Anastien/AWG1000/hardware/01-ECAD/02-Documentation/TSW3080EVM-BRD_E2/FAB_DATA/TTM_STACKUP_TSW3080.pdf

### Viasystems Technologies Corp. LLC

8150 Sheppard Ave E
Toronto, ON, M1B 5K2

Job Name : TI - 10 LAYER HYBRID Customer :
Part Num :
Part Rev :
Engineer : Steve Greefhorst

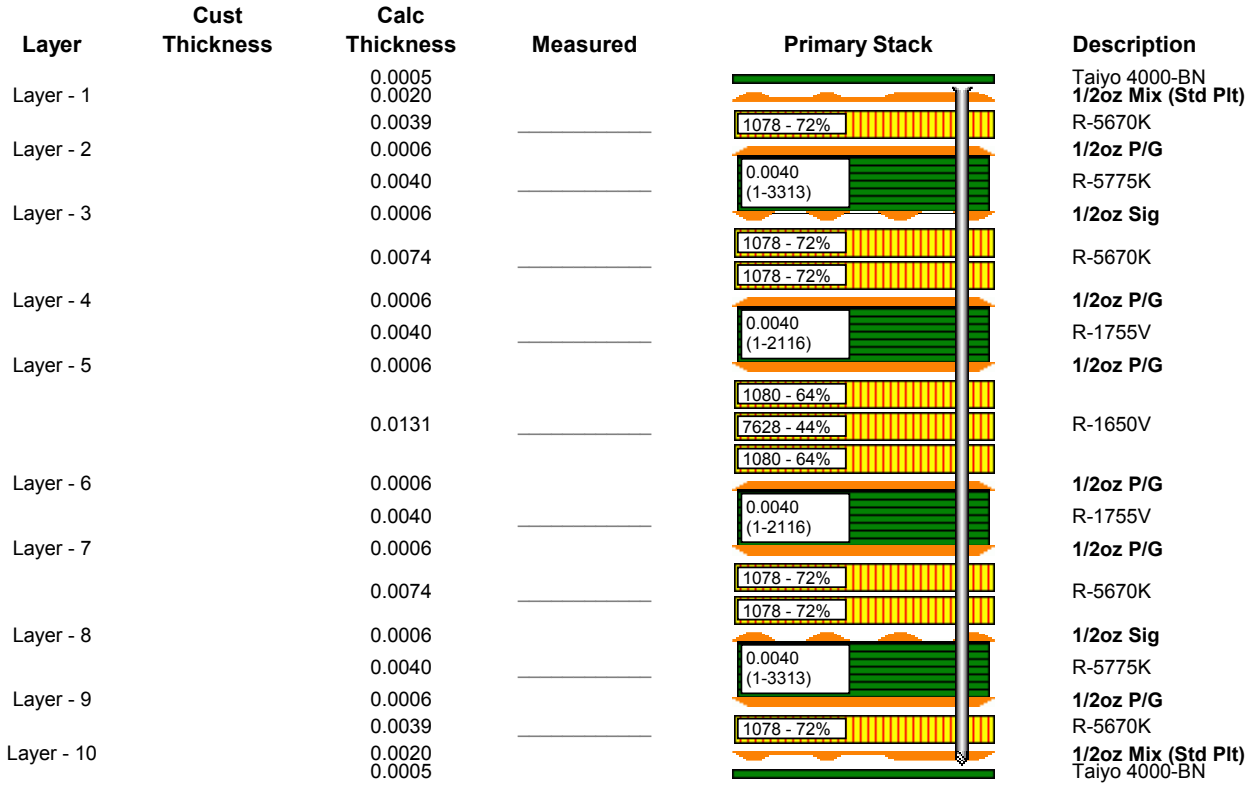
[picture p1: figure]
Layer; Cust Thickness; Calc; Thickness; Measured; Primary Stack; Description; 0.0005 Taiyo 4000-BN; Layer - 1; 1/2oz Mix (Std Plt); Layer - 2; Layer - 3; 1/2oz Sig; Layer - 4; Layer - 5; Layer - 6; Layer - 7; Layer - 8; Layer - 9; Layer - 10

Requirement | Req. Thickness | Tol + | Tol - | Calc Thick | Measured
Incl. Plating & Mask | 0.0620 | 0.0062 | 0.0062 | 0.0615
After Lamination | 0.0582 | 0.0029 | 0.0029 | 0.0577
Impedance Type | Layer | Actual | Plotted | Pitch | Plane | Target | Tol
(ohms) | Predict
1 | Surface MS | L1
- | -0.0045 | -0.00525 | -0.0100 | -
- | 0.0045 0.00425 | 0.00525 0.00475 | -0.0100 | L2
- | 0.00425 0.00425 | 0.00475 0.00475 | -0.0100 | L7
- | 0.00425 0.0070 | 0.00475 0.00775 | -- | L9

0.0070

0.00775

L2 | 50 | 5 | 50.88
2 | EC Microstrip | L1
L2 | 100 | 10 | 101.06
3 | EC Stripline | L3
L4 | 100 | 10 | 101.66
4 | EC Stripline | L8
L9 | 100 | 10 | 101.66
5 | Surface MS | L10

- | 50 | 5 | 50.88
© 2011 Viasystems, All rights reserved. This document is to be used for reference purposes only. | Viastack v3.1.29
Viastack Stackup Report for TI - 10 LAYER HYBRID | 1/25/2016 | Page 1

### Viasystems Technologies Corp. LLC

8150 Sheppard Ave E
Toronto, ON, M1B 5K2
Impedance Type | Layer | Actual | Plotted | Pitch | Plane | Target | Tol
(ohms) | Predict
6 | EC Microstrip | L10
| - | 0.0045
| | 0.0045 | 0.00525
| | | 0.00525 | 0.0100 - | L9 -
100 | 10 | 101.06
© 2011 Viasystems, All rights reserved. This document is to be used for reference purposes only. | Viastack v3.1.29
Viastack Stackup Report for TI - 10 LAYER HYBRID | 1/25/2016 | Page 2
