Anastien/AWG1000/hardware/01-ECAD/02-Documentation/iMX6SLEVK_DESIGNFILES/Schematics/SCH-27452_B.png

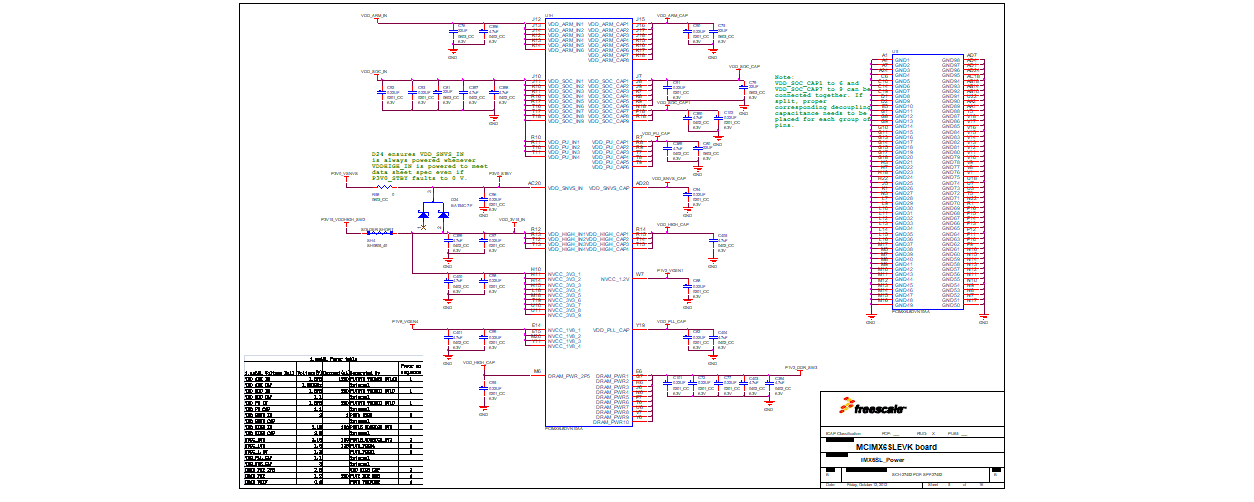
hardware/01-ECAD/02-Documentation/iMX6SLEVK_DESIGNFILES/Schematics/SCH-27452_B.png
