Anastien/AWG1000/hardware/02-MCAD/H524c303f43ab4b6ba670419b455ce2d2E.png

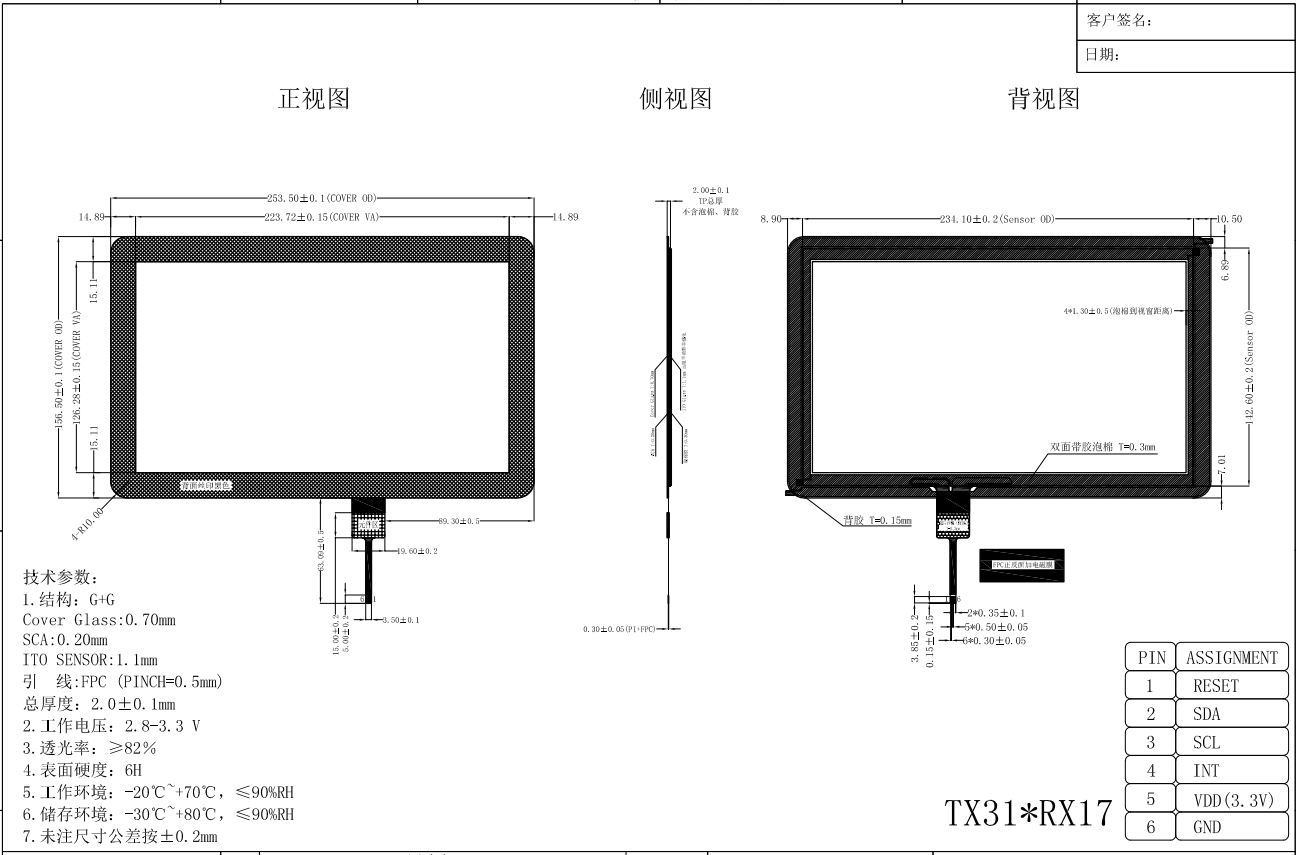
hardware/02-MCAD/H524c303f43ab4b6ba670419b455ce2d2E.png
