Anastien/AWG1000/hardware/02-MCAD/Ua01a15abc3a542eea8cf08465b4b8ba7l.jpg

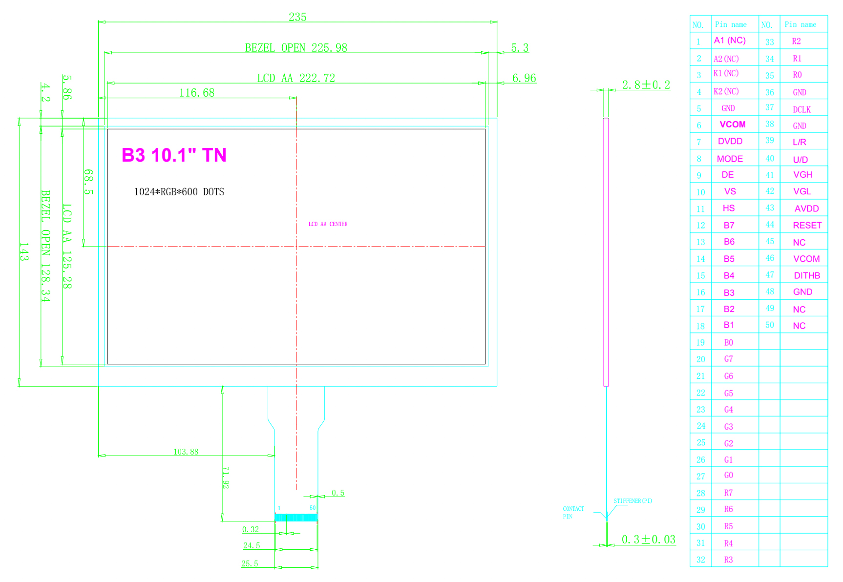
hardware/02-MCAD/Ua01a15abc3a542eea8cf08465b4b8ba7l.jpg
