Anastien/AWG1000/hardware/01-ECAD/02-Documentation/data gen/TSW1406_B_BOM.xls

 |  | TSW1406 RevB BOM |  |  |  | COMPONENTS AND ASSEMBLY SHALL BE RoHS COMPLIANT | DNI = DO NOT INSTALL
Item | Qty | Part Reference | Value | PCB Footprint | Mfr_Name | Mfr_Part_Number | Note
1 | 5 | C1,C10,C18,C48,C49 | 10uF | 0603 | Panasonic | ECJ-1VB0J106M
2 | 22 | C2,C3,C4,C5,C6,C7,C8,C9,C11,C12,C13,C14,C19,C20,C21,C22,C23,C24,C25,C26,C27,C28 | 0.1uF | 0201 | Murata | GRM033R60J104KE19D
3 | 2 | C15,C16 | .22uF | 0201 | TDK | C0603X5R0J224M
4 | 1 | C17 | 2.2uF | 0402 | TDK | C1005X5R0J225M
5 | 2 | C29,C37 | 1uF | 0603 | Panasonic | ECJ-1V41E105M
6 | 2 | C30,C51 | 27pF | 0402 | Yageo | CC0402JRNP09BN270
7 | 2 | C31,C43 | 100uF | 1206 | Kemet | C1206C107M9PACTU
8 | 2 | C32,C47 | .01uF | 0402 | Yageo | CC0402KRX7R9BB103
9 | 2 | C33,C35 | 4.7uF | 0603 | Kemet | C0603C475K8PACTU
10 | 9 | C34,C42,C50,C52,C53,C54,C55,C56,C57 | 0.1uF | 0402 | Yageo | CC0402KRX5R7BB104
11 | 1 | C36 | 10uF | 0805 | Murata | GRM21BR71A106KE51L
12 | 1 | C38 | .1uF | 0402 | Panasonic | ECJ-0EB1C104K
13 | 1 | C39 | 10nF | 0402 | TDK | C1005X7R1E103K
14 | 2 | C40,C44 | 22uF | 1206 | Murata | GRM31CR60J226KE19L
15 | 1 | C41 | 33pF | 0402 | Murata | GRM1555C1H330JZ01D
16 | 0 | C45,C46 | 22pF | 0402 | AVX | 04025A220KAT2A_DNI | DNI
17 | 1 | C58 | 4.7uF | TANT_A | AVX | TAJA475K006RNJ
18 | 2 | C59,C64 | 10uF | 1206 | Murata | GRM31CR61E106KA12L
19 | 1 | C60 | 1uF | 0603 | Murata | GRM188R71E105KA12D
20 | 1 | C61 | 22pF | 0402 | Murata | GRM1555C1H220JZ01D
21 | 1 | C62 | 68uF | 2312 | Kemet | T494C686K016AT
22 | 1 | C63 | 47uF | TANT_B | AVX | TACT476M010XTA | OR EQUIVALENT
23 | 1 | C65 | .1uF | 0402 | Murata | GRM155R71C104KA88D
24 | 2 | D1,D2 | GREEN | diode_0805 | Kingbright Corp | APHCM2012ZGC-F01
25 | 1 | FB1 | 68 ohm @ 100MHz | 0402 | Taiyo Yuden | BKP1005HS680-T
26 | 5 | FB2,FB4,FB6,FB7,FB10 | 68 OHM @ 100MHz | 1206 | Panasonic | EXC-ML32A680U
27 | 2 | FB3,FB5 | 27uF | 1206_BEAD_NFM31P | Murata | NFM31PC276B0J3
28 | 1 | FB9 | 1K @ 100MHZ | 0603 | Taiyo Yuden | BLM21AG102SN1D
29 | 1 | J1 | HMTSW-106-07-G-S-.240 | HDR_THVT_1x6_100_M | SAMTEC | HMTSW-106-07-G-S-.240
30 | 1 | J2 | USB_MINI_AB_MNE20-5G5P10 | CON_SMRT_USBMNE20_F | ACON | MNE20-5G5P10
31 | 0 | J14,J15,J16,J17 | HEADER 2POS | JUMPER2 | Molex | 22-28-4020_DNI | DNI
32 | 1 | J3 | QSH-090-01-L-D-A | CON_SMVT_180POS_QSH_SAMTEC_RT1 | SAMTEC | QSH-090-01-L-D-A
33 | 2 | L1,L2 | 2.2uH | LPS3015 | Coilcraft | LPS3015-222ML
34 | 2 | Q1,Q2 | DTC114EET1G | SOT_416_3_63x31 | ON Semiconductor | DTC114EET1G
36 | 2 | R1,R4 | 10K | 0402 | Panasonic | ERJ-2RKF1002X
37 | 2 | R2,R7 | 10 | 0402 | Yageo | RC0402FR-0710RL
38 | 5 | R3,R23,R25,R28,R29 | 10K | 0402 | Dale | CRCW040210K0FKED
39 | 1 | R5 | 12K | 0402 | Yageo | RC0402FR-0712KL
40 | 1 | R6 | 1K | 0402 | Yageo | RC0402FR-071KL
41 | 4 | R8,R9,R11,R45 | 10K | 0402 | Yageo | RC0402FR-0710KL
42 | 1 | R10 | 2.2K | 0402 | Yageo | RC0402FR-072K2L
43 | 1 | R13 | 10K | 0402 | Rohm Semiconductor | MCR01MZPF1002
44 | 1 | R18 | 820K | 0402 | Panasonic | ERJ-2RKF8203X
45 | 1 | R19 | 191K | 0402 | Vishay/Dale | CRCW0402191KFKED
46 | 1 | R20 | 180K | 0402 | Rohm Semiconductor | MCR01MZPF1803
47 | 1 | R21 | 182K | 0402 | Vishay/Dale | CRCW0402182KFKED
48 | 3 | R22,R26,R27 | 0 | 0201 | Panasonic | ERJ-1GE0R00C
49 | 1 | R24 | 10K | 0201 | Panasonic | ERJ-1GEF1002C
50 | 0 | R30,R31,R32,R33 | 10K | 0402 | Dale | CRCW040210K0FKED_DNI | DNI
51 | 8 | R34,R35,R36,R37,R38,R39,R40,R41 | 0 | 0402 | Panasonic | ERJ-2GE0R00X
52 | 0 | R42 | 0 | 0603 | Panasonic | ERJ-3GEY0R00V_DNI | DNI
53 | 1 | R46 | 4.7K | 0402 | Panasonic | ERJ-2RKF4701X
54 | 8 | R47,R48,R52,R53,R56,R57,R60,R61 | 150 | 0201 | Panasonic | ERJ-1GEF1500C
55 | 4 | R49,R51,R55,R59 | 140 | 0201 | Panasonic | ERJ-1GEF1400C
56 | 0 | R50,R54,R58,R62 | 100 | 0402 | Panasonic | ERJ-2RKF1000X_DNI | DNI
57 | 2 | R63,R64 | 150 | 0402 | Panasonic | ERJ-2RKF1500X
58 | 2 | R65,R66 | 30.1K | 0603 | Panasonic | ERJ-3EKF3012V
59 | 2 | SW1,SW2 | PROGRAMN | SW_RESET_PTS635 | C&K Components | PTS635SL43LFS
60 | 1 | TP1 | Testloop_Black | testpoint_62dia | Keystone | 5011
61 | 1 | TP2 | Testloop_Red | testpoint_62dia | Keystone | 5010
62 | 1 | U1 | LFE3-35E-FN484CES | BGA_484_1mm | Lattice | LFE3-35E-FN484CES | TI Supplied
63 | 0 | U2 | M25P16-VMW6TG | SOIC_8_197x157_50 | Numonyx | M25P80-VMN6TP_DNI | DNI
64 | 1 | U3 | FT2232H | LQFP_64_402x402_20 | FTDI | FT2232H
65 | 1 | U4 | TPS62420 | SON_DRC_10 | Texas Instruments | TPS62420DRCR | TI Supplied
66 | 1 | U5 | TPS76933DBVT | SOT_5_118x67_57 | Texas Instruments | TPS76933DBVT | TI Supplied
67 | 1 | U6 | 93LC46B-I/SN | SOIC-8 | Microchip | 93LC46B-I/SN
68 | 1 | U7 | TPS78601 | TO_263_6_KTT | Texas Instruments | TPS78601KTTT | TI Supplied
69 | 1 | Y1 | 12MHz w/ 10pF | XTAL_4_SM_130x102 | Abracon | ABM8G-12.000MHZ-B4Y-T
70 | 2 | Z_STANDOFF SCREW1,Z_STANDOFF SCREW2 | SCREW MACHINE PHILLIPS 4-40X1/4 |  | B&F Fastener Supply | PMS 440 0025 PH | SCREW FOR STANDOFF
71 | 2 | Z_STANDOFF1,Z_STANDOFF2 | STANDOFF RND 4-40THR .875"L ALUM |  | Keystone Electronics | 1846 | STANDOFF
