Anastien/AWG1000/hardware/01-ECAD/02-Documentation/SABRE-AI_Quad_CPUcard/BOM_27142_D.xls

MCIMX6QAICPU1 Revised: Friday, February 08, 2013
SCH-27142 PDF: SPF-27142 Revision: D
Freescale Semiconductor
6501 William Cannon Drive West
Austin, TX 78735-8598
Bill Of Materials
Item | Quantity | Reference | Part | Supplier | Description | Part# | Tolerance
1 | 1 | C1 | 47uF | TDK | CAP CER 47uF 25V -20/+80% Y5V 2220 | C5750Y5V1E476ZB | -25
2 | 1 | C2 | 220uF | LELON ELECTRONICS CORP | CAP ALEL 220uF 25V 20% -- SMD | VE-221M1ETR-0810 | 20%
3 | 41 | C3,C4,C12,C32,C34,C37,C49,C54,C62,C64,C65,C70,C74,C77,C86,C87,C513,C516,C519,C542,C546,C547,C548,C551,C556,C559,C620,C640,C641,C652,C653,C654,C655,C658,C669,C670,C671,C691,C692,C706,C759 | 22UF | Samsung | CAP CER 22UF 6.3V 20% X5R 0603 | CL10A226MQ8NRNE | 20%
4 | 112 | C5,C6,C20,C28,C51,C52,C53,C56,C72,C73,C76,C88,C111,C503,C505,C511,C514,C520,C538,C566,C579,C580,C581,C591,C592,C593,C594,C601,C603,C604,C605,C606,C608,C609,C611,C612,C613,C614,C615,C616,C617,C619,C621,C623,C626,C627,C628,C629,C630,C631,C633,C634,C635,C637,C638,C639,C642,C643,C644,C646,C647,C648,C649,C650,C651,C656,C657,C659,C661,C662,C663,C664,C665,C666,C667,C668,C672,C673,C674,C675,C676,C677,C678,C679,C681,C682,C683,C684,C685,C686,C687,C688,C689,C690,C695,C697,C698,C699,C700,C701,C702,C703,C704,C705,C707,C708,C709,C718,C721,C740,C744,C746 | 0.22UF | Taiyo Yuden | CAP CER 0.22UF 10V 20% X5R 0201 | LMK063BJ224MP-F | 20%
5 | 3 | C7,C508,C521 | 0.33UF | MULTICOMP | CAP CER 0.33UF 25V 10% X7R 0603 | MCCA001173 | 10%
6 | 6 | C8,C10,C11,C13,C31,C571 | 0.01uF | FENGHUA | CAP CER 0.01UF 25V 10% X7R 0402 | 0402B103K250NT | 10%
7 | 38 | C9,C18,C19,C27,C30,C33,C36,C38,C48,C501,C517,C518,C526,C527,C528,C533,C539,C540,C541,C549,C552,C553,C558,C561,C564,C569,C578,C590,C624,C632,C645,C660,C720,C745,C748,C754,C755,C760 | 4.7uF | TAIYO YUDEN | CAP CER 4.7UF 10V 10% X5R 0603 | LMK107BJ475KA-T | 10%
8 | 56 | C14,C15,C16,C22,C90,C91,C94,C95,C96,C97,C99,C103,C104,C105,C106,C107,C108,C109,C113,C114,C509,C524,C525,C531,C534,C536,C537,C544,C545,C550,C554,C555,C557,C562,C565,C567,C570,C572,C574,C575,C599,C625,C722,C725,C726,C729,C731,C732,C733,C734,C735,C736,C738,C741,C742,C756 | 0.1UF | KEMET | CAP CER 0.1UF 16V 10% X7R 0402 | C0402C104K4RAC | 10%
9 | 6 | C17,C560,C607,C610,C730,C753 | 1000pf | AVX | CAP CER 1000PF 2KV 10% X7R 1210 | 1210GC102KAT1A | 10%
10 | 1 | C21 | 0.47uF | TDK | CAP CER 0.47uF 6.3V 20% X5R 0201 | C0603X5R0J474M030BC | 20%
11 | 24 | C23,C24,C29,C35,C40,C50,C55,C57,C60,C78,C92,C112,C500,C504,C507,C510,C512,C563,C576,C577,C583,C696,C710,C737 | 10uF | TAIYO YUDEN | CAP CER 10UF 10V 20% X5R 0603 | LMK107BJ106MALTD
12 | 8 | C25,C535,C568,C573,C582,C719,C727,C743 | 1.0UF | YAGEO AMERICA | CAP CER 1.0UF 10V 10% X5R 0402 | CC0402KRX5R6BB105
13 | 1 | C26 | 47uF | TAIYO YUDEN | CAP CER 47uF 10V 20% X5R 1206 | LMK316BJ476ML-T | 20%
14 | 44 | C39,C41,C42,C43,C44,C45,C46,C47,C59,C61,C63,C66,C67,C68,C69,C71,C75,C79,C80,C81,C82,C83,C84,C85,C584,C585,C586,C587,C588,C589,C595,C602,C618,C622,C636,C693,C694,C711,C712,C713,C714,C715,C716,C717 | 0.22UF | TAIYO YUDEN | CAP CER 0.22UF 16V 10% X5R 0402 | EMK105BJ224KV-F | 10%
15 | 1 | C58 | 2.2UF | SMEC | CAP CER 2.2UF 10V 5% X7R 0603 | MCCB225J1NRTF | 5%
16 | 4 | C89,C93,C98,C100 | 1.0 UF | AVX | CAP CER 1.0UF 16V 10% X7R 0603 | 0603YC105KAT2A | 10%
17 | 3 | C101,C102,C739 | 470PF | MURATA | CAP CER 470PF 50V 10% X7R 0402 | GRM155R71H471KA01D | 10%
18 | 1 | C502 | 1uF | CAPAX TECHNOLOGIES INC. | CAP CER 1UF 25V 10% X7R 0603 | 0603X105K250SNT | 10%
19 | 3 | C515,C522,C523 | 10UF | MURATA | CAP CER 10UF 25V 10% B 1206 | GRM31CB31E106KA75B | 10%
20 | 4 | C529,C532,C596,C597 | 18pF | Yageo | CAP CER 18pF 25V 5% C0G 0402 | CC0402JRNPO8BN180 | 5%
21 | 2 | C530,C543 | 680pF | TAIYO YUDEN | CAP CER 680PF 50V 10% X5R 0402 | UMK105BJ681KV-F | 10%
22 | 2 | C598,C600 | 16PF | AVX | CAP CER 16PF 50V 5% C0G 0603 | 06035A160JAT2A | 5%
23 | 1 | C680 | 27pF | Yageo | CAP CER 27PF 25V 5% C0G 0402 | CC0402JRNPO8BN270 | 5%
24 | 2 | C723,C724 | 22PF | AVX | CAP CER 22PF 50V 5% C0G 0402 | 04025A220JAT2A | 5%
25 | 1 | C728 | 10UF | TDK | CAP CER 10UF 6.3V 10% X5R 0603 | C1608X5R0J106KT | 10%
26 | 3 | C747,C757,C758 | 22uF | TDK | CAP CER 22uF 16V 20% X7R 1210 | C3225X7R1C226M | 20%
27 | 5 | D1,D500,D502,D503,D504 | RB521CS-30 | ROHM | DIODE SCH SS 100MA 30V VMN2 | RB521CS-30T2R
28 | 4 | D2,D3,D10,D12 | MBRA340T3G | ON SEMICONDUCTOR | DIODE SCH PWR RECT 3A 40V SMA | MBRA340T3G
29 | 4 | D4,D7,D13,D14 | LED_GREEN | LITE ON | LED ULTRA-BRIGHT GREEN SMT 0603 | LTST-C190KGKT
30 | 1 | D5 | LED_YELLOW | LITE ON | LED ULTRA-BRIGHT YELLOW 30MA 5V SMT 0603 | LTST-C190KSKT
31 | 1 | D6 | RED | LITE ON | LED ULTRA BRIGHT RED SGL 30MA 0603 | LTST-C190KRKT
32 | 1 | D8 | MMSZ5231BT1G | ON SEMICONDUCTOR | DIODE ZNR 5.1V 0.5W SOD123 | MMSZ5231BT1G
33 | 1 | D9 | BLUE | LITE ON | LED BLUE -- 20MA SMT | LTST-C190TBKT
34 | 5 | D11,D18,D19,D20,D501 | MBR140SFT | ON SEMICONDUCTOR | DIODE SCH PWR RECT 1A 40V SOD123 | MBR140SFT1G
35 | 1 | D15 | 1SMB24AT3G | ON SEMICONDUCTOR | DIODE TVS ZNR -- 600W 24V SMD | 1SMB24AT3G
36 | 1 | D16 | BAT54HT1 | ON SEMICONDUCTOR | DIODE SCH 30V 200MA -- SOD323 | BAT54HT1G
37 | 1 | D17 | NSR0320 | ON Semiconductor | DIODE SCH PWR RECT LOW VF 1A 20V SOD323 | NSR0320MW2T1G
38 | 1 | D21 | LED_ORANGE | KINGBRIGHT | LED SUPER BRIGHT ORANGE SMD 0603 | AP1608SEC
39 | 1 | J1 | HDR 1X2 | FRAMATOME CONNECTORS INTERNATIONAL | HDR 1X2 TH 100MIL SP 330H SN 120L | 69190-402HLF
40 | 1 | J2 | HDR_2X3 | Samtec | HDR 2X3 TH 100MIL CTR 330H SN 115L | TSW-103-23-T-D
41 | 3 | J3,J4,J5 | HDR_1X3 | SAMTEC | HDR 1X3 TH 2MM SP 295H AU 102L | MTMM-103-06-G-S-236
42 | 1 | J6 | CON 7 SATA | 3M | CON 1X7 PLUG SATA TH 50MIL SP 335H -- 96L | 5607-5102-SH
43 | 1 | J7 | QSH-030-01-L-D-A-K-TR | SAMTEC | CON 2X30 SKT SMT 0.5MM SP 120H AU MOUNTING HOLES TO MATE CABLE HQCD-030-15.00-TBL-TBR-1-SDB | QSH-030-01-L-D-A_
44 | 1 | J8 | CONN PWR 1 | CUI STACK | CON 1 PWR PLUG DIAM 2.0MM RA TH HIGH CURRENT-- 430H NI 140L | PJ-202AH
45 | 1 | J9 | HDMI TYPE A 19 | Molex | CON 19 HDMI SKT SMT 0.5MM SP 343H AU | 47659-1000
46 | 1 | J10 | USB AB 5 | Hirose | CON 5 USB MICRO-AB RA SKT SMT 0.65MM SP AU | ZX62D-AB-5P8
47 | 1 | J11 | USB_TYPE_A_FEMALE | SAMTEC | CON 4 SKT RA TH USB A FEMALE | USB-A-S-S-B-TH
48 | 1 | J12 | QSH-020-01-L-D-DP-A | SAMTEC | CON 2X20 SKT SMT 0.5MM SP 131H AU | QSH-020-01-L-D-DP-A
49 | 1 | J13 | CON 30 | HIROSE | CON 30 SHRD SKT RA SMT 1MM SP AU | DF19G-30P-1H(56)
50 | 1 | J14 | CONN CRD 19 | PROCONN TECHNOLOGY CO., LTD | CON 19 CRD SKT SMT -- 150H AU | SDC013-A0-501F
51 | 1 | J15 | V890-1AX1-A1 | BEL FUSE | CON 10 RJ-45 SHLD TH G/Y LEDS 50MIL SP 662H AU 125L | V890-1AX1-A1
52 | 1 | J16 | CON_1X40 | OMRON | CON 40 FPC SMT RA 0.5MM SP 122H AU | XF2M-4015-1A
53 | 1 | J17 | 20021121-00010C4LF | FCI | CON 2X5 UNSTROUDED SMT 50MIL SP 227H AU | 20021121-00010C4LF
54 | 1 | J18 | DB9 | TYCO ELECTRONICS | CON 9 DB -- SKT TH 54MIL SP 479H AU | 5207826-4
55 | 1 | J19 | CON 2X26 MINI PCI EXPRESS | Molex | CON 2X26 MINI PCI EXPRESS SMT 0.8MM SP 1136H | 679100002
56 | 2 | L1,L2 | 1uH | BOURNS | IND PWR 1UH@100KHZ 5A 20% SMD | SRP4020-1R0M
57 | 4 | L3,L5,L6,L7 | 1uH | Coilcraft | IND PWR 1UH@100KHZ 2.65A 20% SMT | LPS5015-102MLC | 20%
58 | 1 | L4 | 1UH | TDK | IND PWR 1UH@1MHZ 2A 30% SMT | VLS252010T-1R0N | 30%
59 | 1 | L8 | 2.2uH | COILCRAFT | IND PWR 2.2uH@100KHz 2.7A 20% SMT | LPS4018-222MLC | 20%
60 | 6 | L9,L10,L500,L501,L505,L506 | 120OHM | MURATA | IND FER BEAD 120OHM@100MHZ 2A 25% 0603 | BLM18PG121SH1 | 25%
61 | 1 | L502 | 330OHM | MURATA | IND FER BEAD 330 OHM@100MHZ 1.5A 25% 0805 | BLM21PG331SN1D | 25%
62 | 1 | L503 | 600 Ohm | Murata | IND FER BEAD 600 OHM@100MHZ 0.3A 25% 0402 | BLM15HG601SN1D | 25%
63 | 1 | L504 | 4.7UH | TDK | IND PWR 4.7UH@1MHZ 1A 20% SMD | VLS3012T-4R7M1R0 | 20%
64 | 1 | P1 | EDGE 281 | NA | CON 281 EDGE 0.5MM SP 5H AU - NO PARTS TO ORDER | NO PARTS TO ORDER
65 | 1 | Q1 | MBT3906DW1T1 | ON SEMICONDUCTOR | TRAN PNP GEN DUAL 200MA 40V SOT363 | MBT3906DW1T1G
66 | 5 | Q2,Q501,Q503,Q504,Q508 | NTS4001NT1G | ON SEMICONDUCTOR | TRAN NMOS SW 30V 270MA SC-70 | NTS4001NT1G
67 | 2 | Q502,Q505 | FDMS6681Z | FAIRCHILD | TRAN PMOS PWR 49A 30V POWER56 | FDMS6681Z
68 | 1 | Q506 | FDC642P | FAIRCHILD | TRAN PMOS 20V 4A SSOT-6 | FDC642P
69 | 1 | Q507 | FDG6301N | FAIRCHILD | TRAN NFET DMOS DUAL 0.22A 25V SC70-6 | FDG6301N
70 | 4 | RN500,RN501,RN502,RN503 | 10K | ROHM | RNET BUS 8 10K 1/32W 5% SMT | MNR15E0RPJ103 | 5%
71 | 1 | R1 | 59K | KOA SPEER | RES MF 59K 1/16W 1% 0402 | RK73H1ETTP5902F | 1%
72 | 38 | R2,R15,R30,R69,R75,R76,R77,R79,R80,R82,R85,R86,R88,R90,R559,R560,R561,R570,R577,R578,R580,R602,R651,R656,R678,R705,R710,R714,R716,R717,R718,R720,R722,R723,R726,R757,R763,R797 | 68K | KOA SPEER | RES MF 68K 1/16W 1% 0402 | RK73H1ETTP6802F | 1%
73 | 162 | R3,R4,R5,R10,R11,R17,R18,R20,R22,R25,R29,R32,R33,R35,R36,R38,R39,R40,R41,R43,R48,R49,R50,R51,R63,R64,R67,R70,R72,R73,R81,R84,R98,R101,R102,R105,R106,R500,R501,R504,R506,R510,R511,R512,R513,R514,R515,R520,R521,R522,R523,R524,R525,R526,R527,R528,R529,R539,R540,R541,R542,R543,R544,R545,R546,R550,R574,R575,R576,R581,R582,R583,R584,R585,R587,R588,R589,R590,R591,R592,R593,R595,R598,R599,R600,R603,R604,R605,R606,R607,R610,R613,R614,R617,R621,R626,R627,R628,R631,R633,R635,R636,R637,R639,R640,R643,R644,R645,R647,R648,R649,R650,R653,R654,R657,R658,R659,R660,R664,R668,R672,R674,R676,R680,R684,R688,R689,R693,R696,R698,R700,R703,R704,R709,R711,R713,R715,R724,R727,R728,R729,R730,R731,R738,R740,R749,R750,R753,R754,R755,R758,R760,R765,R772,R773,R775,R776,R777,R780,R785,R794,R795 | 0 | Panasonic | RES MF ZERO OHM 1/10W -- 0402 | ERJ-2GE0R00X
74 | 51 | R6,R31,R83,R87,R92,R93,R94,R95,R96,R97,R502,R509,R516,R519,R534,R551,R554,R558,R615,R616,R619,R625,R642,R655,R675,R677,R681,R695,R701,R702,R708,R712,R719,R721,R733,R739,R741,R742,R743,R744,R745,R746,R747,R748,R752,R762,R766,R767,R770,R779,R791 | 10.0K | VISHAY INTERTECHNOLOGY | RES MF 10.0K 1/16W 1% 0402 | CRCW040210K0FKED | 1%
75 | 5 | R7,R8,R13,R26,R566 | 100K | KOA SPEER | RES MF 100K 1/16W 1% 0402 | RK73H1ETTP1003F | 1%
76 | 3 | R9,R34,R91 | 1.6K | KOA SPEER | RES MF 1.6K 1/16W 1% 0402 | RK73H1ETTP1601F | 1%
77 | 2 | R12,R556 | 324K | KOA SPEER | RES MF 324K 1/16W 1% 0402 | RK73H1ETTP3243F | 1%
78 | 48 | R14,R19,R23,R24,R42,R52,R53,R54,R55,R57,R58,R60,R61,R62,R65,R66,R68,R71,R74,R78,R572,R638,R652,R661,R662,R663,R666,R667,R669,R670,R673,R679,R682,R683,R685,R686,R687,R690,R691,R692,R694,R699,R707,R725,R736,R737,R769,R774 | 4.7K | KOA SPEER | RES MF 4.70K 1/16W 1% 0402 | RK73H1ETTP4701F | 1%
79 | 3 | R16,R537,R538 | 15K | KOA SPEER | RES MF 15K 1/16W 1% 0402 | RK73H1ETTP1502F | 1%
80 | 14 | R21,R507,R573,R579,R597,R629,R630,R632,R634,R641,R646,R732,R768,R778 | 100 | THYE MING TECH CO LTD | RES MF 100 OHM 1/16W 1% 0402 | CR-02FL6--100R | 1%
81 | 2 | R27,R28 | 0 | KOA SPEER | RES MF ZERO OHM 1/32W -- 0201 | RK73Z1HTTC | 5%
82 | 3 | R37,R56,R618 | 200 | THYE MING TECH CO LTD | RES MF 200 OHM 1/16W 1% 0402 | CR02FL6--200R | 1%
83 | 5 | R44,R45,R46,R59,R609 | 240 | KOA SPEER | RES MF 240 OHM 1/16W 1% 0402 | RK73H1ETTP2400F | 1%
84 | 1 | R47 | 191 | KOA SPEER | RES MF 191.0 OHM 1/10W 1% 0603 | RK73H1JTTD1910F | 1%
85 | 1 | R89 | 2.37K | KOA SPEER | RES MF 2.37K 1/16W 1% 0402 | RK73H1ETTP2371F | 1%
86 | 5 | R99,R100,R697,R734,R735 | 33 | THYE MING TECH CO LTD | RES MF 33.0 OHM 1/16W 1% 0402 | CR-02FL6---33R | 1%
87 | 2 | R104,R503 | 150K | SMEC | RES MF 150K 1/16W 5% 0402 | RC73L2Z154JTF | 5%
88 | 1 | R505 | 91K | KOA SPEER | RES MF 91K 1/16W 1% 0402 | RK73H1ETTP9102F | 1%
89 | 9 | R508,R535,R586,R594,R596,R665,R706,R771,R796 | 47K | VENKEL COMPANY | RES MF 47K 1/16W 5% 0402 | CR0402-16W-473JT | 5%
90 | 2 | R517,R549 | 120 | KOA SPEER | RES MF 120 OHM 1/10W 5% 0603 | RK73B1JTTD121J | 5%
91 | 1 | R530 | 15.4K | KOA SPEER | RES MF 15.4K 1/16W 1% 0402 | RK73H1ETTP1542F | 1%
92 | 6 | R531,R552,R567,R568,R612,R793 | 820 | PANASONIC | RES MF 820 OHM 1/10W 5% 0402 | ERJ2GEJ821X | 5%
93 | 1 | R533 | 28K | KOA SPEER | RES MF 28K 1/16W 1% 0402 | RK73H1ETTP2802F | 1%
94 | 4 | R536,R547,R751,R759 | 270 | VISHAY INTERTECHNOLOGY | RES MF 270 OHM 1/16W 5% 0402 | CRCW0402270RJNED | 5%
95 | 1 | R548 | 470K | KOA SPEER | RES MF 470K 1/16W 1% 0402 | RK73H1ETTP4703F | 1%
96 | 1 | R553 | 2.7K | ROHM | RES MF 2.7K 1/4W 5% 0805 | ESR10EZPJ272 | 5%
97 | 3 | R555,R557,R790 | 510 | BOURNS | RES MF 510 OHM 1/10W 5% 0603 | CR0603-JW-511ELF | 5%
98 | 2 | R562,R564 | 39.2K | KOA SPEER | RES MF 39.2K 1/16W 1% 0402 | RK73H1ETTP3922F | 1%
99 | 2 | R563,R569 | 42.2K | KOA SPEER | RES MF 42.2K 1/16W 1% 0402 | RK73H1ETTP4222F | 1%
100 | 1 | R571 | 27K | VISHAY INTERTECHNOLOGY | RES MF 27K 1/16W 5% 0402 | CRCW040227K0JNED | 5%
101 | 1 | R601 | 82.5K | KOA SPEER | RES MF 82.5K 1/16W 1% 0402 | RK73H1ETTP8252F | 1%
102 | 1 | R608 | 0 | MULTICOMP | RES MF ZERO OHM 1/10W 1% 0603 | MC0603SAF0000T5E | 1%
103 | 2 | R611,R620 | 6.04K | KOA SPEER | RES MF 6.04K 1/16W 1% 0402 | RK73H1ETTP6041F | 1%
104 | 1 | R622 | 10M | KOA SPEER | RES MF 10M 1/16W 1% 0402 | RK73H1ETTP1005F | 1%
105 | 2 | R761,R764 | 49.9 | KOA SPEER | RES MF 49.9 OHM 1/16W 1% 0402 | RK73H1ETTP49R9F | 1%
106 | 4 | R781,R782,R783,R784 | 130 | KOA SPEER | RES MF 130 OHM 1/10W 1% 0603 | RK73H1JTTD1300F | 1%
107 | 1 | R788 | 2.2M | KOA SPEER | RES MF 2.2M 1/16W 1% 0402 | RK73H1ETTP2204F | 1%
108 | 3 | SH2,SH11,SH506 | 0 | LAYOUT ELEMENT ONLY | ZERO OHM CUT TRACE 0603 PADS; NO PART TO ORDER | LAYOUT ELEMENT ONLY
109 | 2 | SH3,SH507 | 0 | LAYOUT ELEMENT ONLY | ZERO OHM CUT TRACE 0402 PADS; NO PART TO ORDER | LAYOUT ELEMENT ONLY
110 | 10 | SH4,SH9,SH10,SH500,SH501,SH502,SH503,SH504,SH505,SH510 | SOLDER SHORT | NOTACOMPONENT | SOLDER SHORT 0805 SMT NO PART TO ORDER | SOLDER_SHORT_0805
111 | 6 | SH5,SH6,SH7,SH8,SH508,SH509 | 0 | LAYOUT ELEMENT ONLY | ZERO OHM CUT TRACE 0201 PADS; NO PART TO ORDER | LAYOUT ELEMENT ONLY
112 | 2 | SW1,SW2 | SKRPABE010 | ALPS ELECTRIC (USA) INC. | SW SPST PB SMT 16V 20MA | SKRPABE010
113 | 1 | S1 | SW_DIP-10/SM | CTS | SW SPST DIP 10POS 100MA 50V SMT | 218-10LPST
114 | 2 | S2,S3 | SW DIP-4 | TYCO ELECTRONICS | SW SPST DIP 4P 0.050" SP SMT | 1571983-4
115 | 2 | TP_GND1,TP_GND2 | TESTLOOP_BLACK | KEYSTONE ELECTRONICS | TEST POINT PC MULTI PURPOSE BLK TH | 5011
116 | 39 | TP1,TP3,TP4,TP5,TP6,TP7,TP8,TP9,TP10,TP11,TP12,TP13,TP14,TP15,TP16,TP17,TP18,TP19,TP20,TP21,TP22,TP23,TP24,TP25,TP26,TP27,TP28,TP29,TP30,TP31,TP32,TP33,TP34,TP35,TP36,T76,TP500,TP501,TP502 | TPAD_020 |  | TEST POINT PAD 0.5MM DIA SMT, NO PART TO ORDER
117 | 2 | TP37,TP38 | TEST POINT | NA | TEST POINT PAD 35 MIL SMT, NO PART TO ORDER | NA
118 | 1 | TVS500 | ESD9B5.0ST5G | On semiconductor | DIODE TVS LOW CAP 5.0V SOD-923 | ESD9B5.0ST5G
119 | 75 | T1,T2,T3,T4,T5,T6,T7,T8,T9,T10,T11,T12,T13,T14,T15,T16,T17,T18,T19,T20,T21,T22,T23,T24,T25,T26,T27,T28,T29,T30,T31,T32,T33,T34,T35,T36,T37,T38,T39,T40,T41,T42,T43,T44,T45,T46,T47,T48,T49,T50,T51,T52,T53,T54,T55,T56,T57,T58,T59,T60,T61,T62,T63,T64,T65,T66,T67,T68,T69,T70,T71,T72,T73,T74,T75 | TPAD_015 | NOTACOMPONENT | TEST POINT PAD 15MIL DIA SMT, NO PART TO ORDER | NOTACOMPONENT
120 | 1 | U1 | MCIMX6Q6AVT10AC | FREESCALE SEMICONDUCTOR | IC MCU MX6QUAD ARM CORTEX-A9 FCPBGA624 | MCIMX6Q6AVT10AC
121 | 4 | U2,U3,U4,U5 | MT41K256M16HA-125:E | MICRON | IC MEM DDR3 SDRAM 32M x 16BIT x 8 BANKS 1.25NS 1.35/1.5V FBGA96 | MT41K256M16HA-125:E
122 | 1 | U6 | NL17SZ125 | ON SEMICONDUCTOR | IC BUF TS 1.65-5.5V SOT353-5 | NL17SZ125DFT2G
123 | 1 | U7 | S9S08SG8E2MSC | Freescale Semiconductor | IC MCU 8BIT 8K FLASH 2.7-5.5V SOIC8 | S9S08SG8E2MSC
124 | 2 | U8,U9 | LT3680H | Linear Technology | IC VREG STEP DOWN SW 2.4MHZ ADJ 0.79-30V 3.5A 3.6-36V MSOP10 | LT3680HMSE#PBF
125 | 4 | U10,U17,U502,U509 | NLAS3158 | ON Semiconductor | IC LIN SW DUAL SPDT 1.65-5.5V DFN12 | NLAS3158MNR2G
126 | 1 | U11 | MMPF0100F0ZES | FREESCALE SEMICONDUCTOR | IC POWER MANAGEMENT AUTOMOTIVE 2.8-4.5V QFN56 | MMPF0100F0ZES
127 | 1 | U12 | PI90LV179 | PERICOM SEMICONDUCTOR | IC XCVR LVDS 3.3V SOIC8 | PI90LV179WE
128 | 3 | U13,U14,U15 | MAX7310 | MAXIM | IC I/O EXPANDER 8BIT I2C 2.3-5.5V TSSOP16 | MAX7310AUE+
129 | 1 | U16 | M25P32-VMW3TGB | NUMONYX | IC MEM SERIAL FLASH 32MBIT AUTOMOTIVE GRADE 2.7-3.6V SO8W | M25P32-VMW3TGB
130 | 1 | U18 | SP3232 | SIPEX | IC XCVR RS232 120KBPS 3.0-5.5V SSOP16 | SP3232ECA-L
131 | 1 | U19 | 980020-48-P2 | MERITEC | CON 48 TSOP SKT SMT 0.5MM SP AU | 980020-48-P2
132 | 4 | U20,U21,U22,U501 | NC7SP125P5X | FAIRCHILD | IC BUF TS 0.9-3.6V | NC7SP125P5X
133 | 1 | U500 | LT3012HFE | Linear Technology | IC VREG LDO LIN MICROPWR ADJ 1.24-60V 250mA 4-80V TSSOP16 | LT3012HFE#PBF
134 | 1 | U504 | CM2020 | ON SEMICONDUCTOR | IC XMTR HDMI ESD PROTECTION 5V TSSOP38 | CM2020-01TR
135 | 1 | U505 | LTC3025 | LINEAR TECHNOLOGY | IC VREG LOW LDO 300MA LOW VREF | LTC3025EDC#TRPBF
136 | 1 | U506 | MIC2005-0.5YM6 | MICREL | IC LIN SW PWR 0.5A 2.5-5.5V SOT23-6 | MIC2005-0.5YM6
137 | 1 | U507 | SRV05-4 | SEMTECH CORP | DIODE TVS ARRAY 12A 5V 300W SOT23_S6 | SRV05-4.TCT
138 | 1 | U508 | ADG849 | Analog Devices | IC SWITCH SPDT 2:1 MUX 1.8-5.5V SC70-6 | ADG849YKSZ-500RL7
139 | 1 | U510 | M29W256GL7AN6E | NUMONYX | IC MEM FLASH AUTOMOTIVE GRADE 256MBIT 70NS 2.7-3.6V TSOP56 | M29W256GL7AN6E
140 | 1 | U511 | AR8031 | Atheros Communications, Inc | IC XCVR ETHERNET PHY 10/100/1000G-BIT 3.3V QFN48 | AR8031-AL1A
141 | 1 | U512 | 74LCX125 | ON SEMICONDUCTOR | IC BUF 4 TS 2.3-3.6V TSSOP14 | MC74LCX125DTG
142 | 1 | U513 | STM6315RA | ST MICROELECTRONICS | IC MPU RESET CIRC 2.63V 1.5MS 1.0-5.5V SOT143-4 | STM6315RAW13F
143 | 1 | U515 | STM6315RDW13F | ST MICROELECTRONICS | IC MPU RESET CIRC 2.63V 1.0-5.5V SOT143-4 | STM6315RDW13F
144 | 2 | U516,U1514 | NC7SP126 | FAIRCHILD | IC BUF ULP TS 0.9-3.6V SC-70 | NC7SP126P5X
145 | 1 | Y1 | 24.576MHZ | Fox Electronics | OSC 24.576MHZ FIXED 3.3V SMT | FXO-HC536R-24.576
146 | 1 | Y2 | 32.768kHz | Micro Crystal | XTAL 32.768KHZ 12.5pF -- SMT | CM7V-T1A, 32.768KHz, 12.5pF, 20ppm, TA, QC
147 | 1 | Y3 | 24MHZ | EPSON TOYOCOM CORPORATION | XTAL 24MHZ 9pF -- SMT 3.2X2.5MM | TSX-3225 24.0000MF15X-AC3
148 | 1 | Y4 | 100MHZ | PERICOM SEMICONDUCTOR | OSC 100MHZ FIXED HCSL PCIE2 3.3V SMT | SHPCIE100
149 | 1 | Y500 | 25MHZ | ABRACON CORP | XTAL 25MHZ -- -- SMT | ABMM-25.000MHZ-B2-T
