Anastien/AWG1000/hardware/01-ECAD/02-Documentation/TSW14J56EVM-DesignPkg_E/TSW14J56-BOM_E1.xlsx

TSW14J56 BOM Revision: E1
Item | Quantity | Reference | Note | Part | Part Number | Manufacturer | Foot Print
1 | 2 | CN1,CN2 |  | 0.1uF | W2A4ZC104MAT2A | AVX | cnet4_0508
2 | 6 | C1,C5,C482,C483,C488,C499 |  | 0.1uF | GRM155R61C104KA88D | Murata | 402
3 | 1 | C4 |  | .01uF | GRM155R71E103KA01D | MURATA | 402
4 | 20 | C10,C11,C12,C13,C14,C15,C16,C17,C18,C19,C20,C21,C22,C23,C24,C25,C26,C372,C373,C374 |  | 2.2nF | GRM033R71A222KA01D | Murata | 201
5 | 4 | C27,C28,C369,C371 |  | 3.3nF | GRM033R71A332KA01D | Murata | 201
6 | 4 | C29,C30,C31,C370 |  | 4.7nF | GRM033R71A472KA01D | Murata | 201
7 | 8 | C32,C33,C34,C35,C36,C37,C38,C39 |  | 0.01uF | GRM033R71A103KA01J | Murata | 201
8 | 21 | C41,C42,C43,C44,C45,C46,C47,C48,C203,C204,C205,C206,C438,C440,C442,C443,C451,C453,C455,C458,C459 |  | 0.1uF | GRM033R61A104KE15D | Murata | 201
9 | 8 | C50,C51,C52,C53,C54,C55,C56,C57 |  | 0.47uF | CL03A474KQ3NNNC | Samsung Electro-Mechanics America, Inc | 201
10 | 1 | C58 |  | 10uF | GRM31CR61E106KA12L | MURATA | 1206
11 | 2 | C59,C66 |  | 100pF | 04025C101KAT2A | AVX CORP | 402
12 | 20 | C60,C61,C228,C230,C231,C234,C376,C391,C410,C411,C414,C415,C416,C417,C478,C479,C496,C497,C500,C501 |  | 0.1uF | GRM155R71C104KA88D | MURATA | 402
13 | 1 | C65 |  | .1uF | GRM155R61A104KA01D | MURATA | 402
14 | 1 | C69 |  | 2200pF | ECJ-0EB1E222K | Panasonic | 402
15 | 1 | C70 |  | 10pF | GRM1555C1H100JZ01D | MURATA | 402
16 | 0 | C73 | DNI | CAP_0402_10pF |  | Murata | 402
17 | 8 | C74,C75,C76,C77,C78,C79,C430,C431 |  | .1uF | GRM033R61A104KE15D | MURATA | 201
18 | 13 | C82,C83,C84,C85,C86,C87,C88,C112,C140,C165,C166,C361,C362 |  | 100uF | TCJB107M006R0045 | AVX Corp | 3528
19 | 48 | C94,C95,C96,C97,C98,C99,C100,C101,C102,C103,C104,C105,C106,C107,C108,C109,C110,C111,C113,C116,C117,C118,C119,C120,C121,C122,C123,C124,C125,C126,C127,C128,C129,C130,C131,C132,C137,C159,C167,C168,C177,C178,C189,C353,C356,C357,C365,C402 |  | 4.7uF | C1005X5R0J475K050BC | TDK | 402
20 | 15 | C114,C138,C157,C171,C172,C173,C179,C182,C183,C184,C185,C358,C359,C367,C404 |  | 0.1uF | C1005X7R1E104K050BB | TDK | 402
21 | 2 | C115,C139 |  | 22nF | GRM155R71E223KA61D | Murata | 402
22 | 3 | C158,C176,C188 |  | 220uF | T520B227M006ATE070 | Kemet | 3528
23 | 3 | C160,C180,C199 |  | 0.22uF | 160X14X224MV4T | Johanson Dielectrics Inc | C-0603_X2Y
24 | 3 | C161,C181,C200 |  | 0.1uF | 100X14W104MV4T | Johanson Dielectrics Inc | C-0603_X2Y
25 | 3 | C162,C300,C303 |  | 47nF | 160X14W473MV4T | Johanson Dielectrics Inc | C-0603_X2Y
26 | 3 | C163,C286,C301 |  | 22nF | 250X14W223MV4T | Johanson Dielectrics Inc | C-0603_X2Y
27 | 3 | C164,C287,C302 |  | 1uF | 100X14X105MV4T | Johanson Dielectrics Inc | C-0603_X2Y
28 | 5 | C169,C170,C363,C364,C366 |  | 0.22uF | CL05B224KP5NNNC | Samsung | 402
29 | 2 | C174,C175 |  | 22nF | CL05B223KP5NNNC | Samsung | 402
30 | 2 | C195,C351 |  | 47uF | C1210C476M4PACTU | Kemet | 1210
31 | 5 | C197,C468,C470,C472,C498 |  | 22uF | C3225X5R1A226M | TDK CORP | 1210
32 | 10 | C198,C384,C386,C423,C425,C463,C490,C491,C492,C493 |  | 1.0uF | C1608X7R1E105K | Yageo | 603
33 | 11 | C207,C208,C209,C437,C439,C445,C446,C447,C448,C449,C460 |  | .01uF | CC0201KRX7R7BB103 | Yageo | 201
34 | 2 | C210,C212 |  | 0.1uF | C1005X7R1E104K050BB | TDK | 201
35 | 2 | C229,C232 |  | 4.7uF | C1005X5R0J475K | TDK | 402
36 | 1 | C233 |  | 0.01uF | ECJ-0EB1E103K | Panasonic | 402
37 | 2 | C235,C281 |  | 1000pF | C1005X7R1H102K | TDK | 402
38 | 8 | C236,C273,C296,C390,C395,C419,C429,C477 |  | 10uF | GRM21BR61E106KA73L | MURATA | 805
39 | 7 | C250,C258,C276,C294,C400,C436,C476 |  | 22uF | GRM31CR71A226KE15L | Murata | 1206
40 | 1 | C277 |  | 4.7uF | C1608X5R1A475K/0.50 | TDK | 603
41 | 10 | C278,C279,C280,C283,C284,C375,C394,C469,C471,C473 |  | 10uF | GRM188R60J106ME47D | Murata | 603
42 | 3 | C282,C457,C489 |  | 0.1uF | GRM188R71C104KA01D | Murata | 603
43 | 3 | C298,C393,C467 |  | 33uF | T520B336M010ATE035 | Kemet | 3528
44 | 3 | C299,C392,C466 |  | 1uF | GRM188R60J105KA01D | Murata | 603
45 | 1 | C348 |  | .1uF | GRM188R71C104KA01 | Murata | 603
46 | 2 | C349,C350 | LOW ESR | 10uF | TAJT106K016RNJ | TDK | 3528
47 | 1 | C352 |  | 330uF | TPMD337K010R0035 | AVX | TANT_D
48 | 2 | C354,C355 |  | 22nF |  |  | 402
49 | 3 | C385,C424,C462 |  | 47uF | GRM32ER61A476KE20L | MURATA | 1210
50 | 7 | C387,C388,C418,C426,C427,C461,C464 |  | .1uF | GRM155R71C104KA88D | MURATA | 402
51 | 2 | C389,C428 |  | 0.01uF | GRM155R71H103KA88D | MURATA | 402
52 | 1 | C403 |  | 22nF | CL05B223KP5NNNC | Samsung | 402
53 | 8 | C432,C433,C434,C435,C484,C485,C486,C487 |  | 0.1uF | C0603X7S1A104K030BC | TDK | 201
54 | 3 | C450,C452,C454 |  | 2.2uF | LMK107B7225KA-T | Taiyo Yuden | 603
55 | 2 | C480,C481 |  | 12pF | GRM1555C1H120JA01D | MURATA | 402
56 | 1 | C494 |  | 4.7uF | C2012X7R1A475K085AC | TDK | 805
57 | 1 | C495 |  | 150uF | CL32A157MQVNNNE | sAMSUNG | 1210
58 | 9 | D1,D2,D3,D4,D5,D6,D7,D8,D17 |  | LED GREEN | LTST-C170KGKT | Liteon | LED_0805
59 | 1 | D10 |  | LED GREEN | LTST-C150KGKT | LITE ON | LED_1206
60 | 3 | D11,D13,D16 |  | LED BLUE | LB L293-M2P1-36-1-Z | OSRAM Opto Semiconductors Inc | LED_0603
61 | 1 | D12 |  | MBRB2515L | MBRB2515LT4G | ON Semiconductor | DIODE_MBRB2515L
62 | 7 | D21,D23,D25,D26,D27,D30,D34 |  | LED BLUE | LB L293-M2P1-36-1-Z | Lumex Opto/Components Inc | LED_0603
63 | 1 | D28 |  | GREEN | LTST-C170KGKT | Liteon | LED_0805
64 | 1 | D32 |  | LED RED | LTST-C170KRKT | Lite-On | LED_0805
65 | 1 | D33 |  | LED BLUE USB_1.2V | LB L293-M2P1-36-1-Z | Lumex Opto/Components Inc | LED_0603
66 | 1 | FB2 |  | 120 OHM @ 100MHz | BLM31PG121SN1L | MURATA | 1206
67 | 2 | FB5,FB6 |  | 220 OHMS @ 100MHz | BLM18KG221SN1D | Murata | 603
68 | 2 | FB9,FB16 |  | 60 OHM @ 100MHz | BLM41PG600SN1L | Murata | 1806
69 | 5 | FB21,FB22,FB23,FB24,FB25 |  | 60 OHM @ 100MHz | FBMJ3216HM600-T | Taiyo Yuden | 1206
70 | 3 | FB26,FB27,FB28 |  | 220 OHM @ 100MHz | BLM21PG221SN1D | Murata | 805
71 | 0 | F1 | DNI | FUSE 4.0A 32V FAST | 1206SFF400F/32-2 | TE Connectivity | 1206
72 | 0 | F2 | DNI | FUSE 2.0A 63V FAST | 1206SFF200F/63-2 | TE Connectivity | 1206
73 | 7 | JP4,JP5,JP6,JP7,JP10,JP16,JP17 | (SHUNT 2-3) | HEADER_1x3_100_430L | HMTSW-103-07-G-S-.240 | Samtec | HDR_THVT_1x3_100_M
74 | 3 | JP11,JP12,JP13 | (SHUNT 1-2) | HEADER_1x3_100_430L | HMTSW-103-07-G-S-.240 | Samtec | HDR_THVT_1x3_100_M
75 | 2 | JP14,JP15 |  | HEADER_1x2_100_430L | HMTSW-102-07-G-S-.240 | SAMTEC | HDR_THVT_1x2_100_M
76 | 1 | J1 |  | 22-11-2032 | 22-11-2032 | Molex | HDR_THVT_1x3_100_M_KEYED
77 | 1 | J2 |  | HDR 2X10 | N2520-6002-RB | 3M | CON_THVT_2x10_100_M
78 | 9 | J3,J5,J6,J7,J8,J12,J13,J14,J15 |  | SMA_THVT_REC | 142-0701-201 | Johnson Components | SMA_THVT_312x312
79 | 1 | J4 |  | CON_40X10_VITA57_F | SEAF-40-05.0-S-10-2-A-K-TR | SAMTEC | con_40x10_asp_134486_01_f_via
80 | 1 | J9 |  | USB3.0_MICRO_B_SMD_RECP | ZX360D-B-10P | Hirose Electric | CON_SMRT_USB3_MICRO_B_F_MTGHOLE
81 | 1 | J10 |  | HTSW-105-07-G-D | HTSW-105-07-G-D | SAMTEC | HDR_THVT_2x5_100_M
82 | 1 | J11 |  | CONN JACK PWR | RAPC722 | Switchcraft | CON_THRT_POWERJACK_RAPC722
83 | 1 | J16 |  | HDR 2X5 | 102153-1 | Tyco | CON_THVT_2x5_100_M
84 | 1 | J17 | SHORT 3-4, 5-6, 7-8, 9-10 | HMTSW-106-07-G-D-.240 | HMTSW-106-07-G-D-.240 | SAMTEC | HDR_THVT_2x6_100_M
85 | 5 | L2,L4,L5,L9,L11 |  | .47uH | XFL4015-471MEB | Coilcraft | IND_SM_XFL4015
86 | 1 | L3 |  | 1uH | LQH3NPN1R0NJ0 | Murata | 1212
87 | 1 | OSC1 |  | 32.7680KHz | SG-3040LC 32.7680KB3: PURE SN | Epson Toyocom | osc12_sg3040lc_p5mm
88 | 1 | Q2 |  | NDS331N/SOT | NDS331N | Fairchild Semiconductor | TO236
89 | 12 | Q10,Q11,Q12,Q13,Q15,Q16,Q17,Q18,Q19,Q20,Q21,Q23 |  | DTC114EET1G | DTC114EET1G | ON Semiconductor | SOT_416_3_63x31
90 | 1 | Q22 |  | CSD18532Q5 | CSD18532Q5B | TI | SON_Q5B_8
91 | 1 | RSHN1 |  | SHUNT RES | ERJ-2GE0R00X | Panasonic
92 | 15 | RSHN2,RSHN3,RSHN9,RSHN10,RSHN11,RSHN12,RSHN13,RSHN14,RSHN15,RSHN16,RSHN17,RSHN18,RSHN19,RSHN20,RSHN21 |  | SHUNT HEADER | ERJ-2GE0R00X | Panasonic
93 | 18 | R1,R2,R3,R4,R6,R25,R99,R100,R101,R102,R103,R232,R233,R235,R358,R468,R524,R528 |  | 1K | ERJ-2RKF1001X | Panasonic | 402
94 | 8 | R5,R8,R9,R10,R12,R15,R19,R22 |  | 75 | ERJ-2RKF75R0X | Panasonic | 402
95 | 55 | R7,R30,R92,R96,R112,R117,R118,R119,R120,R125,R171,R177,R184,R191,R197,R203,R236,R237,R255,R258,R269,R319,R322,R325,R326,R340,R342,R347,R348,R349,R350,R352,R353,R354,R355,R356,R357,R362,R363,R364,R365,R366,R411,R420,R434,R435,R436,R437,R467,R470,R522,R523,R525,R526,R527 |  | 0 | ERJ-2GE0R00X | Panasonic | 402
96 | 0 | R23 | DNI | 0 | ERJ-8GEY0R00V | Panasonic | 1206
97 | 5 | R24,R29,R32,R33,R327 |  | 0 | ERJ-8GEY0R00V | Panasonic | 1206
98 | 1 | R26 |  | 4.75K | ERJ-8ENF4751V | Panasonic | 1206
99 | 1 | R31 |  | 47K | ERJ-2RKF4702X | Panasonic | 402
100 | 27 | R39,R43,R44,R45,R46,R47,R51,R52,R53,R54,R55,R56,R57,R59,R60,R61,R62,R63,R64,R70,R71,R72,R74,R77,R78,R291,R446 |  | 51 | RC0603F510CS | Samsung | 201
101 | 1 | R58 |  | 100 | ERJ-1GEF1000C | Panasonic | 201
102 | 8 | R81,R82,R370,R371,R372,R373,R374,R375 |  | 240 | ERJ-1GEF2400C | Panasonic | 201
103 | 0 | R85 | DNI | 4.75K | ERJ-2RKF4751X | Panasonic | 402
104 | 1 | R87 |  | 22.1 | ERJ-2RKF22R1X | PANASONIC | 402
105 | 2 | R89,R90 |  | 100 | ERJ-2RKF1000X | PANASONIC | 402
106 | 0 | R91,R95 | DNI | 130 | ERJ-2RKF1300X | DALE | 402
107 | 0 | R93,R97 | DNI | 82 | ERJ-2RKF82R0X | Panasonic | 402
108 | 61 | R104,R105,R108,R142,R143,R144,R146,R147,R148,R149,R150,R151,R152,R154,R155,R156,R157,R165,R166,R174,R181,R188,R193,R194,R207,R214,R221,R226,R230,R234,R240,R253,R334,R335,R336,R337,R338,R339,R341,R344,R345,R346,R368,R369,R421,R422,R423,R424,R425,R455,R456,R457,R458,R459,R460,R461,R462,R463,R464,R465,R466 |  | 10K | ERJ-2RKF1002X | Panasonic | 402
109 | 1 | R106 |  | 680 | ERJ-2RKF6800X | Panasonic | 402
110 | 0 | R107,R110,R111,R252,R256,R260,R320,R321,R323,R324,R367,R398,R402,R439,R518,R519,R520,R521 | DNI | 0 | ERJ-2GE0R00X | Panasonic | 402
111 | 4 | R113,R114,R115,R116 |  | 1.8K | ERJ-2RKF1801X | Panasonic | 402
112 | 1 | R135 |  | 6.04K | ERJ-1GEF6041C | Panasonic | 201
113 | 1 | R136 |  | 200 | ERJ-1GEF2000C | Panasonic | 201
114 | 13 | R158,R159,R179,R185,R249,R254,R261,R343,R361,R448,R449,R450,R451 |  | 4.75K | ERJ-2RKF4751X | Panasonic | 402
115 | 5 | R160,R161,R238,R259,R469 |  | 36.5K | ERJ-2RKF3652X | Panasonic | 402
116 | 1 | R162 |  | 20K | ERJ-2RKF2002X | Panasonic | 402
117 | 1 | R163 |  | 1K | ERJ-3EKF1001V | Panasonic | 603
118 | 1 | R164 |  | 10k | ERJ-3EKF1002V | Panasonic | 603
119 | 4 | R167,R168,R169,R170 |  | 33 | ERJ-2RKF33R0X | PANASONIC | 402
120 | 1 | R173 |  | 10.2K | ERJ-2RKF1022X | PANASONIC | 402
121 | 6 | R175,R204,R315,R318,R408,R438 |  | 1M | ERJ-2RKF1004X | Panasonic | 402
122 | 5 | R176,R190,R202,R266,R410 |  | 162K | ERJ-2RKF1623X | Panasonic | 402
123 | 1 | R180 |  | 39.2K | ERJ-2RKF3922X | PANASONIC | 402
124 | 1 | R182 |  | 48.7K | ERJ-2RKF4872X | PANASONIC | 402
125 | 2 | R187,R409 |  | 453K | ERJ-2RKF4533X | PANASONIC | 402
126 | 1 | R195 |  | 249 | ERJ-3EKF2490V | Panasonic | 603
127 | 3 | R196,R428,R443 |  | 100K | ERJ-2RKF1003X | Panasonic | 402
128 | 2 | R199,R272 |  | 143K | ERJ-2RKF1433X | PANASONIC | 402
129 | 1 | R231 |  | 249K | ERJ-3EKF2493V | Panasonic | 603
130 | 0 | R239 | DNI | 1K | ERJ-2RKF1001X | Panasonic | 402
131 | 0 | R241,R242 | DNI | 100 | ERJ-2RKF1000X | PANASONIC | 402
132 | 0 | R243,R330,R331,R332,R333,R359,R360,R426 | DNI | 10K | ERJ-2RKF1002X | Panasonic | 402
133 | 0 | R244,R245 | DNI | Res_0402_Zero_H |  | Panasonic | 402
134 | 2 | R248,R262 |  | 0 | ERJ-3GEY0R00V | Panasonic | 603
135 | 2 | R311,R312 |  | 4.70K | RC0603F472CS | Samsung | 201
136 | 1 | R397 |  | 180K | ERJ-2RKF1803X | PANASONIC | 402
137 | 0 | R414,R416,R418 | DNI | 10K | ERJ-1GEF1002C | Panasonic | 201
138 | 6 | R415,R417,R419,R452,R453,R454 |  | 10K | ERJ-1GEF1002C | Panasonic | 201
139 | 1 | R427 |  | 0 | ERJ-1GN0R00C | Panasonic | 201
140 | 0 | R429,R430 | DNI | 100K | ERJ-2RKF1003X | Panasonic | 402
141 | 3 | R431,R432,R433 |  | 4.7K | ERJ-2RKF4701X | Panasonic | 402
142 | 1 | R440 |  | 33 | RC0402FR-0733RL | Yageo | 402
143 | 2 | R441,R442 |  | 2K | ERJ-1GEF2001C | Panasonic | 201
144 | 46 | R471,R472,R473,R474,R475,R476,R477,R478,R479,R480,R481,R482,R483,R484,R485,R486,R487,R488,R489,R490,R491,R492,R493,R494,R495,R496,R497,R498,R499,R500,R501,R502,R503,R504,R505,R506,R507,R508,R509,R510,R511,R512,R513,R514,R515,R516 |  | 22 | ERJ-1GEF22R0C | Panasonic | 201
145 | 10 | SHN4,SHN5,SHN6,SHN7,SHN10,SHN11,SHN12,SHN13,SHN14,SHN15 |  | SHUNT HEADER | MJ-5.97-G or equivalent | Keltron
146 | 4 | SHN17-2,SHN17-3,SHN17-4,SHN17-5 |  | SHUNT HEADER |  | Keltron
147 | 1 | SJP1 | SHUNT 1-2 | SOLDER JUMPER, 0402 | SMD PADS (NO PART) | NO PART | SMD_JUMPER_L_0402
148 | 10 | SJP2,SJP3,SJP9,SJP10,SJP11,SJP12,SJP13,SJP19,SJP20,SJP21 | SHUNT 2-3 | SOLDER JUMPER, 0402 | SMD PADS (NO PART) | NO PART | SMD_JUMPER_L_0402
149 | 3 | SJP14,SJP15,SJP18 | SHUNT 2-3 | SOLDER JUMPER, 0402 | SMD PADS (NO PART) | NO PART | JUMPER_SMD_3POS_0402
150 | 2 | SJP16,SJP17 | SHUNT 1-2 | SOLDER JUMPER, 0402 | SMD PADS (NO PART) | NO PART | JUMPER_SMD_3POS_0402
151 | 1 | SW1 |  | TDA04H0SB1R | TDA04H0SB1R | CK Components | SW-SMD-8
152 | 3 | SW2,SW7,SW11 |  | SW PUSHBUTTON | PTS635SL43 | ITT Industries/C&K Div | SW_RESET_PTS635
153 | 1 | SW6 |  | SLIDE-4P2T | EG4208A | E-SWITCH | SW_THVT_4PDT_SLIDE_12
154 | 1 | SW9 |  | SWITCH, SMT, PUSHBUTTON | EVQ-PNF04M | Panasonic | SW_SMVT_SPST_EVQPJX_2
155 | 1 | SW10 | #2 ON; #1,#3,#4 OFF SET SW at #2 | TDA04H0SB1R | TDA04H0SB1R | CK Components | SW-SMD-8
156 | 17 | TP1,TP2,TP3,TP13,TP15,TP17,TP19,TP21,TP22,TP24,TP27,TP30,TP31,TP32,TP36,TP38,TP40 |  | RED | 5010 | Keystone | testpoint_62dia
157 | 13 | TP4,TP5,TP7,TP8,TP12,TP14,TP16,TP18,TP23,TP25,TP29,TP33,TP37 |  | BLK | 5011 | Keystone | testpoint_62dia
158 | 1 | TP34 |  | Testloop_Red | 5010 | Keystone | testpoint_62dia
159 | 1 | TP35 |  | Testloop_Black | 5011 | KEYSTONE | testpoint_62dia
160 | 14 | TP42,TP43,TP44,TP47,TP49,TP50,TP51,TP52,TP53,TP54,TP55,TP56,TP57,TP58 |  | Yellow | 5009 | Keystone | testpoint_62dia
161 | 1 | U1 |  | 5AGZME1EH29 | 5AGZME1E2H29C3N | Altera | BGA_28X28_780_1mm
162 | 4 | U2,U3,U4,U5 |  | IS43TR16512AL-125KBL | IS43TR16512AL-125KBL | ISSI, Integrated Silicon Solution Inc | micron_ddr3_96_9x14
163 | 1 | U6 |  | SN74AUP1T14DCK | SN74AUP1T14DCK | Texas Instruments | SOP_5_85X55_26
164 | 1 | U13 |  | UCD90120A | UCD90120ARGC | Texas Instruments | QFN_64_360X360_0P50MM_RGC
165 | 5 | U14,U16,U18,U21,U27 |  | TPS62085 | TPS62085RLTR | Texas Instruments | QFN_RLT_7
166 | 1 | U15 |  | TPS62080_SON8 | TPS62080DSG | Texas Instruments | SON_DSG_8
167 | 1 | U17 |  | TPS51200 | TPS51200DRCT | Texas Instruments | SON_DRC_10
168 | 3 | U19,U26,U34 |  | TPS7A7300 | TPS7A7300RGWT | Texas Instruments | qfn20_rgw_p65pitch
169 | 1 | U23 |  | TPS76733 | TPS76733QPWP | Texas Instruments | HTSSOP_20_260X177_26_PWRPAD
170 | 2 | U25,U32 |  | TPS7A4700 | TPS7A4700RGWT | Texas Instruments | qfn20_rgw_p65pitch
171 | 2 | U28,U35 |  | SN74AVC4T245 | SN74AVC4T245DGVR | Texas Instruments | TVSOP_16_146x177_16
172 | 2 | U29,U41 |  | SN74AVC2T245 | SN74AVC2T245RSWR | Texas Instruments | QFN10_RSW
173 | 1 | U30 |  | SN74AVC8T245 | SN74AVC8T245DGVR | Texas Instruments | TVSOP_24_201x177_16
174 | 1 | U31 |  | TPS2400 | TPS2400DBVT | Texas Instruments | DBV5
175 | 1 | U33 |  | CYUSB301X | CYUSB3014-BZXC | Cypress | BGA_121_11X11_p8mm
176 | 1 | U36 |  | M25P40 | M25P40-VMN6TPB | Micron | SOIC8
177 | 1 | U37 |  | NCP361 | NCP361SNT1G | ON SEMI | TSOP5
178 | 1 | U38 |  | SP3010-04UTG | SP3010-04UTG | Little Fuse | SMD_DIODE_SP3010
179 | 1 | U39 |  | MAX1823B | MAX1823BEUB+ | MAXIM | TFSOP_10_118x118
180 | 1 | U42 |  | PCA9555 | PCA9555DGVR | Texas Instruments | TVSOP_24_201x177_16
181 | 1 | U43 |  | TXB0101 | TXB0101DBVR | Texas Instruments | DBV6
182 | 0 | Y1 | DNI | 10.0000MHz | FVXO-HC73BR-10.000000 | FOX ELECTRONICS | OSC_6_SM_295X205_100_CUSTOM
183 | 1 | Y2 |  | 100.00MHz | ECS-LVDS25-1000-A | ECS | VCXO_6_CUSTOM
184 | 1 | Y3 |  | 19.200MHz | NX3225SA-19.200M-EXS00A-CS03082 | NDK | xtal_4_sm_130x102
185 | 1 | Z_FANHEATSINK1 |  | FAN HEATSINK FOR FPGA | ALT008 | RADIAN HEATSINKS
185a | 1 |  | Finger Guard for Fan-sink | FINGER GUARD 30MM METAL | 8346 | Qualtek
186 | 6 | Z_STANDOFF_SCREW1,Z_STANDOFF_SCREW2,Z_STANDOFF_SCREW3,Z_STANDOFF_SCREW4,Z_STANDOFF_SCREW5,Z_STANDOFF_SCREW6 | SCREW FOR STANDOFF | PANHEAD SCREW 4-40 x 3/8 | PMSSS 440 0038 PH | Building Fasteners
187 | 6 | Z_STANDOFF1,Z_STANDOFF2,Z_STANDOFF3,Z_STANDOFF4,Z_STANDOFF5,Z_STANDOFF6 | STANDOFF | STANDOFF ALUM HEX 4-40 x 3/4" | 2204 | Keystone
188 | 1 | Z_USB_CABLE_3. | KIT ITEM | CABLE_USB_3.0 | 3023017-02M | Qualtec
