Anastien/AWG1000/hardware/02-MCAD/01-3d library/C0201.step

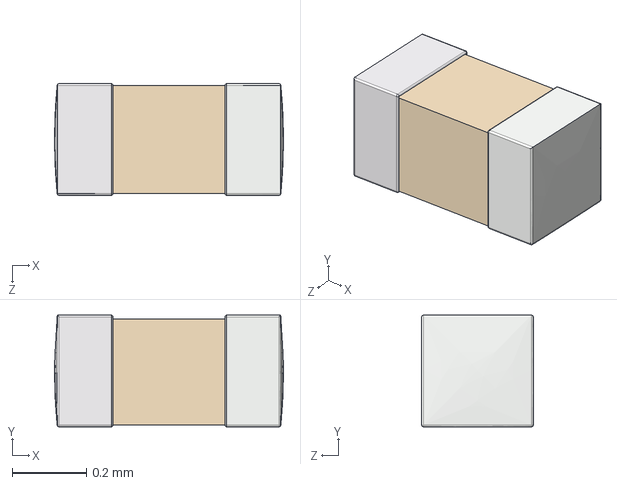
[picture p5: CAD file, 2021-07-29]
hardware/02-MCAD/01-3d library/C0201.step
0.615 x 0.3 x 0.3 mm
