Anastien/AWG1000/hardware/02-MCAD/02-Subassimblies/LCD.step

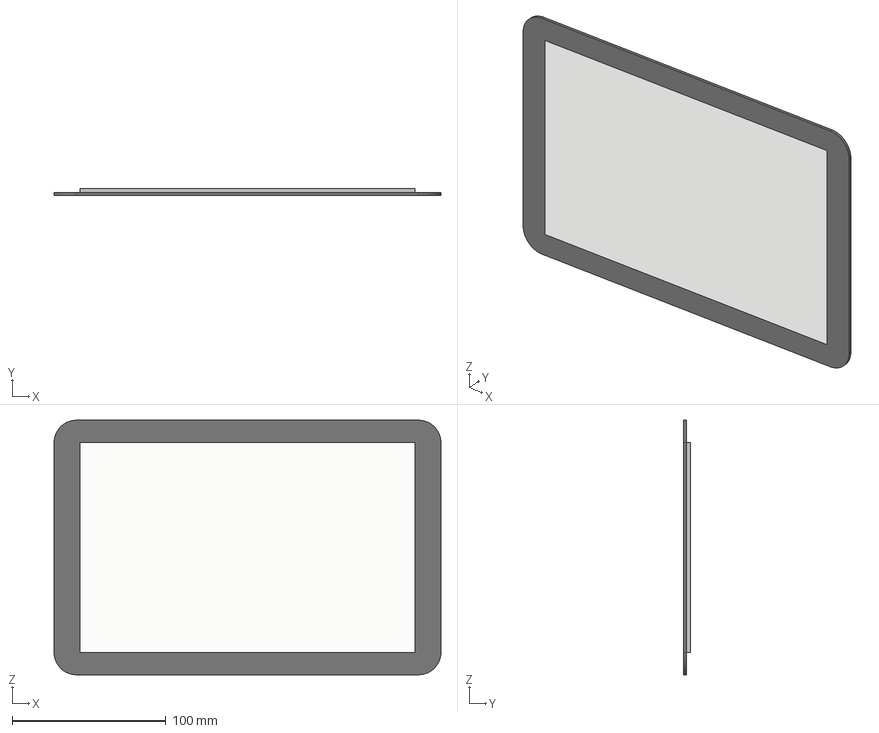
[picture p6: CAD file, 2021-05-01]
hardware/02-MCAD/02-Subassimblies/LCD.step
251.5 x 4.30 x 165.5 mm
outerframe
lcd_1
touchglass
