Anastien/AWG1000/hardware/02-MCAD/01-3d library/c-5-1634503-1-d-3d.stp

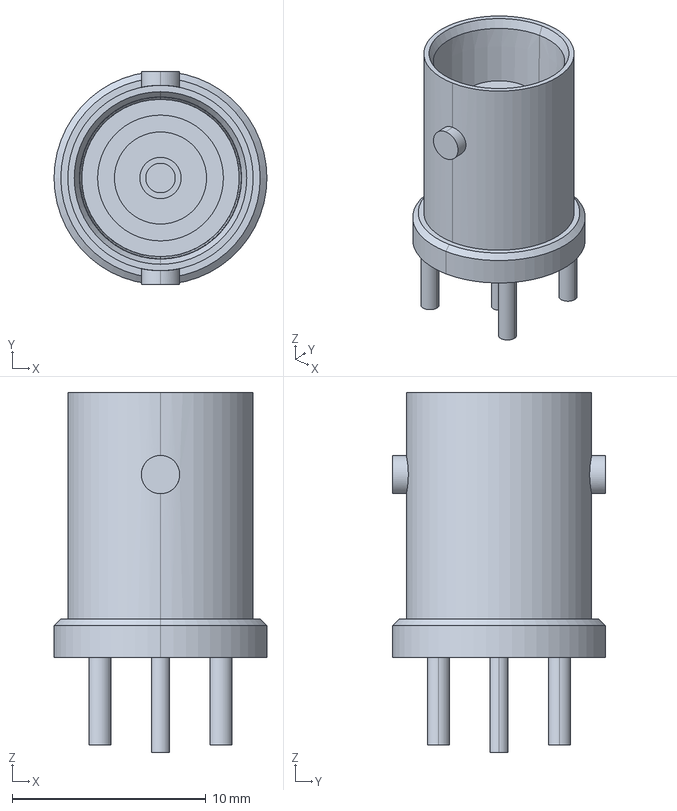
[picture p7: CAD file, 2021-07-29]
hardware/02-MCAD/01-3d library/c-5-1634503-1-d-3d.stp
11.0 x 11.0 x 18.6 mm
