Anastien/AWG1000/hardware/02-MCAD/01-3d library/TF31-50S-0.5SH_3d_stp.stp

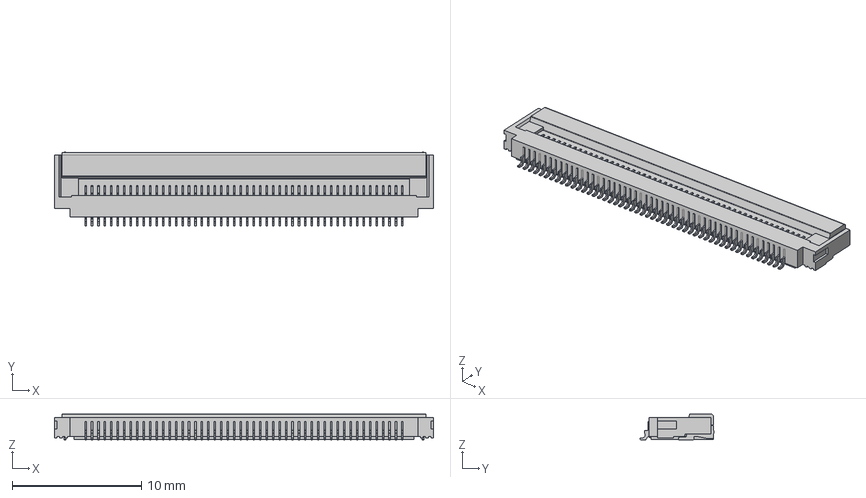
[picture p8: CAD file, 2021-05-01]
hardware/02-MCAD/01-3d library/TF31-50S-0.5SH_3d_stp.stp
29.3 x 5.75 x 2.00 mm
