Anastien/AWG1000/hardware/02-MCAD/01-3d library/1.dxf

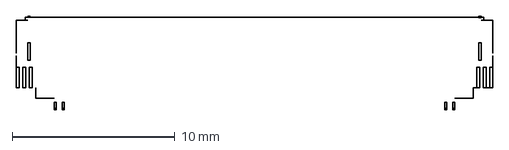
[picture p9: CAD file, 2021-05-01]
hardware/02-MCAD/01-3d library/1.dxf
29.3 x 5.75 mm
