Anastien/AWG1000/hardware/02-MCAD/01-3d library/USB1040-15-L-B.stp

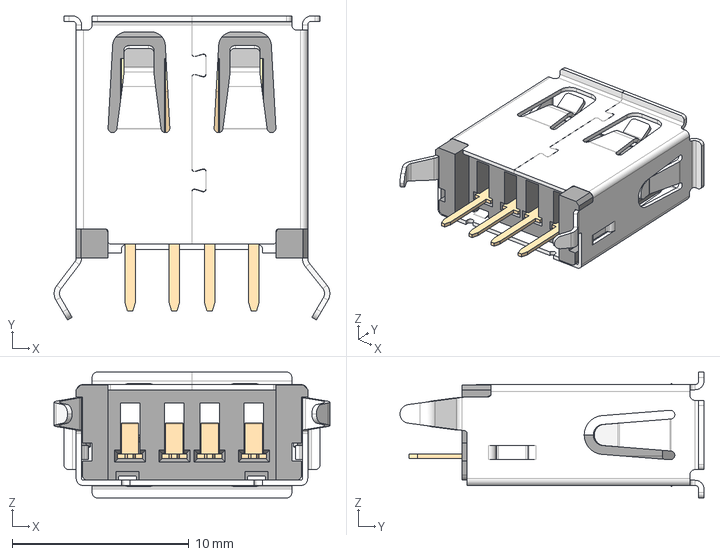
[picture p10: CAD file, 2021-05-01]
hardware/02-MCAD/01-3d library/USB1040-15-L-B.stp
15.6 x 17.2 x 7.12 mm
移动面1
输入1
