Anastien/AWG1000/hardware/02-MCAD/01-3d library/31-6233.stp

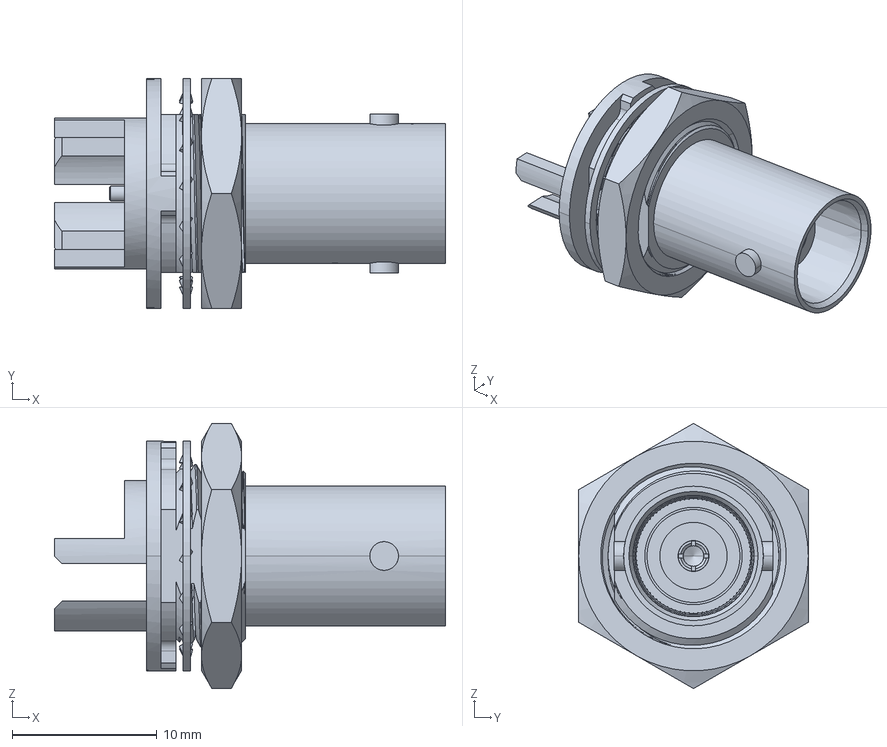
[picture p11: CAD file, 2021-04-30]
hardware/02-MCAD/01-3d library/31-6233.stp
27.0 x 15.9 x 18.3 mm
