Anastien/AWG1000/hardware/02-MCAD/01-3d library/EEE-FK1H221GP.stp

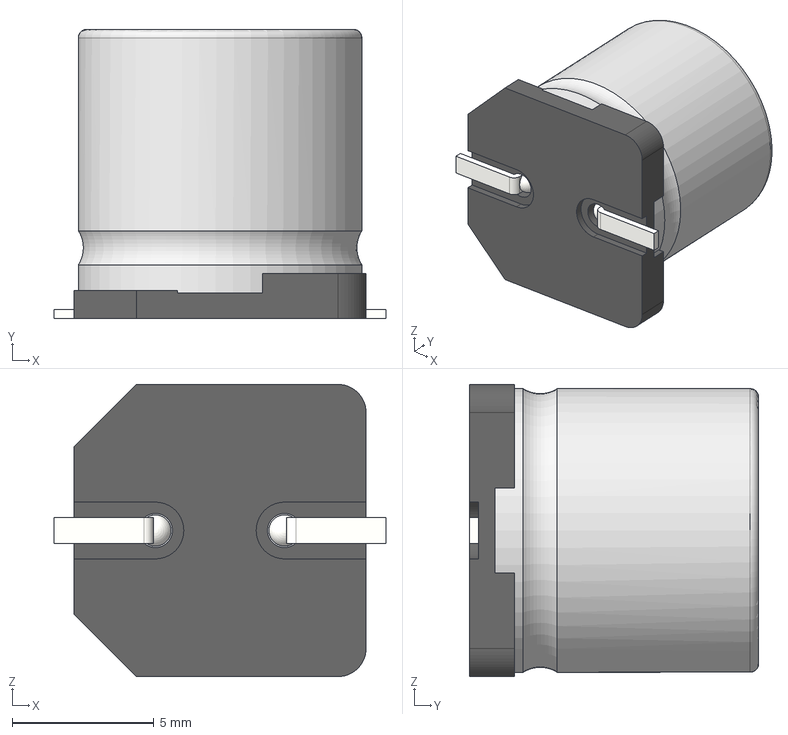
[picture p12: CAD file, 2021-04-30]
hardware/02-MCAD/01-3d library/EEE-FK1H221GP.stp
11.7 x 10.2 x 10.3 mm
標準品ケースΦ10x9.3L SIDE CODE G
標準品座版Φ10 SIZE CODE G
標準品リード線Φ10 SIZE CODE G改 x 2
