Anastien/AWG1000/hardware/02-MCAD/01-3d library/e_0100.2575_002.step

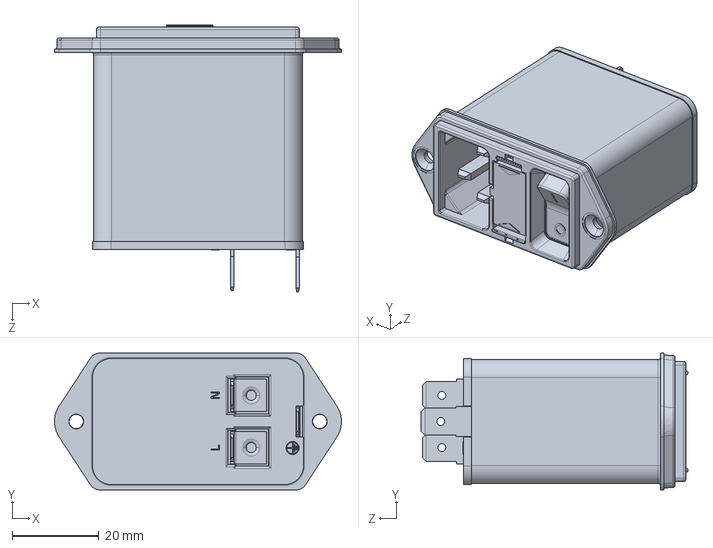
[picture p13: CAD file, 2021-04-30]
hardware/02-MCAD/01-3d library/e_0100.2575_002.step
66.0 x 31.5 x 61.3 mm
