Anastien/AWG1000/hardware/01-ECAD/02-Documentation/TWR-LCD-RGB-SCH.pdf

# Table of Contents

# Block Diagram

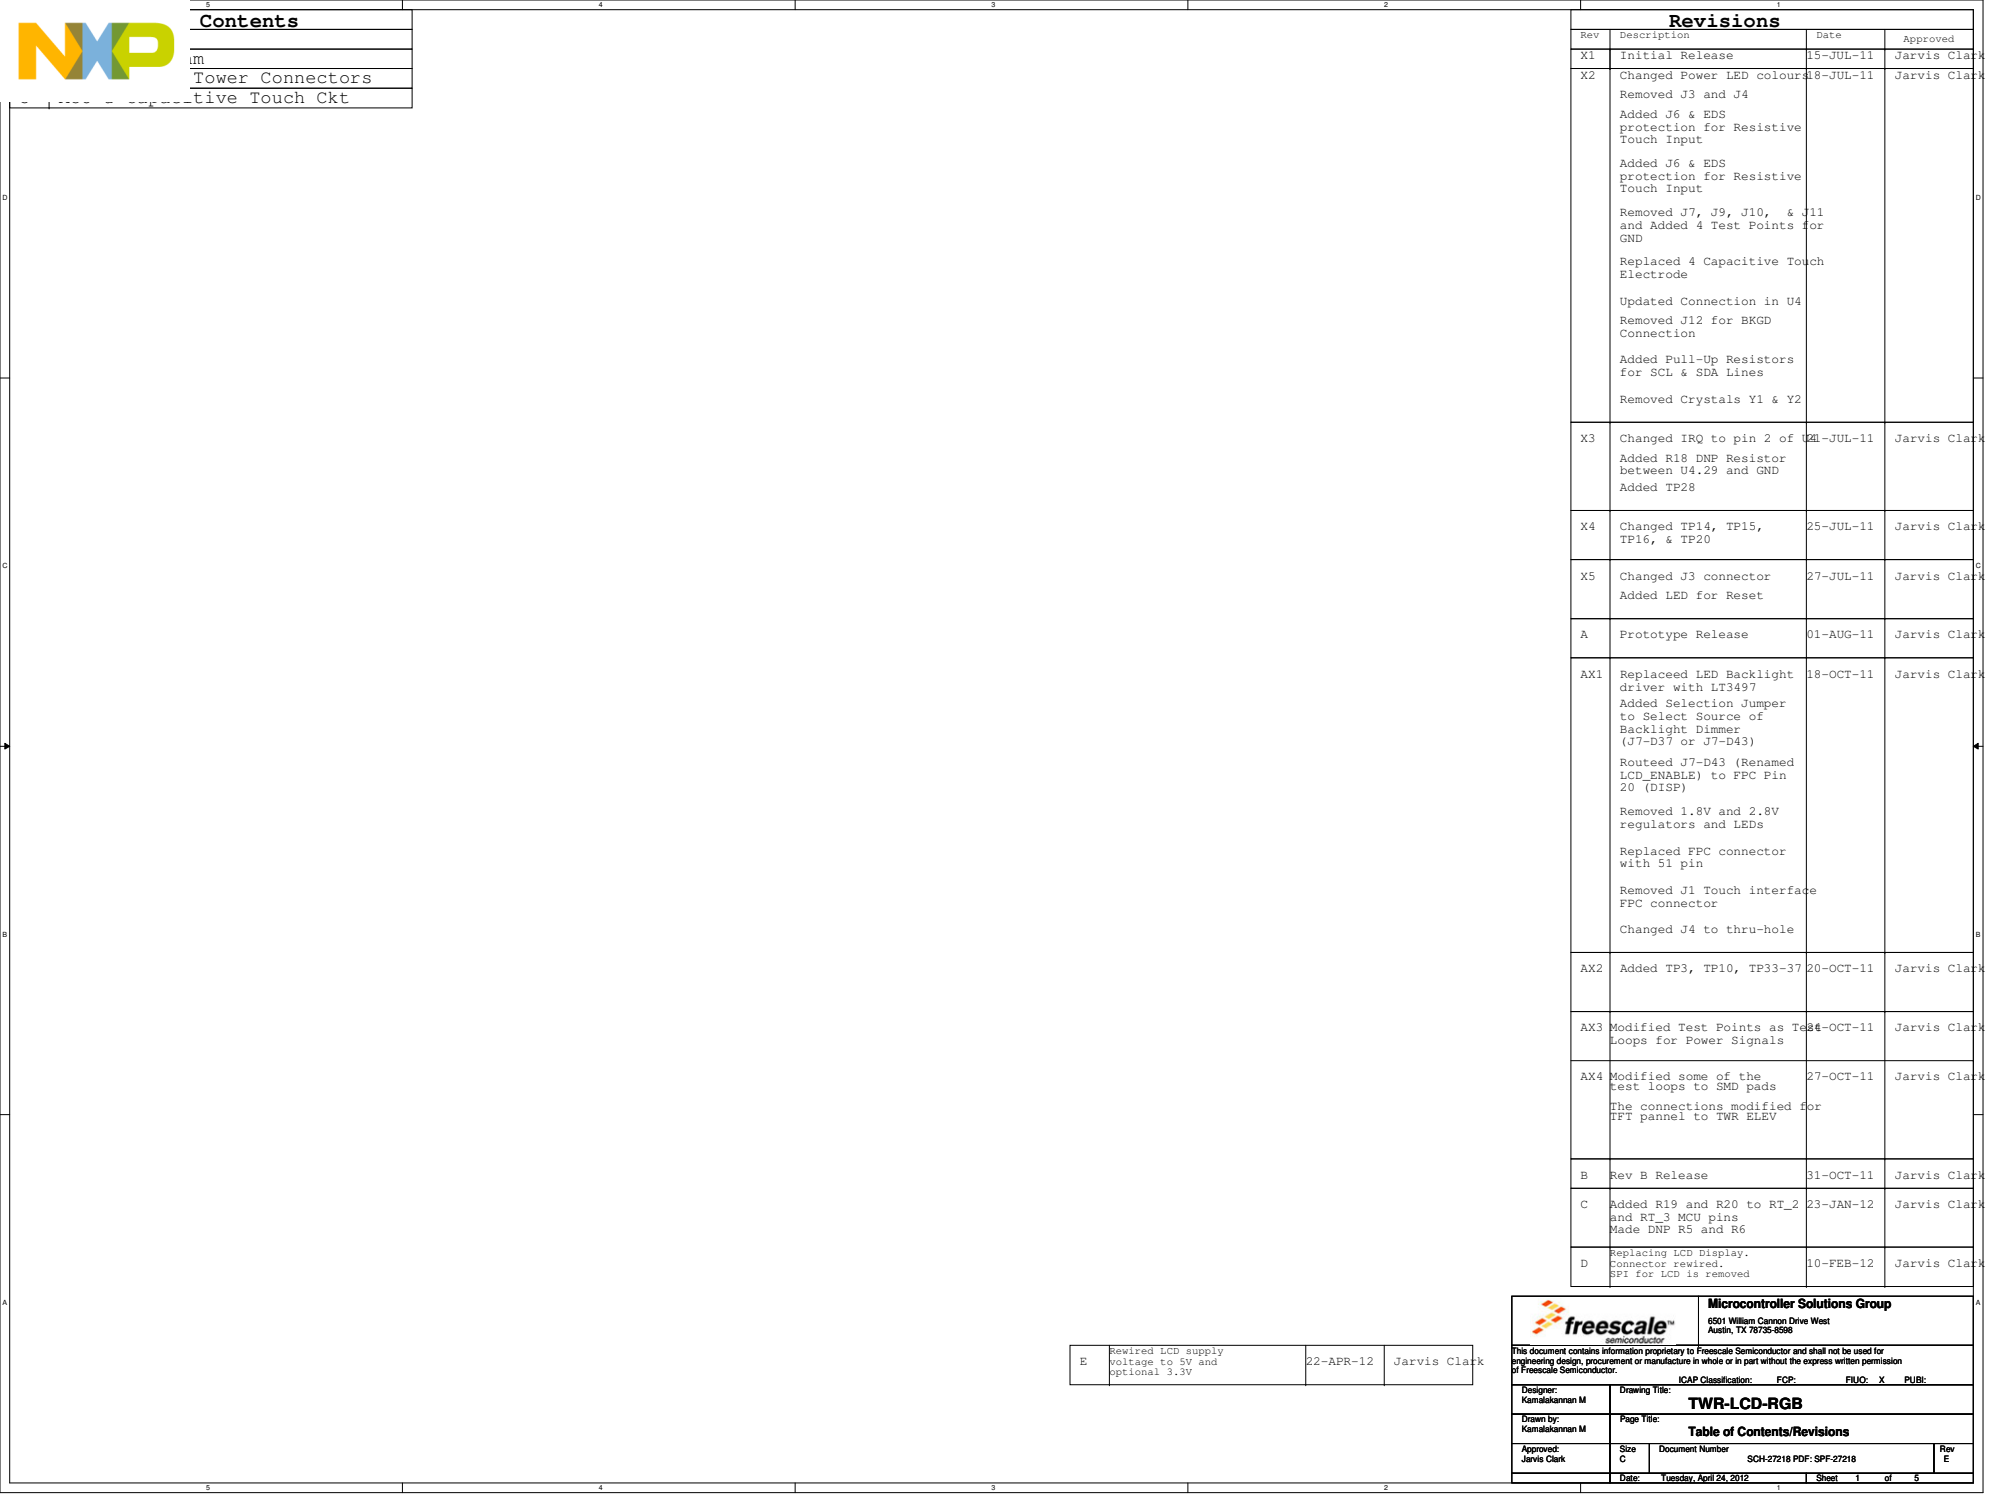
[picture p14: page 1]

Display and Tower Connectors
MCU & Capacitive Touch Ckt

and Added 4 Test Points for
GND

Added Pull-Up Resistors
for SCL & SDA Lines

Added LED for Reset

driver with LT3497
Added Selection Jumper
to Select Source of
Backlight Dimmer

Changed J4 to thru-hole

Loops for Power Signals

test loops to SMD pads

The connections modified for
TFT pannel to TWR ELEV

Connector rewired.
SPI for LCD is removed

6501 William Cannon Drive West
Austin, TX 78735-8598

This document contains information proprietary to Freescale Semiconductor and shall not be used for
engineering design, procurement or manufacture in whole or in part without the express written permission
of Freescale Semiconductor.
Designer:
Kamalakannan M

Table of Contents/Revisions

# Layout Notes :

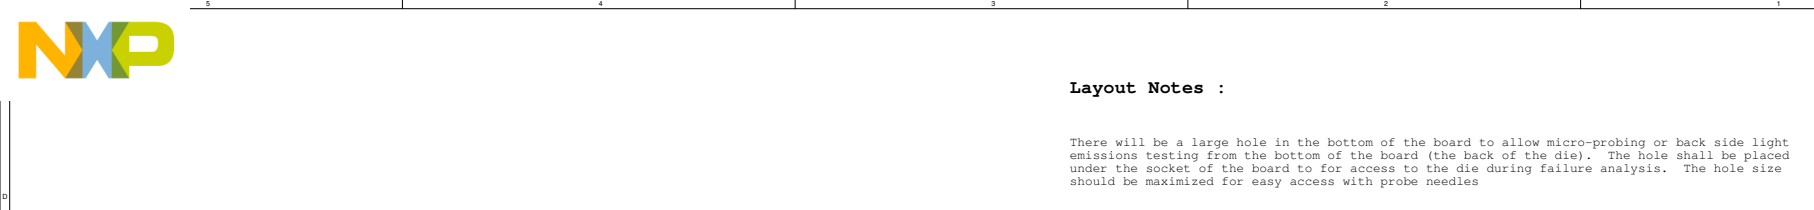
[picture p15: page 2]
emissions testing from the bottom of the board (the back of the die).; The hole shall be placed; under the socket of the board to for access to the die during failure analysis.; The hole size; Drawing Title:; ICAP Classification:; FCP:; FIUO:; PUBI:; Monday, April 23, 2012; Notes; ___ X Drawing Title: Size; Document Number; Rev Date:; Sheet; of Page Title: ICAP Classification:; PUBI: SCH-27218 PDF: SPF-27218; E TWR-LCD-RGB C; Monday, April 23, 2012 Notes

There will be a large hole in the bottom of the board to allow micro-probing or back side light
should be maximized for easy access with probe needles

TWR-LCD-RGB

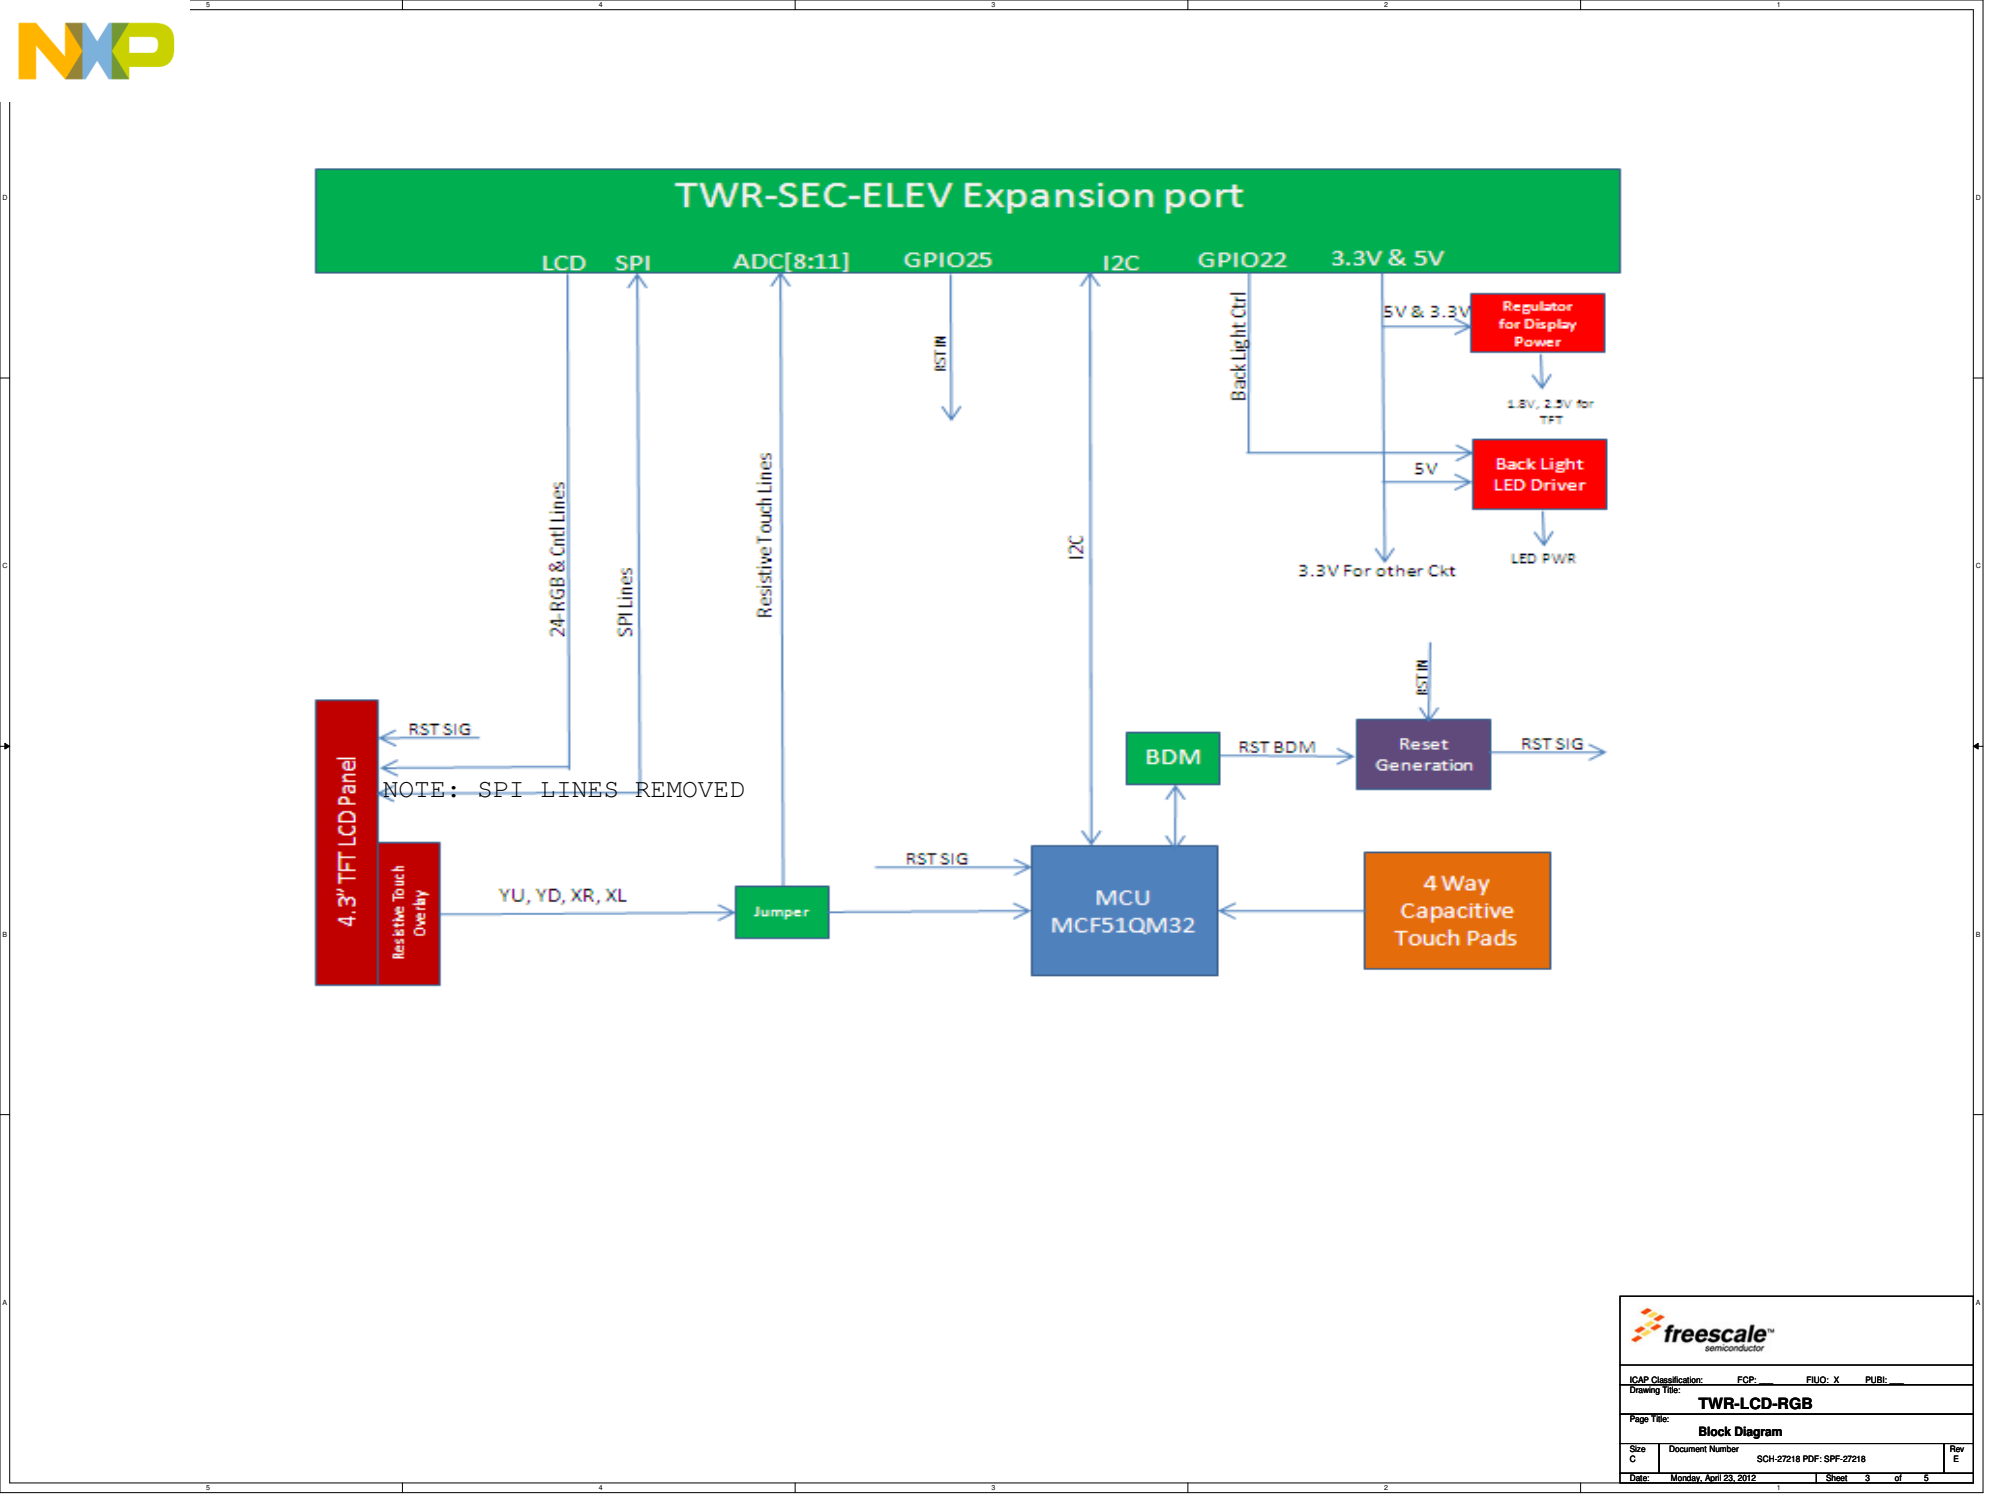
[picture p16: page 3]
Drawing Title:; ICAP Classification:; FCP:; FIUO:; PUBI:; Block Diagram; ___ X Drawing Title: Size; Document Number; Rev Date:; Sheet; of Page Title: ICAP Classification:; PUBI: SCH-27218 PDF: SPF-27218; E TWR-LCD-RGB C; Monday, April 23, 2012 Block Diagram

NOTE: SPI LINES REMOVED

TWR-LCD-RGB

# TOWER CONNECTOR

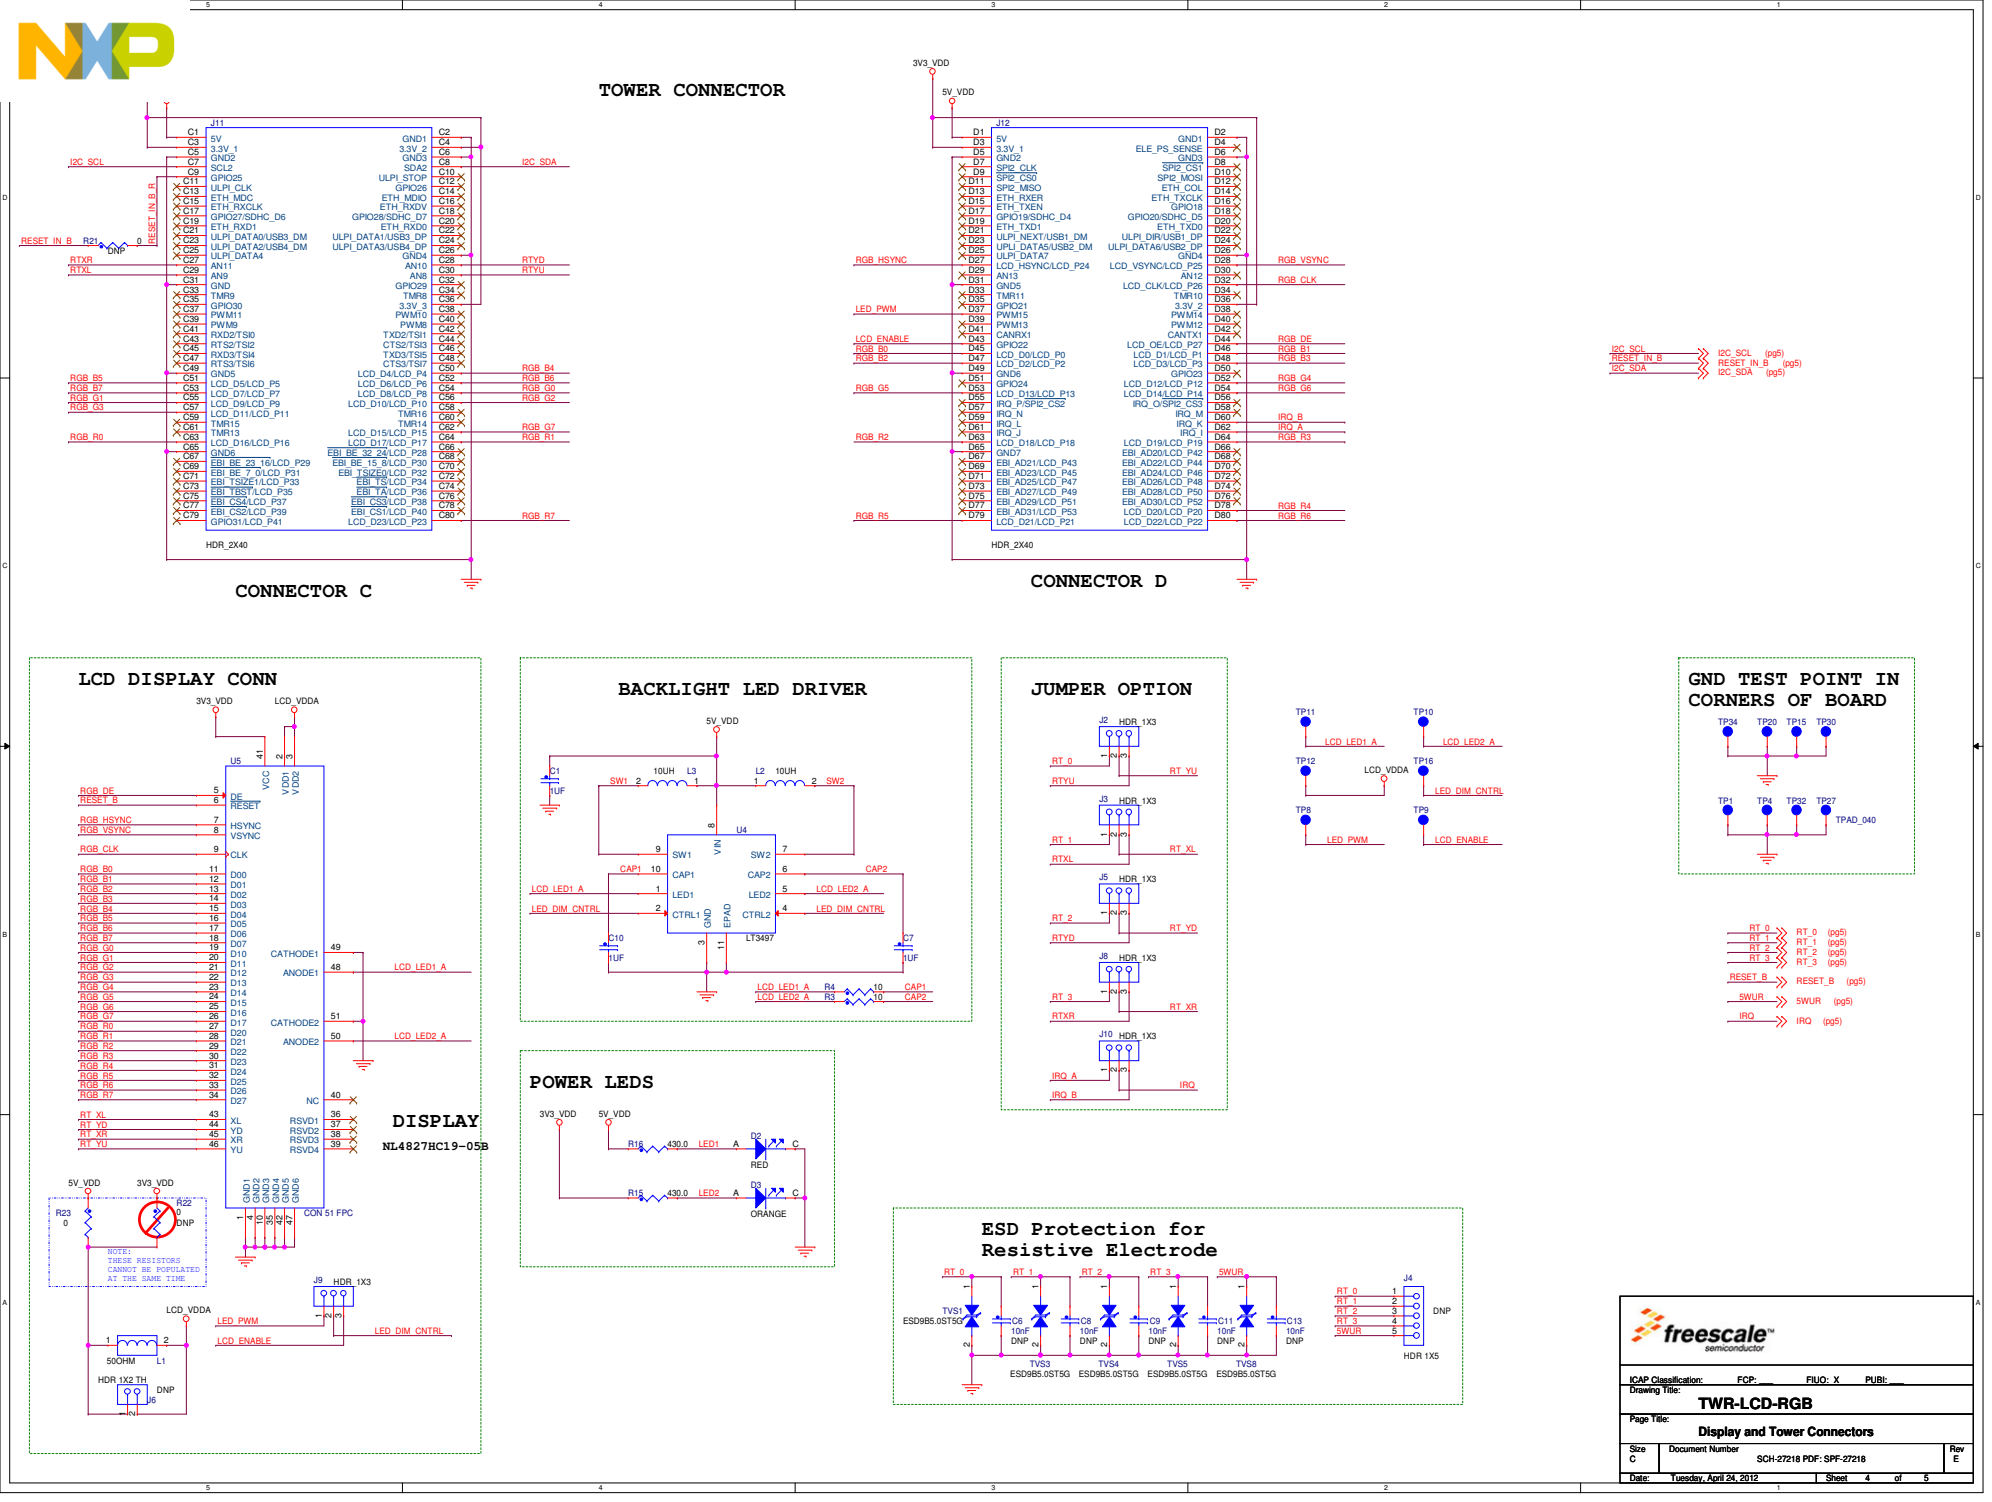
[picture p17: page 4]

GND TEST POINT IN
CORNERS OF BOARD

NOTE:
THESE RESISTORS
CANNOT BE POPULATED
AT THE SAME TIME

Display and Tower Connectors

# CRTOUCH CONTROLLER

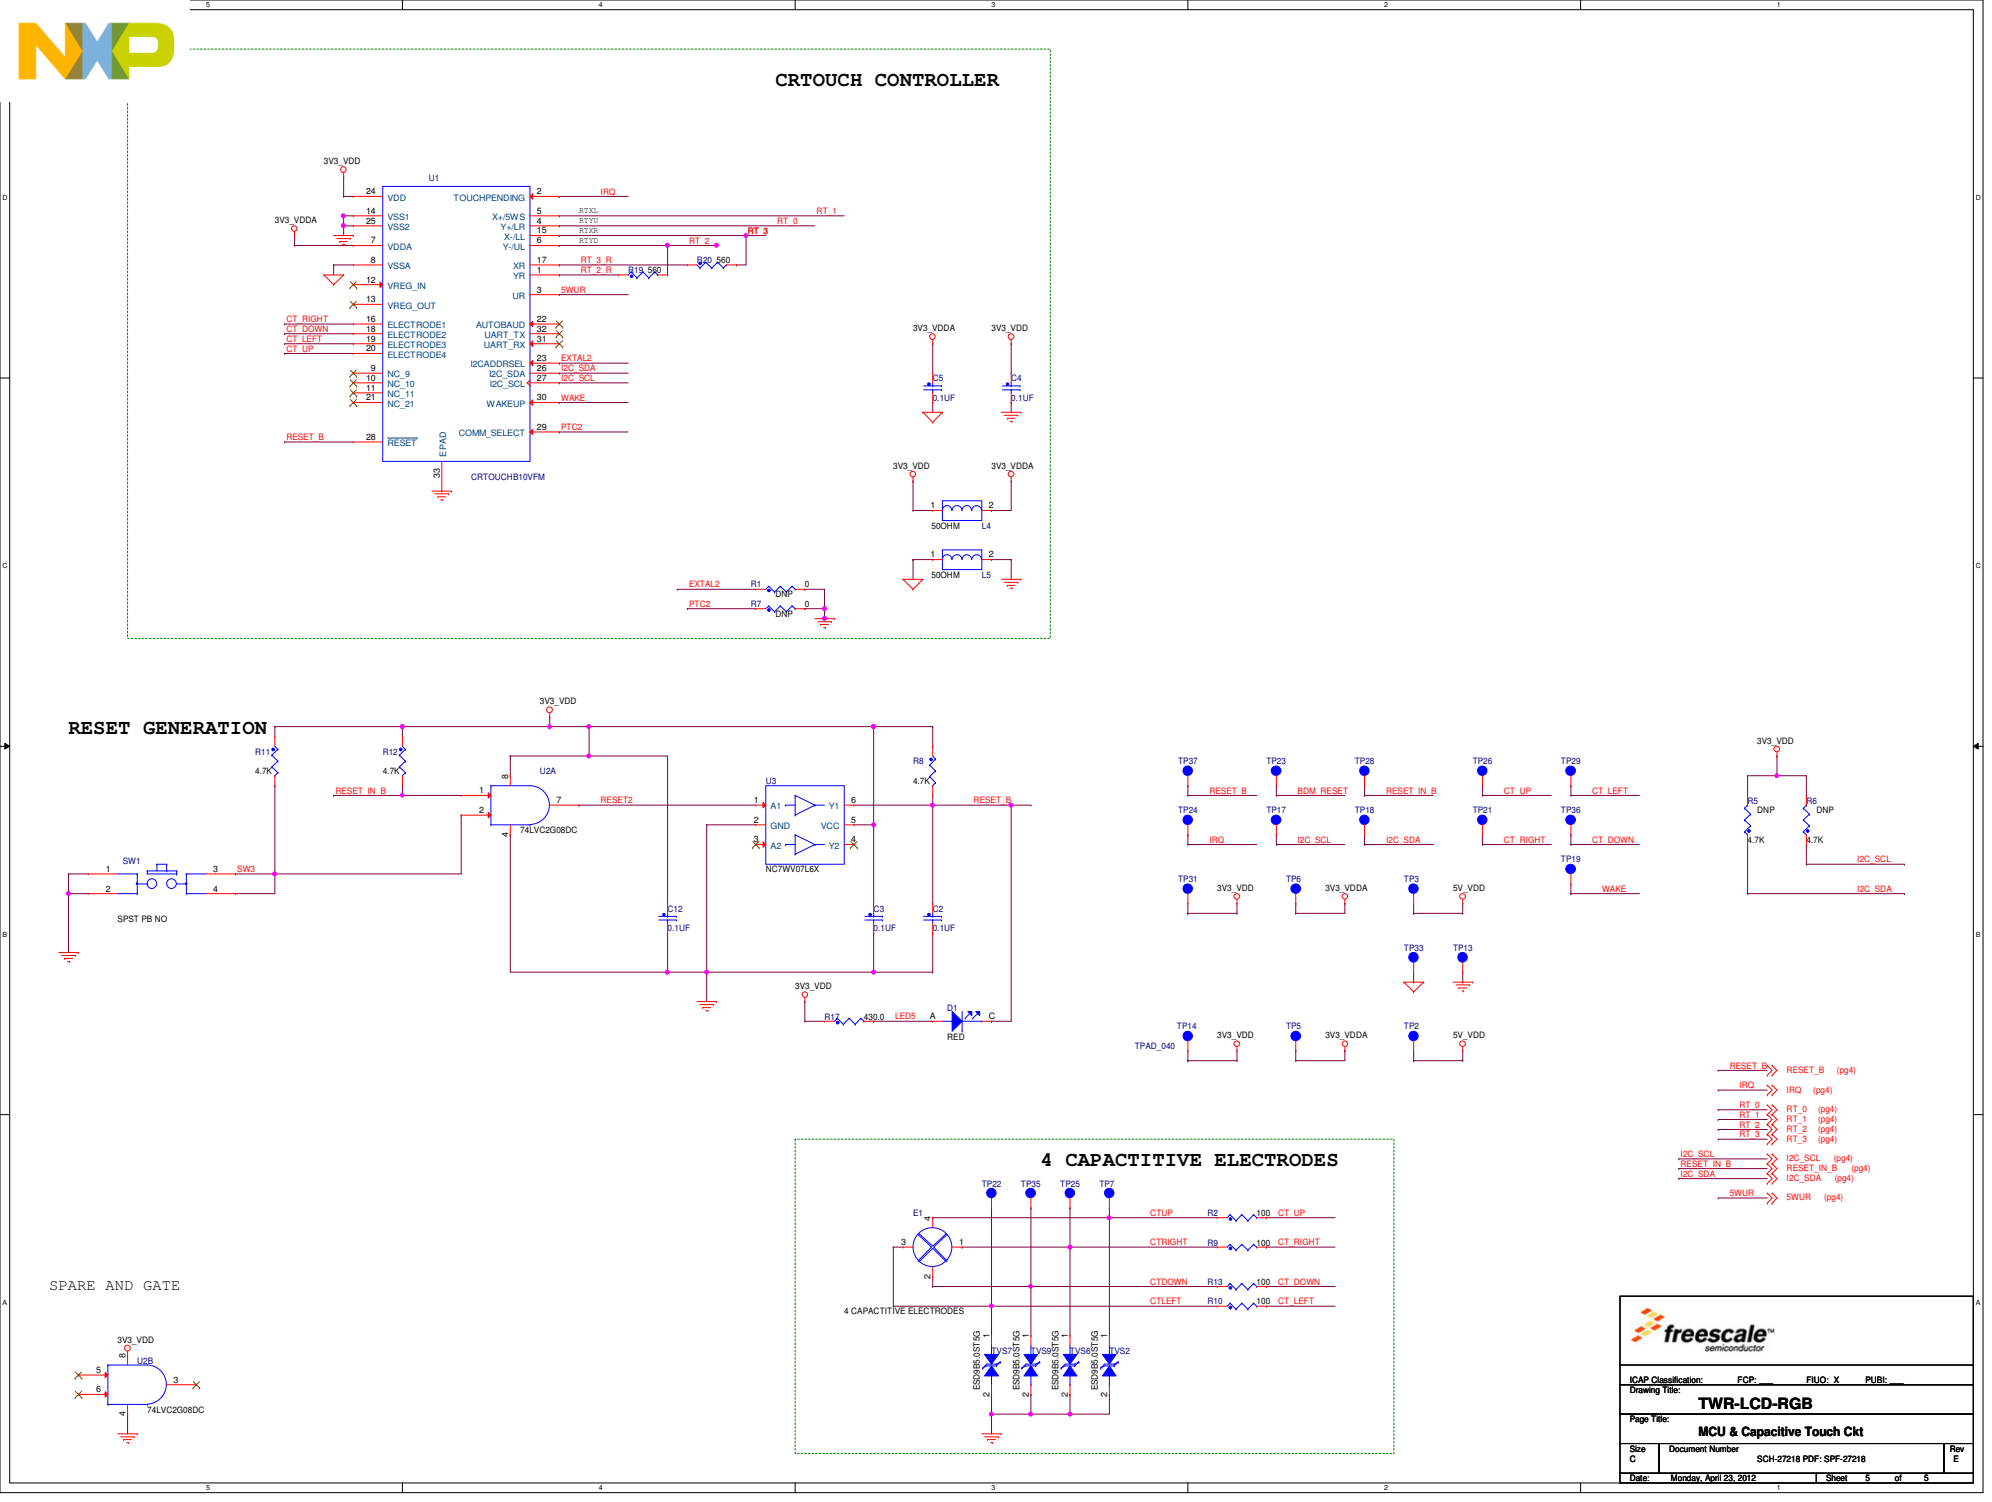
[picture p18: page 5]

MCU & Capacitive Touch Ckt
