Anastien/AWG1000/hardware/01-ECAD/01-KiCAD Files/AWG1000/AWG1000.pdf

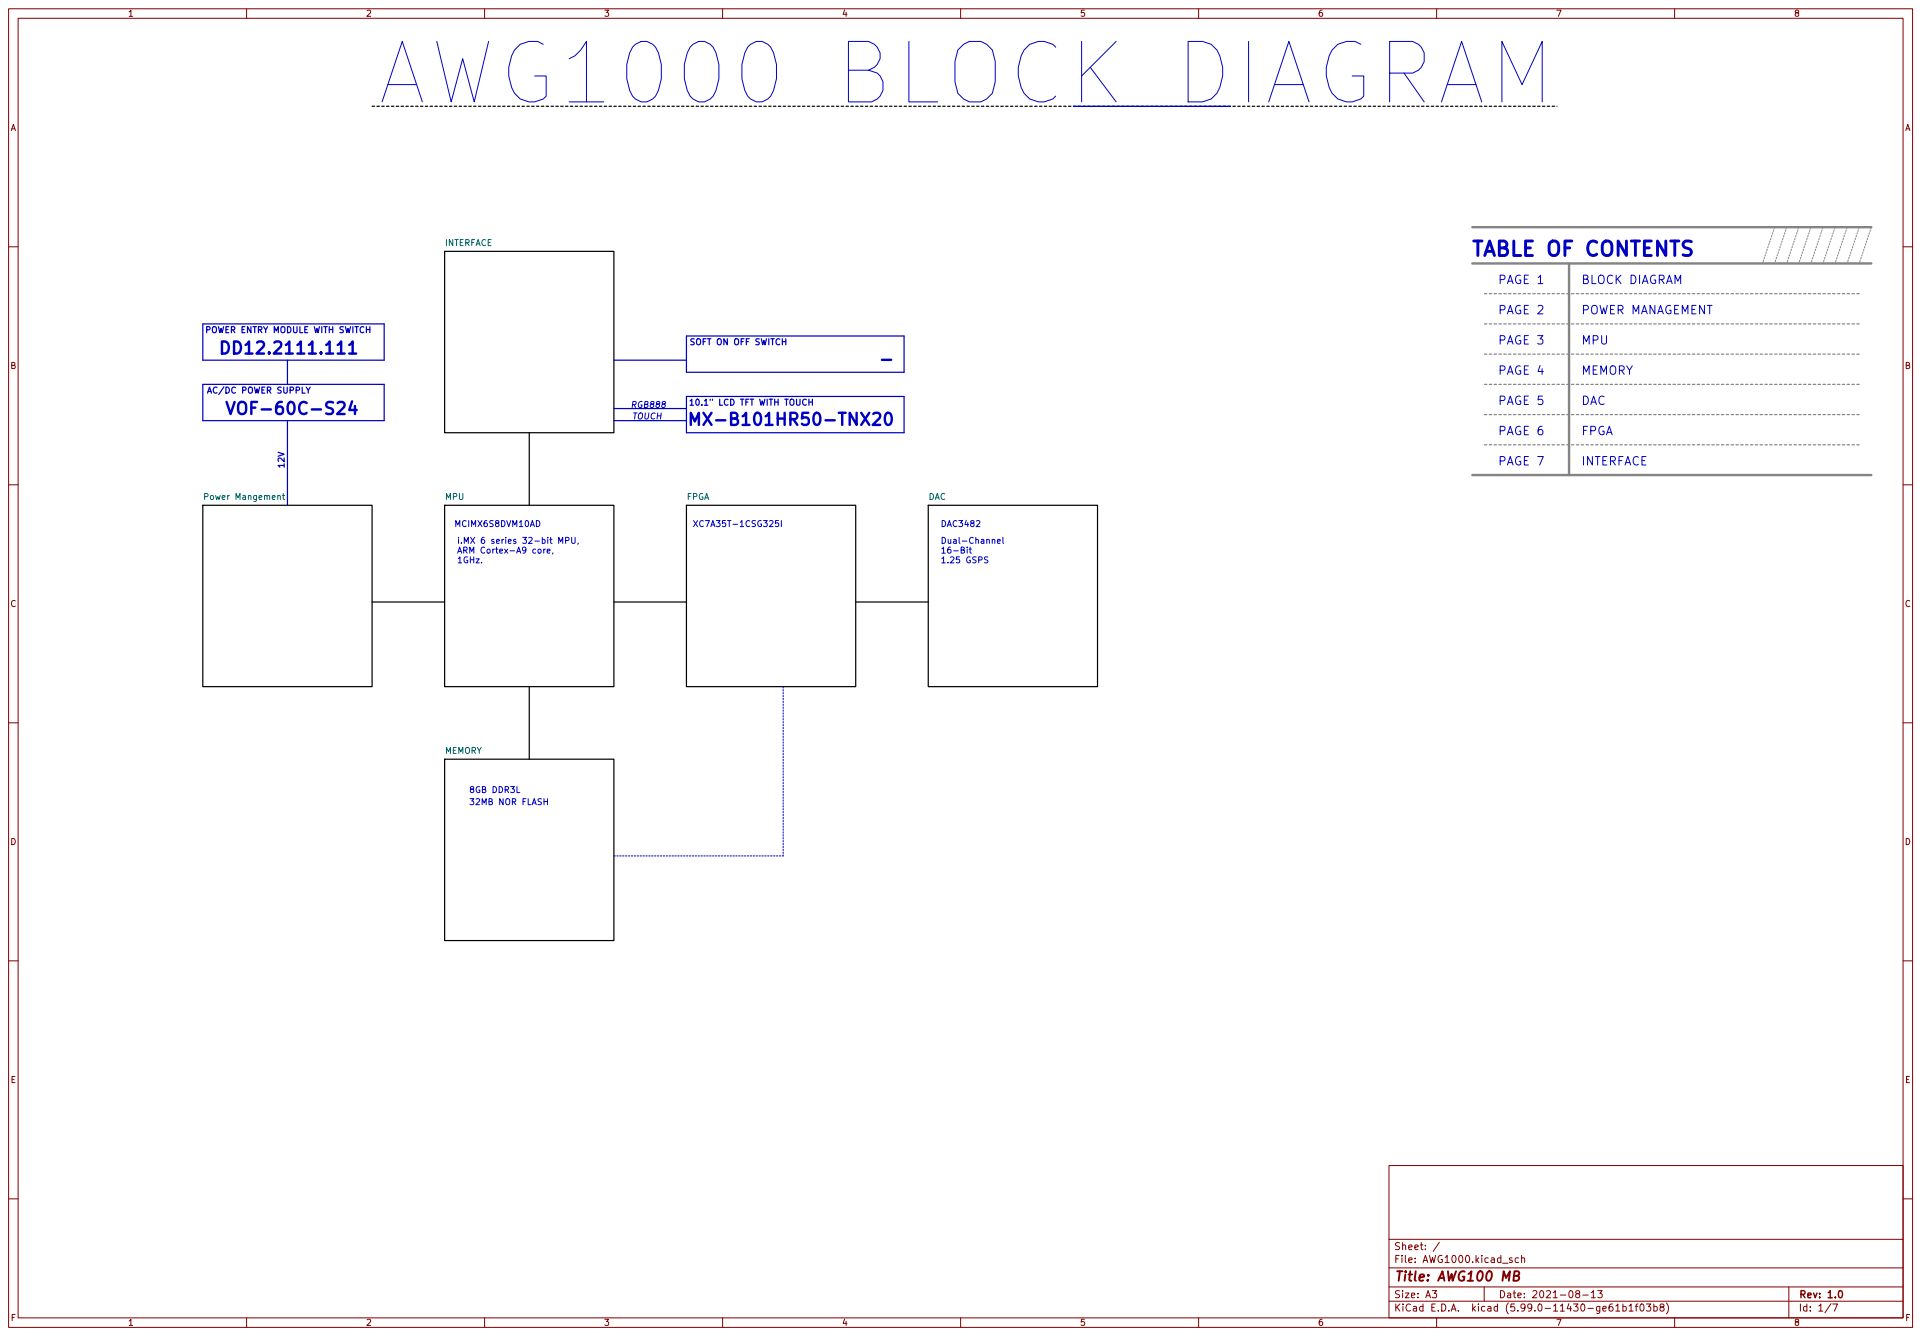
[picture p19: page 1]

POWER ENTRY MODULE WITH SWITCH

SOFT ON OFF SWITCH

RGB888 AC/DC POWER SUPPLY VOF-60C-S24

10.1" LCD TFT WITH TOUCH
XC7A35T-1CSG325I MX-B101HR50-TNX20

i.MX 6 series 32-bit MPU, ARM Cortex-A9 core, 1GHz. MCIMX6S8DVM10AD

DAC3482 Dual-Channel 16-Bit 1.25 GSPS

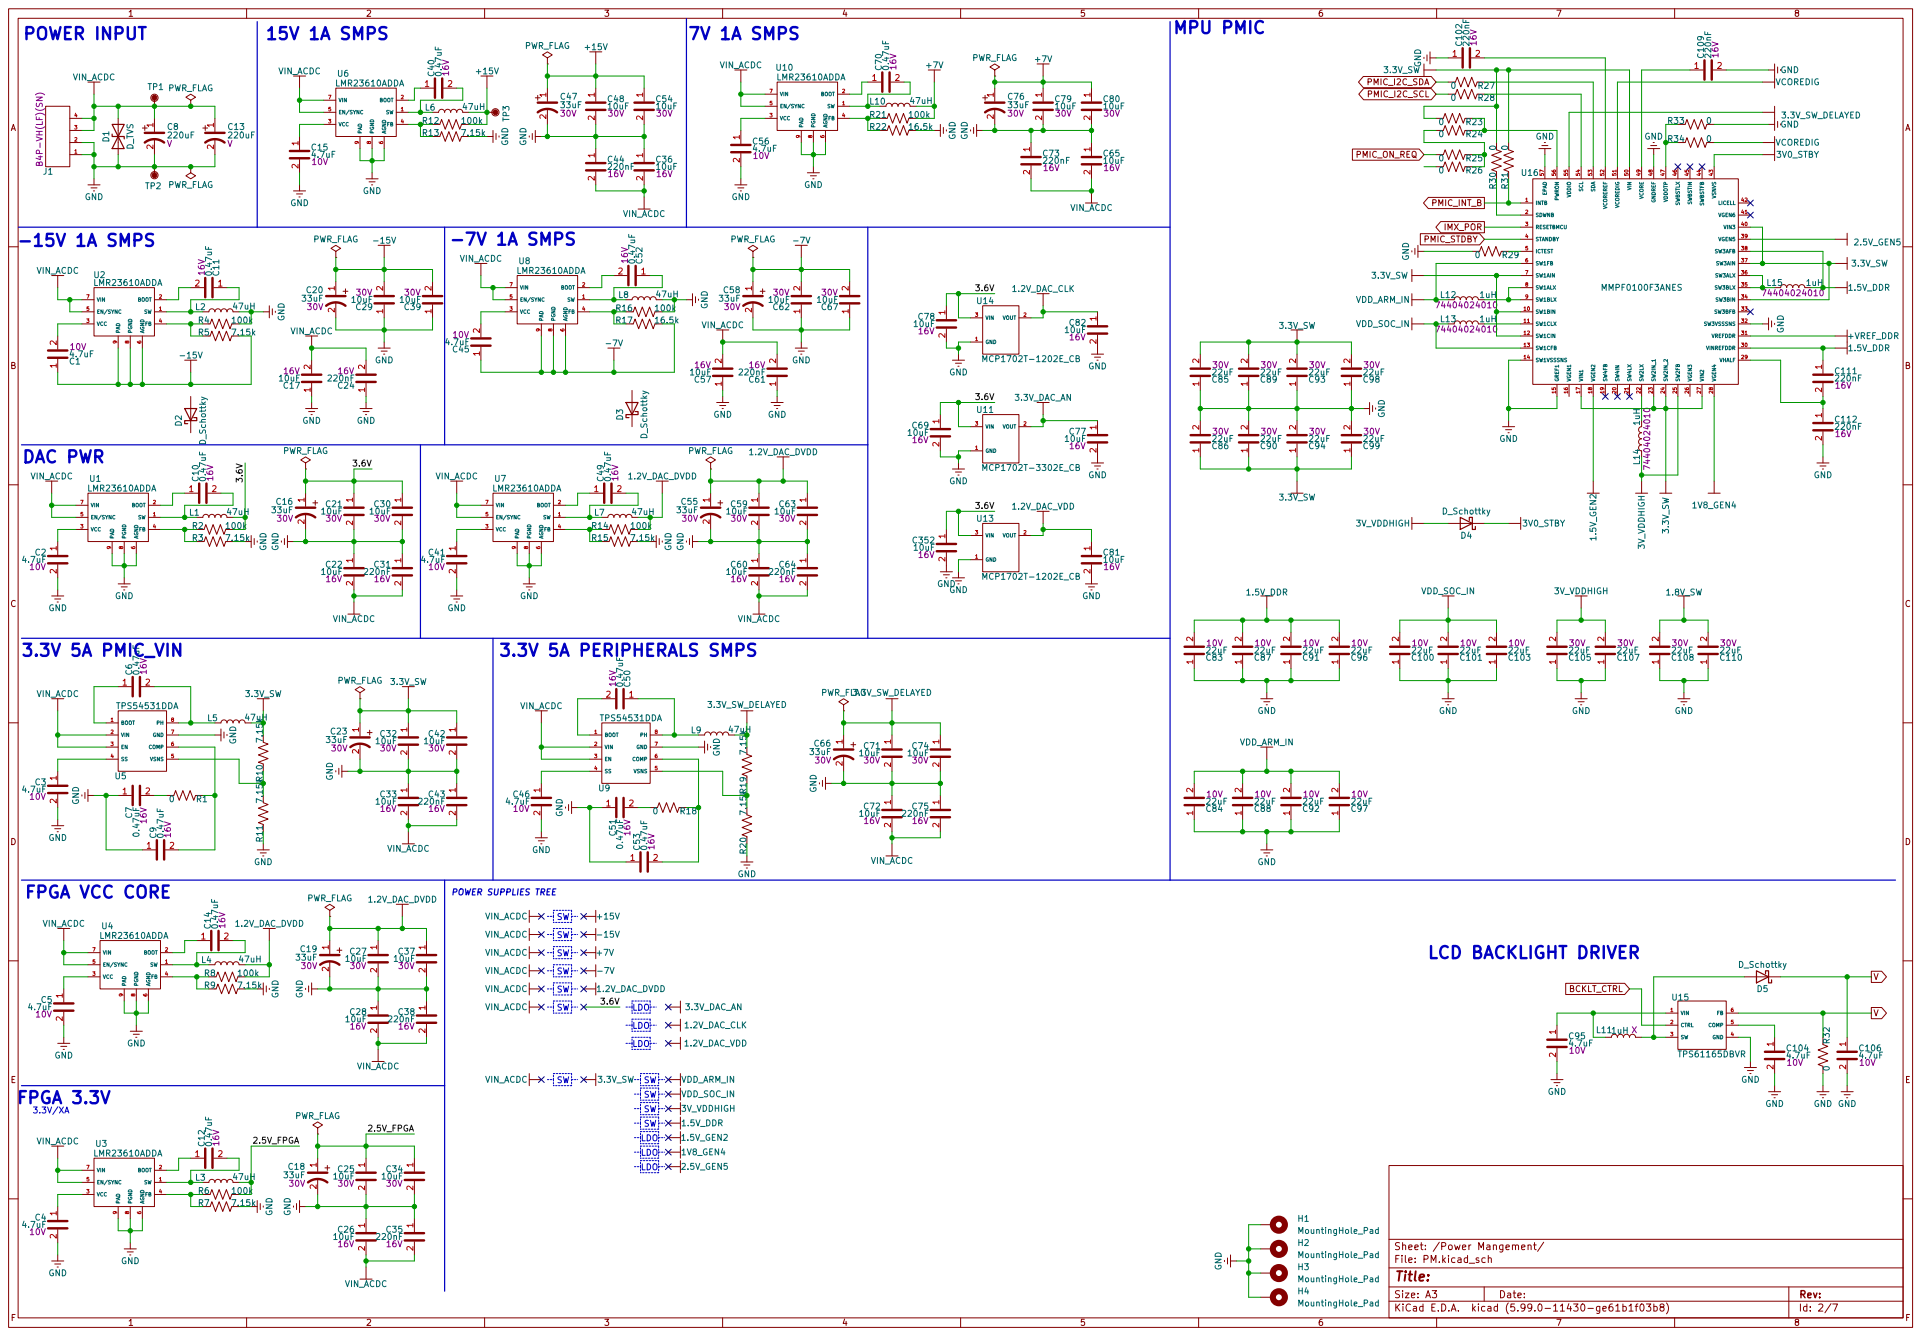
[picture p20: page 2]

42 VSNVS 43 SWBSTFB 44 SWBSTIN 45 SWBSTLX 46 VDDOTP 47 GNDREF 48

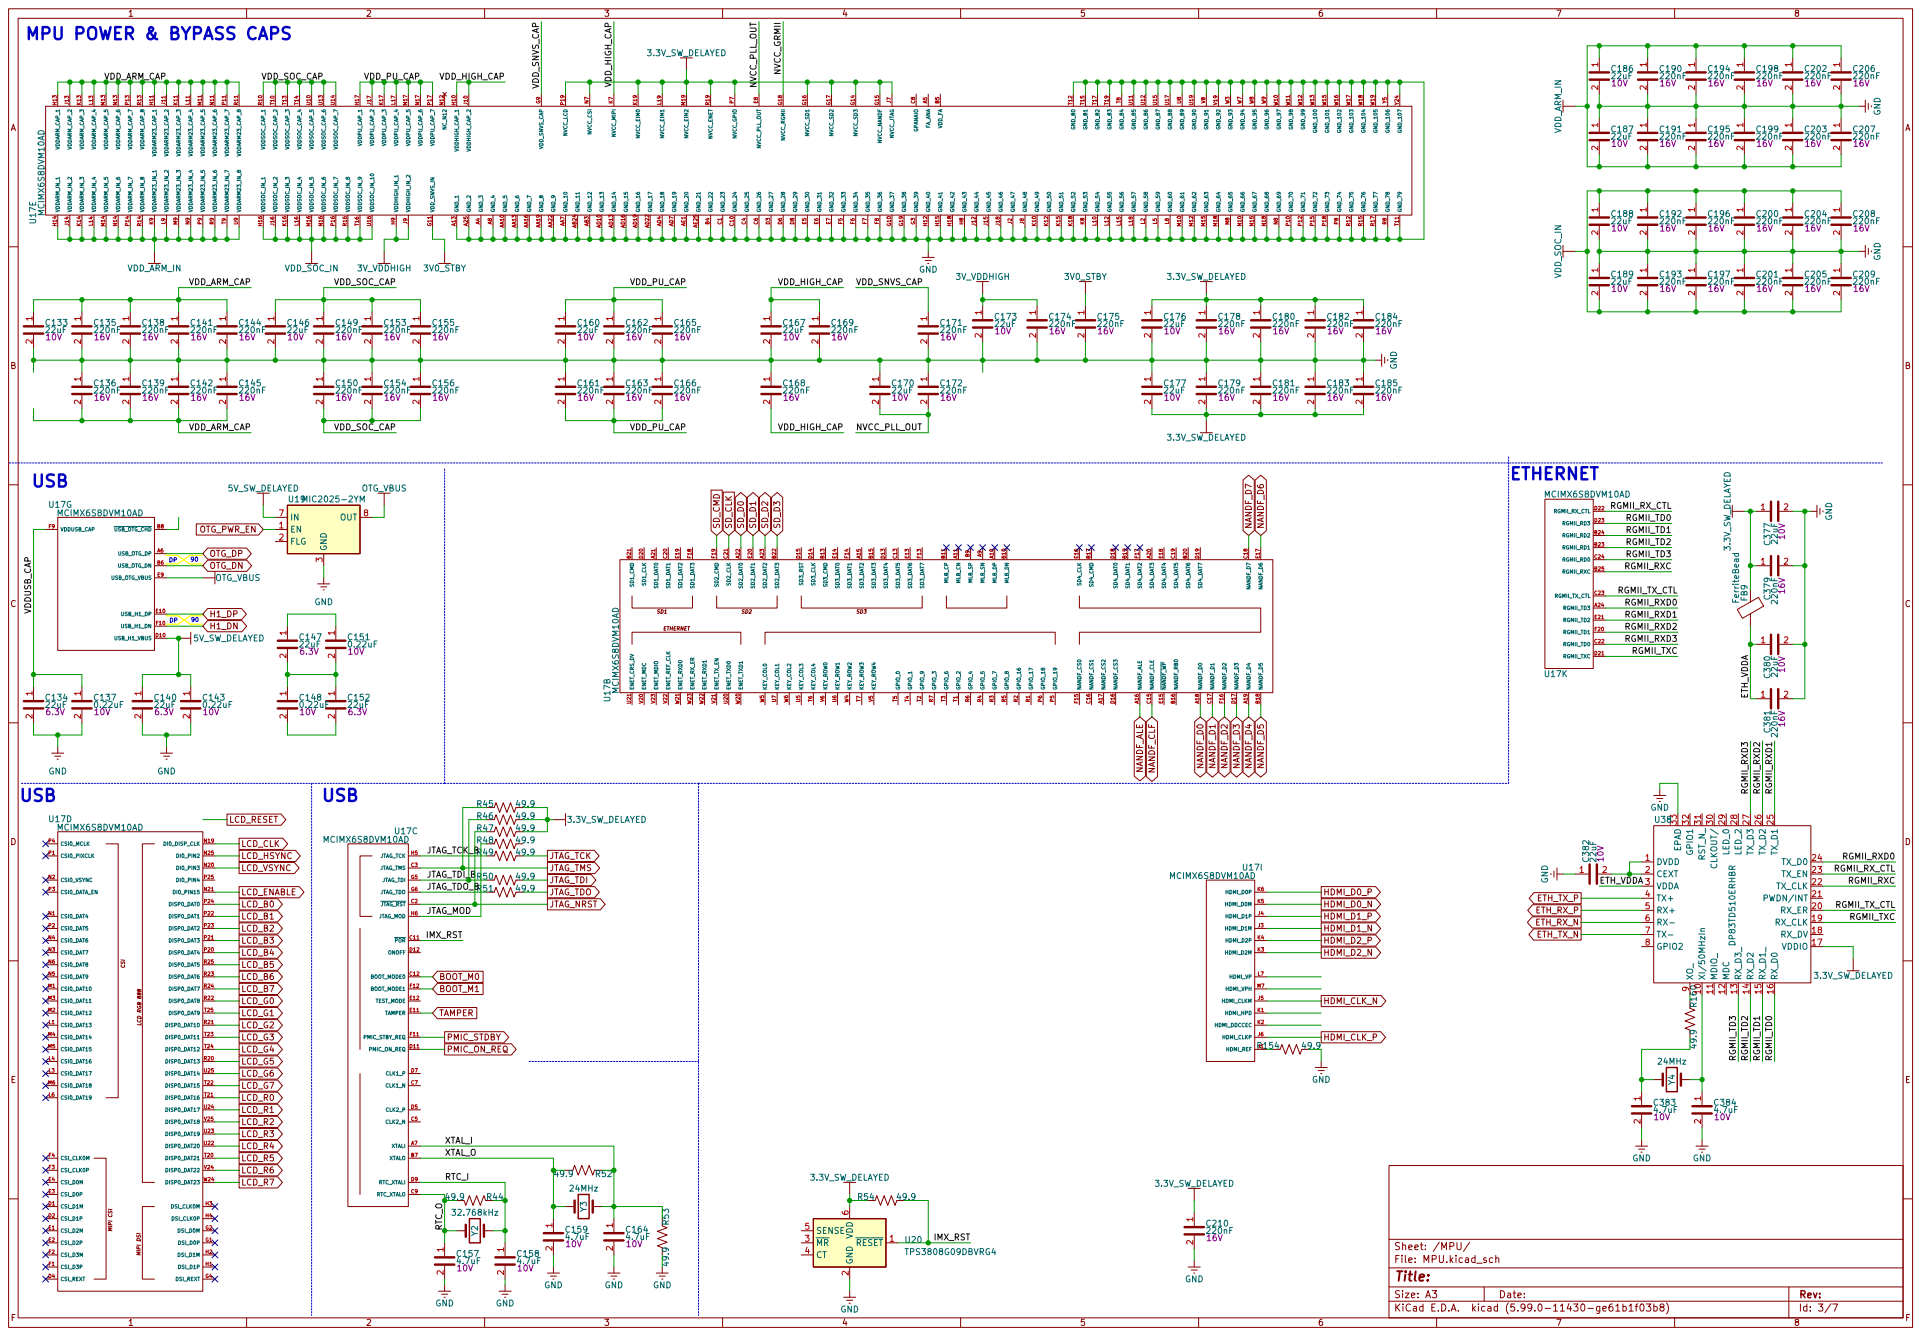
[picture p21: page 3]

90 DP MPU POWER & BYPASS CAPS

2 ~{MR} 3 CT 4 SENSE 5 VDD

File: MPU.kicad_sch Sheet: /MPU/

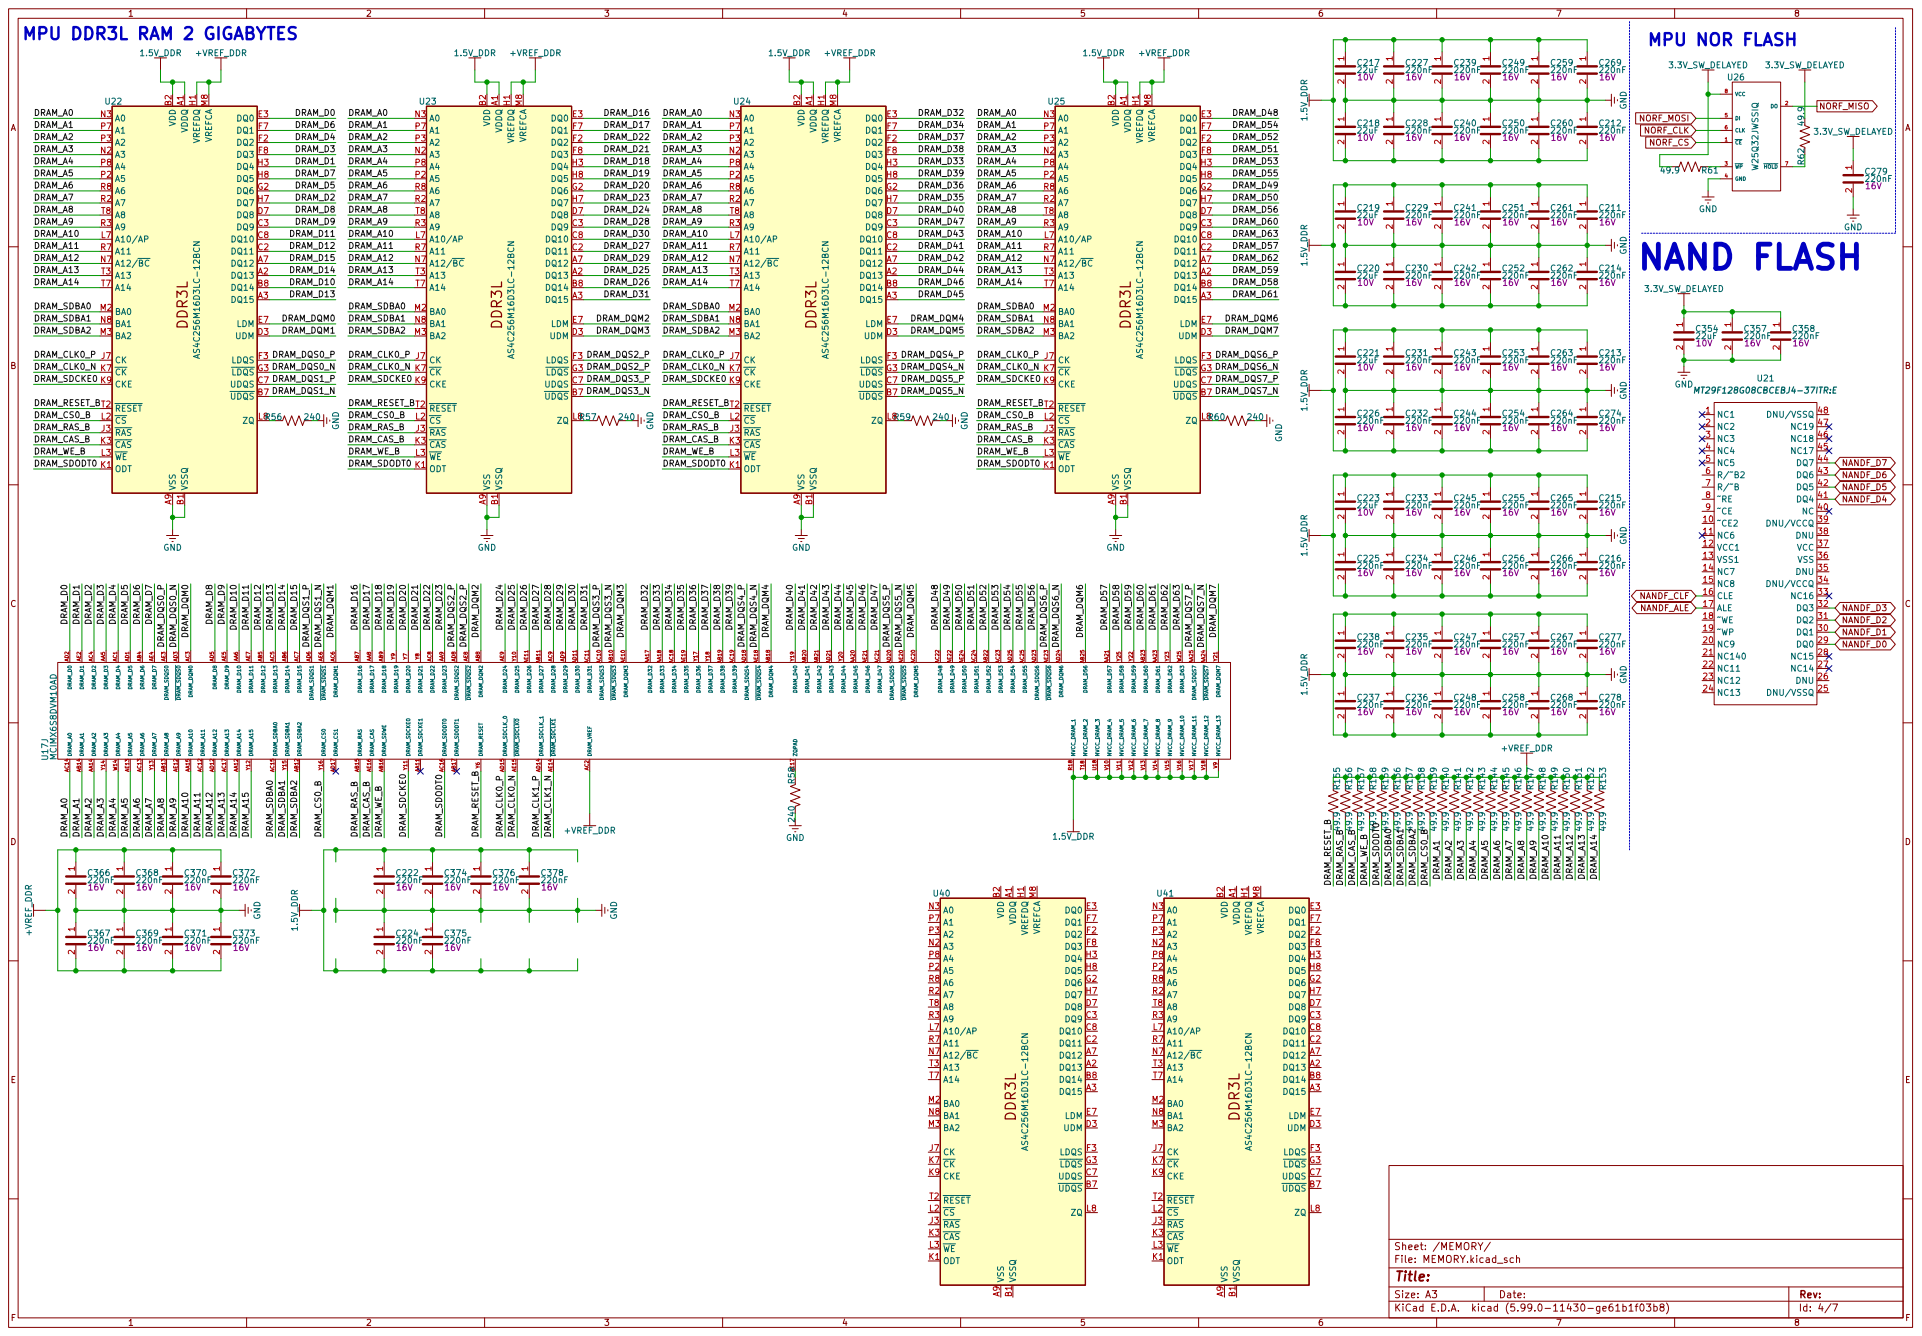
[picture p22: page 4]

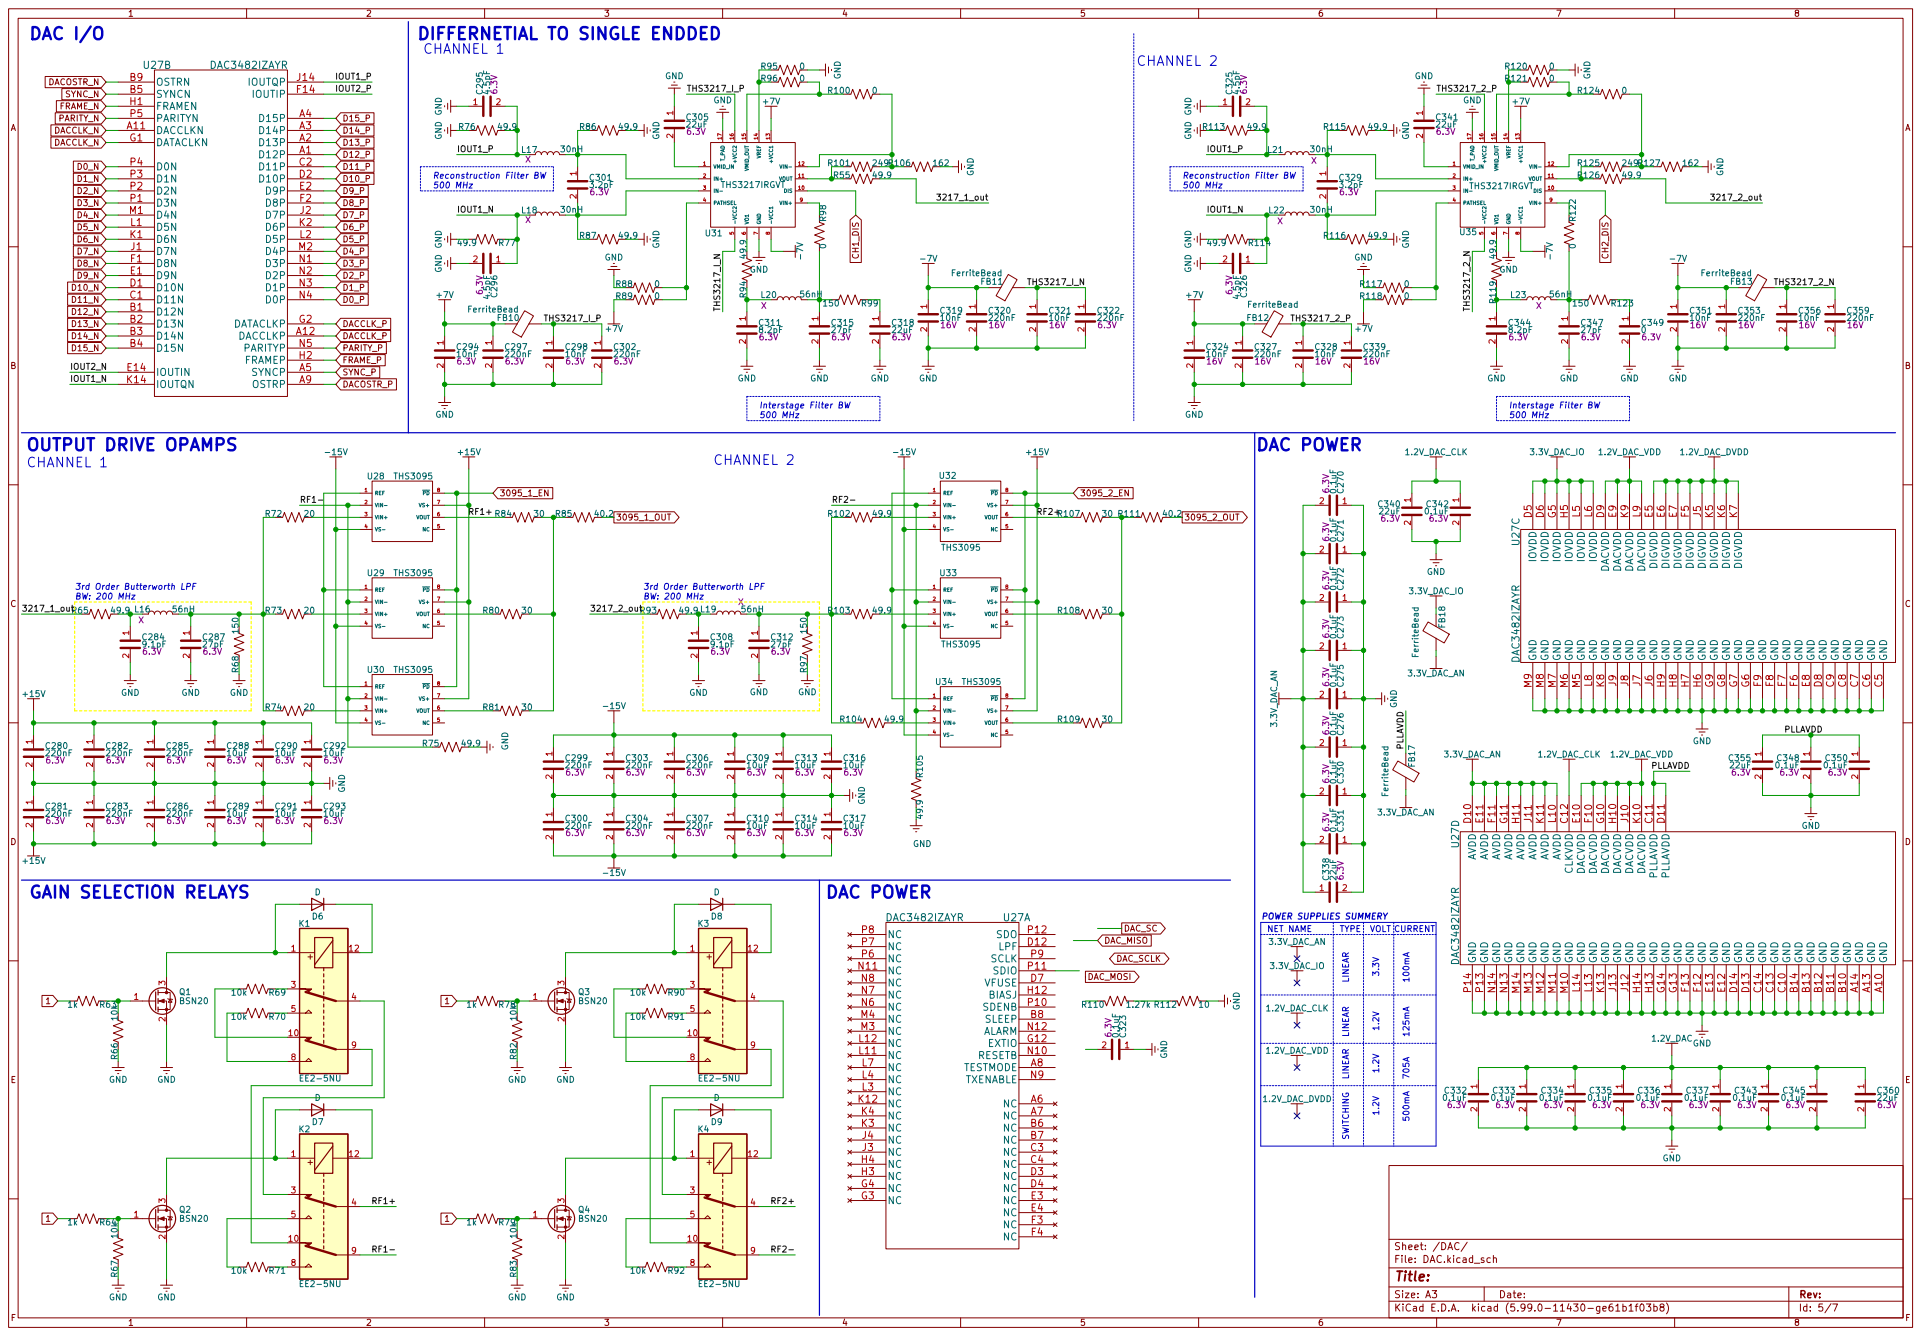
[picture p23: page 5]

DIFFERNETIAL TO SINGLE ENDDED

500 MHz Reconstruction Filter BW

File: DAC.kicad_sch Sheet: /DAC/

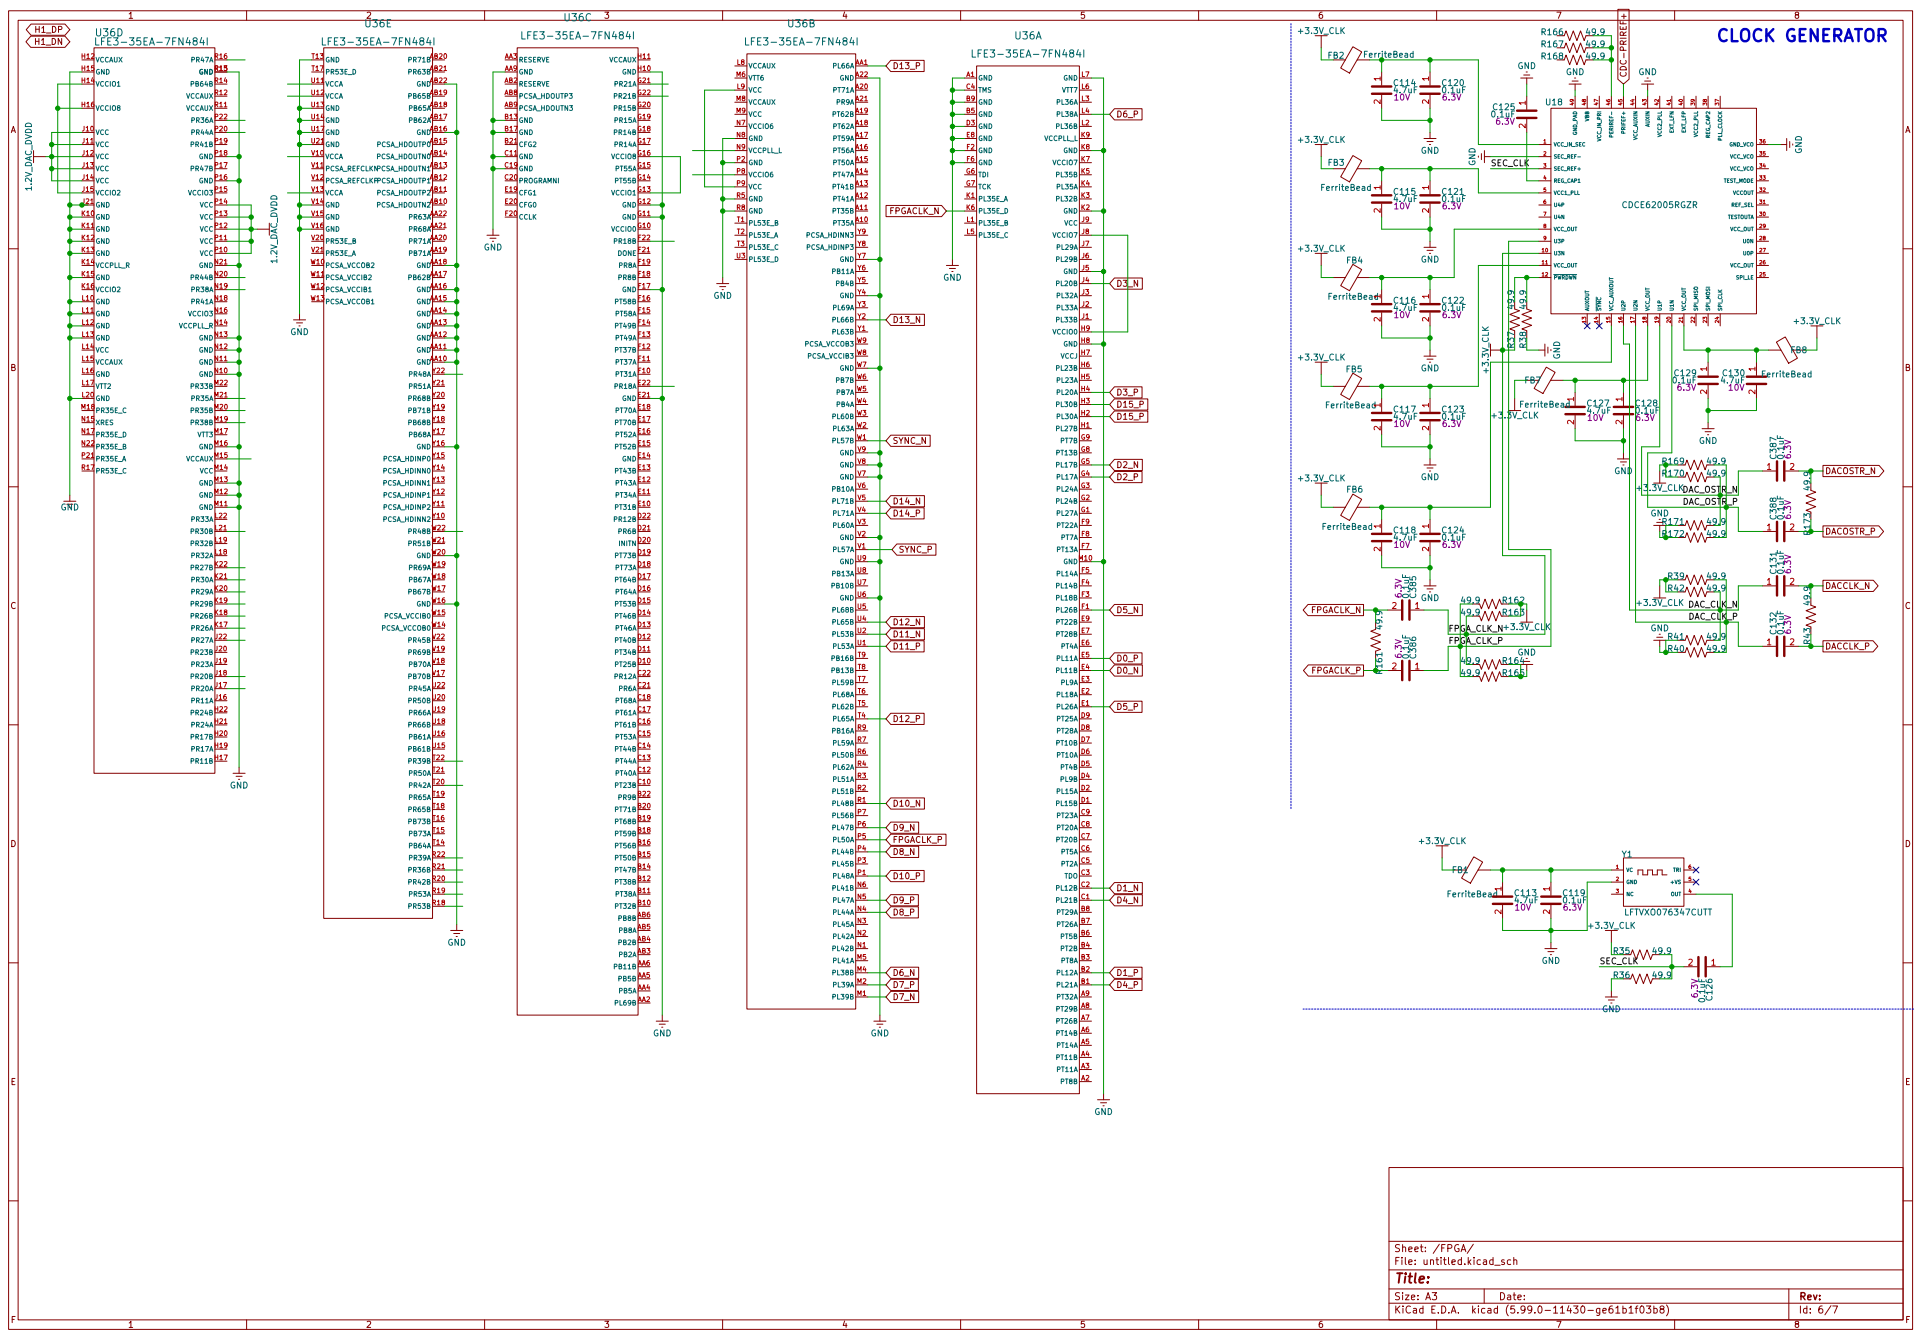
[picture p24: page 6]

VCC J10 VCC J11 VCC J12 VCC J13 VCC J14 VCCIO2 J15

File: untitled.kicad_sch Sheet: /FPGA/

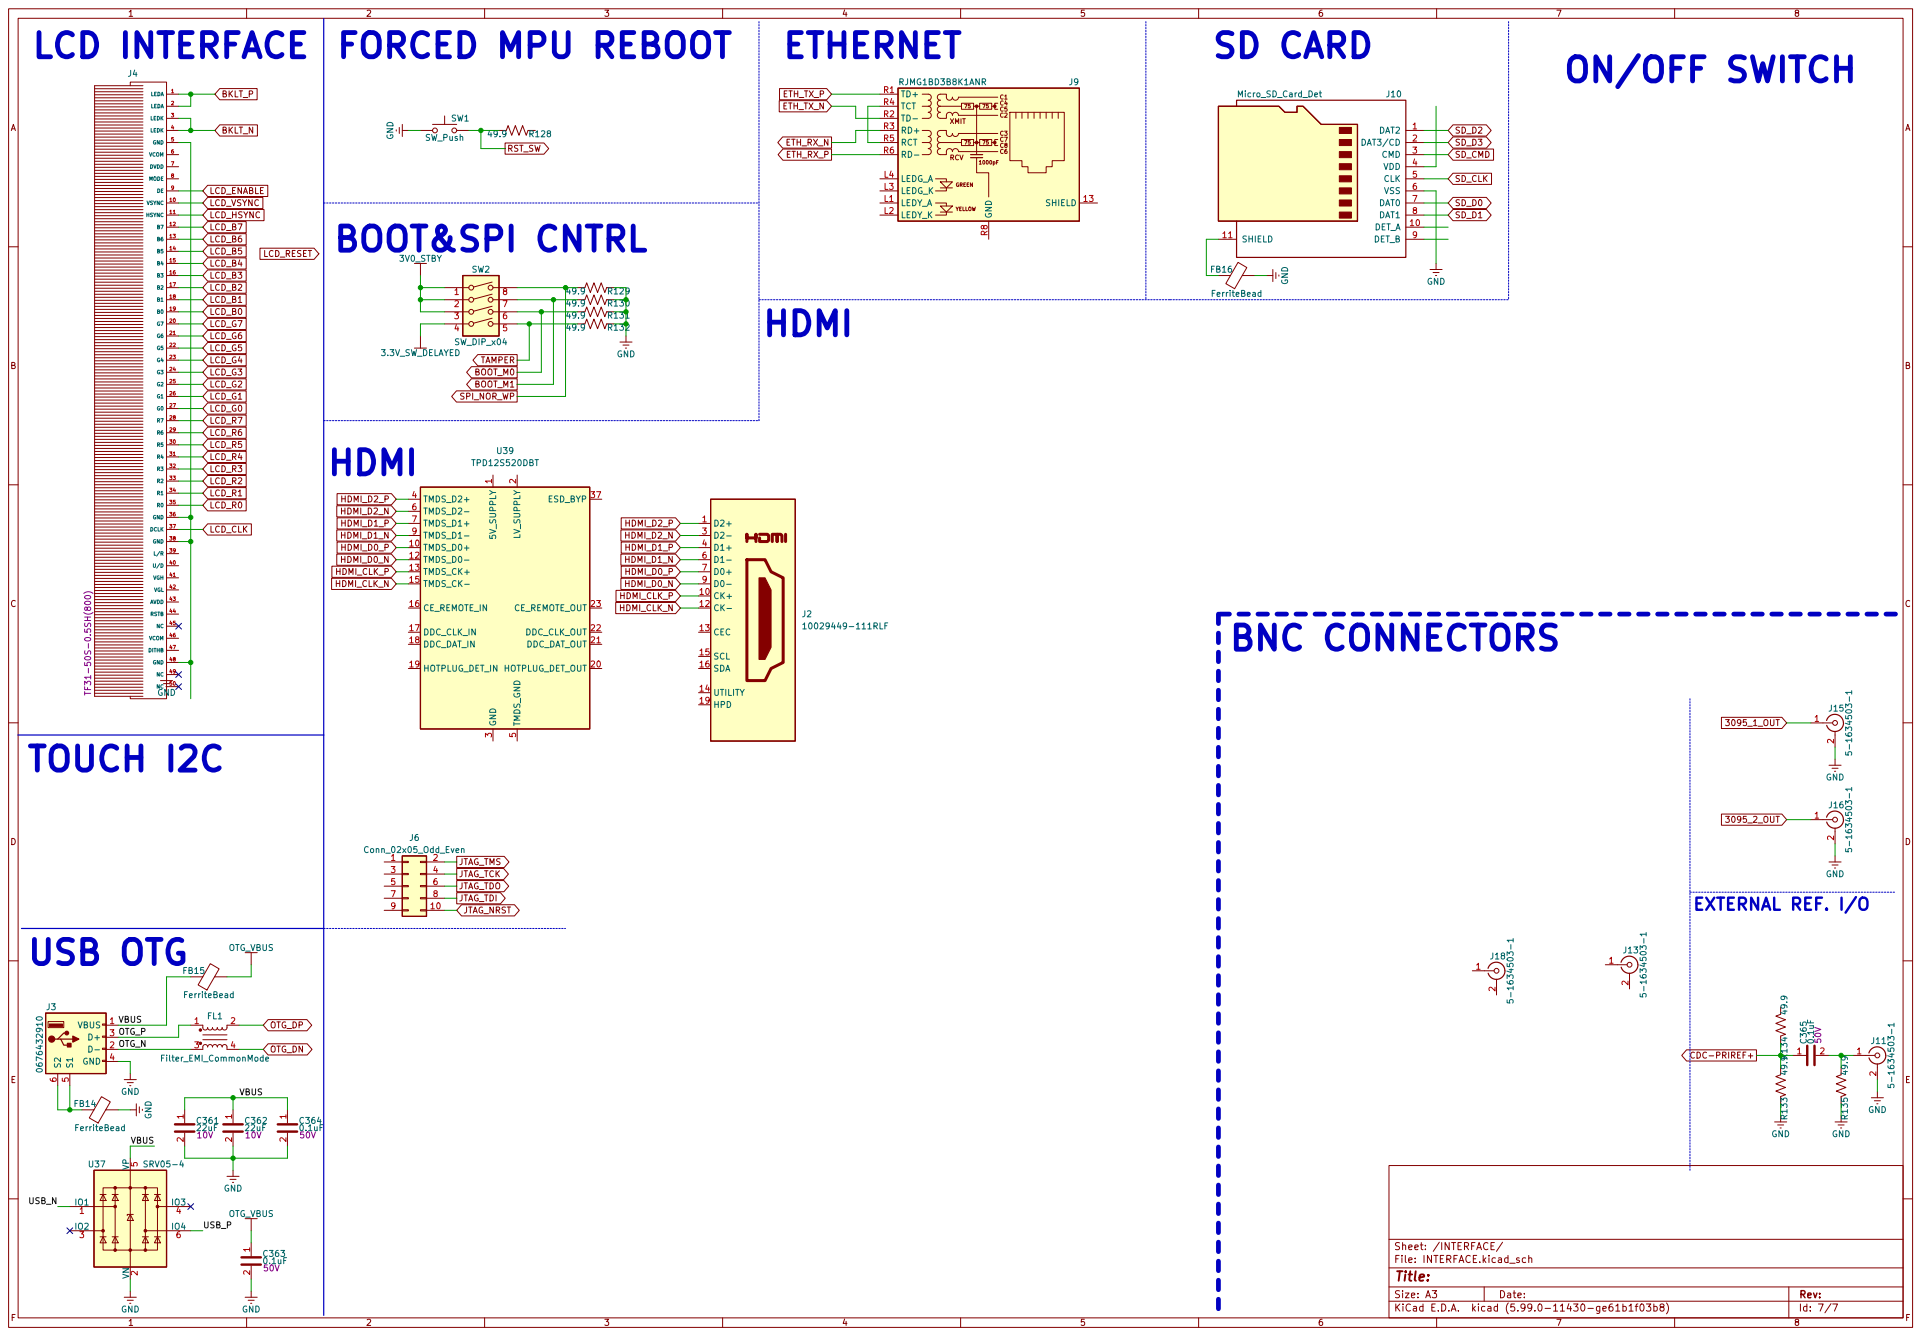
[picture p25: page 7]

File: INTERFACE.kicad_sch Sheet: /INTERFACE/
