Anastien/AWG1000/hardware/01-ECAD/02-Documentation/data gen/TSW1406_B_SCH.pdf

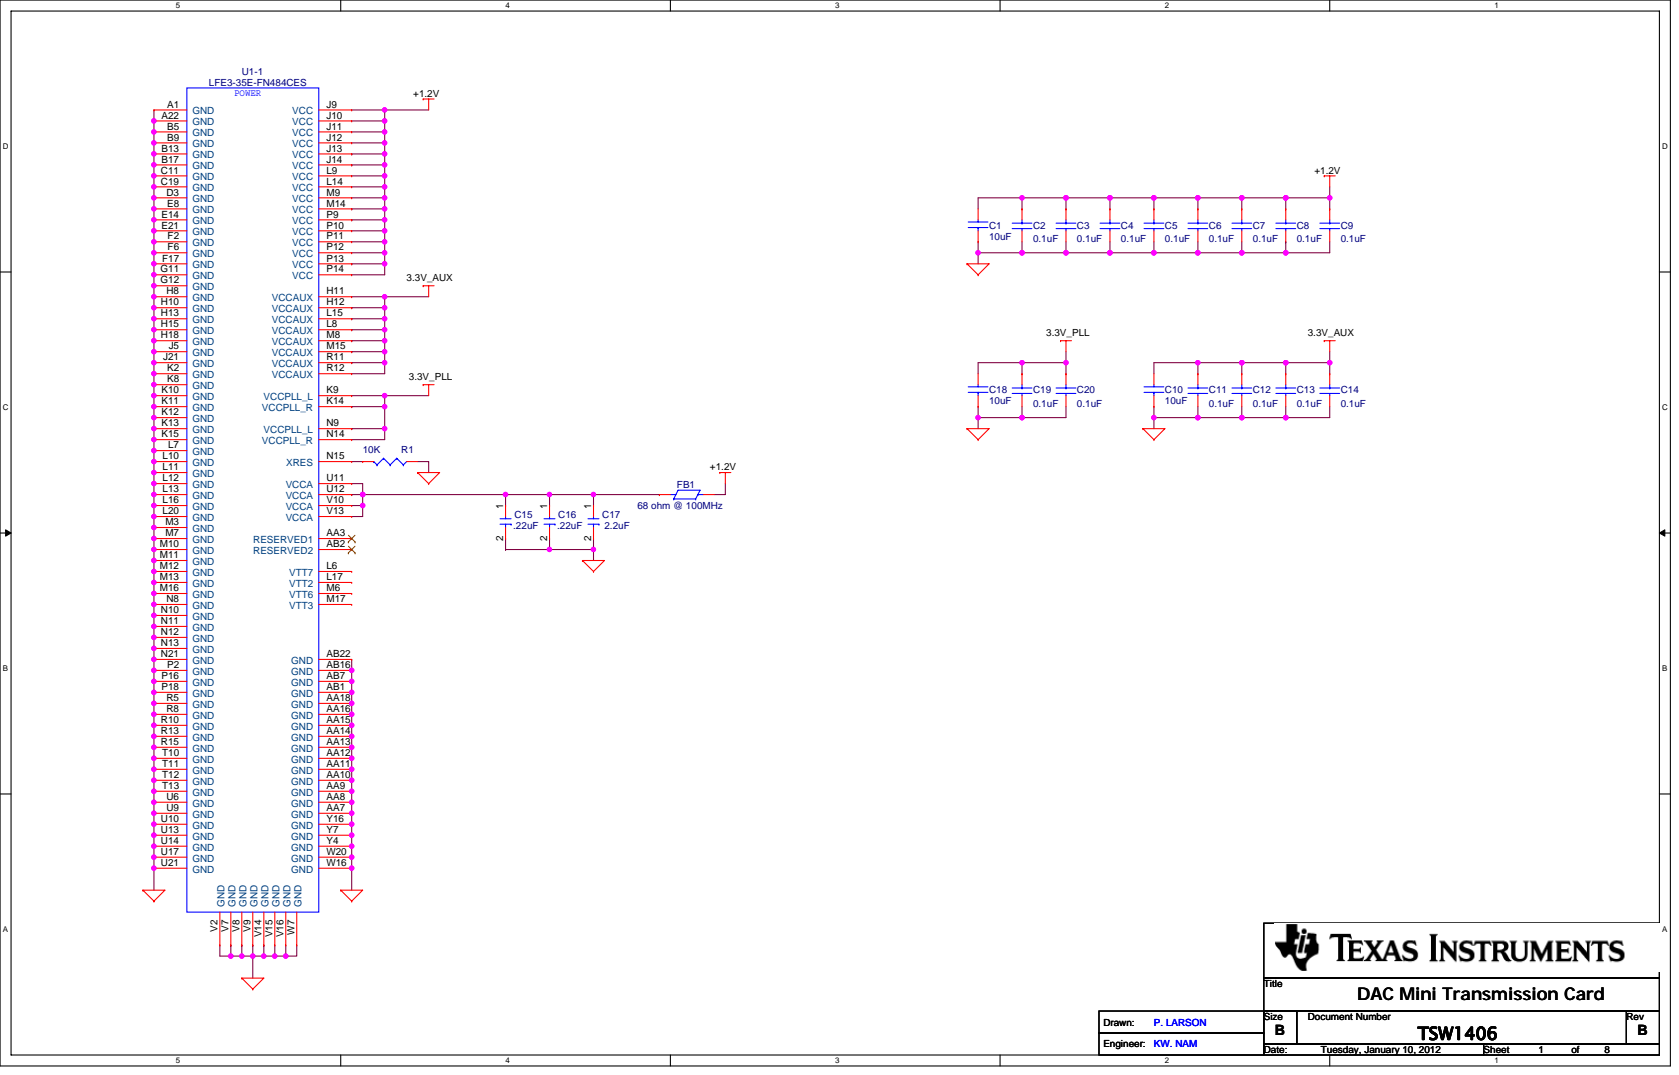
[picture p26: page 1]

DAC Mini Transmission Card
TSW1406

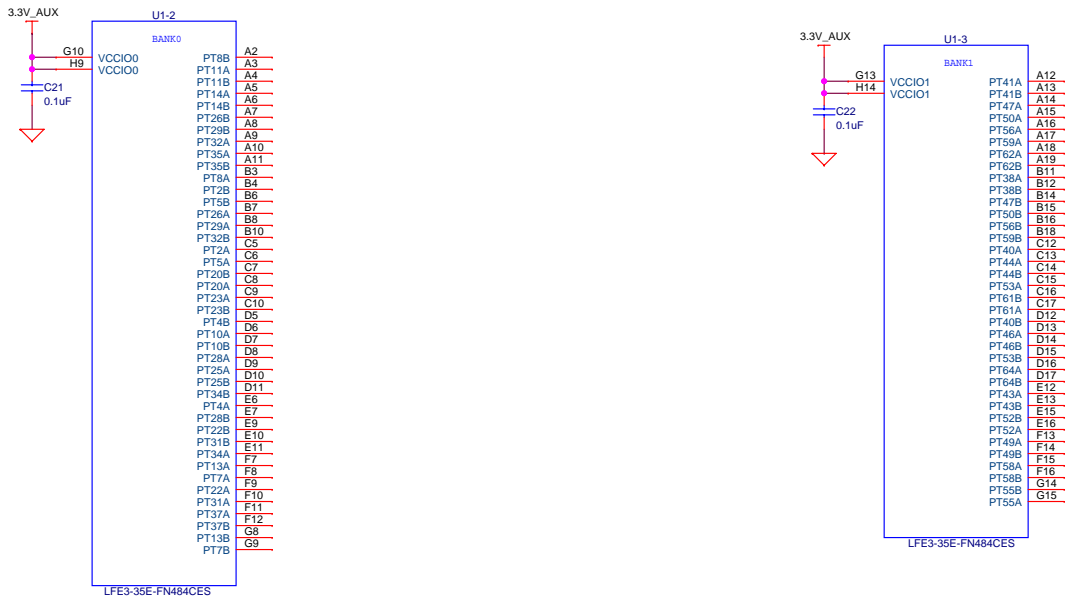
[picture p27: page 2]

DAC Mini Transmission Card

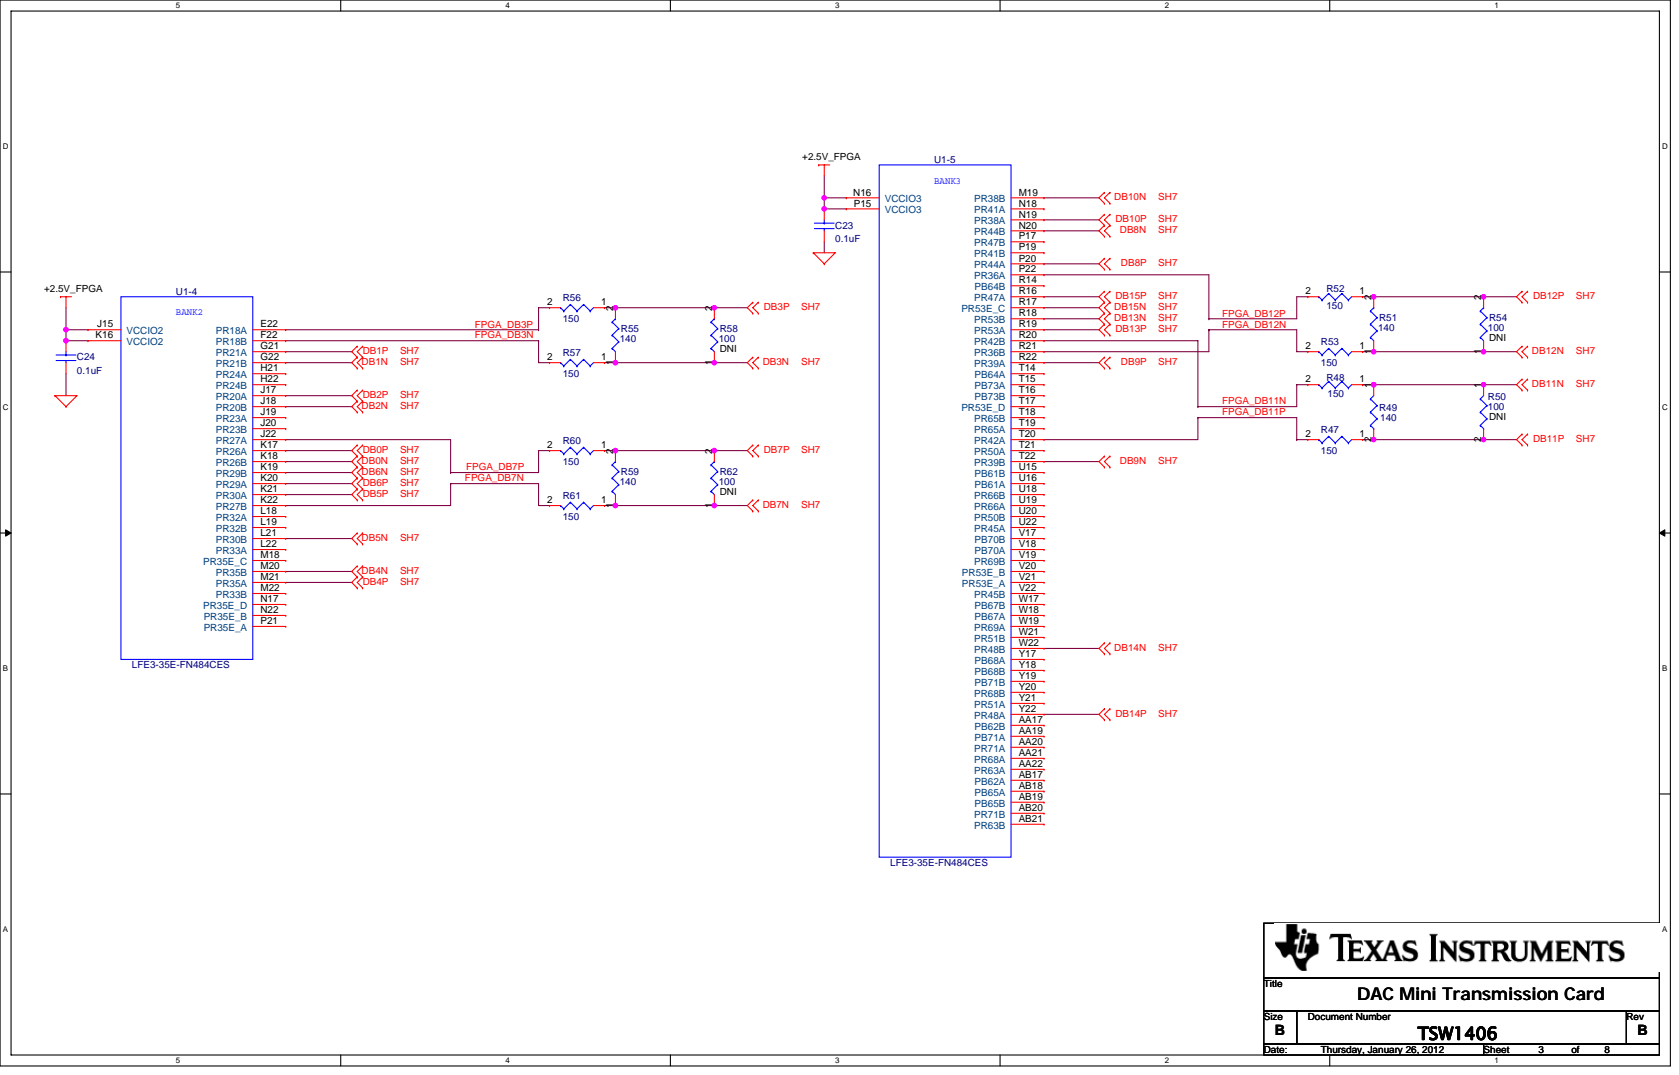
[picture p28: page 3]

DAC Mini Transmission Card

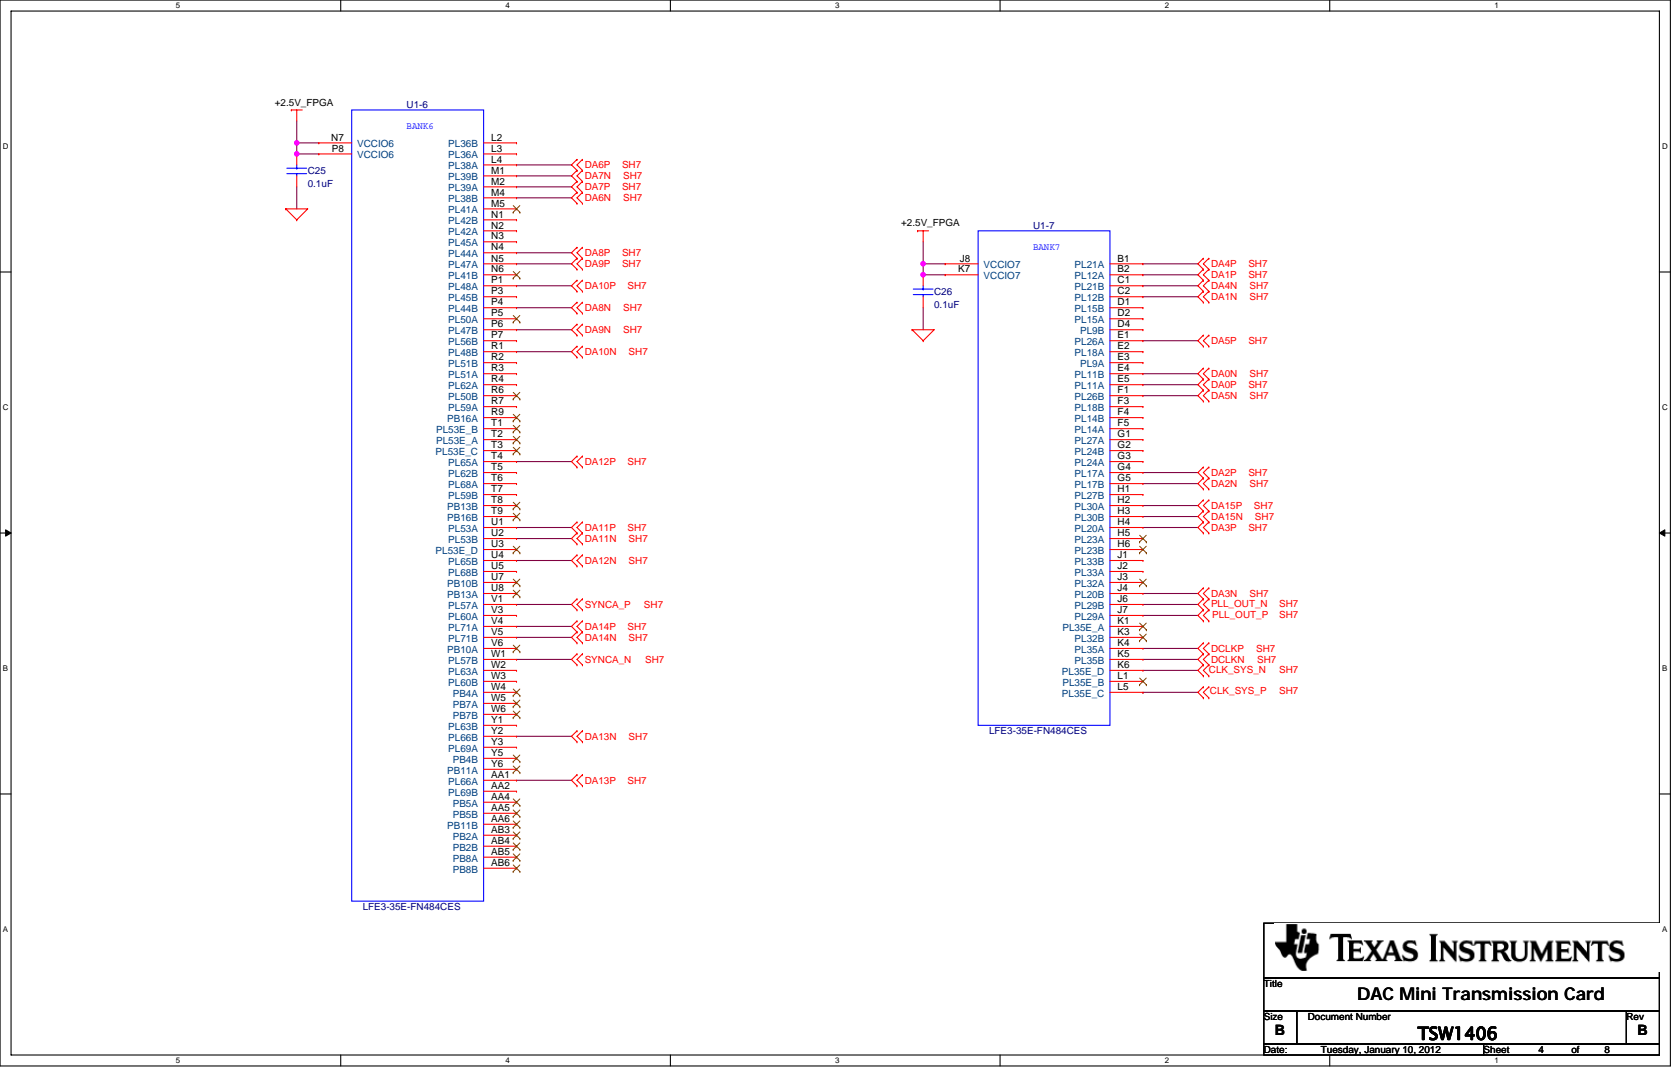
[picture p29: page 4]

DAC Mini Transmission Card

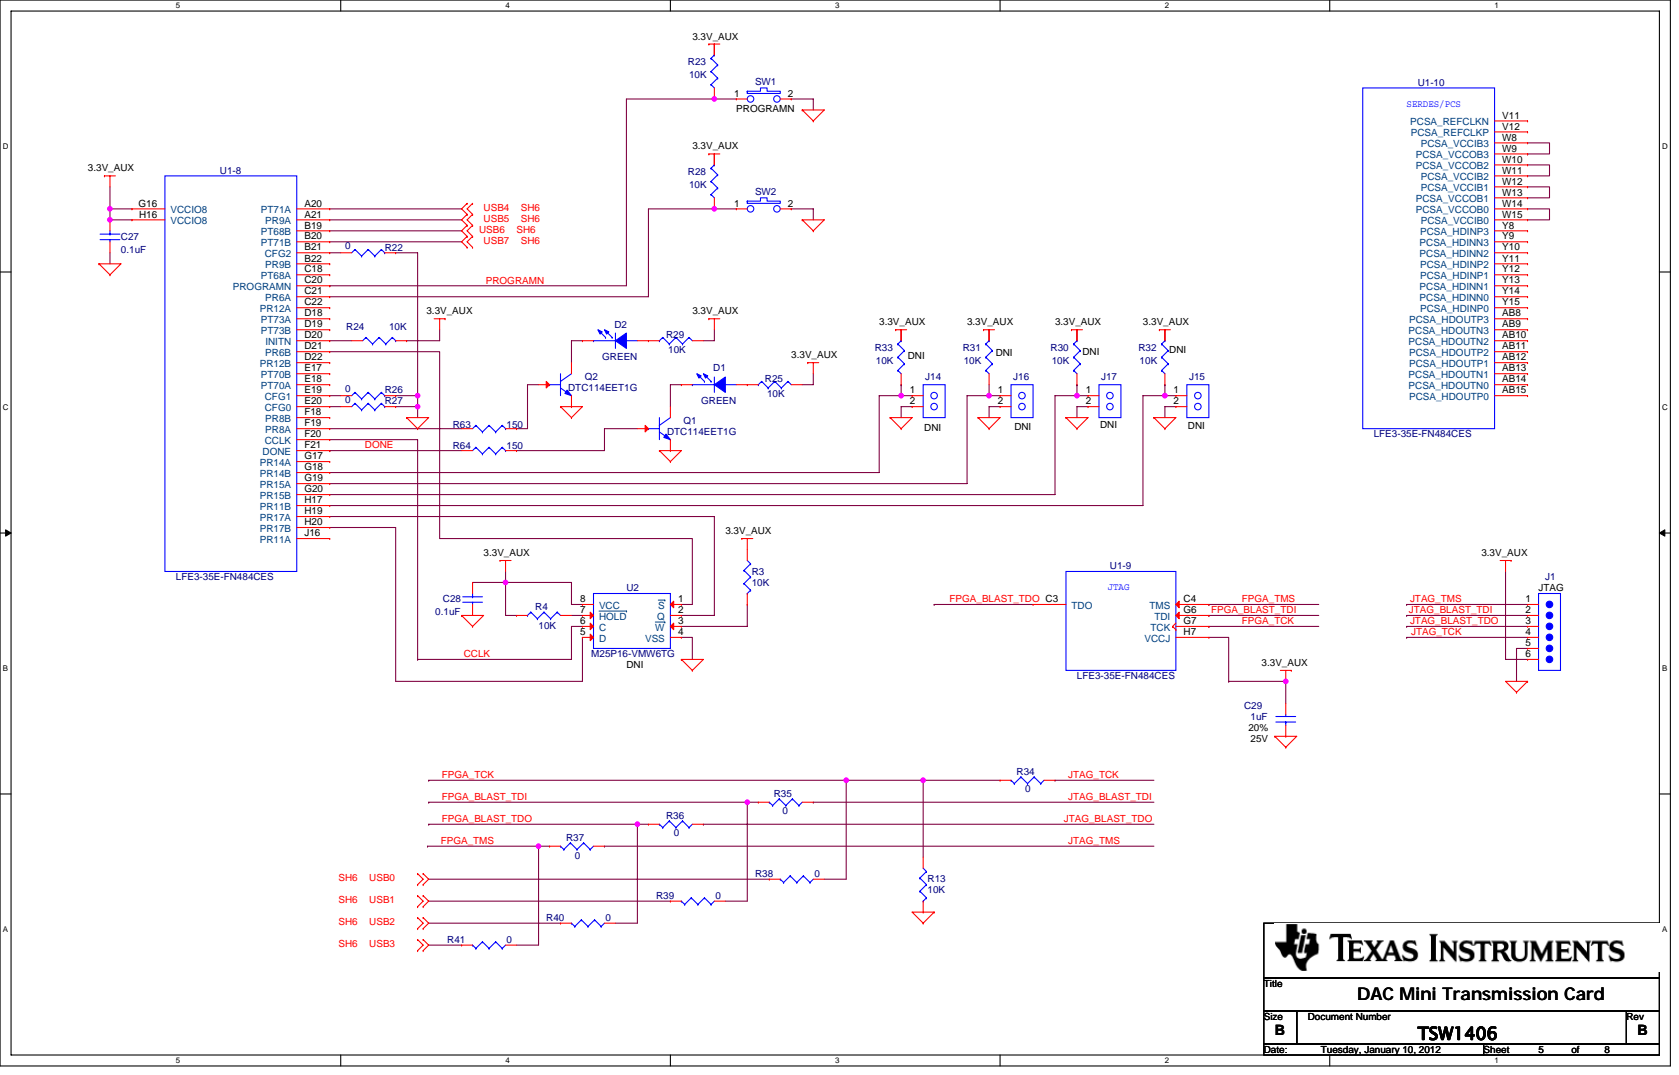
[picture p30: page 5]

DAC Mini Transmission Card

TSW1406 | B

Tuesday, January 10, 2012 Tuesday, January 10, 2012 Tuesday, January 10, 2012 | 5 5 5 8 8 8

# USB

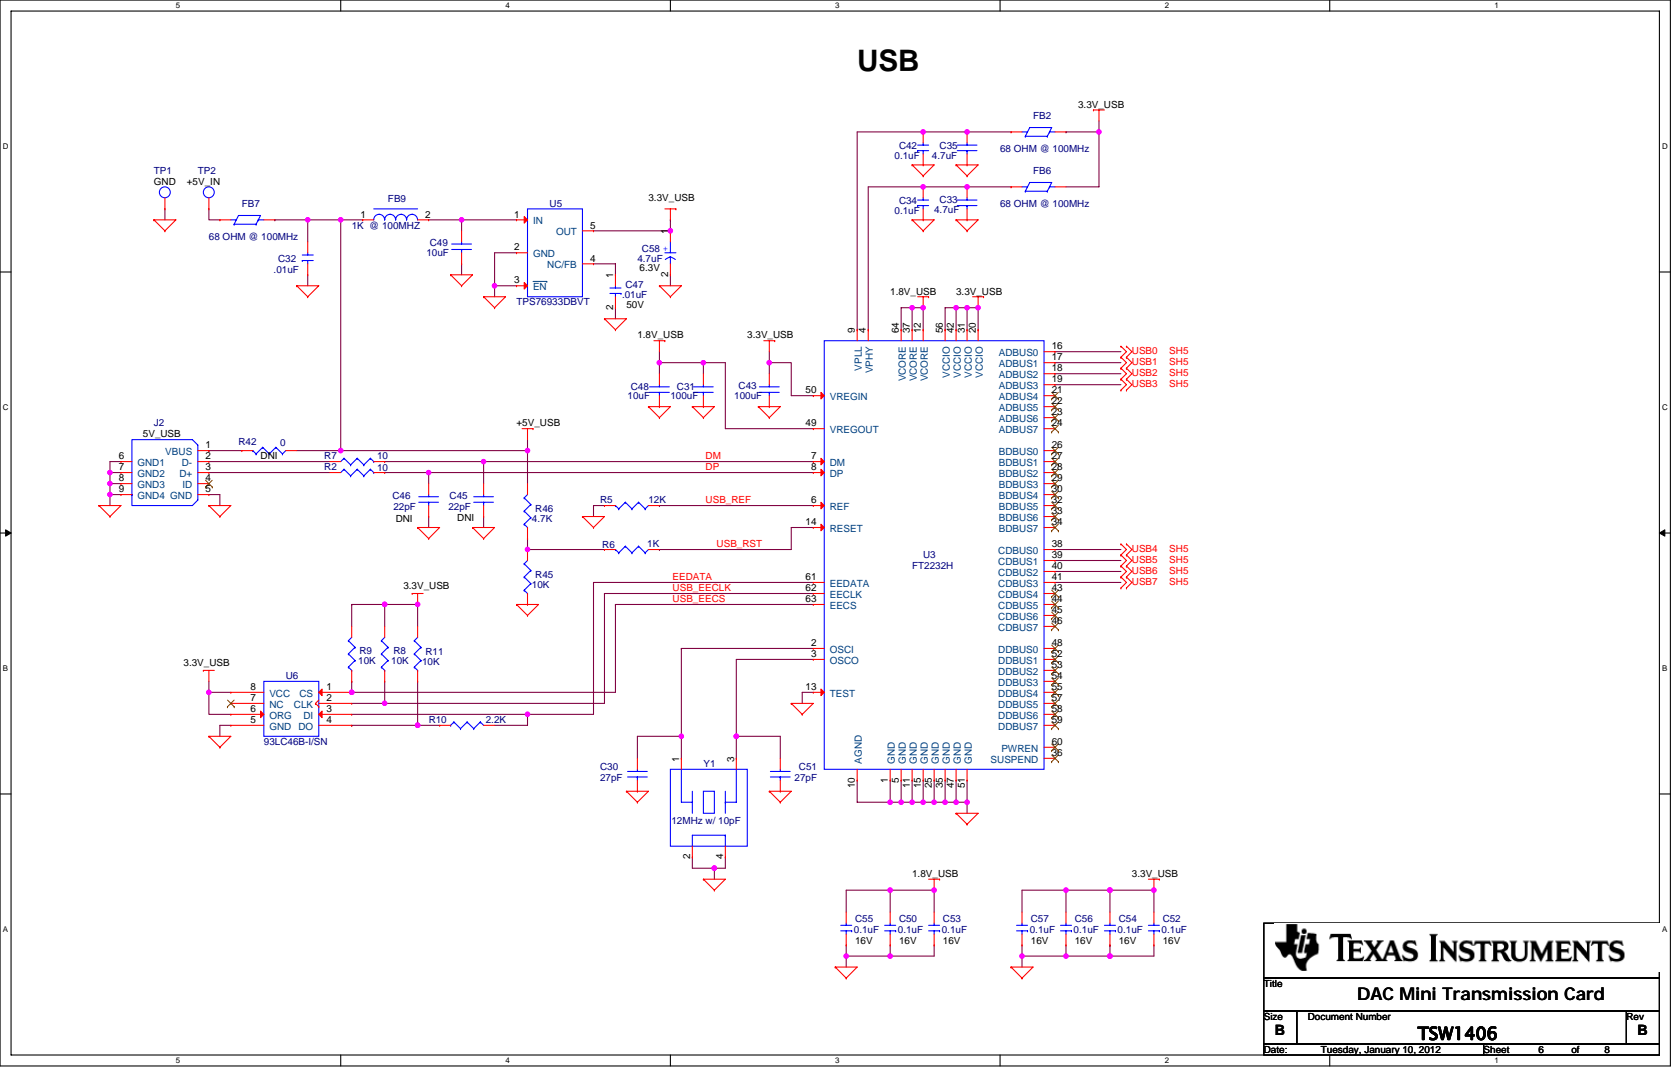
[picture p31: page 6]

DAC Mini Transmission Card

# DAC Interface

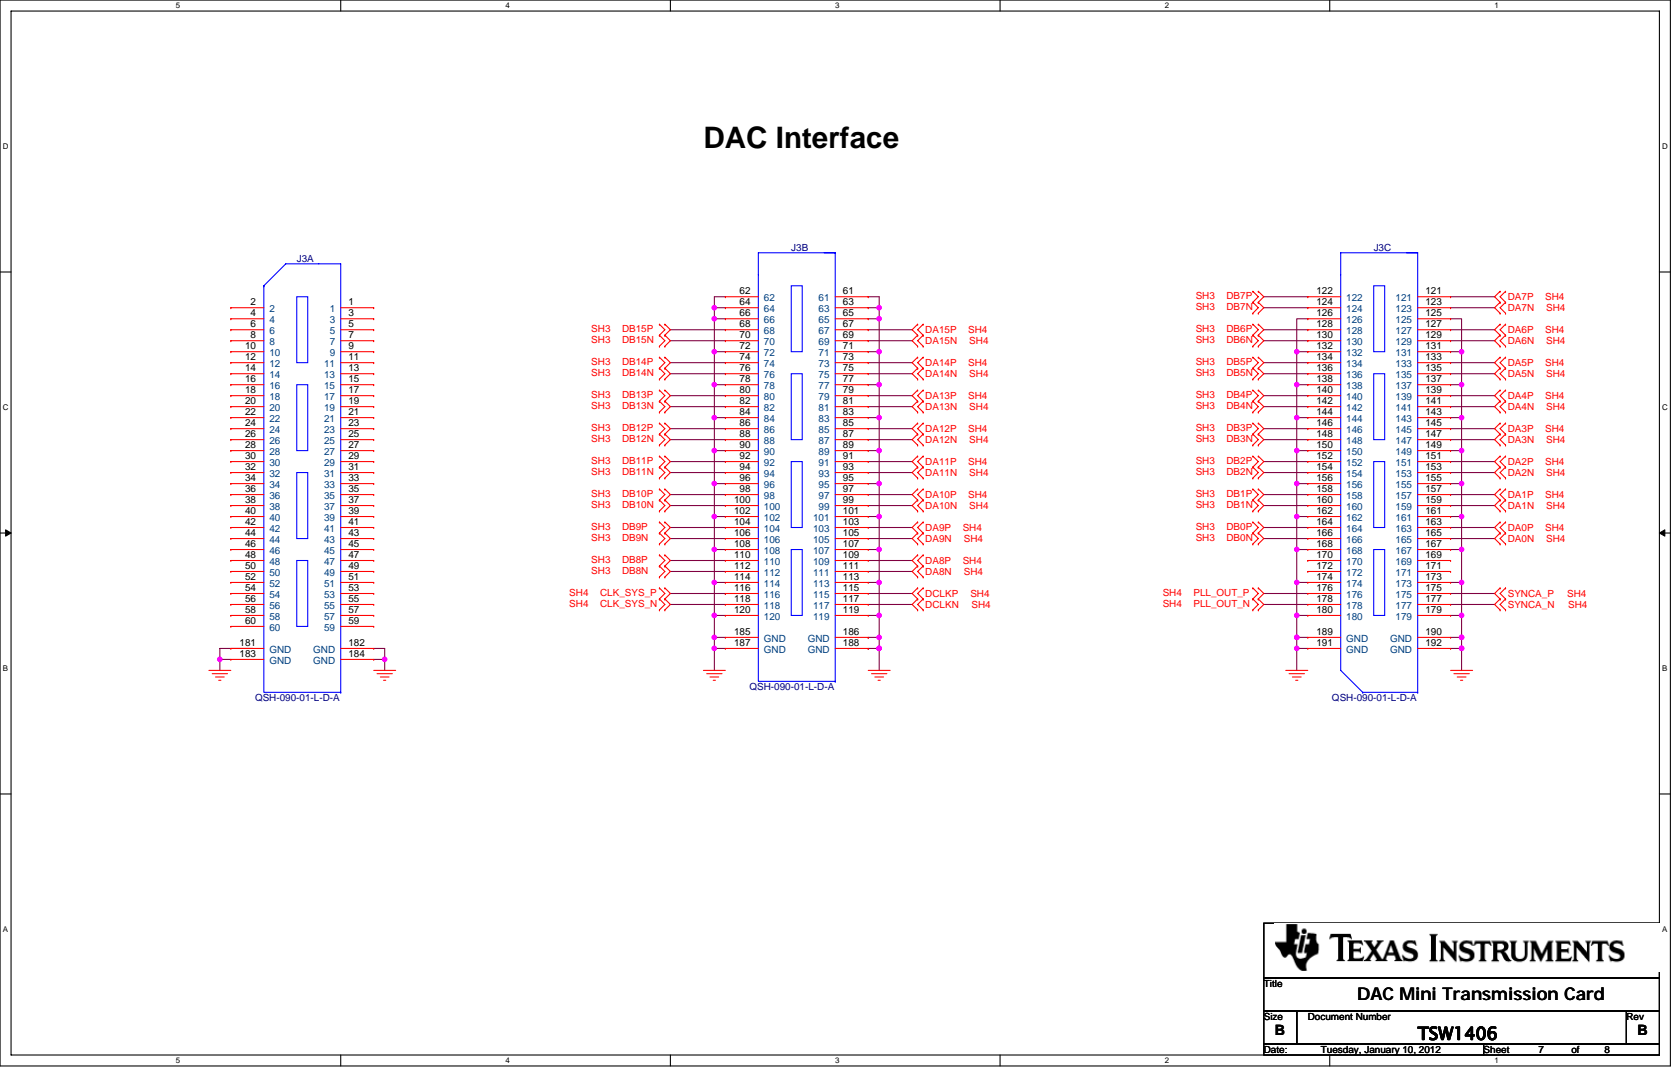
[picture p32: page 7]
SYNCA_P SH4; SYNCA_N; DCLKP SH4 DCLKN SH4; SH4 PLL_OUT_P; SH4 PLL_OUT_N; SH4 CLK_SYS_N; SH4 CLK_SYS_P; Title; Tuesday, January 10, 2012; QSH-090-01-L-D-A; GND 182 GND 181 GND 184 GND 183; GND 190 GND 189 GND 192 GND 191; GND; 186 GND 185; 188 GND 187

DAC Mini Transmission Card

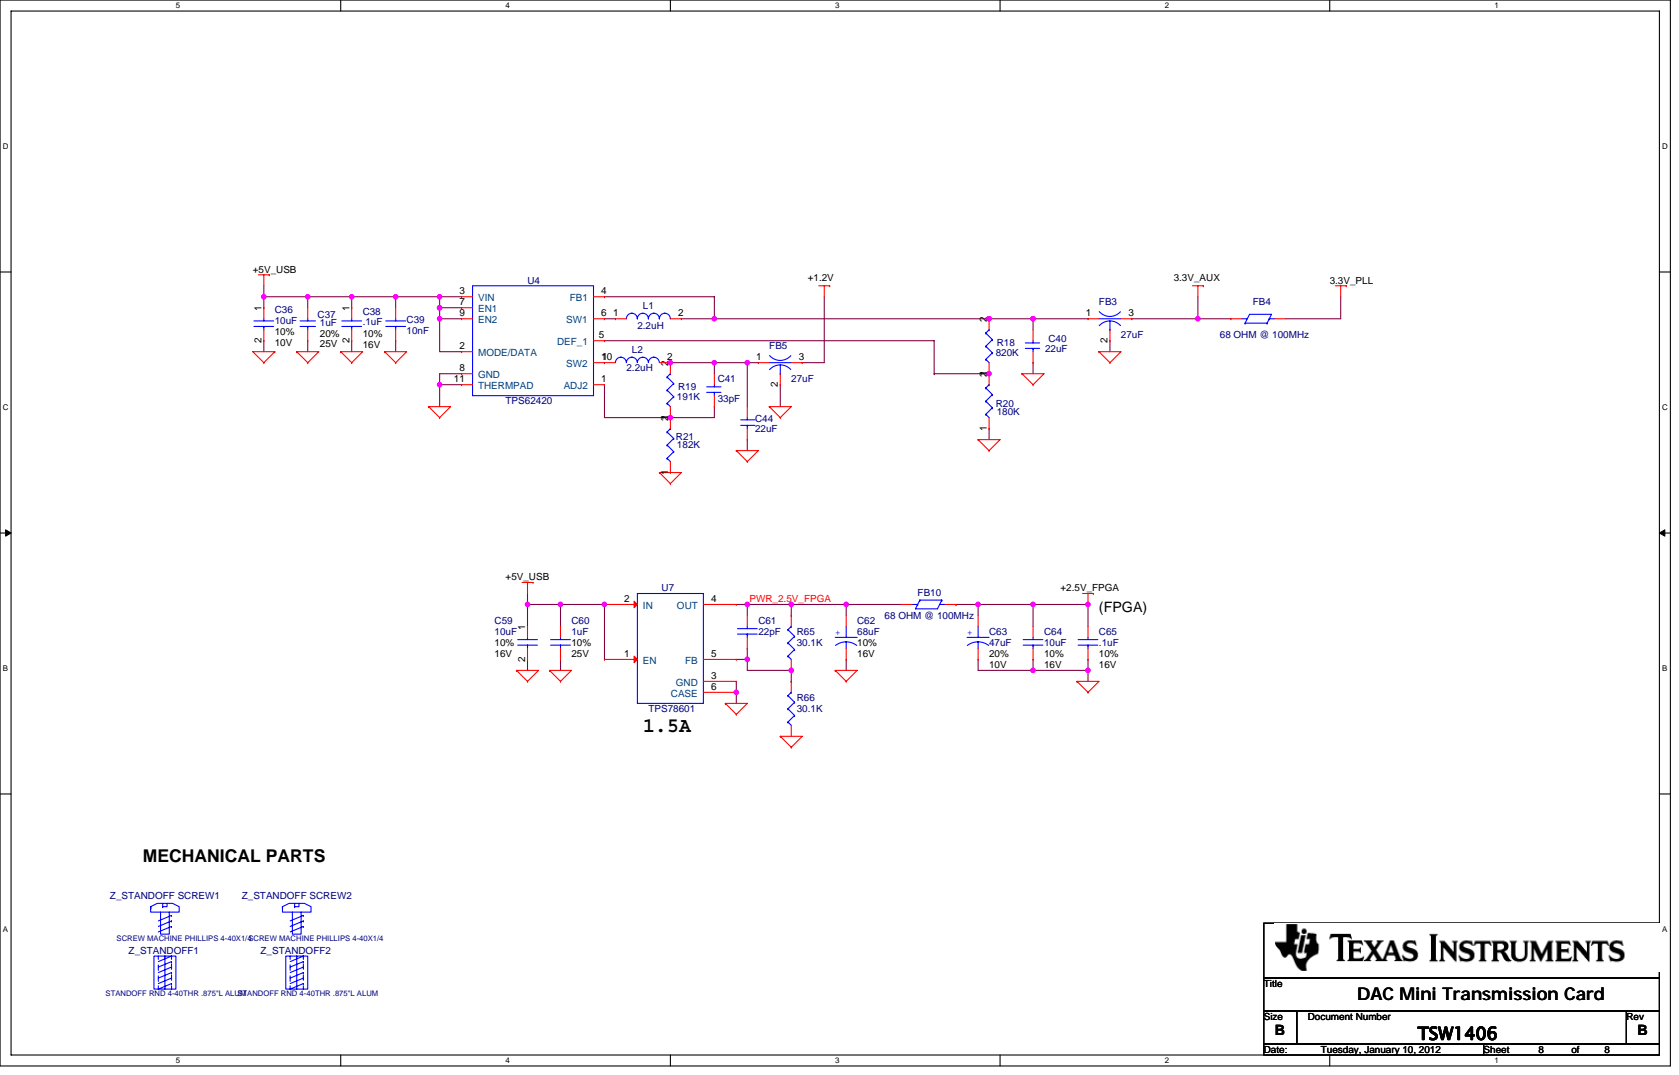
[picture p33: page 8]

DAC Mini Transmission Card
