Anastien/AWG1000/hardware/01-ECAD/02-Documentation/TSW14J56EVM-DesignPkg_E/TSW14J56-SCH_E.pdf

# ARRIA V I/O

# SHEETS 5-12

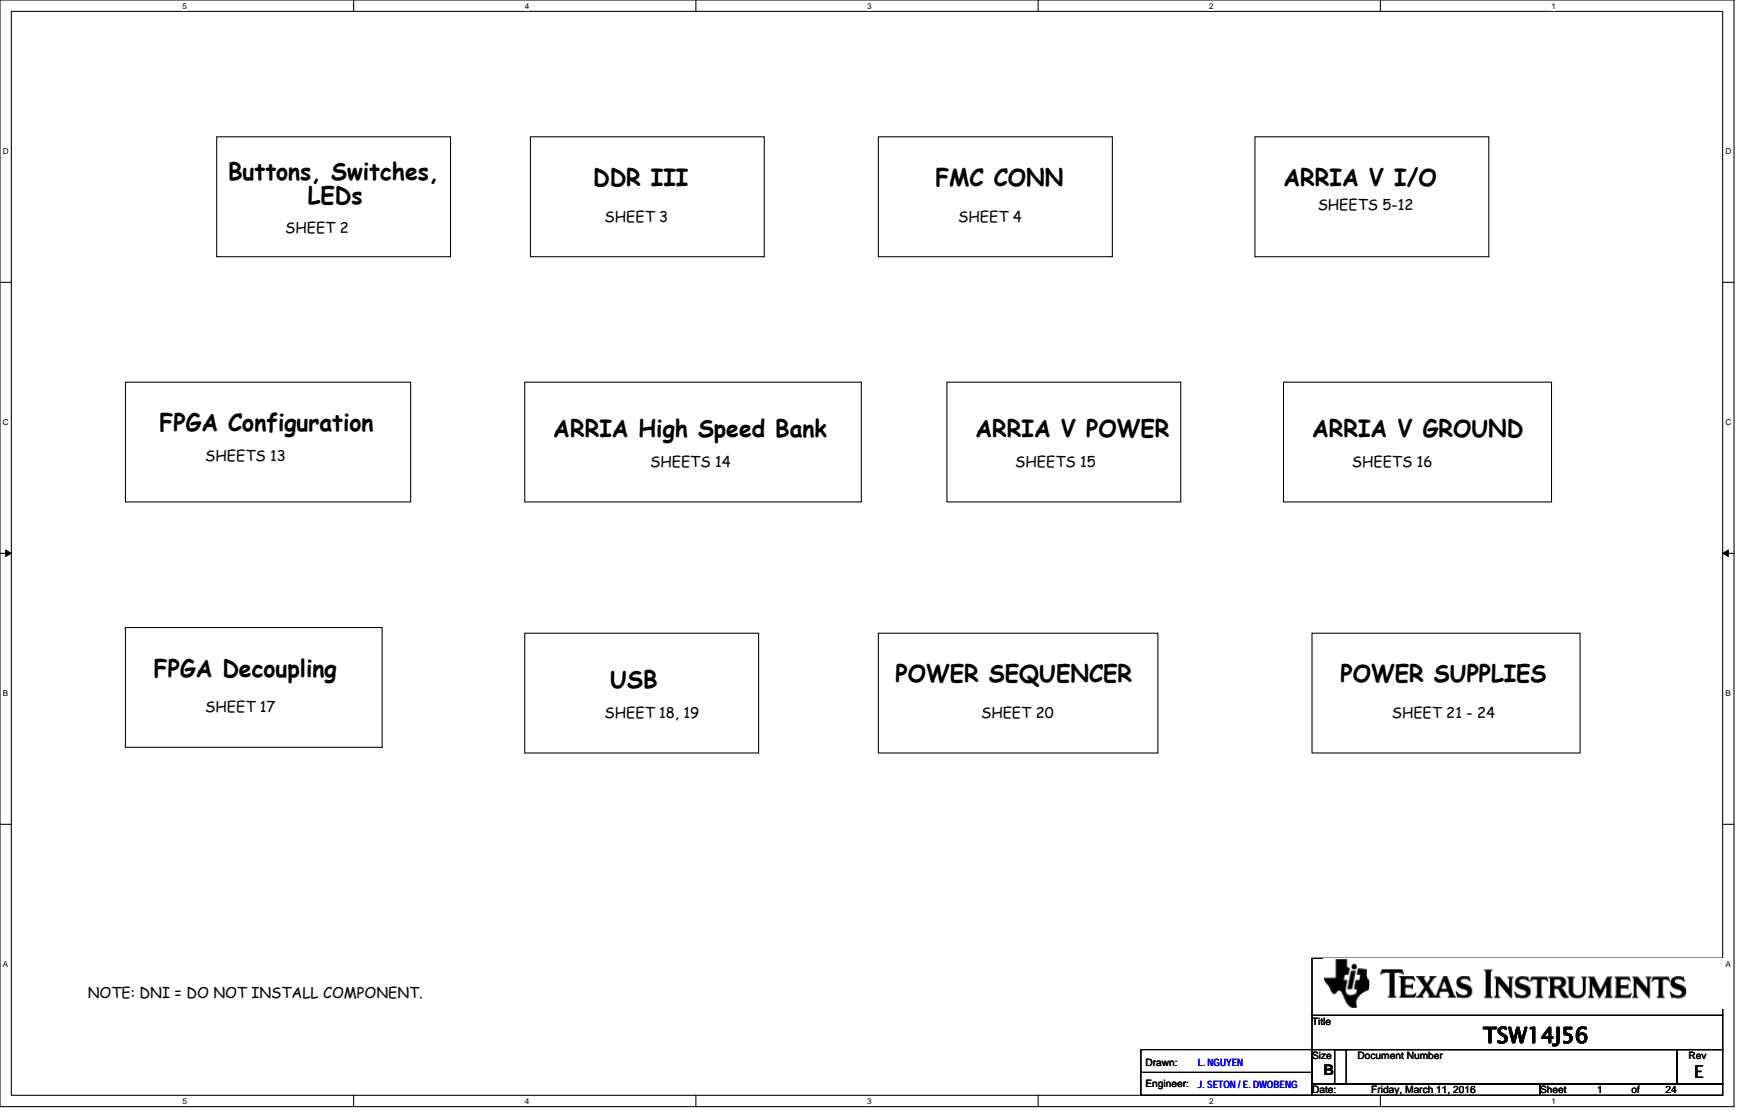
[picture p34: page 1]
Buttons, Switches, LEDs; SHEET 2; DDR III; SHEET 3; FMC CONN; SHEET 4; FPGA Configuration; SHEETS 13; USB; SHEET 18, 19; POWER SEQUENCER; SHEET 20; POWER SUPPLIES; SHEET 21 - 24; ARRIA V POWER; SHEETS 15; SHEETS 14; ARRIA V GROUND; SHEETS 16; FPGA Decoupling; SHEET 17; L. NGUYEN; Title; Size; Document Number; Rev; TSW14J56

ARRIA High Speed Bank

NOTE: DNI = DO NOT INSTALL COMPONENT.

Drawn:
Engineer: J. SETON / E. DWOBENG

Date: Date: Date: Friday, March 11, 2016 Friday, March 11, 2016 Friday, March 11, 2016 | Sheet Sheet Sheet 1 1 1 of of of 24 24 24

# Buttons, Switches, LEDs

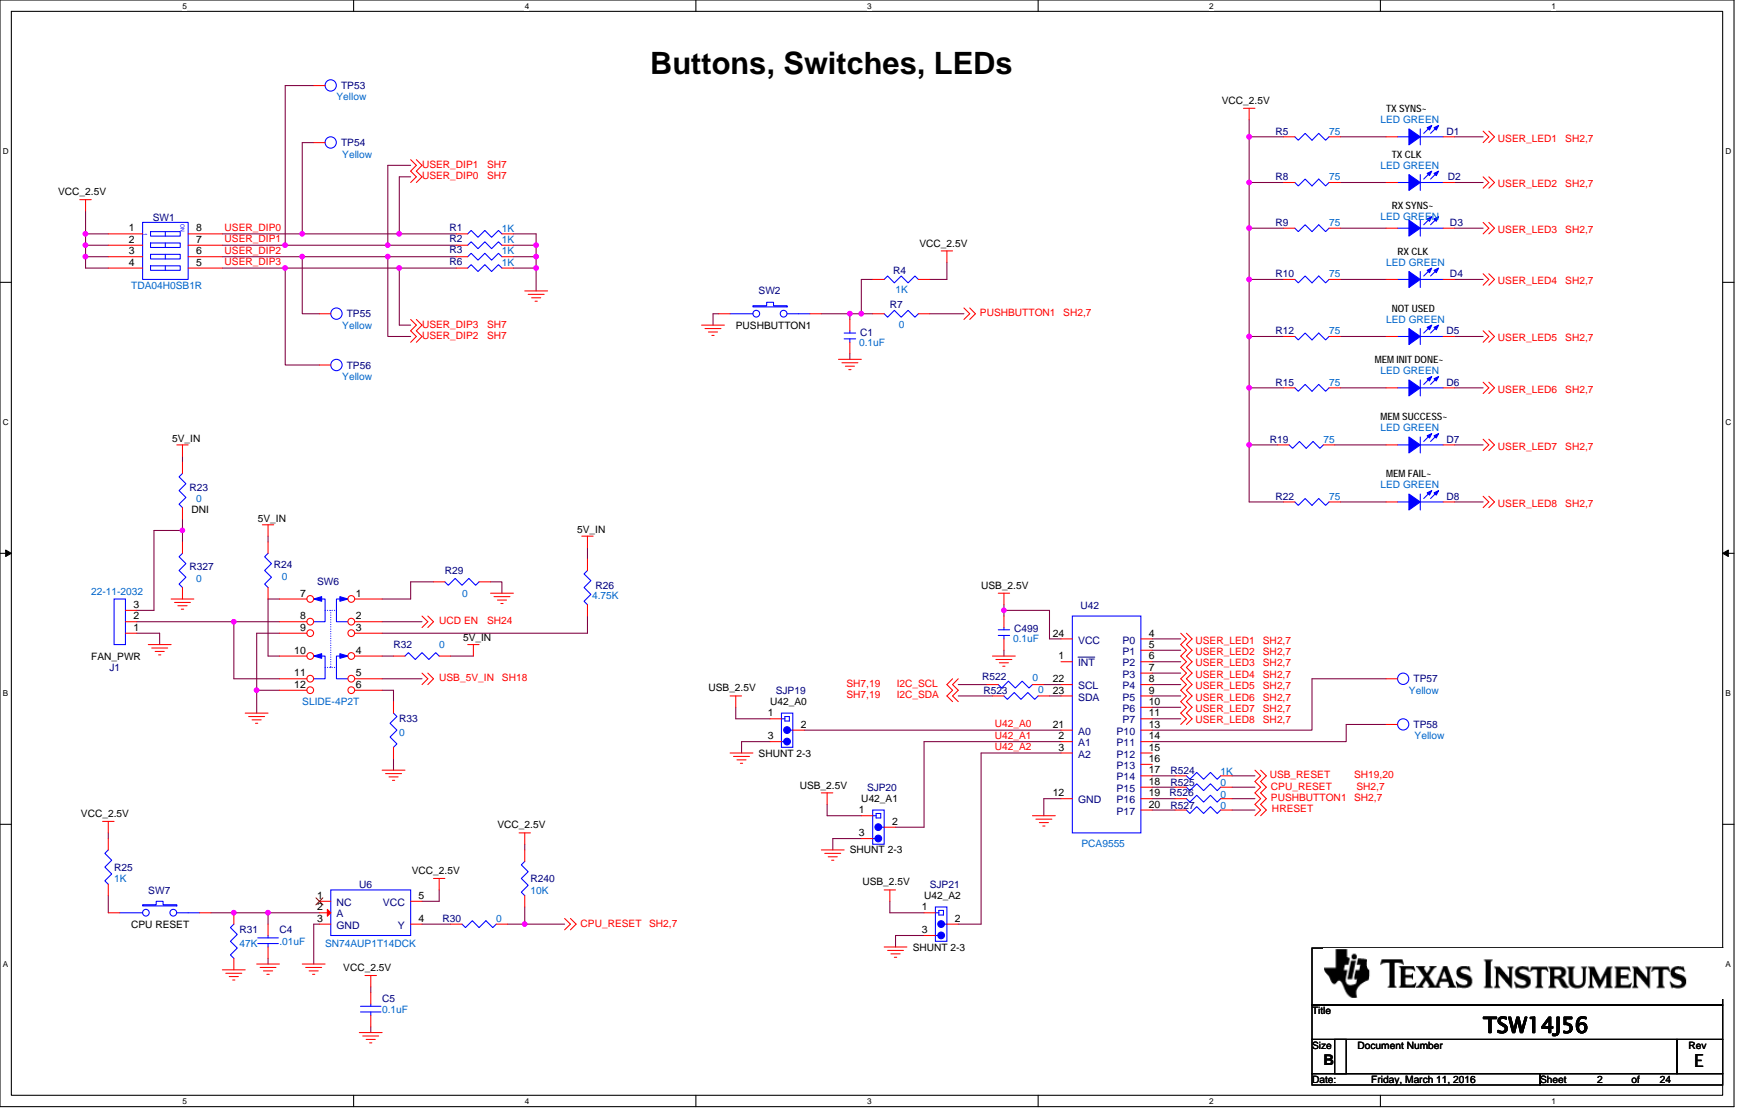
[picture p35: page 2]

2 | 7 USER_DIP1
3 | 6 USER_DIP2
4 | 5 USER_DIP3

Size Size Size B B B | | Document Number Document Number Document Number | Rev Rev Rev E E E

Date: Date: Date: Friday, March 11, 2016 Friday, March 11, 2016 Friday, March 11, 2016 | Sheet Sheet Sheet 2 2 2 of of of 24 24 24

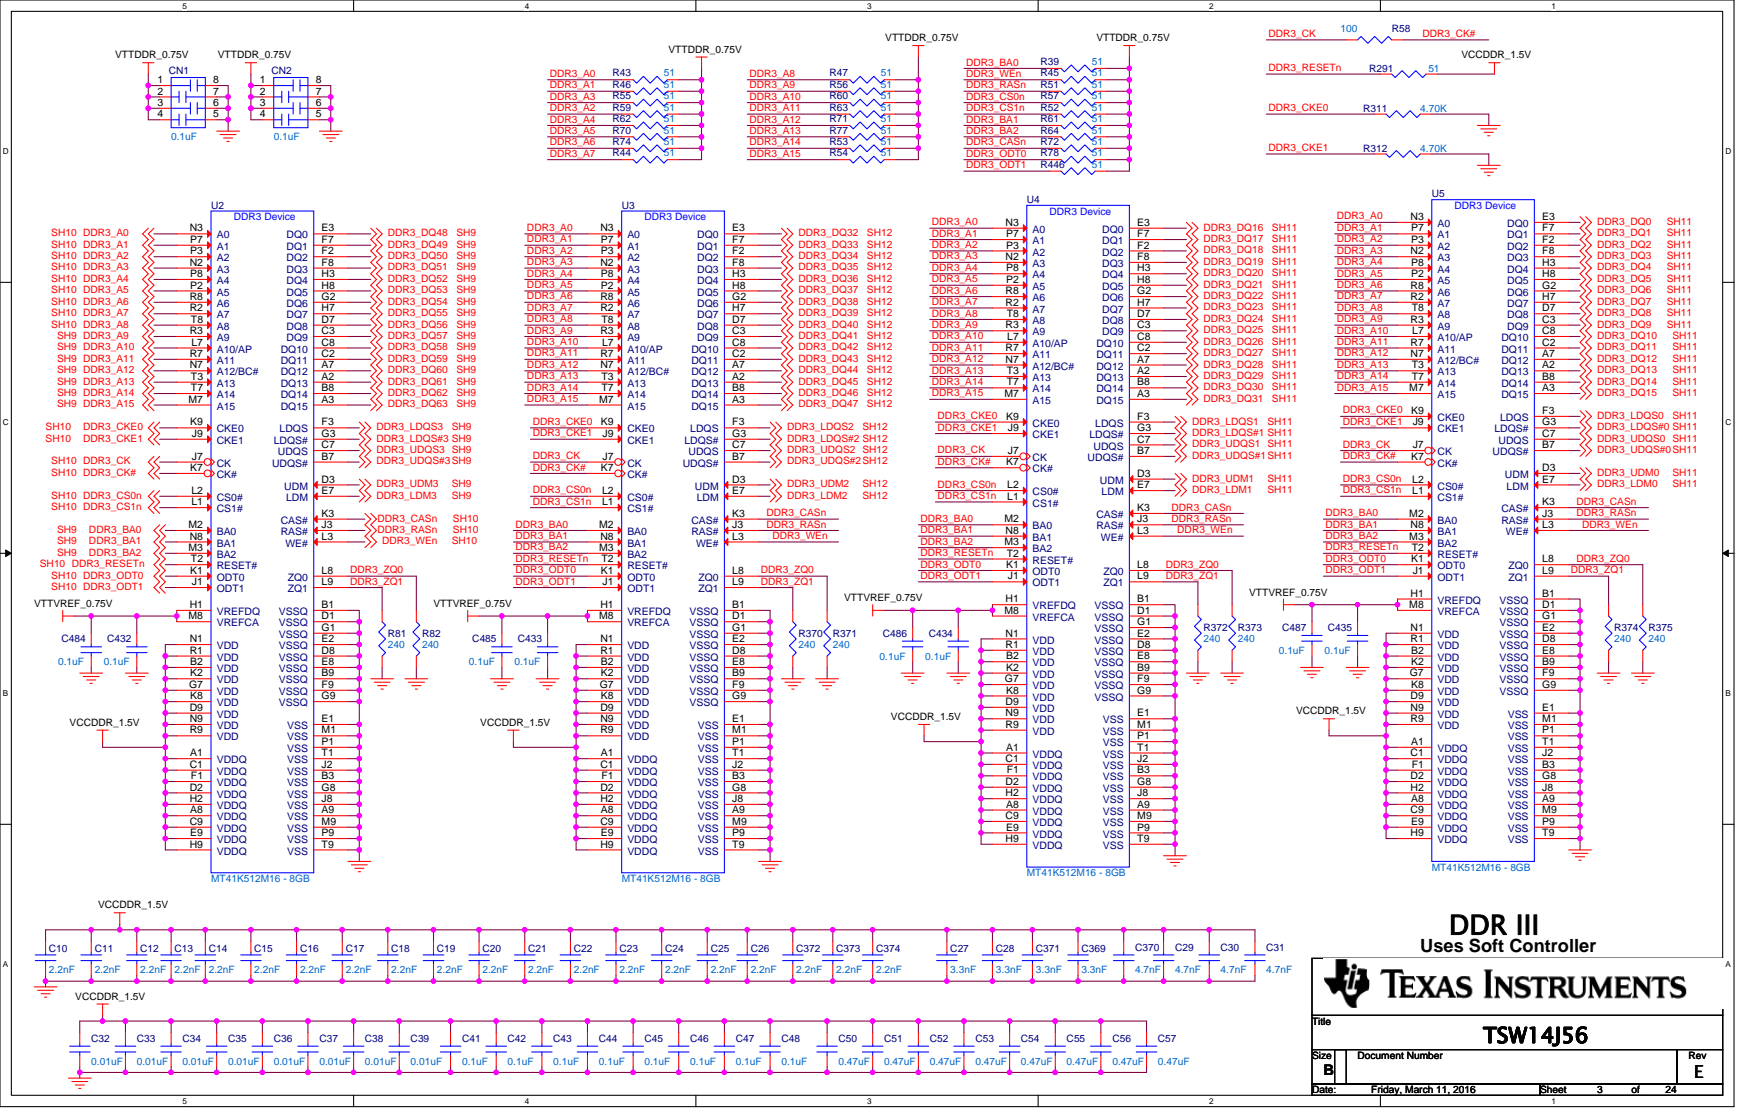
[picture p36: page 3]
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

Date: Date: Date: Friday, March 11, 2016 Friday, March 11, 2016 Friday, March 11, 2016 | Sheet Sheet Sheet of of of 24 3 24 3 24 3

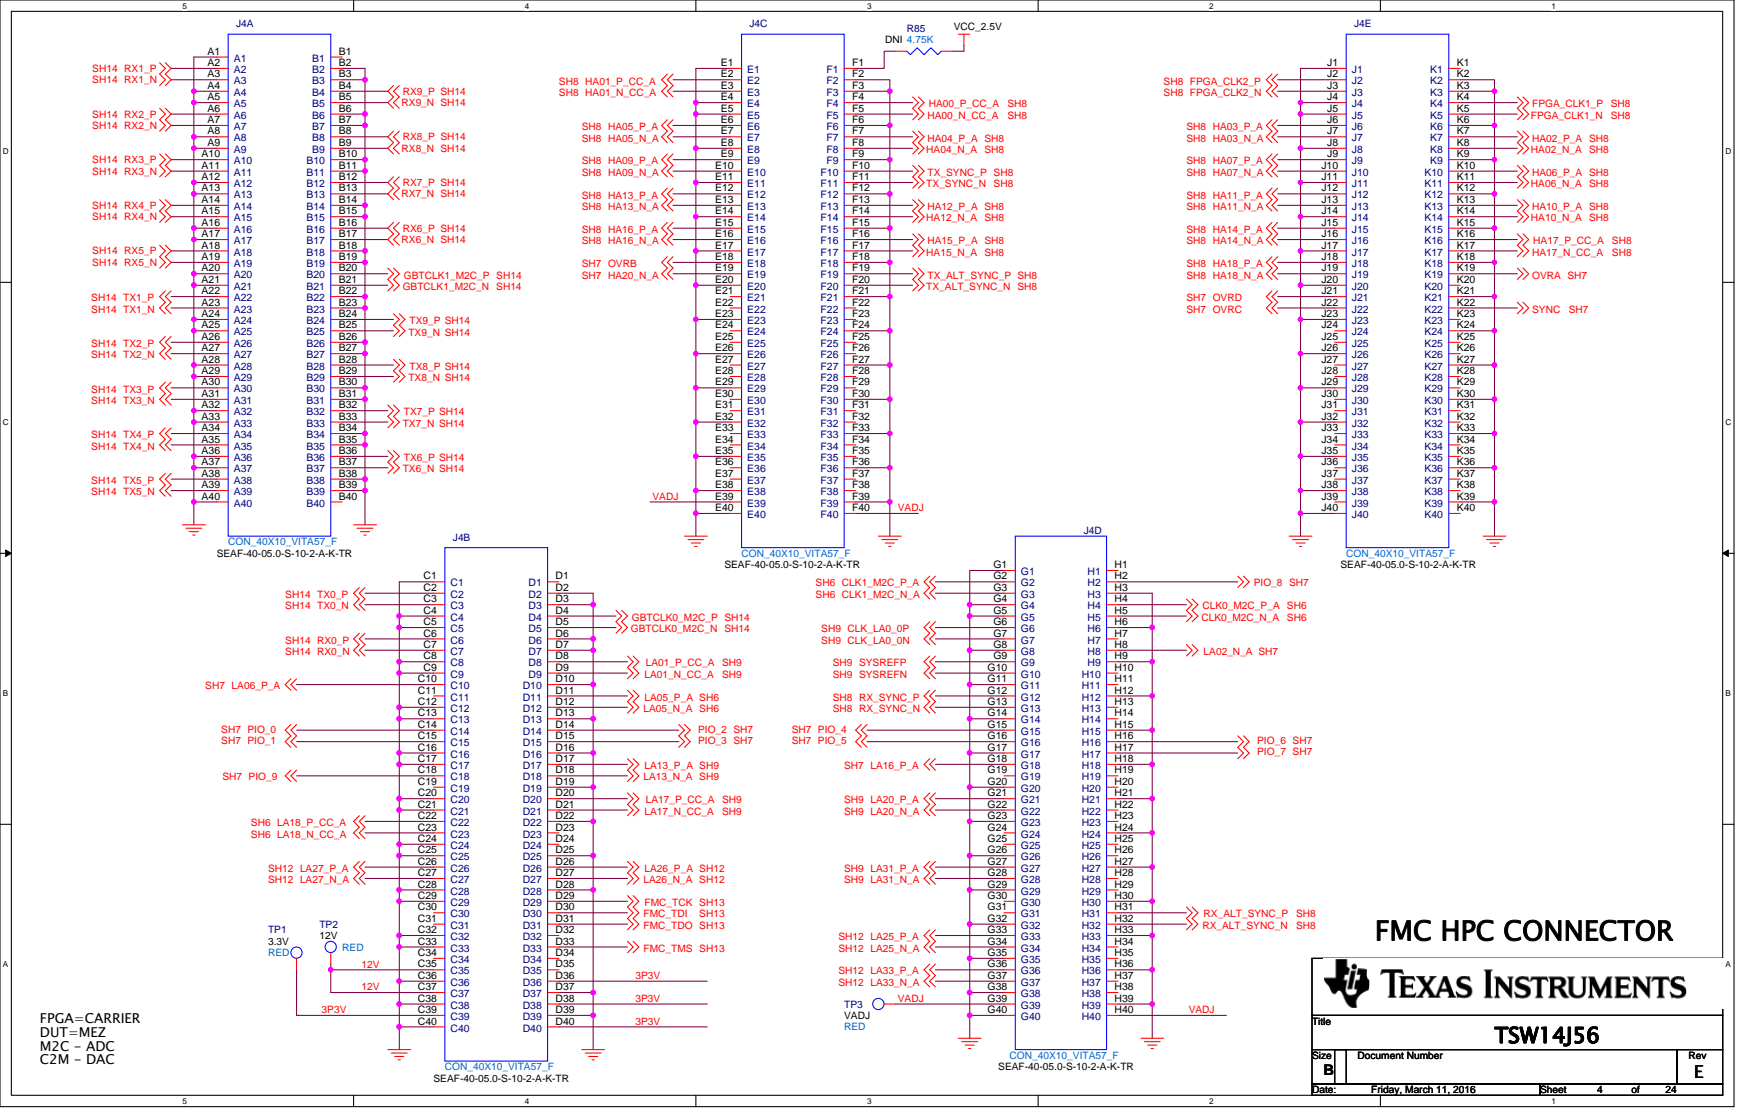
[picture p37: page 4]
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

Date: Date: Date: Friday, March 11, 2016 Friday, March 11, 2016 Friday, March 11, 2016 | Sheet Sheet Sheet 4 4 4 of of of 24 24 24

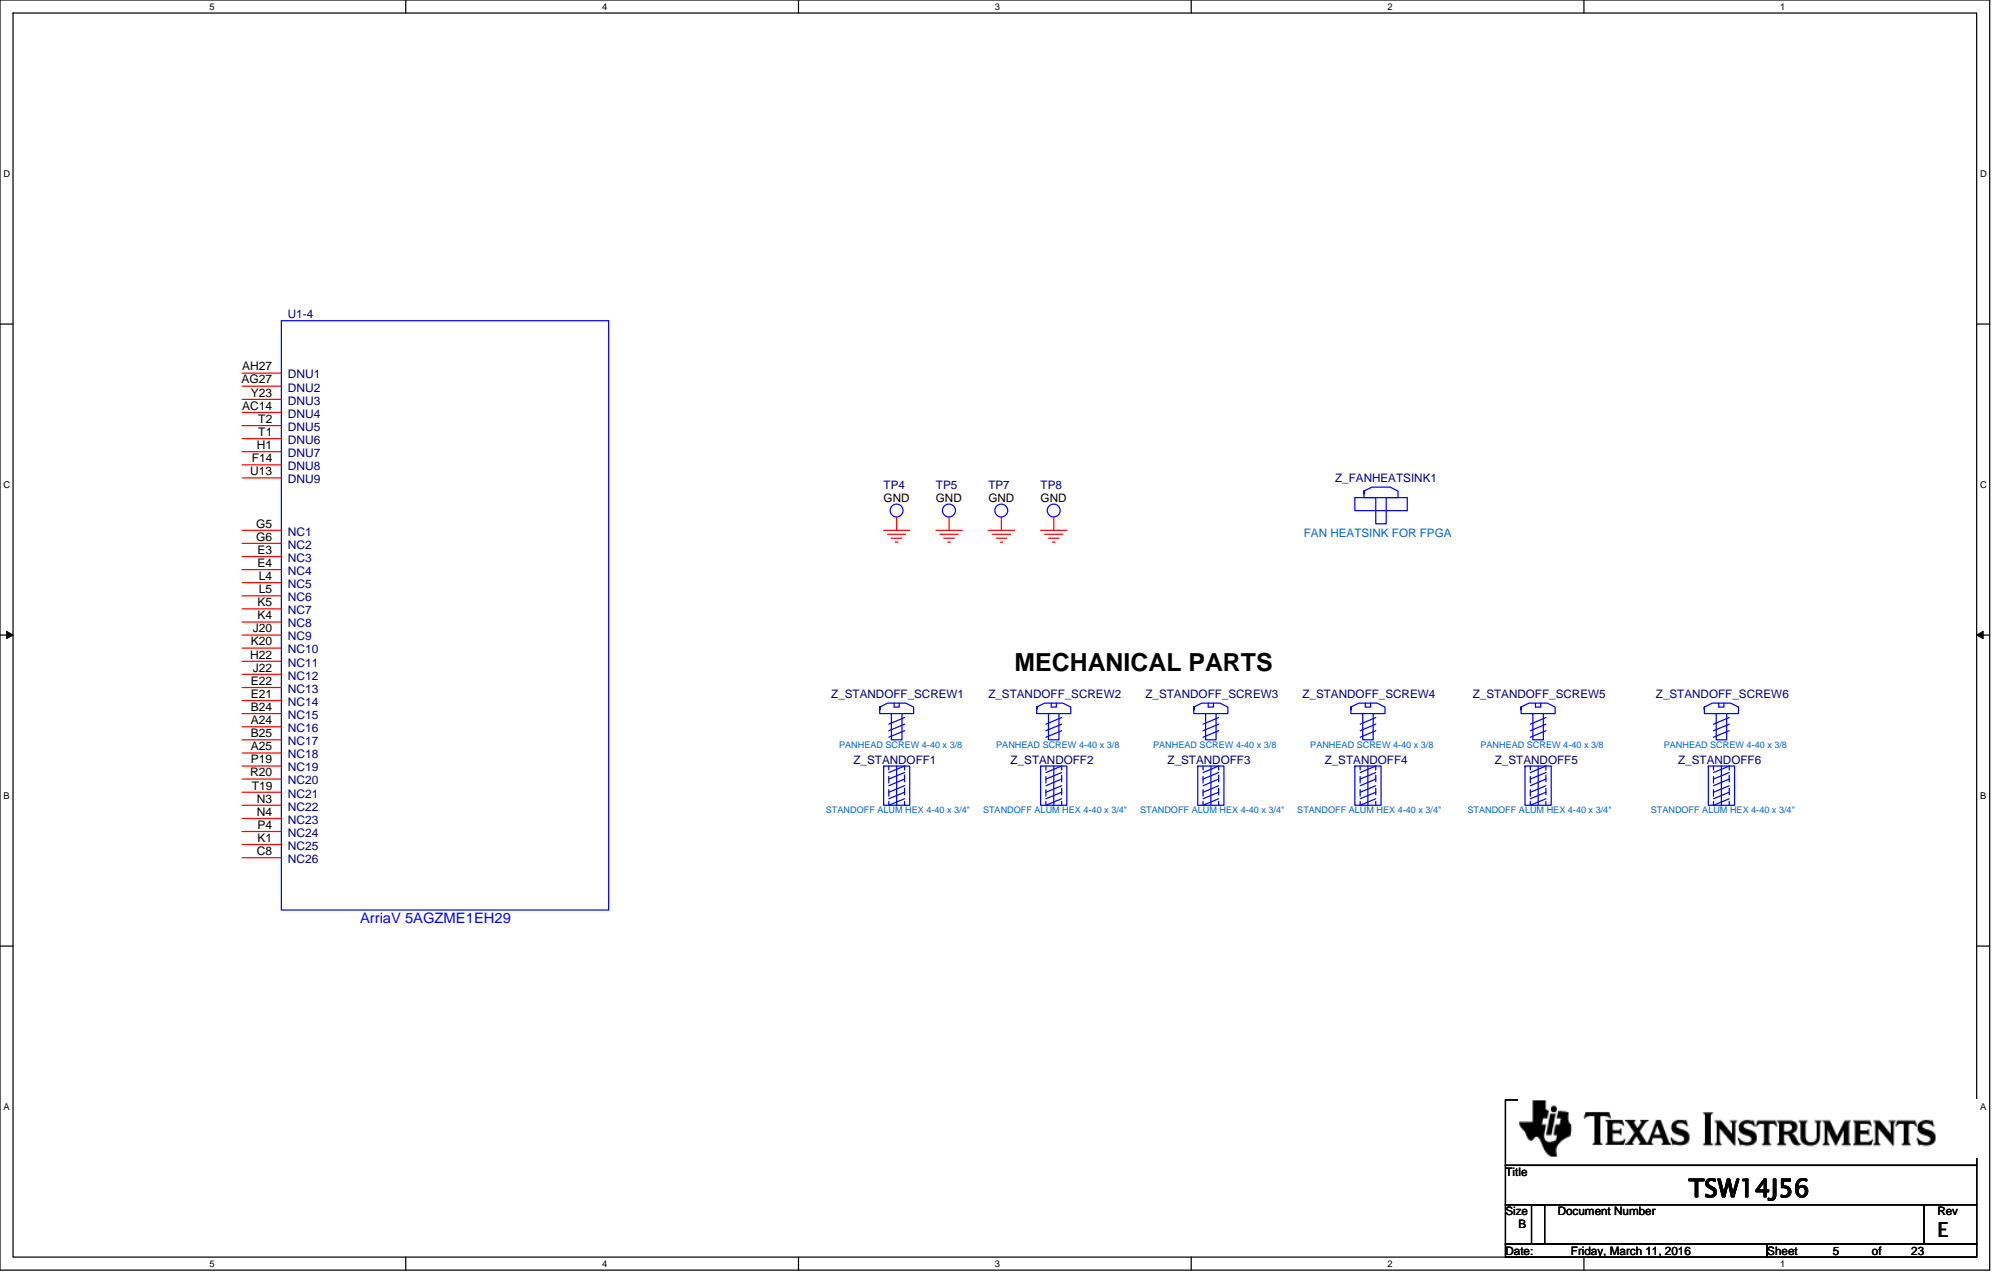
[picture p38: page 5]

FAN HEATSINK FOR FPGA

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

Date: Date: Date: Friday, March 11, 2016 Friday, March 11, 2016 Friday, March 11, 2016 | Sheet Sheet Sheet 5 5 5 of of of 23 23 23

# Bank 3

2.5V

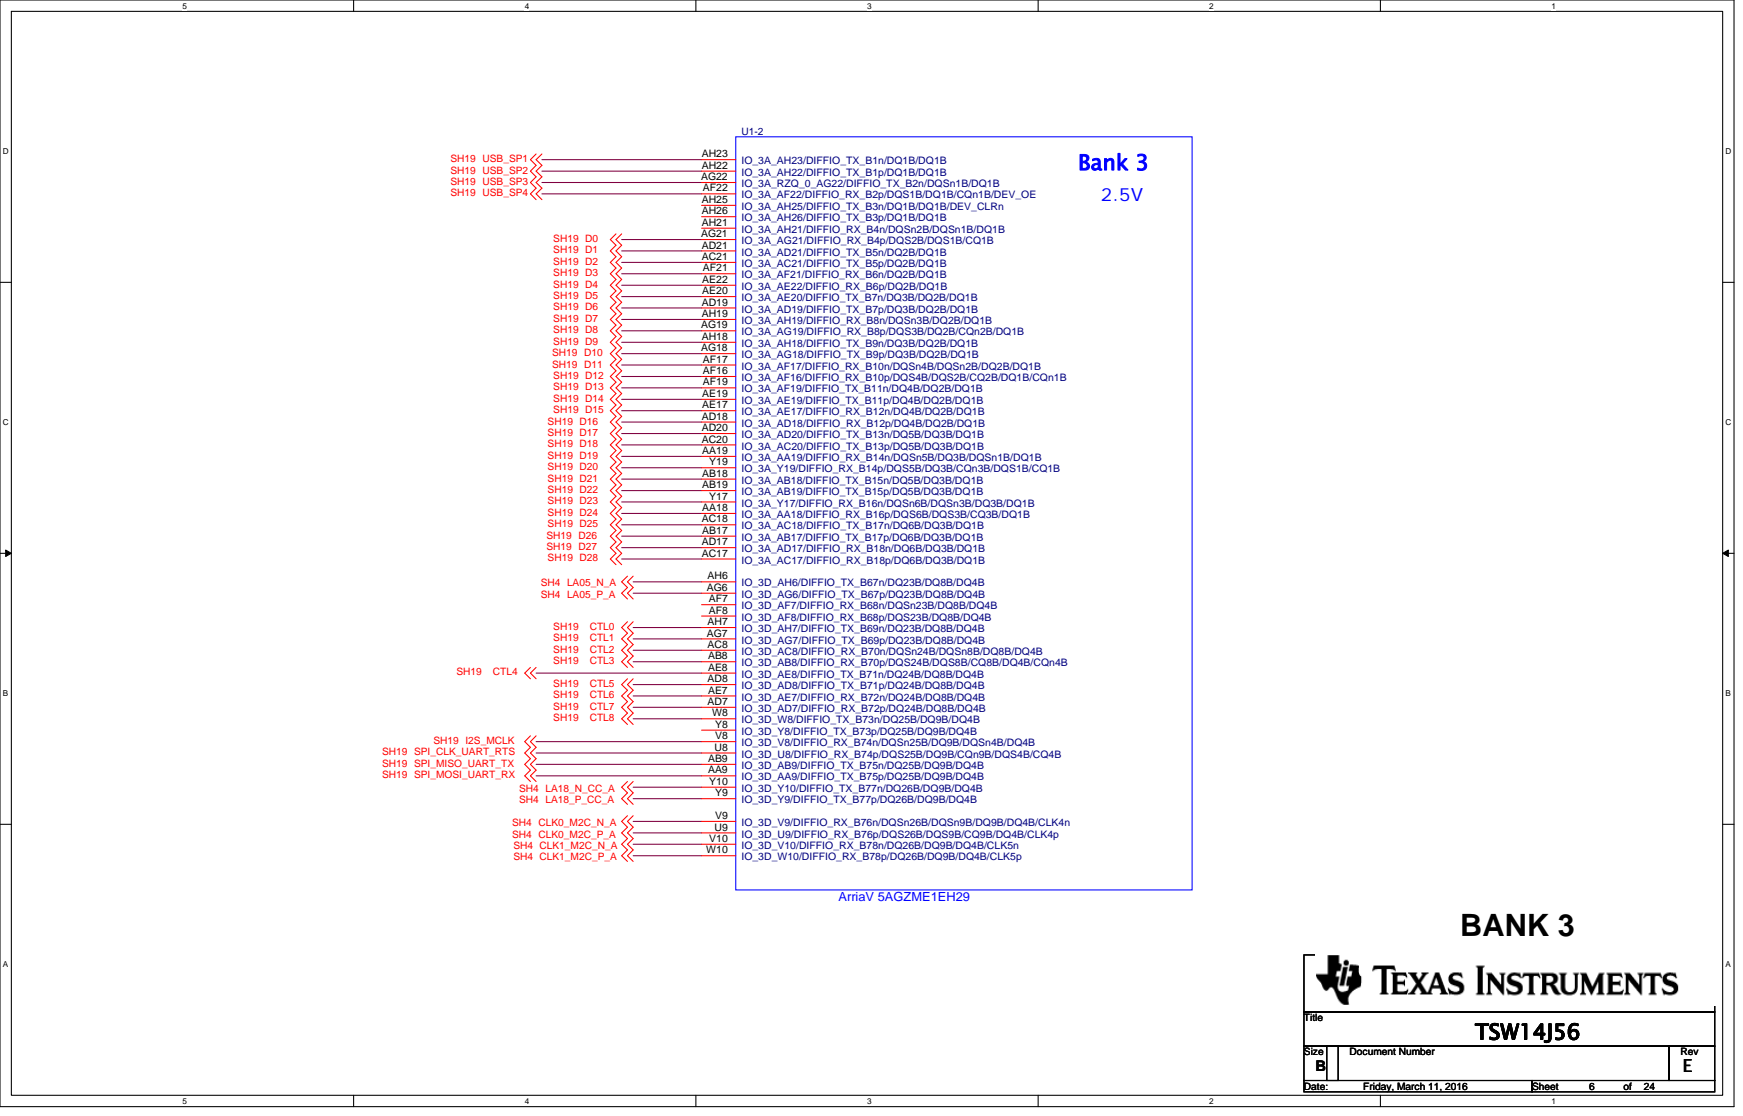
[picture p39: page 6]
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

Date: Date: Date: Friday, March 11, 2016 Friday, March 11, 2016 Friday, March 11, 2016 | Sheet Sheet Sheet 6 6 6 of of of 24 24 24

# Bank 3

2.5V

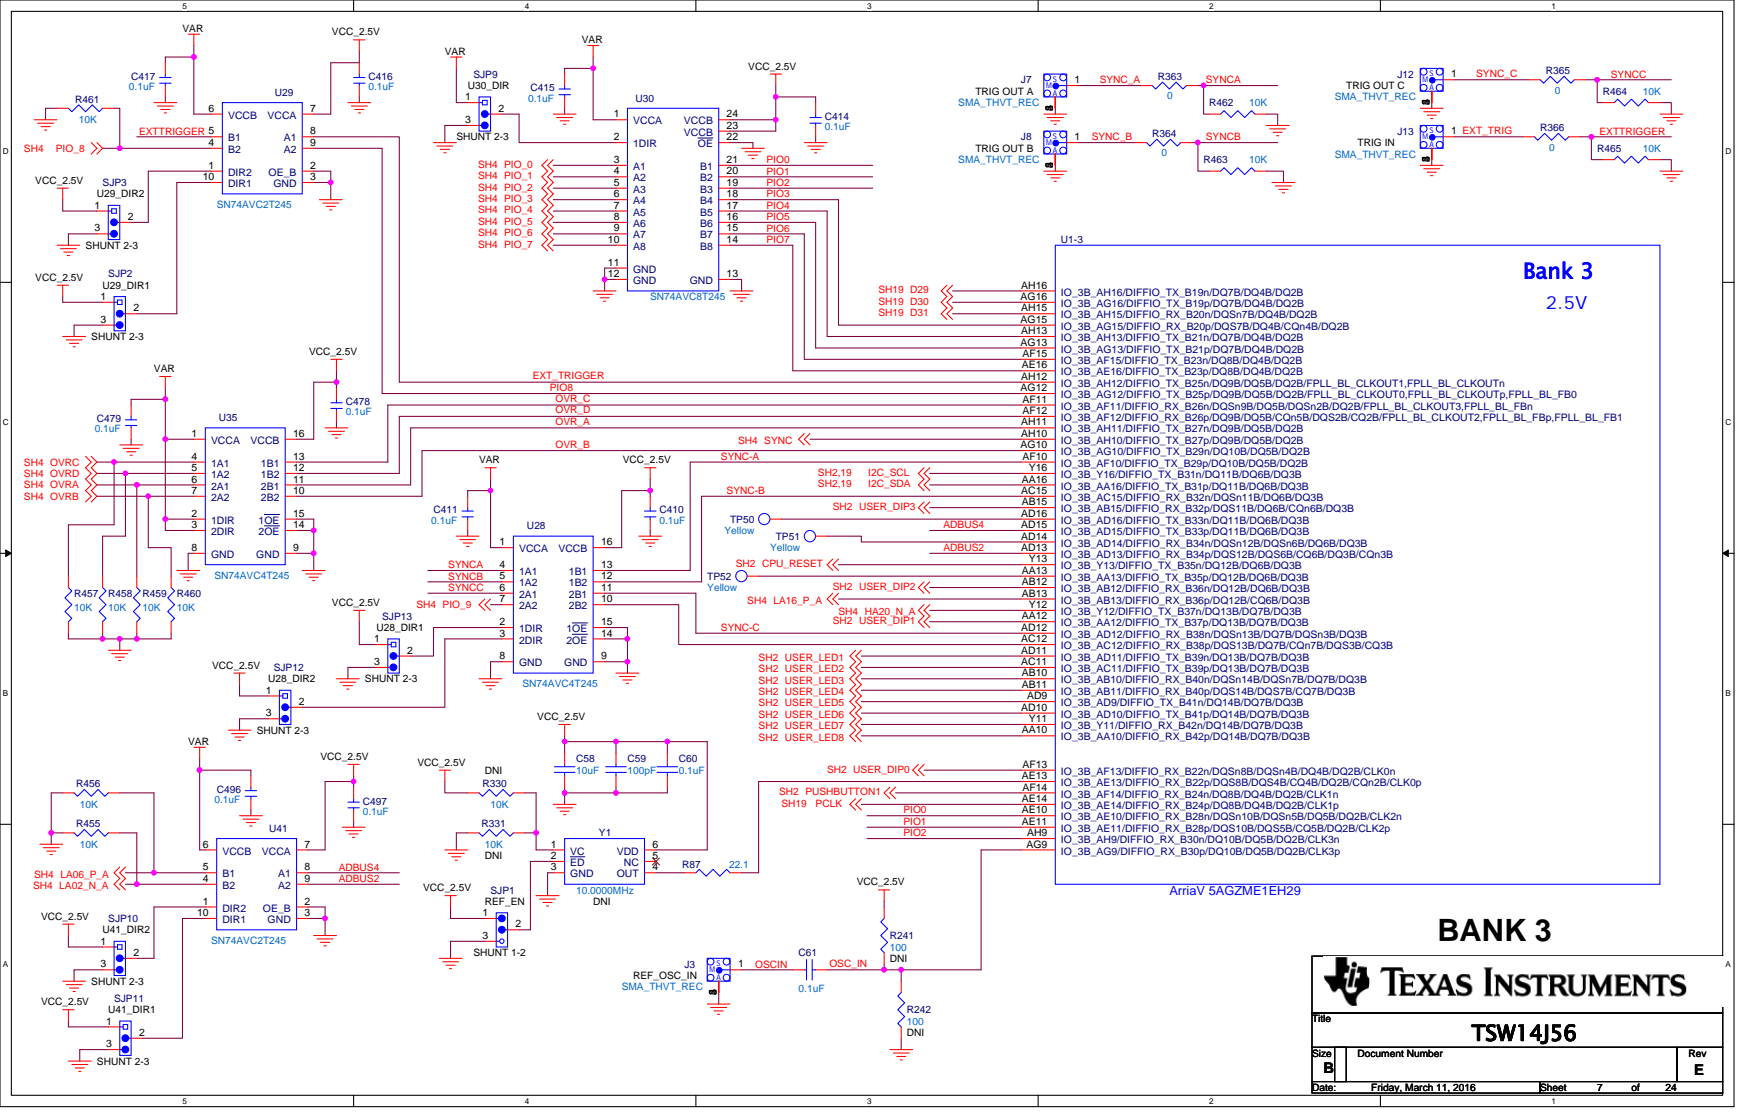
[picture p40: page 7]
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

Date: Date: Date: Friday, March 11, 2016 Friday, March 11, 2016 Friday, March 11, 2016 | Sheet Sheet Sheet 7 7 7 of of of 24 24 24

# Bank 4

2.5V

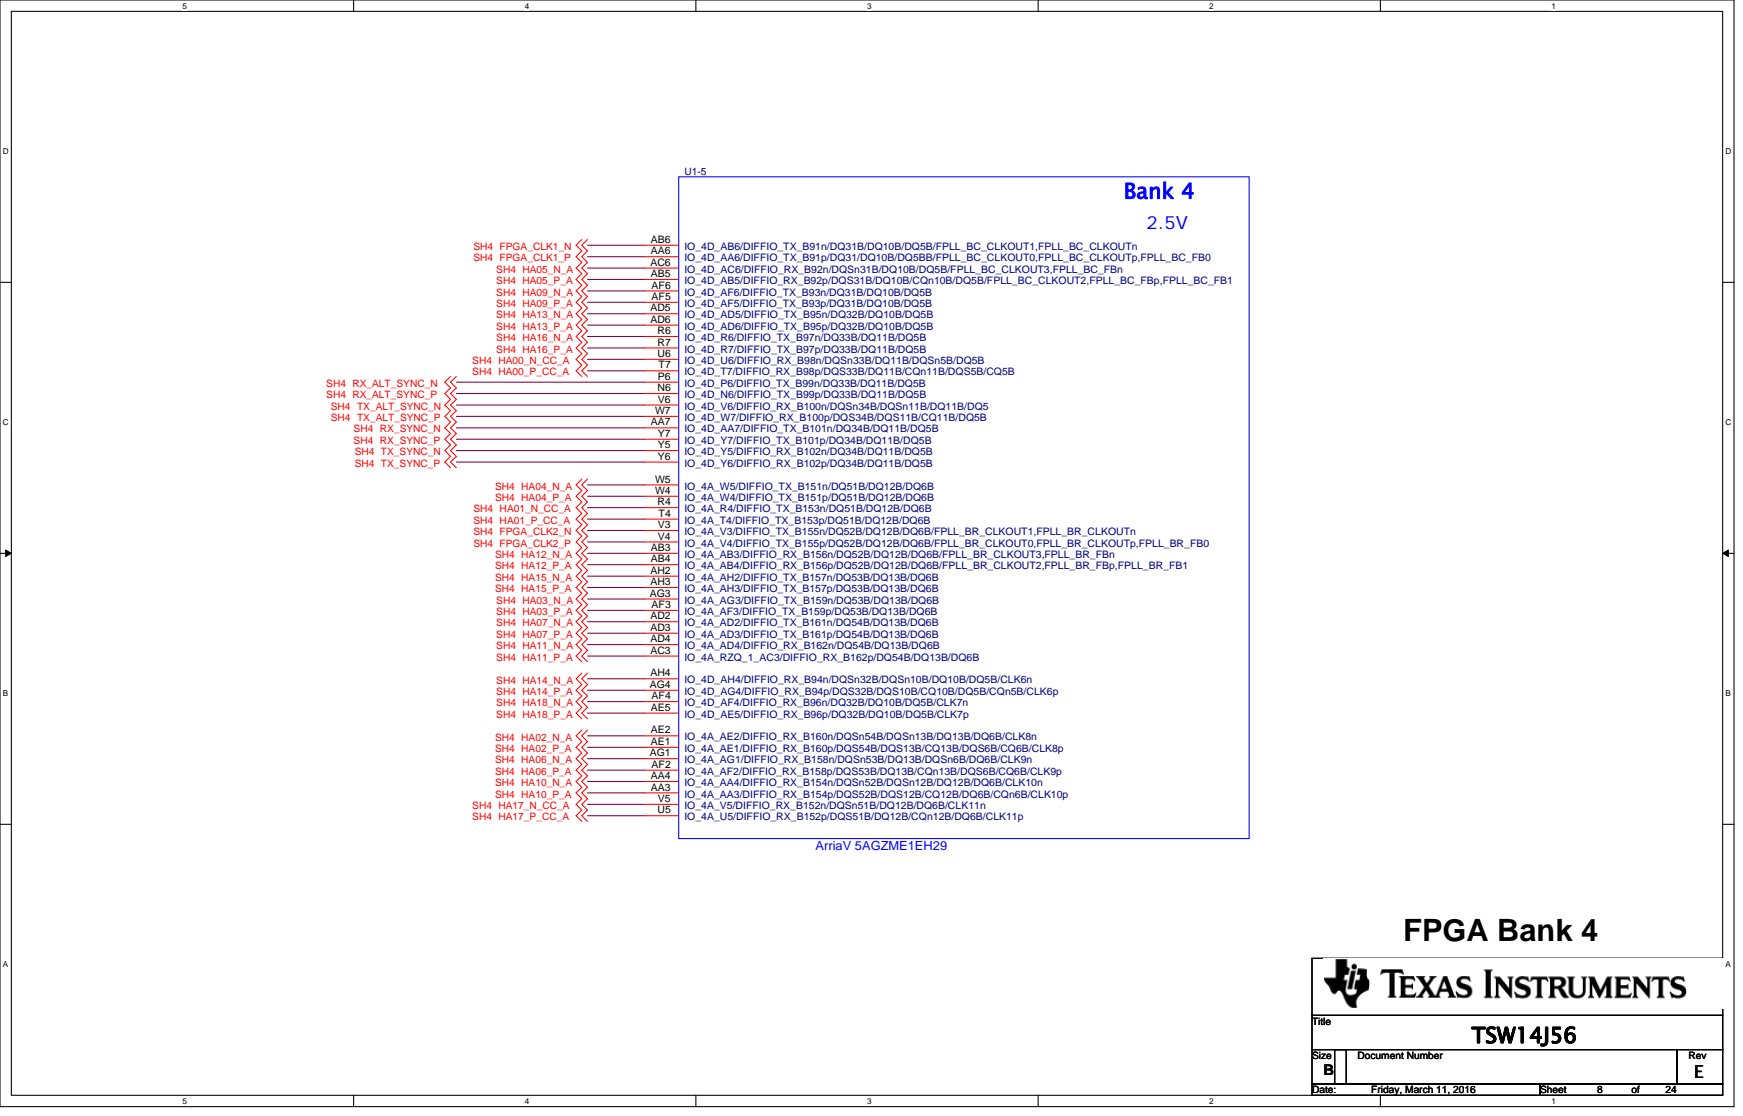
[picture p41: page 8]
FPGA Bank 4; SH4 RX_ALT_SYNC_P; SH4 RX_ALT_SYNC_N; SH4 TX_ALT_SYNC_N SH4 TX_ALT_SYNC_P; SH4 RX_SYNC_P; SH4 RX_SYNC_N; SH4 TX_SYNC_P; SH4 TX_SYNC_N; SH4 FPGA_CLK2_P; SH4 FPGA_CLK2_N; SH4 FPGA_CLK1_P; SH4 FPGA_CLK1_N; Title; TSW14J56; ArriaV 5AGZME1EH29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

Date: Date: Date: Friday, March 11, 2016 Friday, March 11, 2016 Friday, March 11, 2016 | Sheet Sheet Sheet 8 8 8 of of of 24 24 24

# Bank 7

2.5V

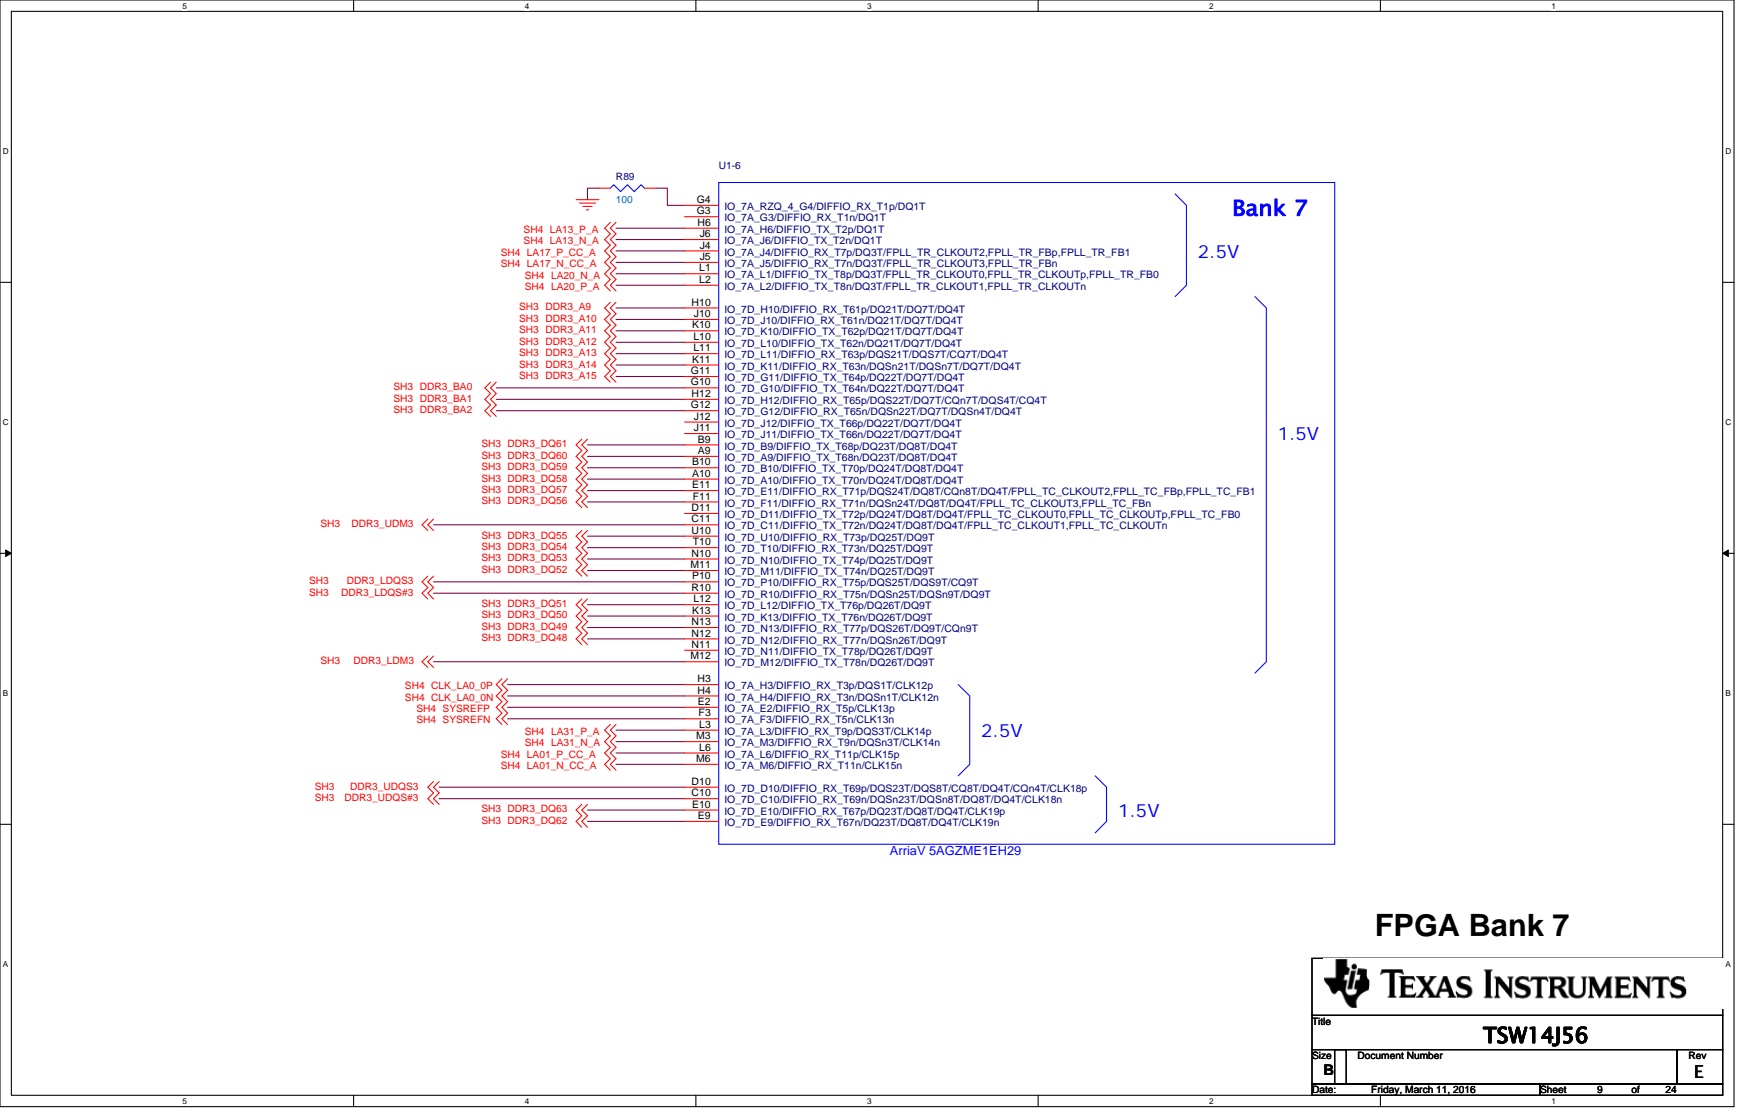
[picture p42: page 9]
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

Date: Date: Date: Friday, March 11, 2016 Friday, March 11, 2016 Friday, March 11, 2016 | Sheet Sheet Sheet 9 9 9 of of of 24 24 24

# Bank 7

1.5V

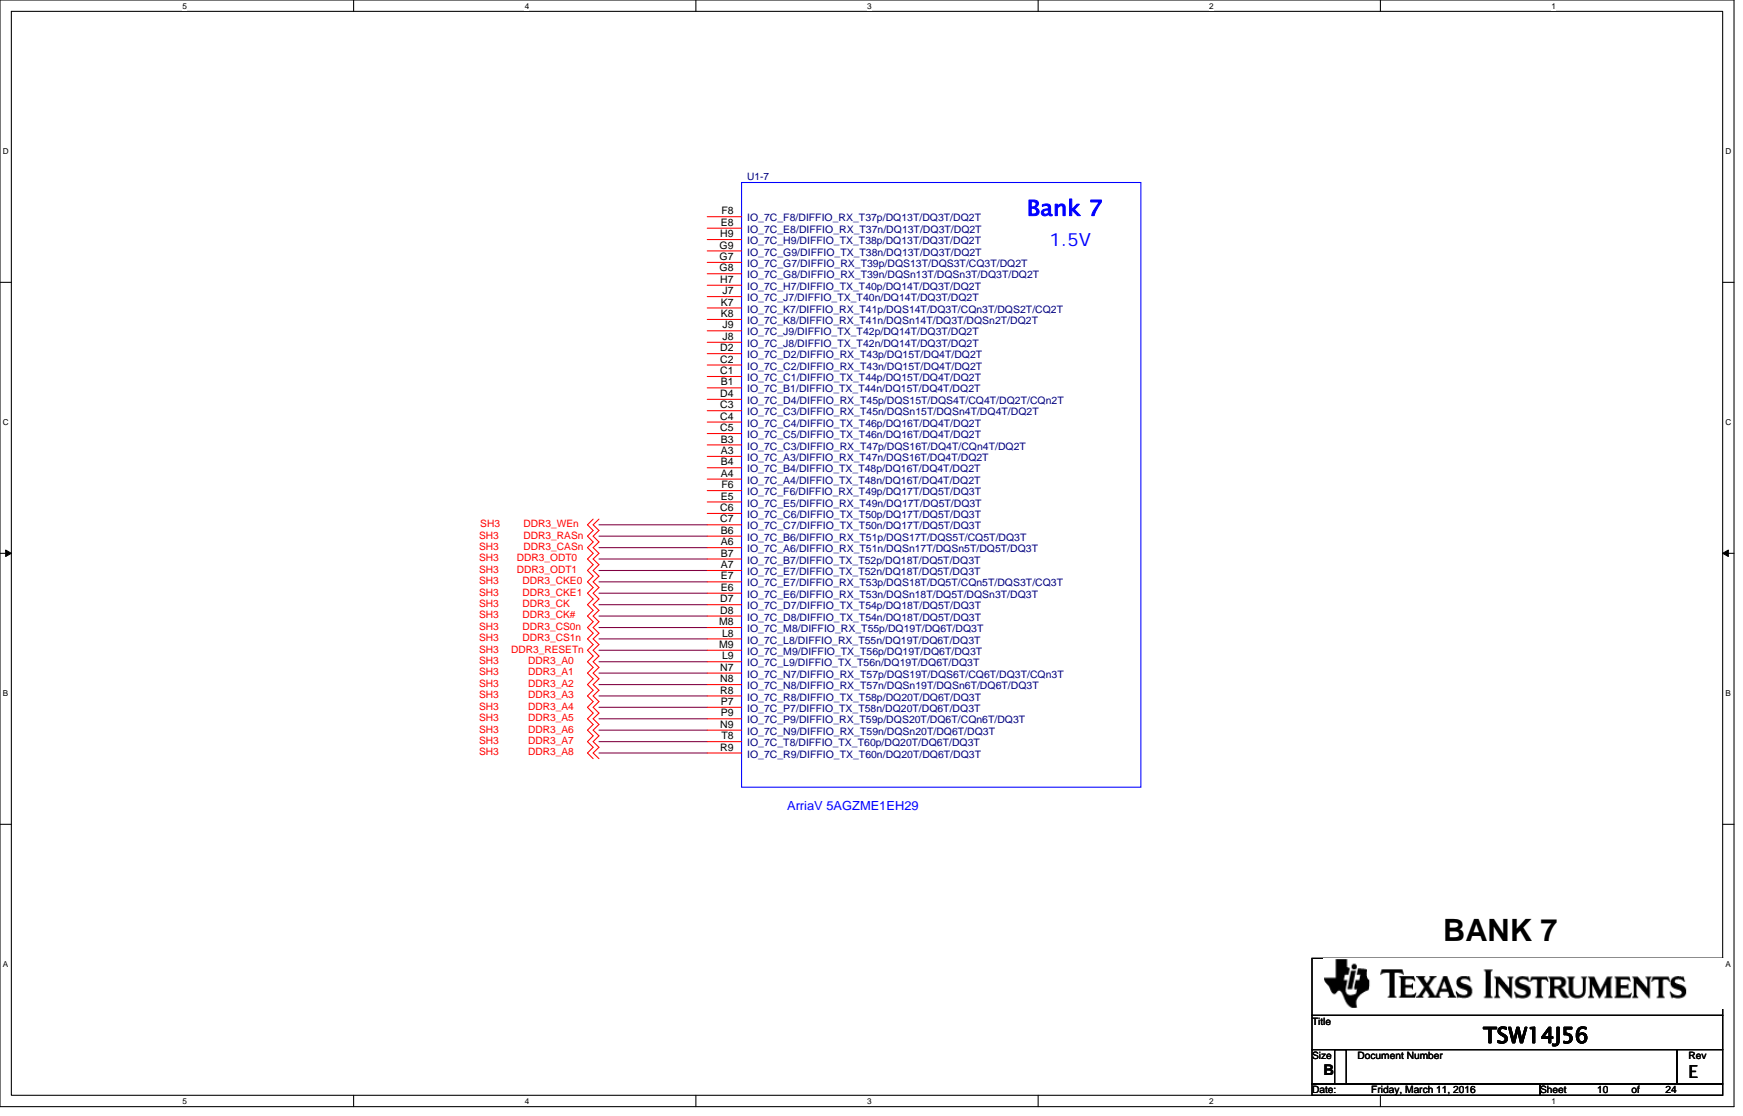
[picture p43: page 10]
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

Date: Date: Date: Friday, March 11, 2016 Friday, March 11, 2016 Friday, March 11, 2016 | Sheet Sheet Sheet 10 10 10 of of of 24 24 24

# Bank 8

1.5V

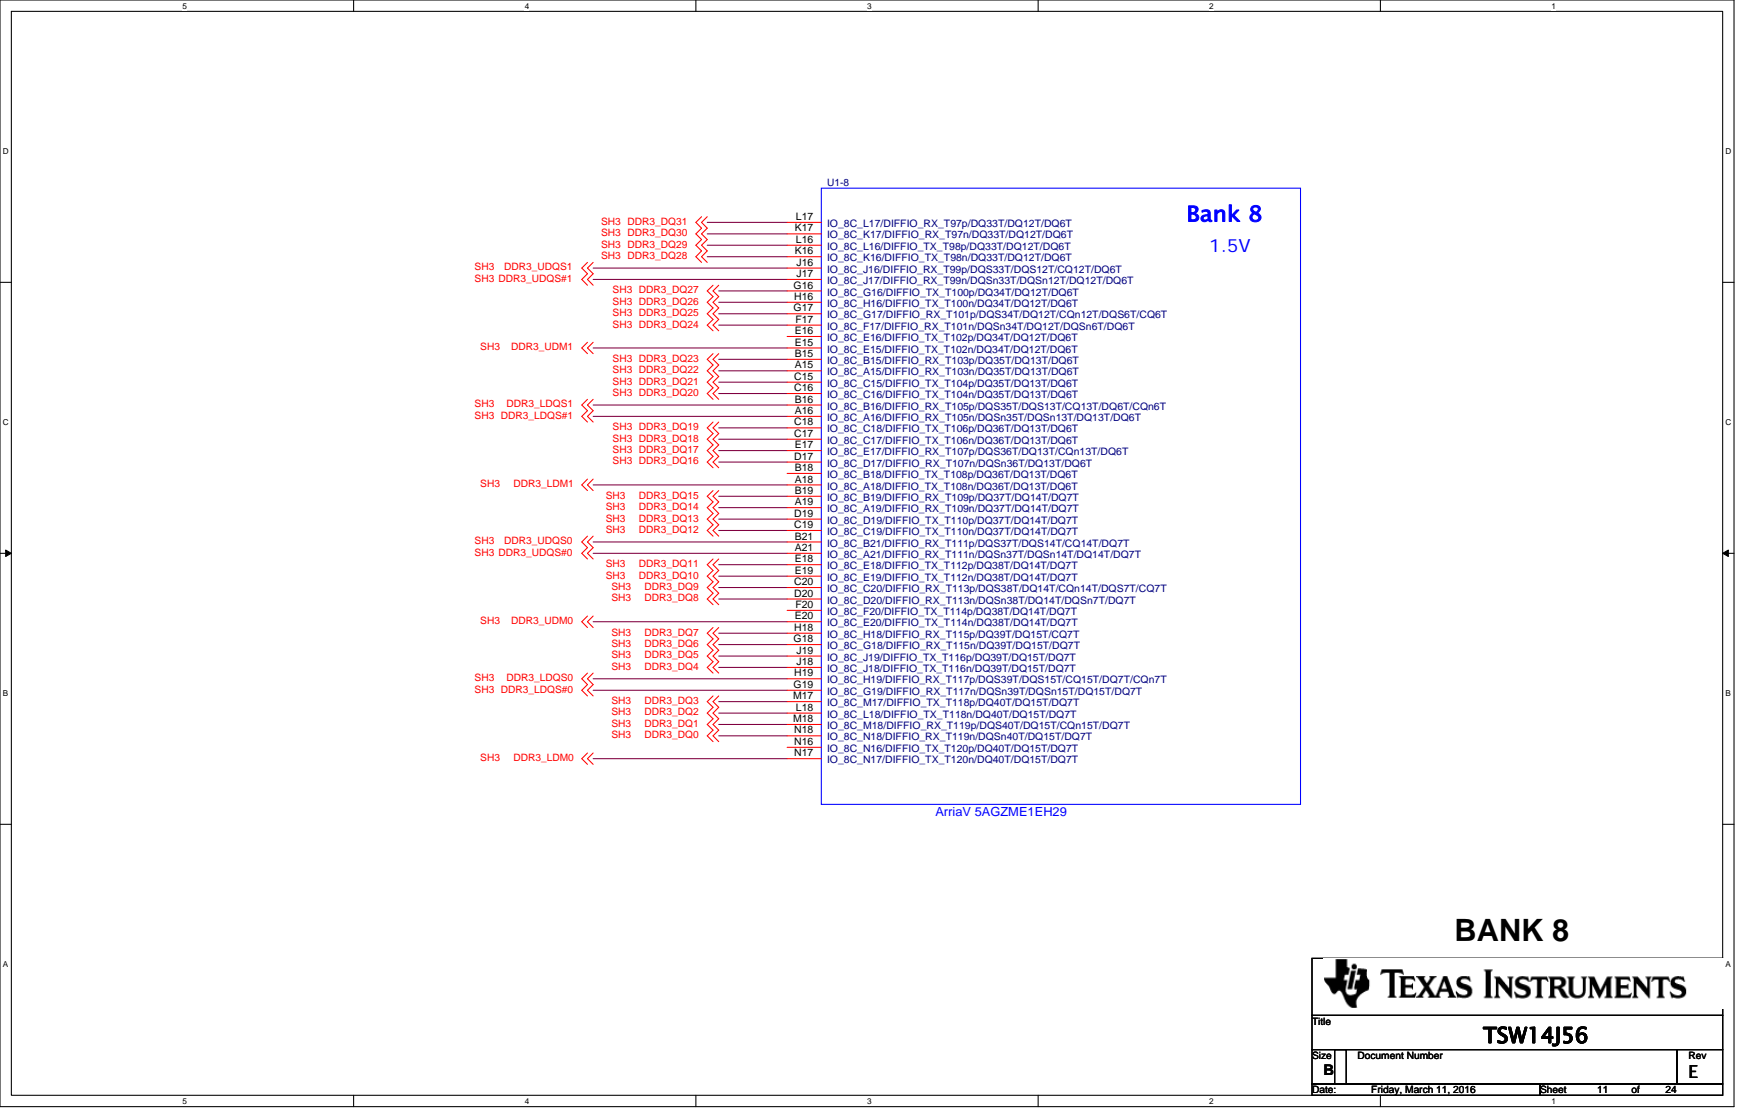
[picture p44: page 11]
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

Date: Date: Date: Friday, March 11, 2016 Friday, March 11, 2016 Friday, March 11, 2016 | Sheet Sheet Sheet 11 11 11 of of of 24 24 24

# Bank 8

2.5V

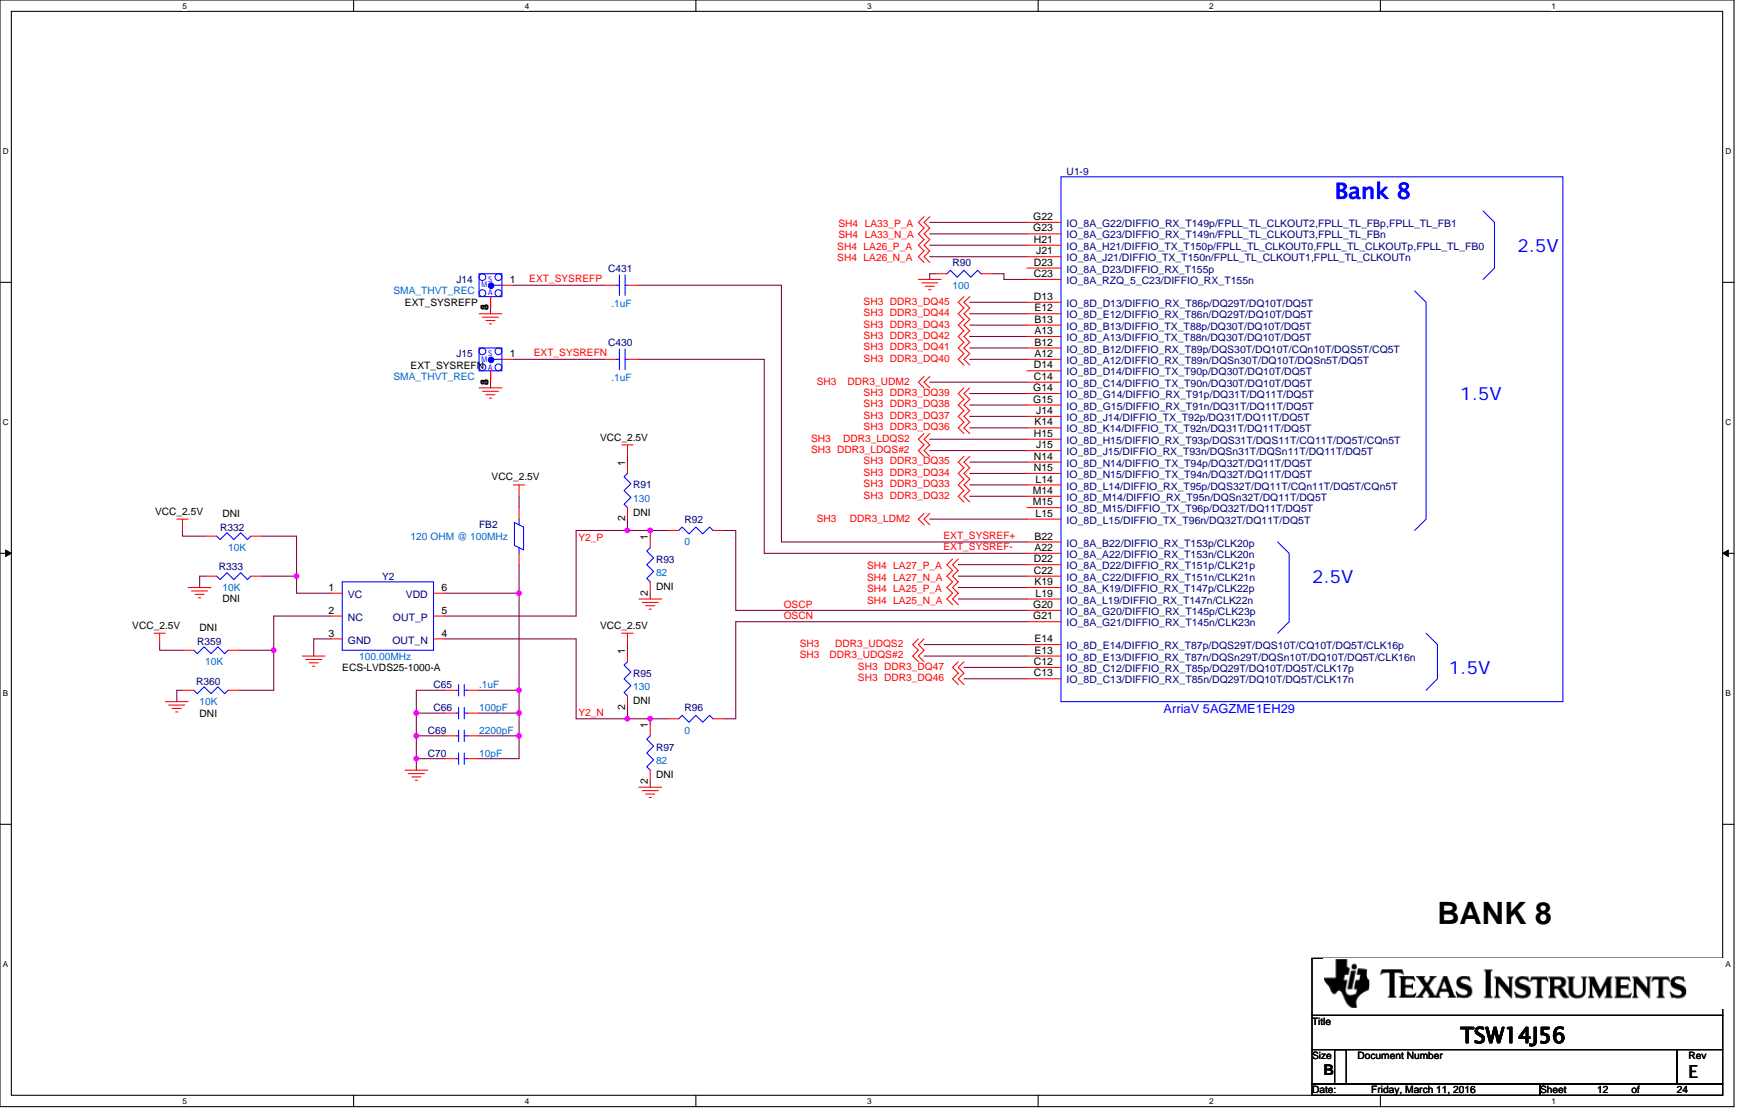
[picture p45: page 12]
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

Date: Date: Date: Friday, March 11, 2016 Friday, March 11, 2016 Friday, March 11, 2016 | Sheet Sheet Sheet 12 12 12 of of of 24 24 24

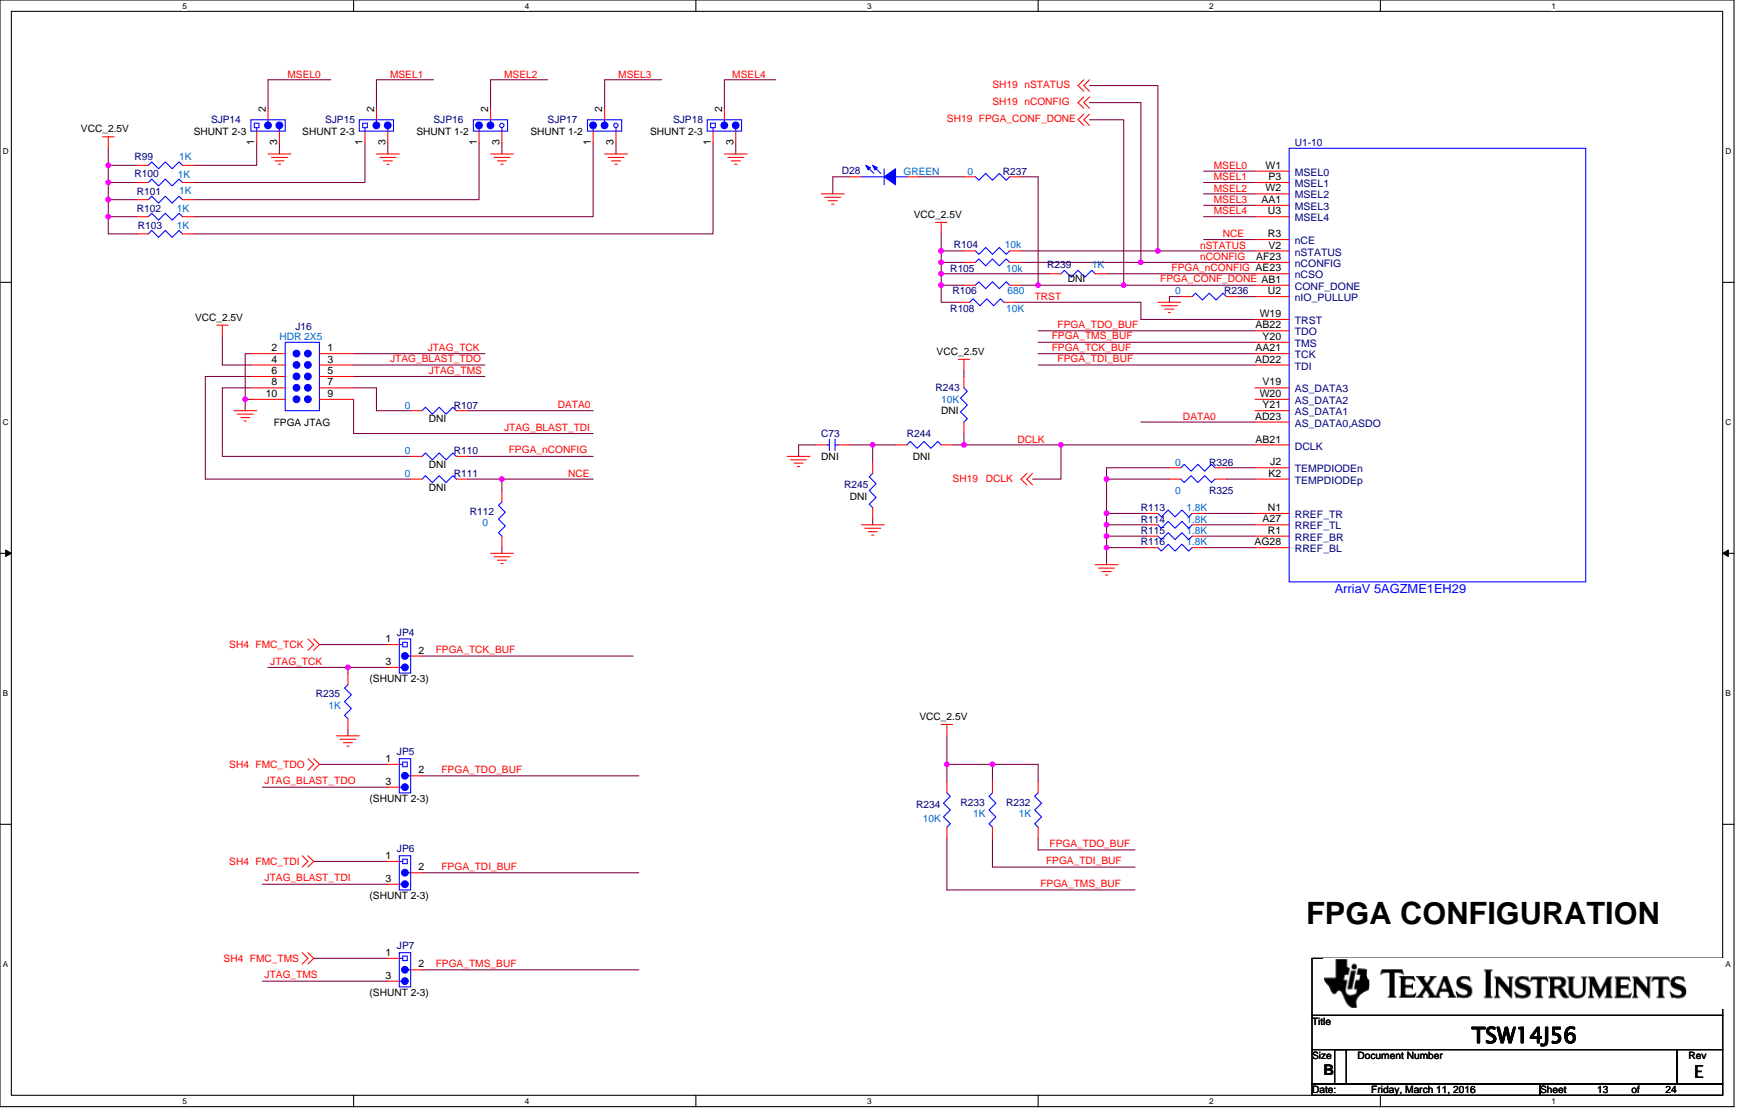
[picture p46: page 13]

10 | 9

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

Date: Date: Date: Friday, March 11, 2016 Friday, March 11, 2016 Friday, March 11, 2016 | Sheet Sheet Sheet 13 13 13 of of of 24 24 24

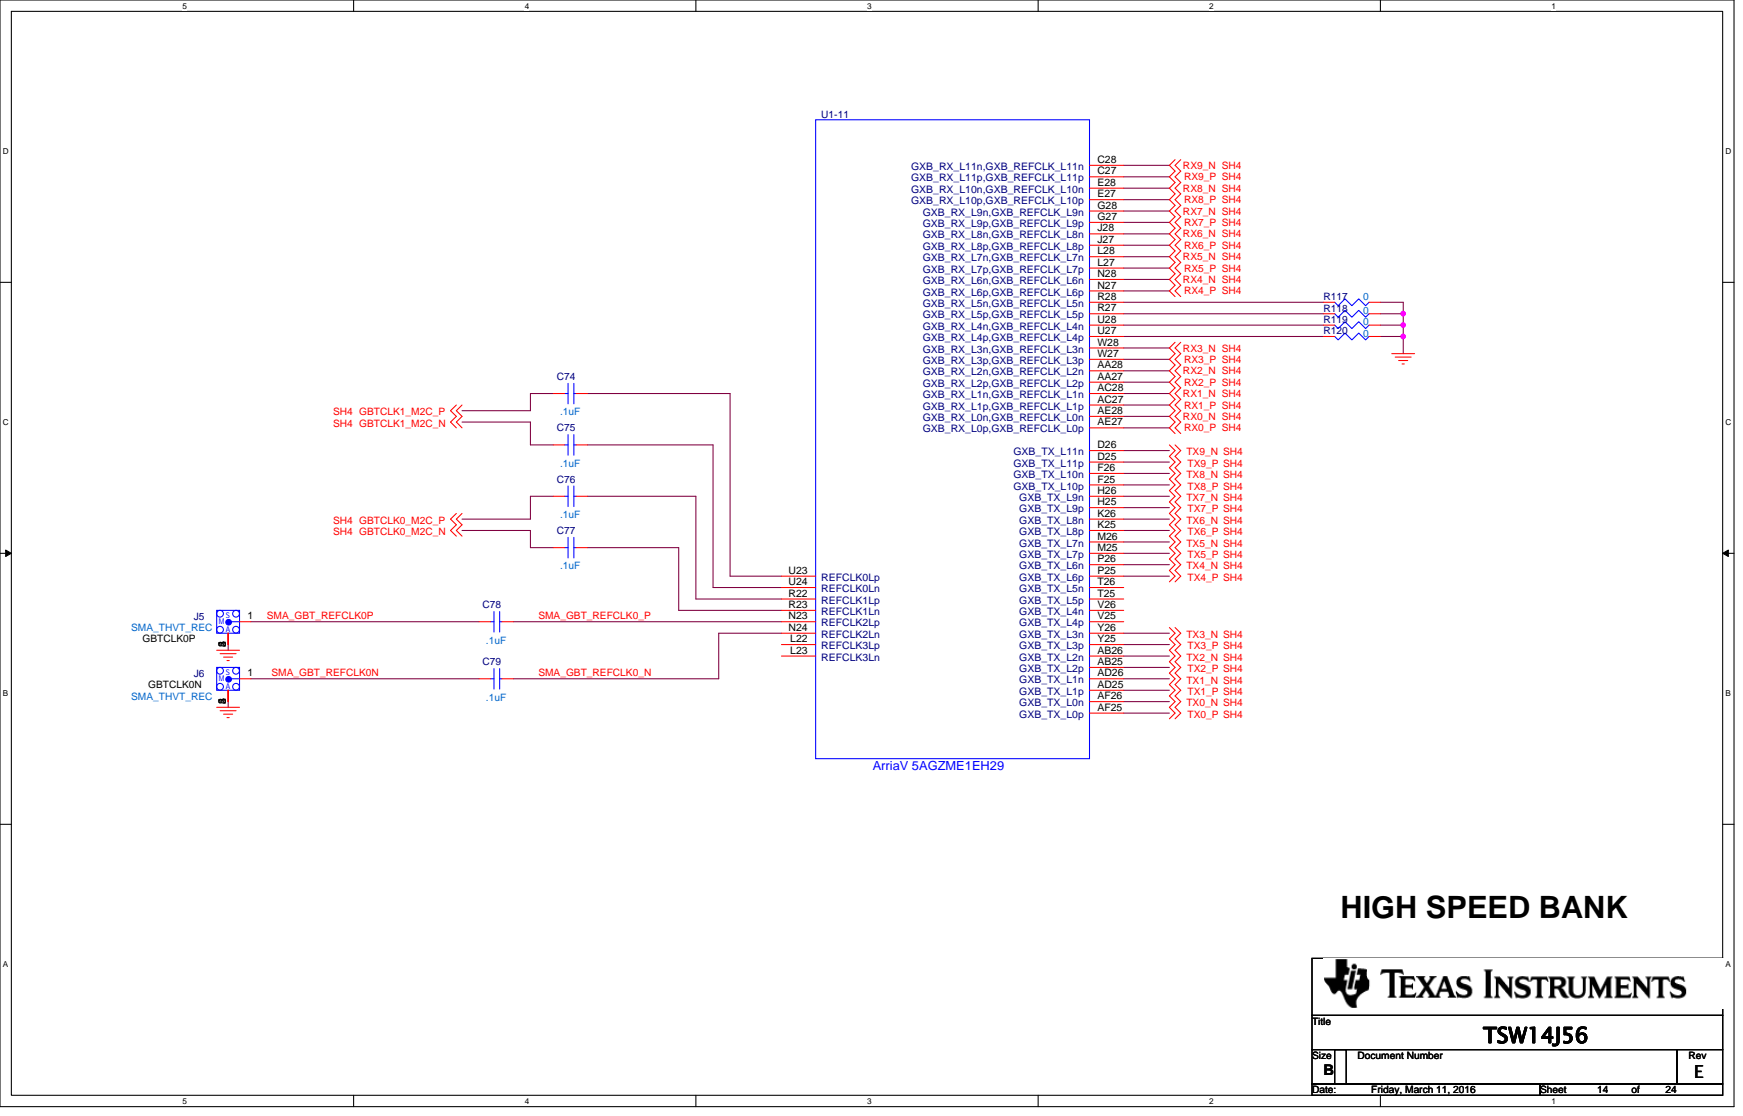
[picture p47: page 14]
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

Date: Date: Date: Friday, March 11, 2016 Friday, March 11, 2016 Friday, March 11, 2016 | Sheet Sheet Sheet 14 14 14 of of of 24 24 24

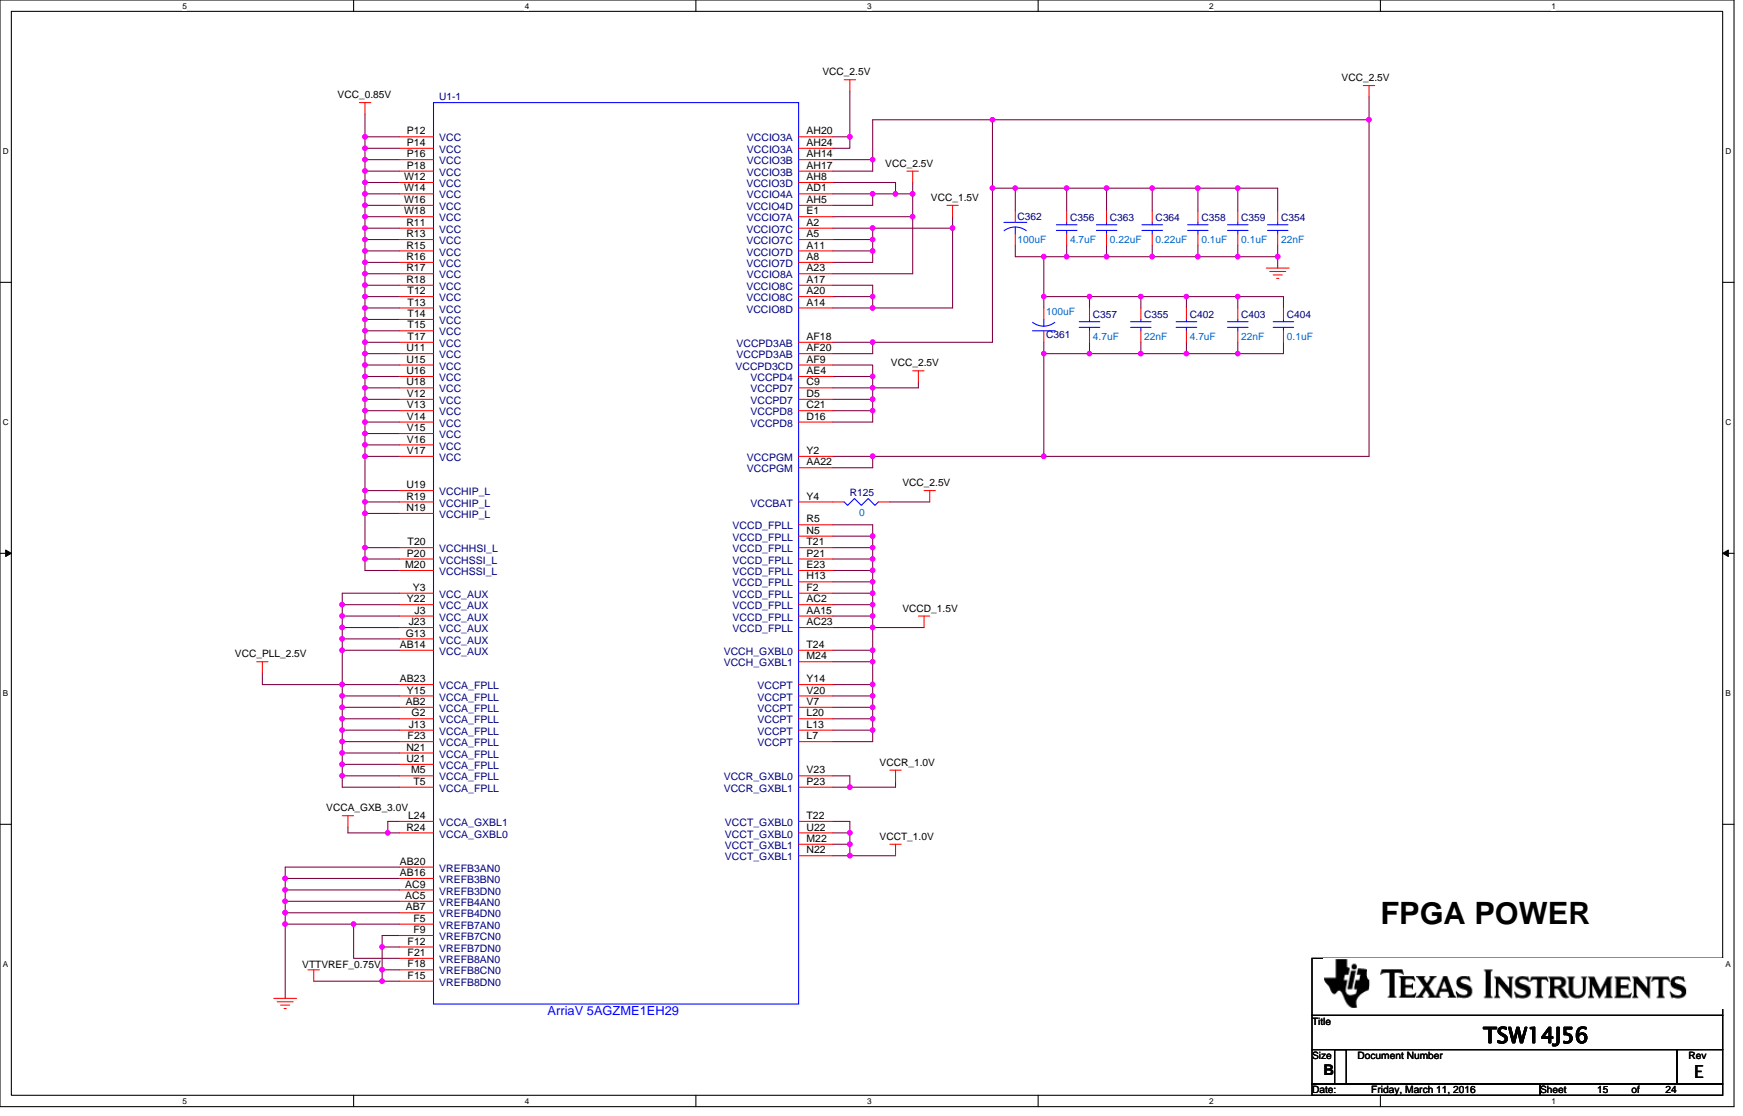
[picture p48: page 15]
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

Date: Date: Date: Friday, March 11, 2016 Friday, March 11, 2016 Friday, March 11, 2016 | Sheet Sheet Sheet 15 15 15 of of of 24 24 24

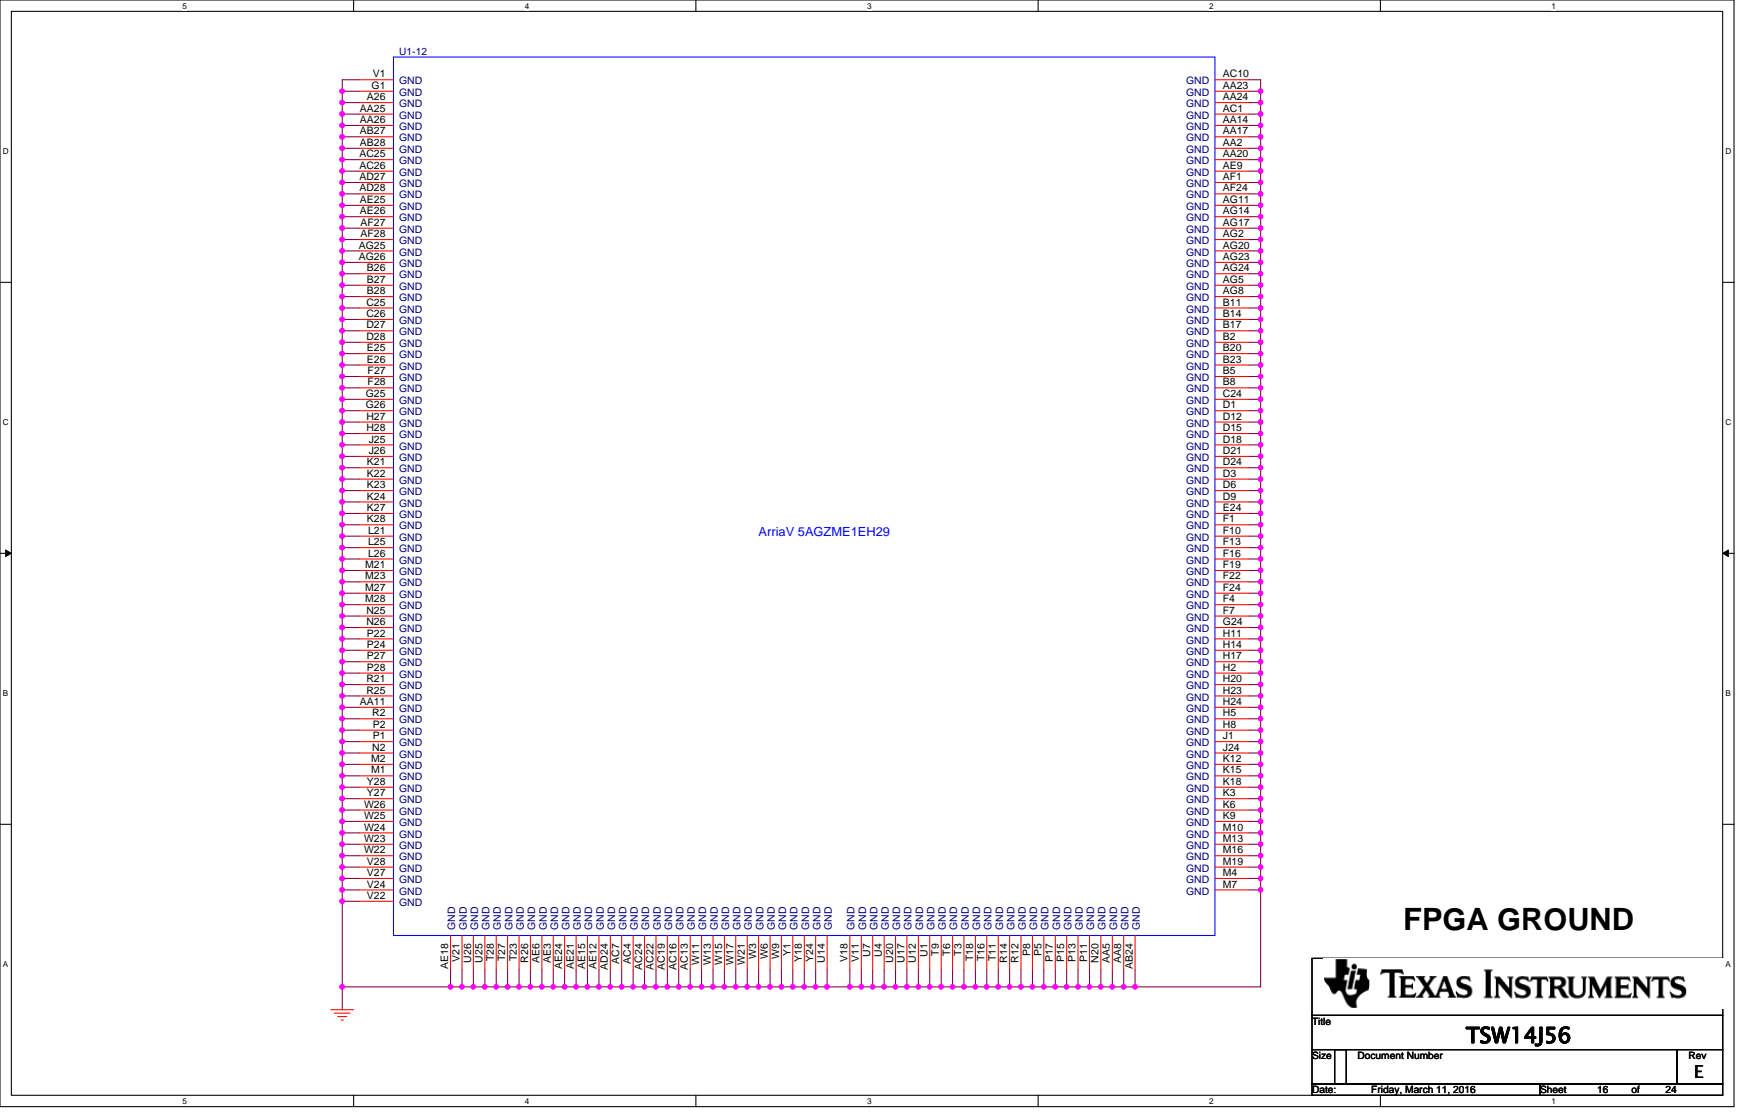
[picture p49: page 16]

GND T23 GND T27 GND T28 GND U25 GND U26 GND V21

GND AC13 GND AC16 GND AC19 GND AC22 GND AC24 GND AC4 GND AC7 GND AD24 GND AE12 GND AE15 GND AE21 GND AE24 GND AE3 GND AE6

Size Size Size | | Document Number Document Number Document Number | Rev Rev Rev E E E

Date: Date: Date: Friday, March 11, 2016 Friday, March 11, 2016 Friday, March 11, 2016 | Sheet Sheet Sheet 16 16 16 of of of 24 24 24

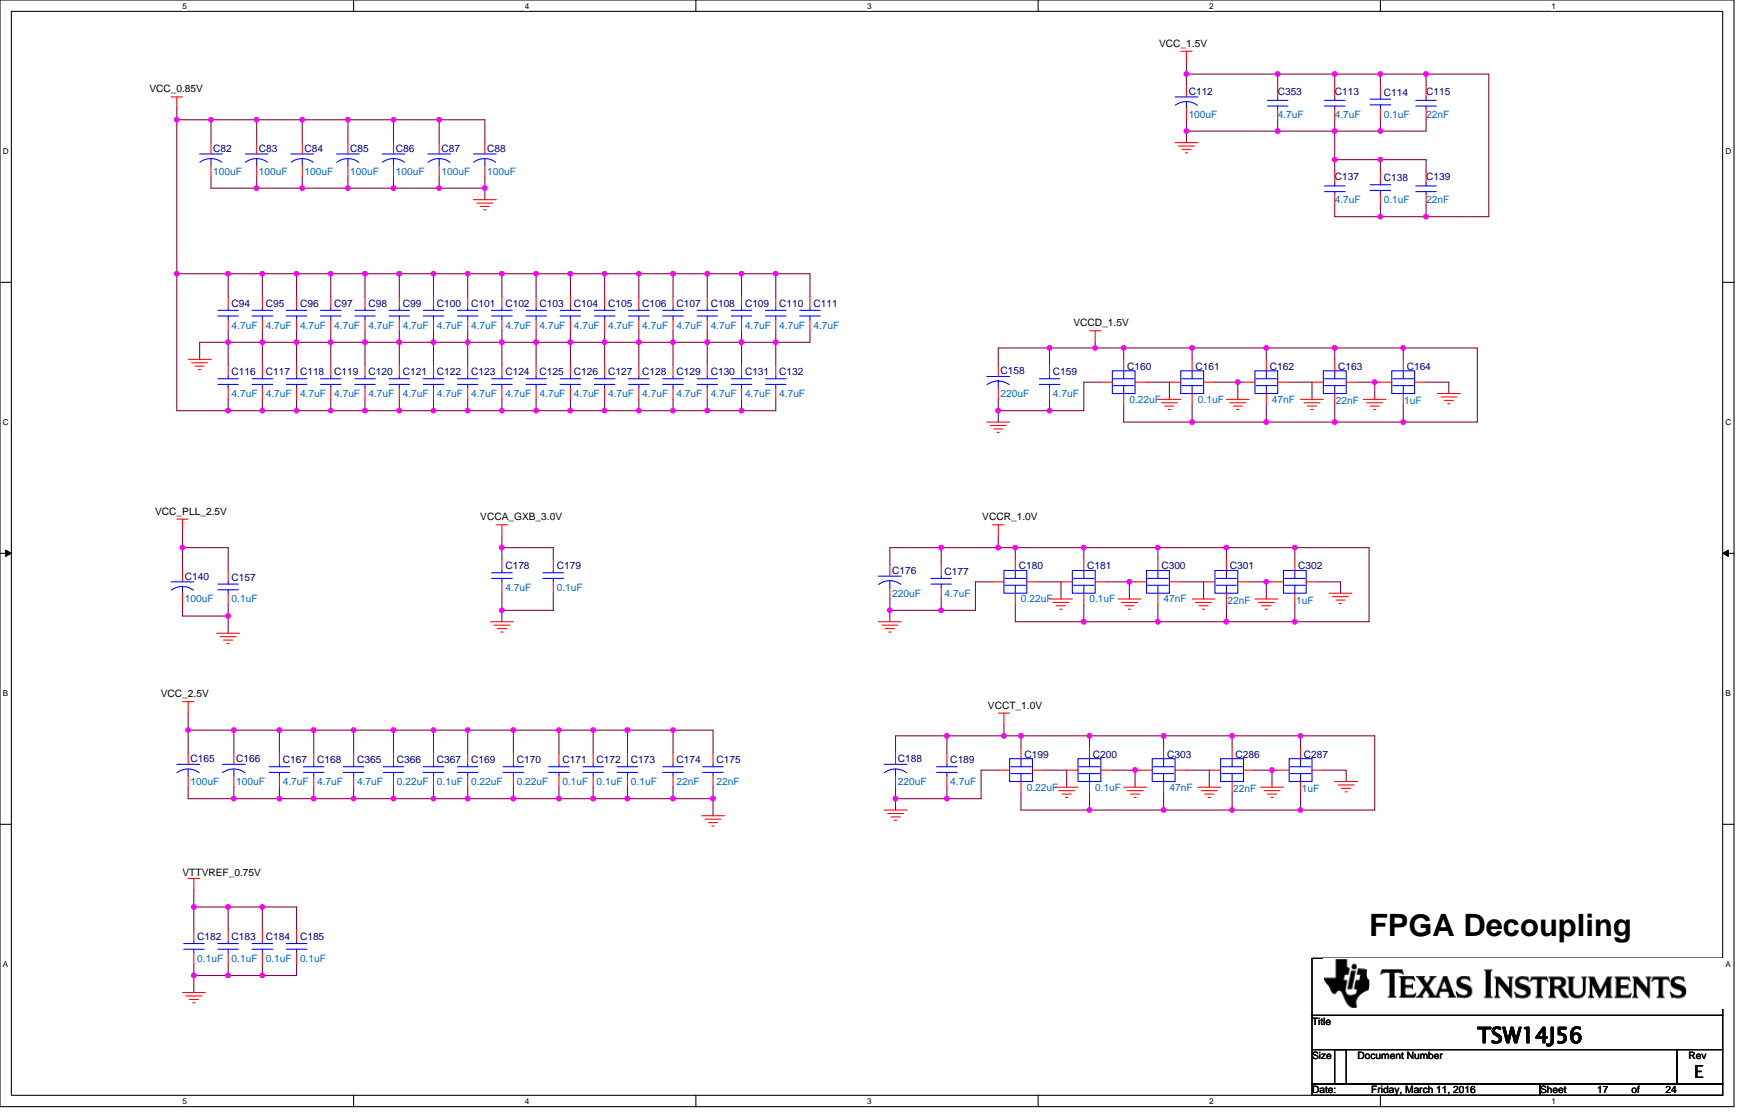
[picture p50: page 17]

Size Size Size | | Document Number Document Number Document Number | Rev Rev Rev E E E

Date: Date: Date: Friday, March 11, 2016 Friday, March 11, 2016 Friday, March 11, 2016 | Sheet Sheet Sheet 17 17 17 of of of 24 24 24

## USB Overvoltage Protection

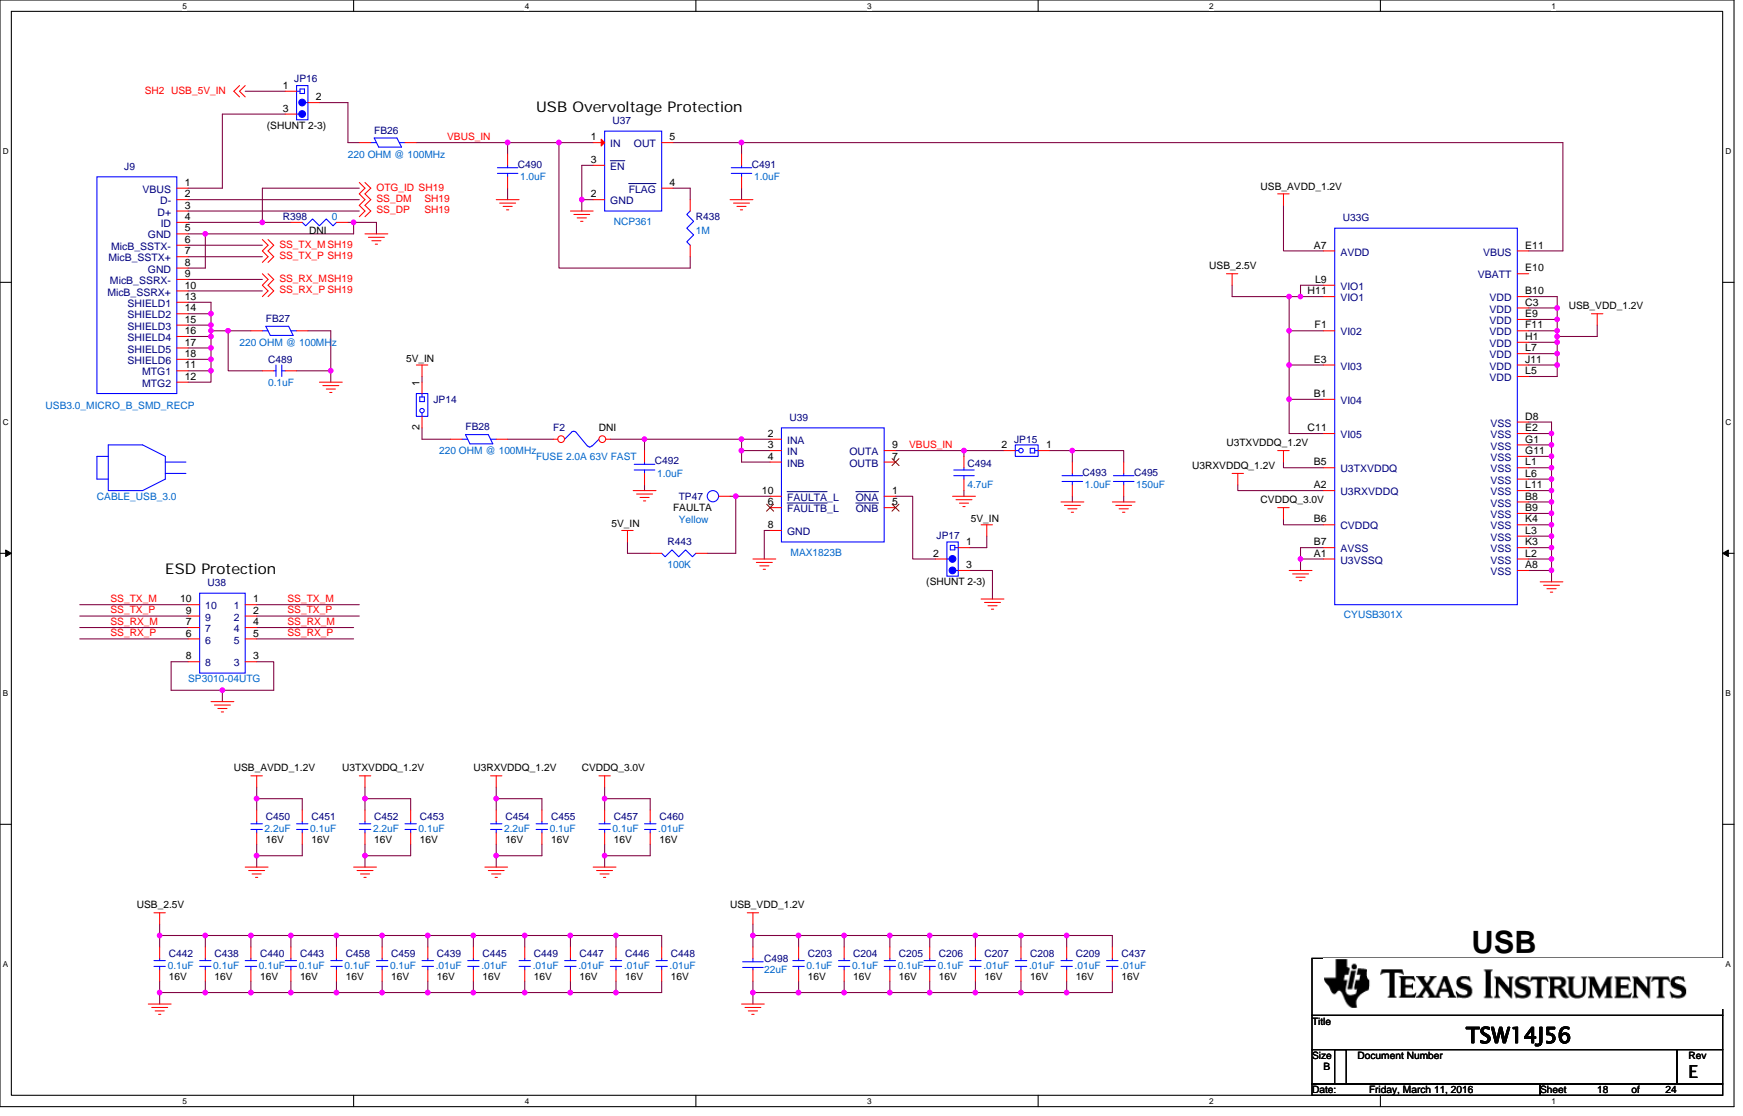
[picture p51: page 18]
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

Date: Date: Date: Friday, March 11, 2016 Friday, March 11, 2016 Friday, March 11, 2016 | Sheet Sheet Sheet 18 18 18 of of of 24 24 24

VI01

VI02

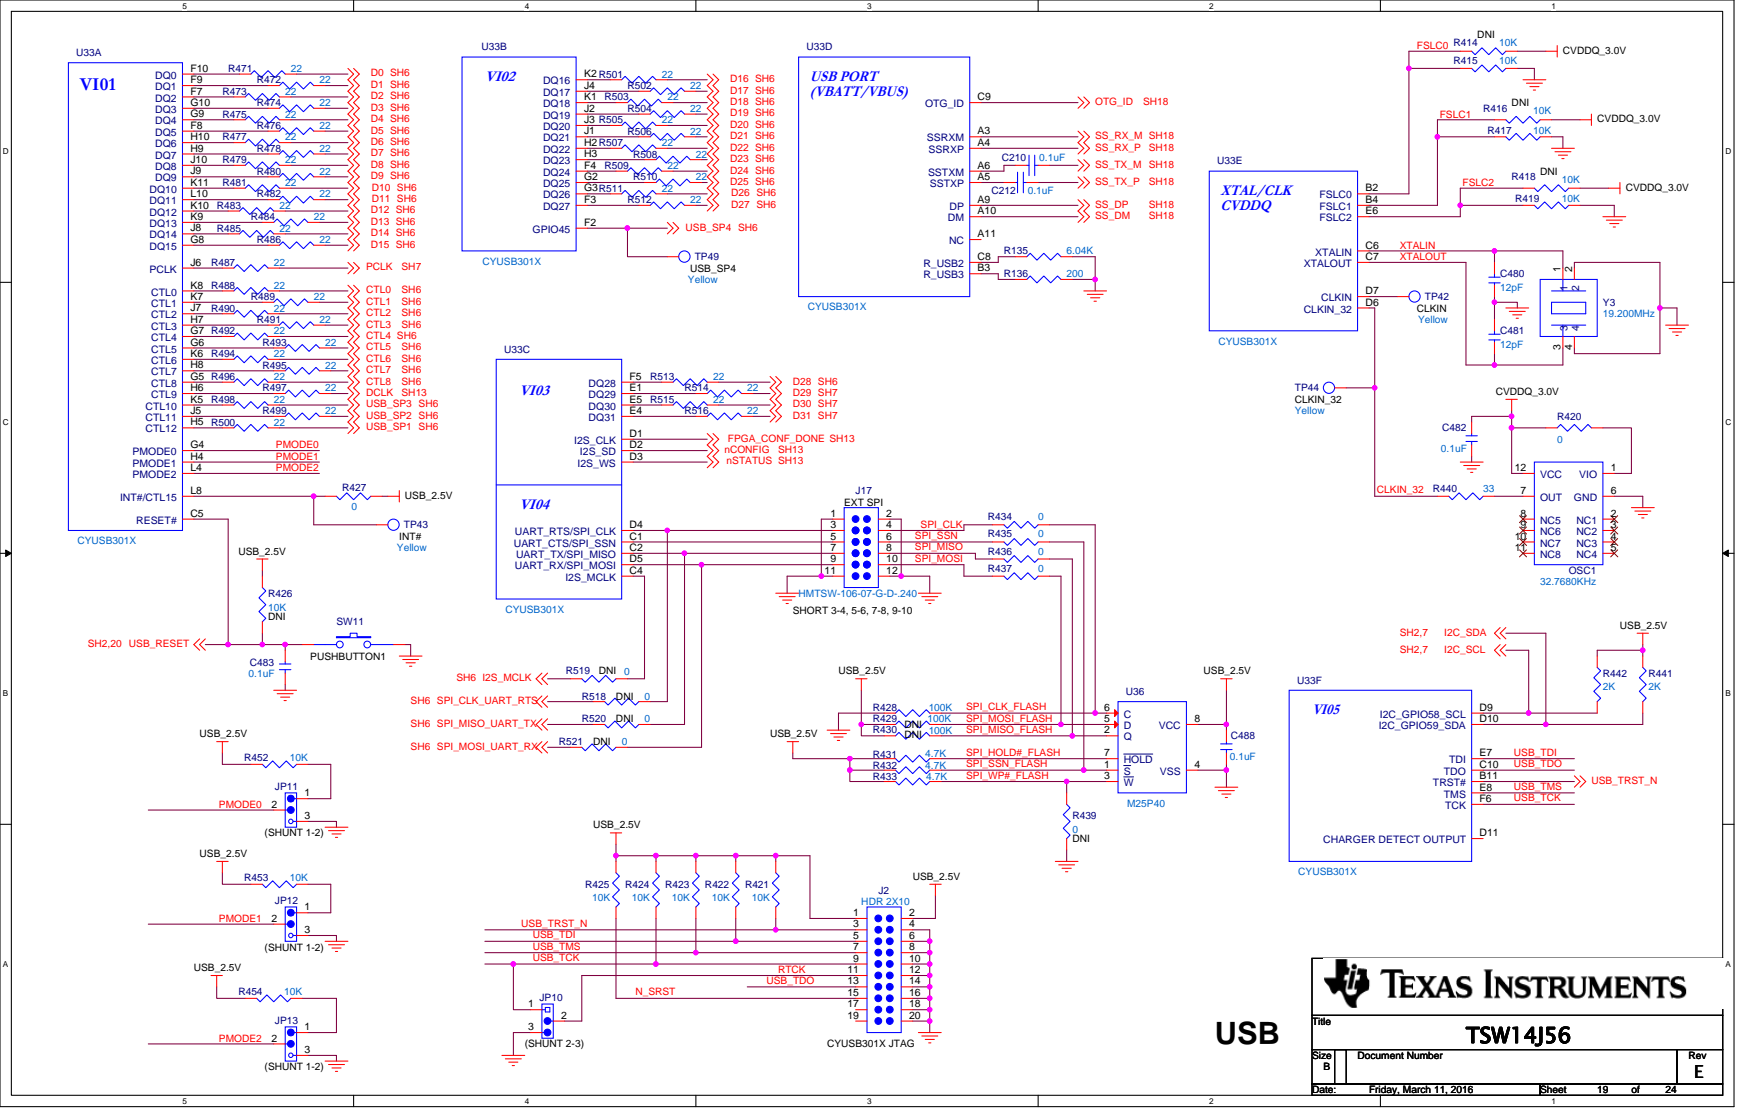
[picture p52: page 19]
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

Date: Date: Date: Friday, March 11, 2016 Friday, March 11, 2016 Friday, March 11, 2016 | Sheet Sheet Sheet 19 19 19 of of of 24 24 24

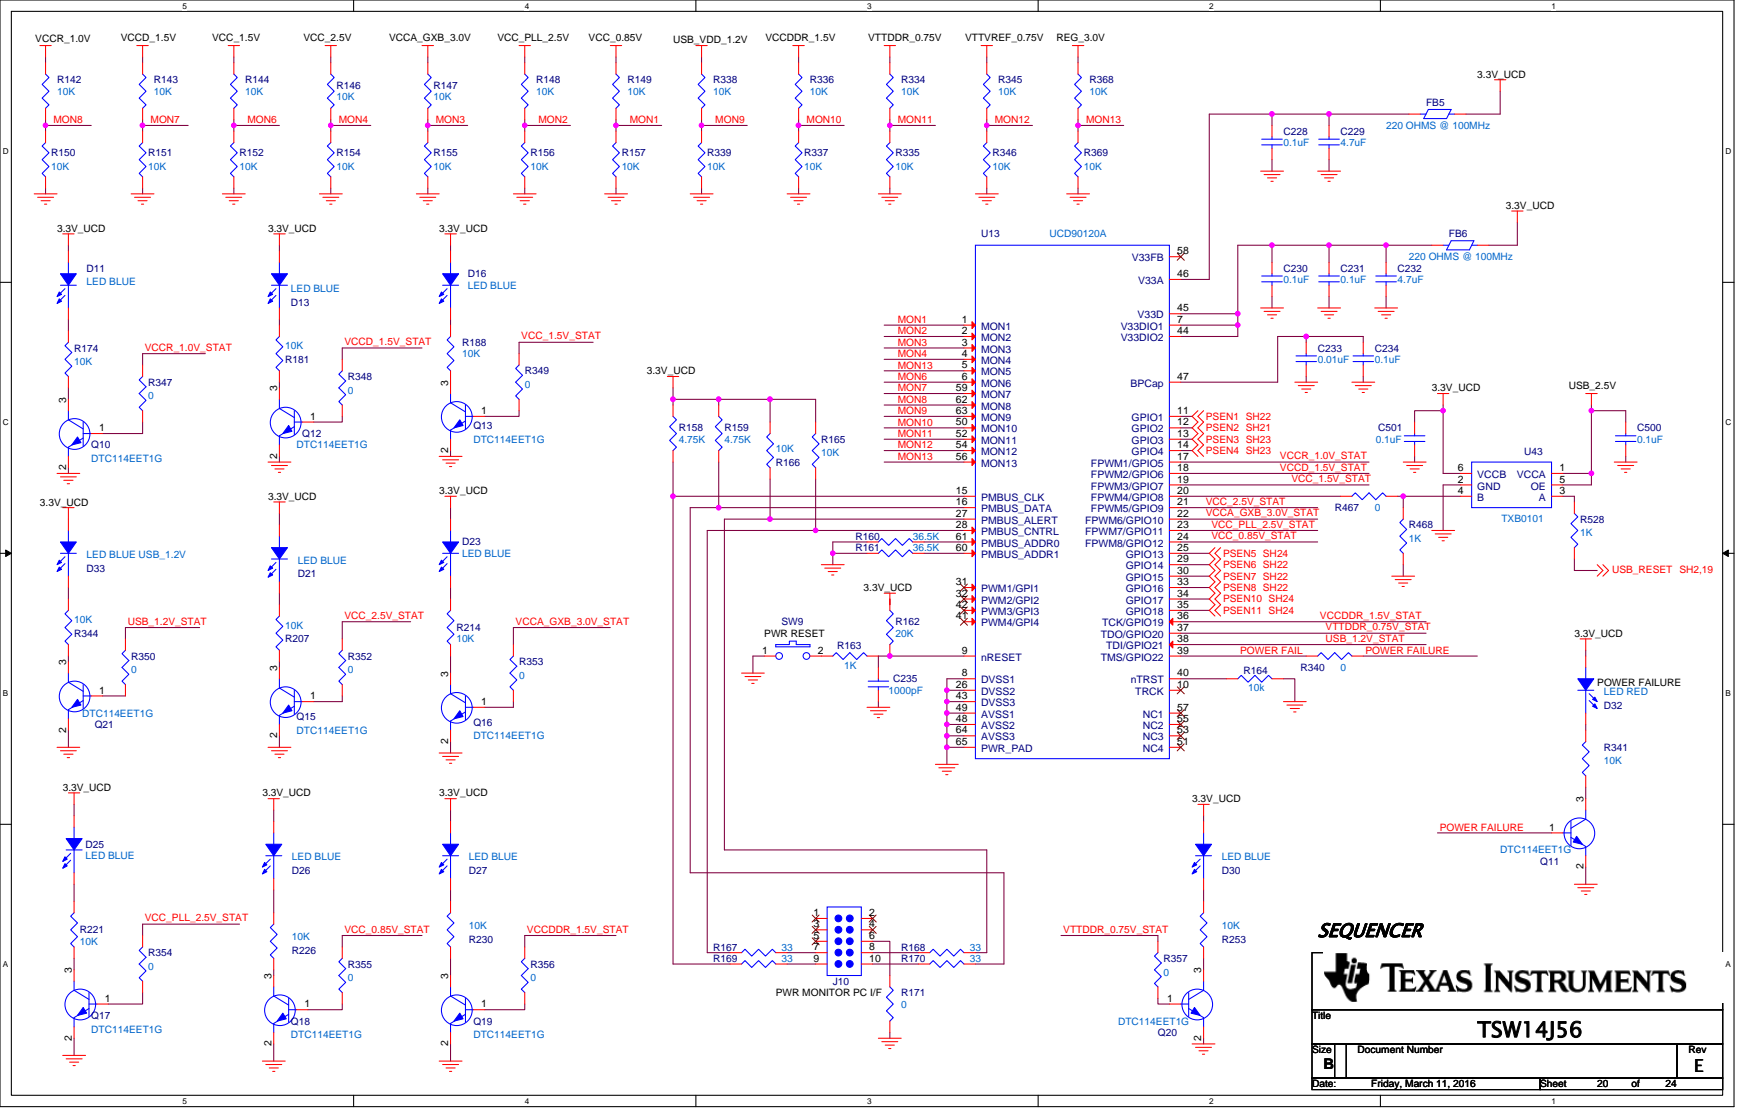
[picture p53: page 20]

PMBUS_DATA 16 | VCC_2.5V_STAT | 1K
PMBUS_ALERT 27 | VCCA_GXB_3.0V_STAT
PMBUS_CNTRL 28 | VCC_PLL_2.5V_STAT

R160 36.5K 3.3V_UCD SW9 R162 PWR RESET 20K | PMBUS_ADDR0 61 PMBUS_ADDR1 60 PWM1/GPI1 31 PWM2/GPI2 32 PWM3/GPI3 42 PWM4/GPI4 41 nRESET 9 | VCC_0.85V_STAT

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

Date: Date: Date: Friday, March 11, 2016 Friday, March 11, 2016 Friday, March 11, 2016 | Sheet Sheet Sheet 20 20 20 of of of 24 24 24

# 5V DC INPUT

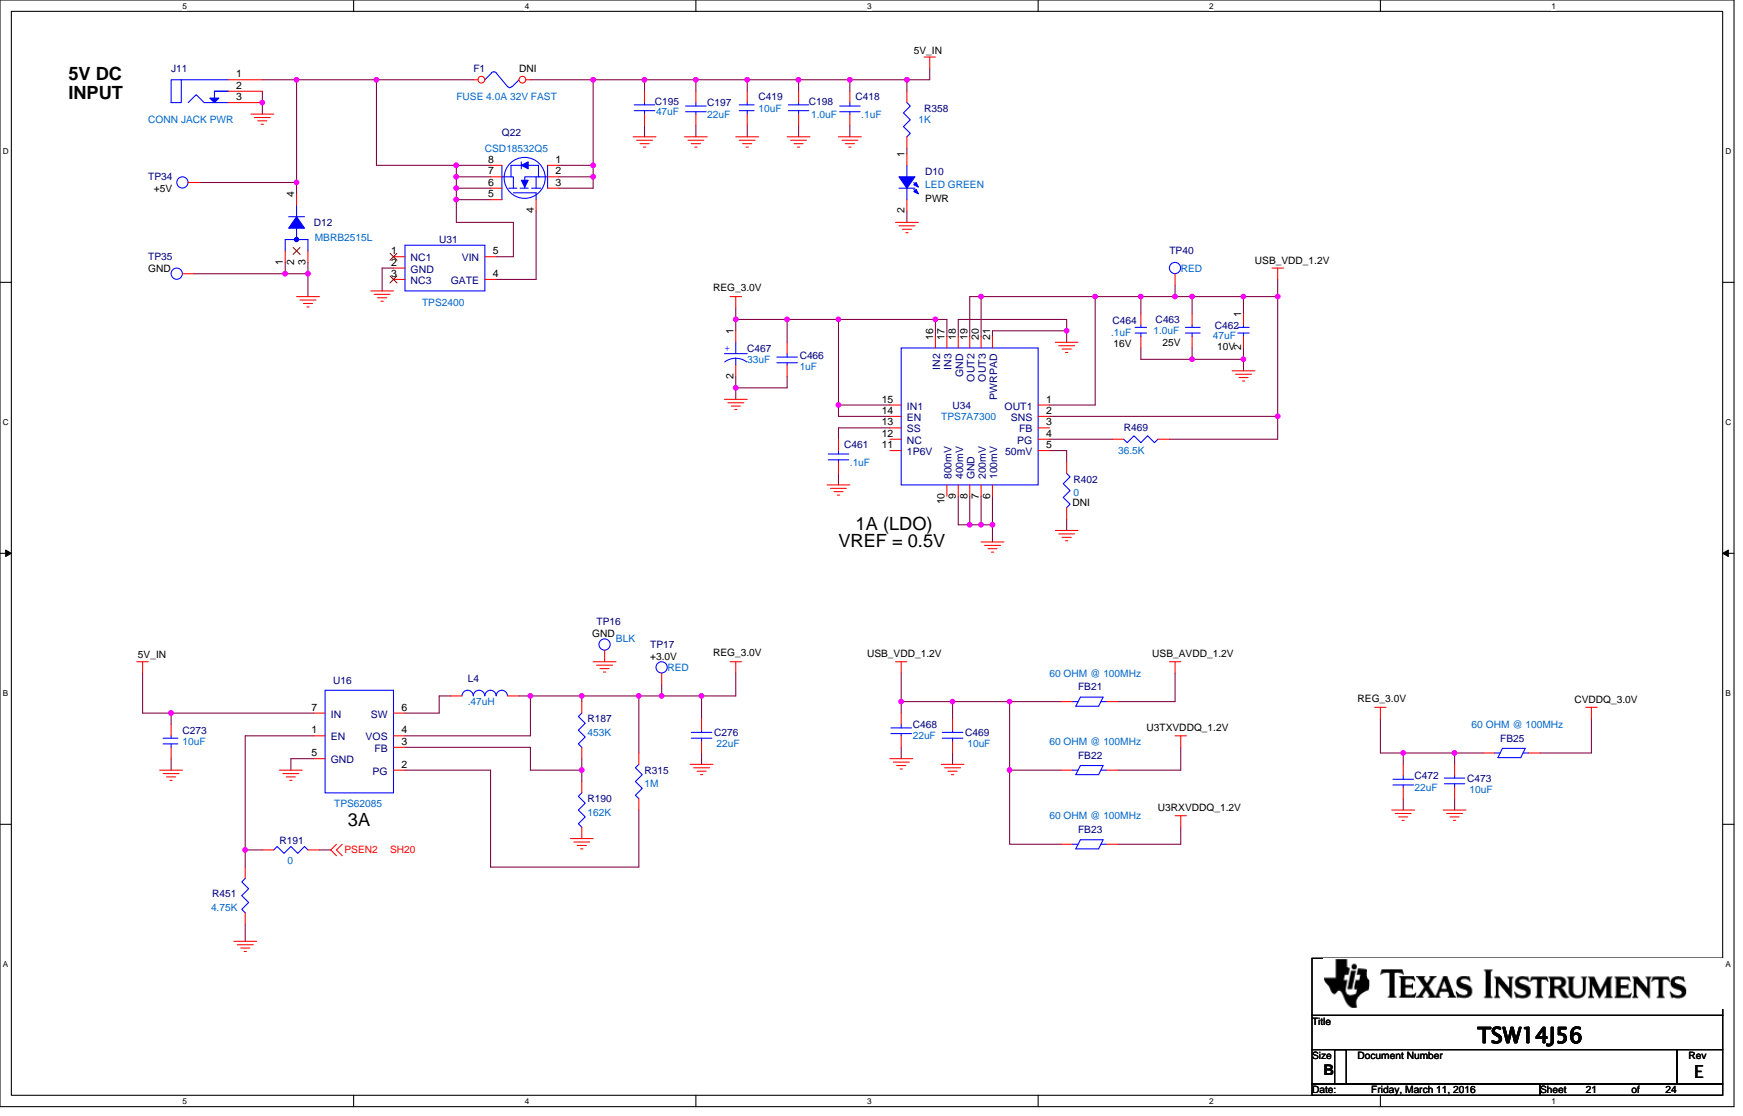
[picture p54: page 21]
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

Date: Date: Date: Friday, March 11, 2016 Friday, March 11, 2016 Friday, March 11, 2016 | Sheet Sheet Sheet 21 21 21 of of of 24 24 24

1.2A

3A

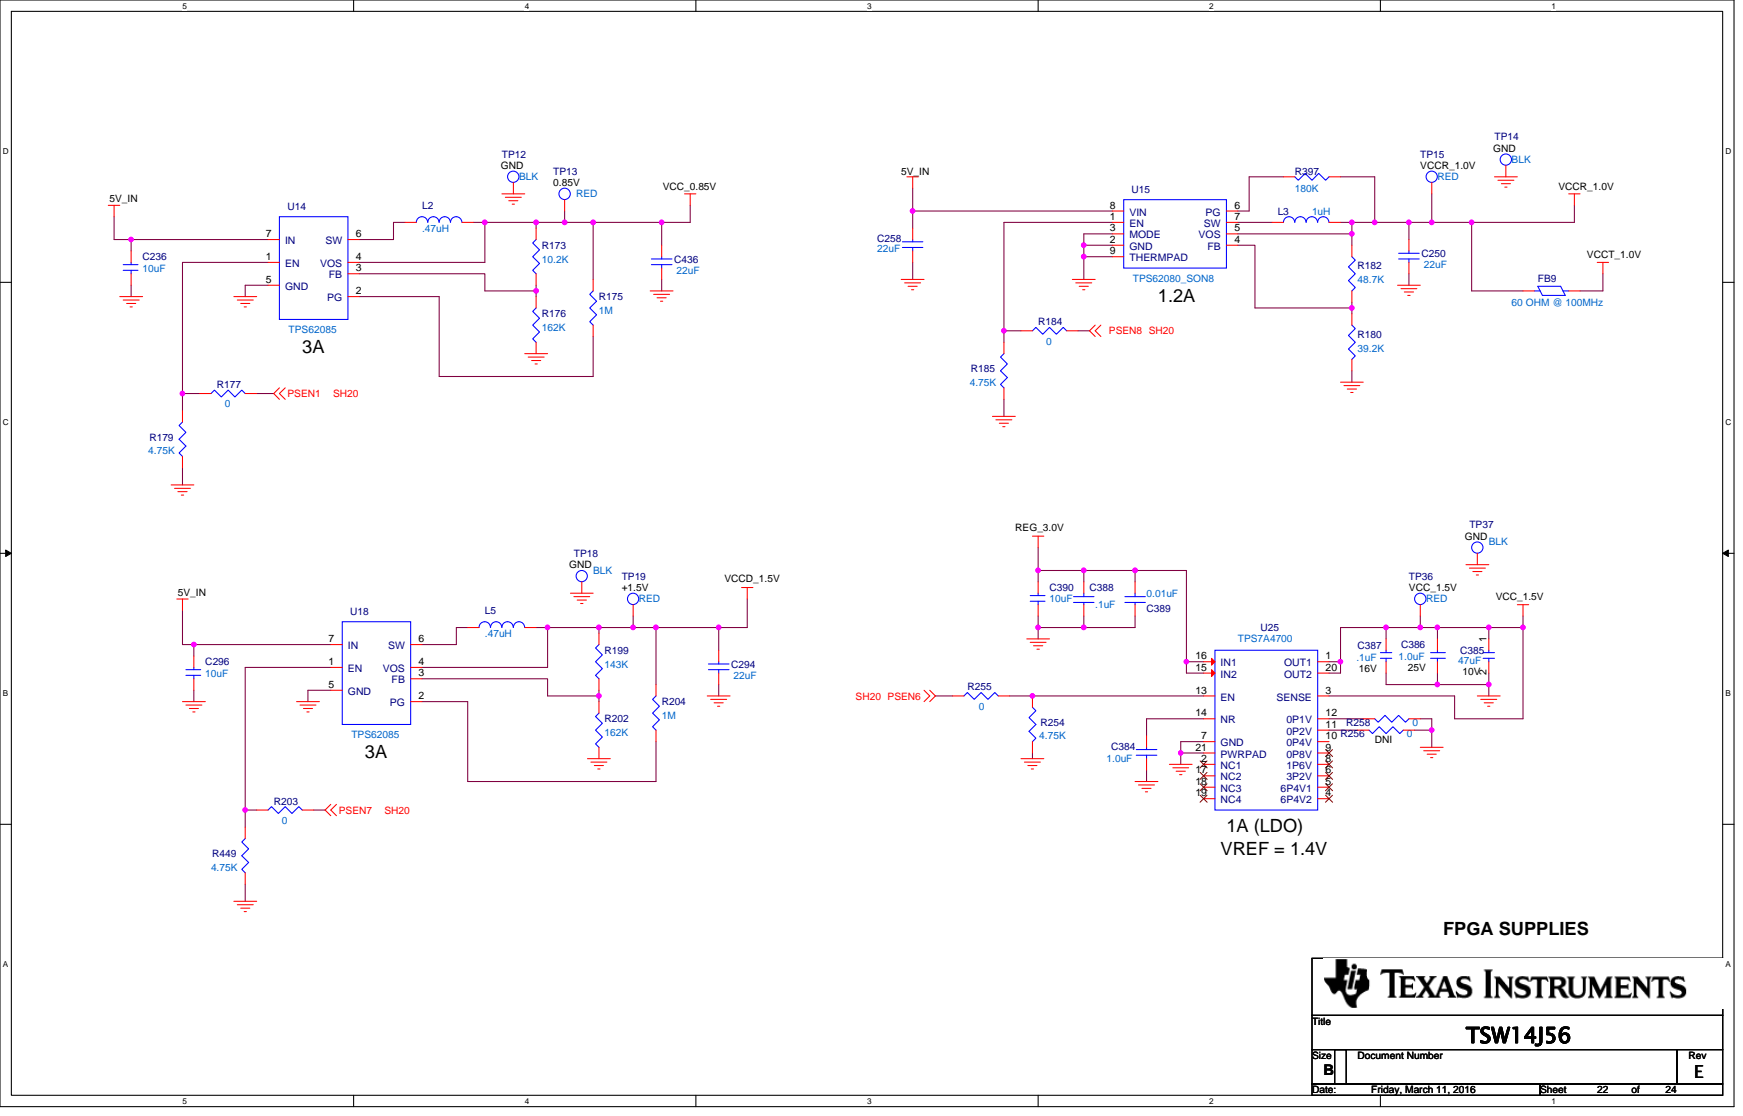
[picture p55: page 22]
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

Date: Date: Date: Friday, March 11, 2016 Friday, March 11, 2016 Friday, March 11, 2016 | Sheet Sheet Sheet 22 22 22 of of of 24 24 24

# 3A (LDO) 3A (LDO)

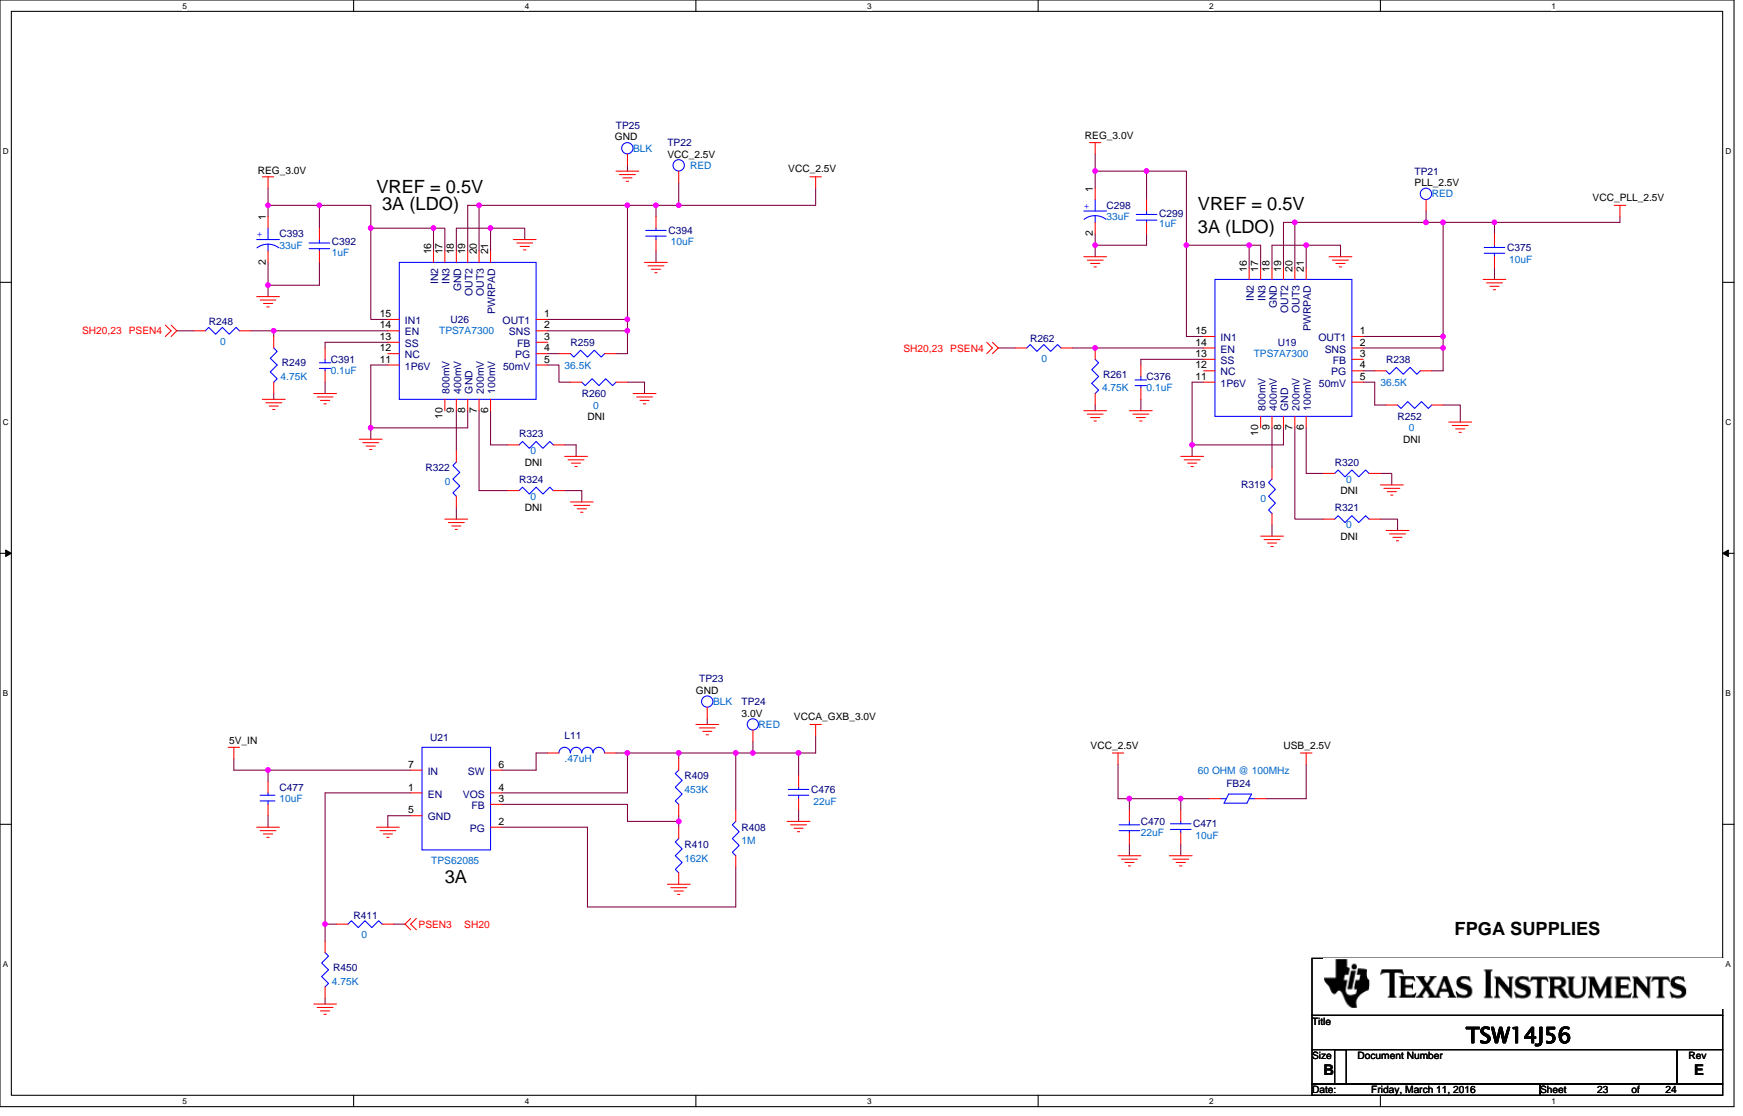
[picture p56: page 23]
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

Date: Date: Date: Friday, March 11, 2016 Friday, March 11, 2016 Friday, March 11, 2016 | Sheet Sheet Sheet 23 23 23 of of of 24 24 24

# 1.5V (DDR3)

3A

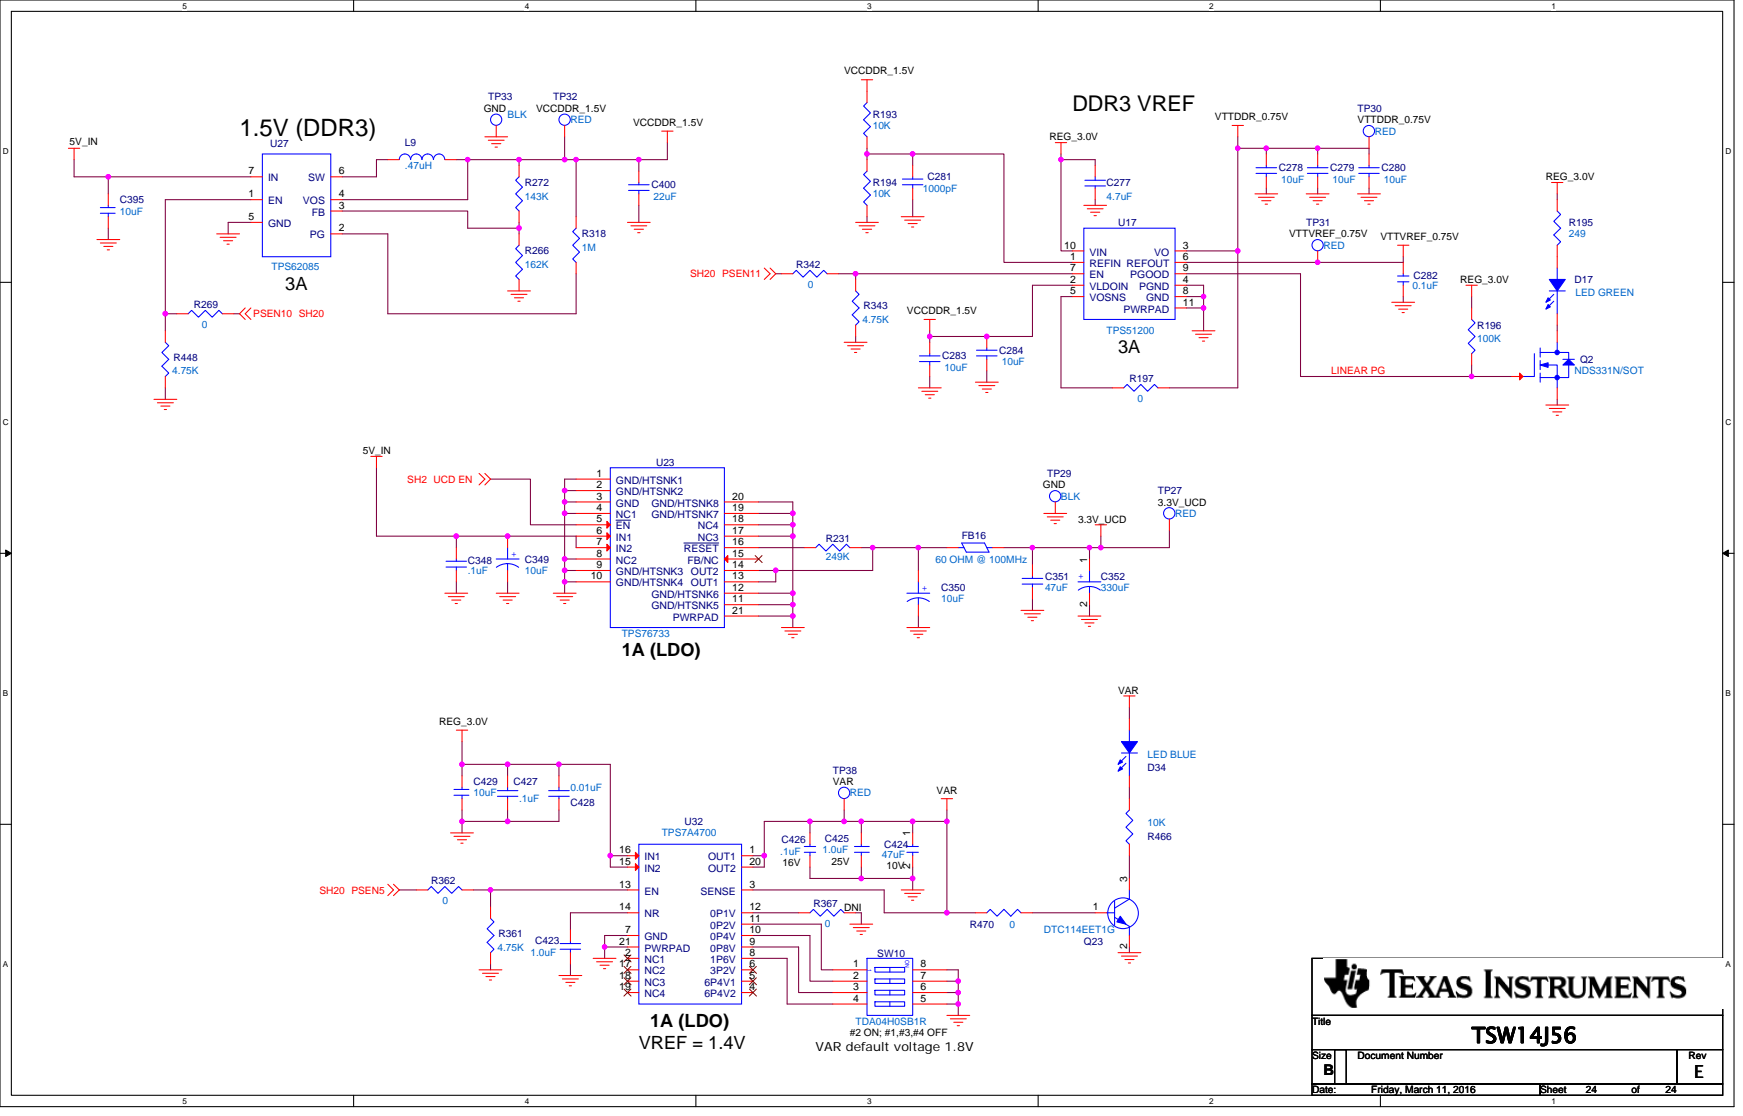
[picture p57: page 24]
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

Date: Date: Date: Friday, March 11, 2016 Friday, March 11, 2016 Friday, March 11, 2016 | Sheet Sheet Sheet 24 24 24 of of of 24 24 24
