Anastien/AWG1000/hardware/01-ECAD/02-Documentation/KITPF3000FRDMPGM/SPF-28637_B.pdf

### ADC : - VDDOTP_SNS moved from ADC_SE11

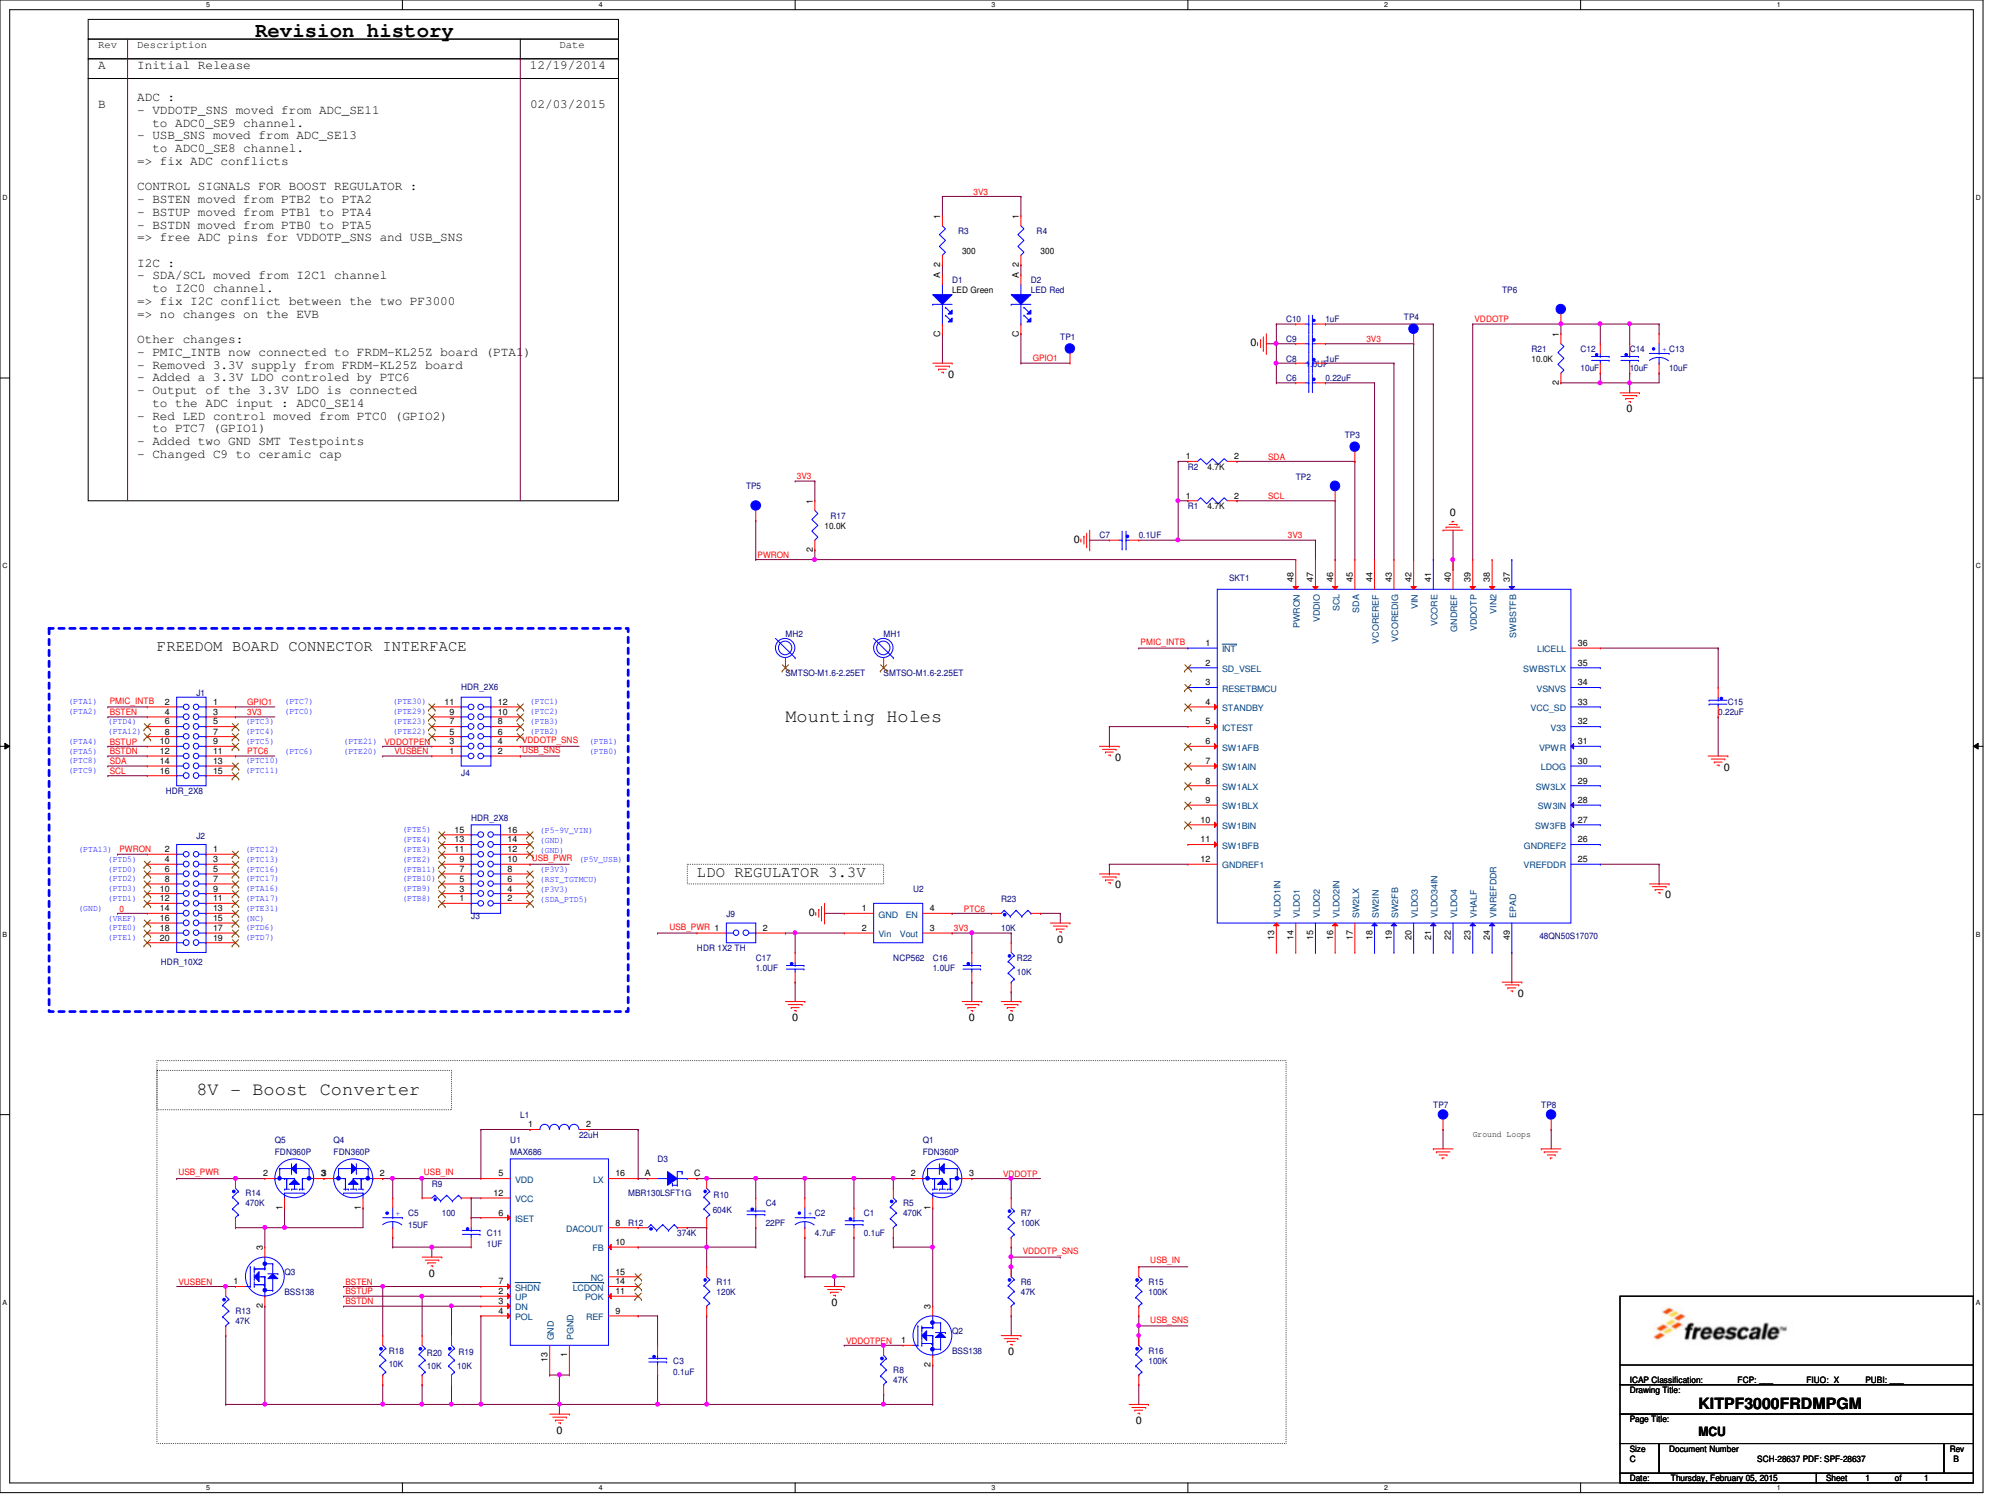
[picture p58: page 1]

CONTROL SIGNALS FOR BOOST REGULATOR :
- BSTEN moved from PTB2 to PTA2
- BSTUP moved from PTB1 to PTA4
- BSTDN moved from PTB0 to PTA5
=> free ADC pins for VDDOTP_SNS and USB_SNS

- SDA/SCL moved from I2C1 channel
to I2C0 channel.
=> fix I2C conflict between the two PF3000
=> no changes on the EVB

Other changes:
- PMIC_INTB now connected to FRDM-KL25Z board (PTA1)
- Removed 3.3V supply from FRDM-KL25Z board
- Added a 3.3V LDO controled by PTC6
- Output of the 3.3V LDO is connected
to the ADC input : ADC0_SE14
- Red LED control moved from PTC0 (GPIO2)
to PTC7 (GPIO1)
- Added two GND SMT Testpoints
- Changed C9 to ceramic cap

FREEDOM BOARD CONNECTOR INTERFACE
