Anastien/AWG1000/hardware/01-ECAD/02-Documentation/HCT651GG101F-V0 Model (1).pdf

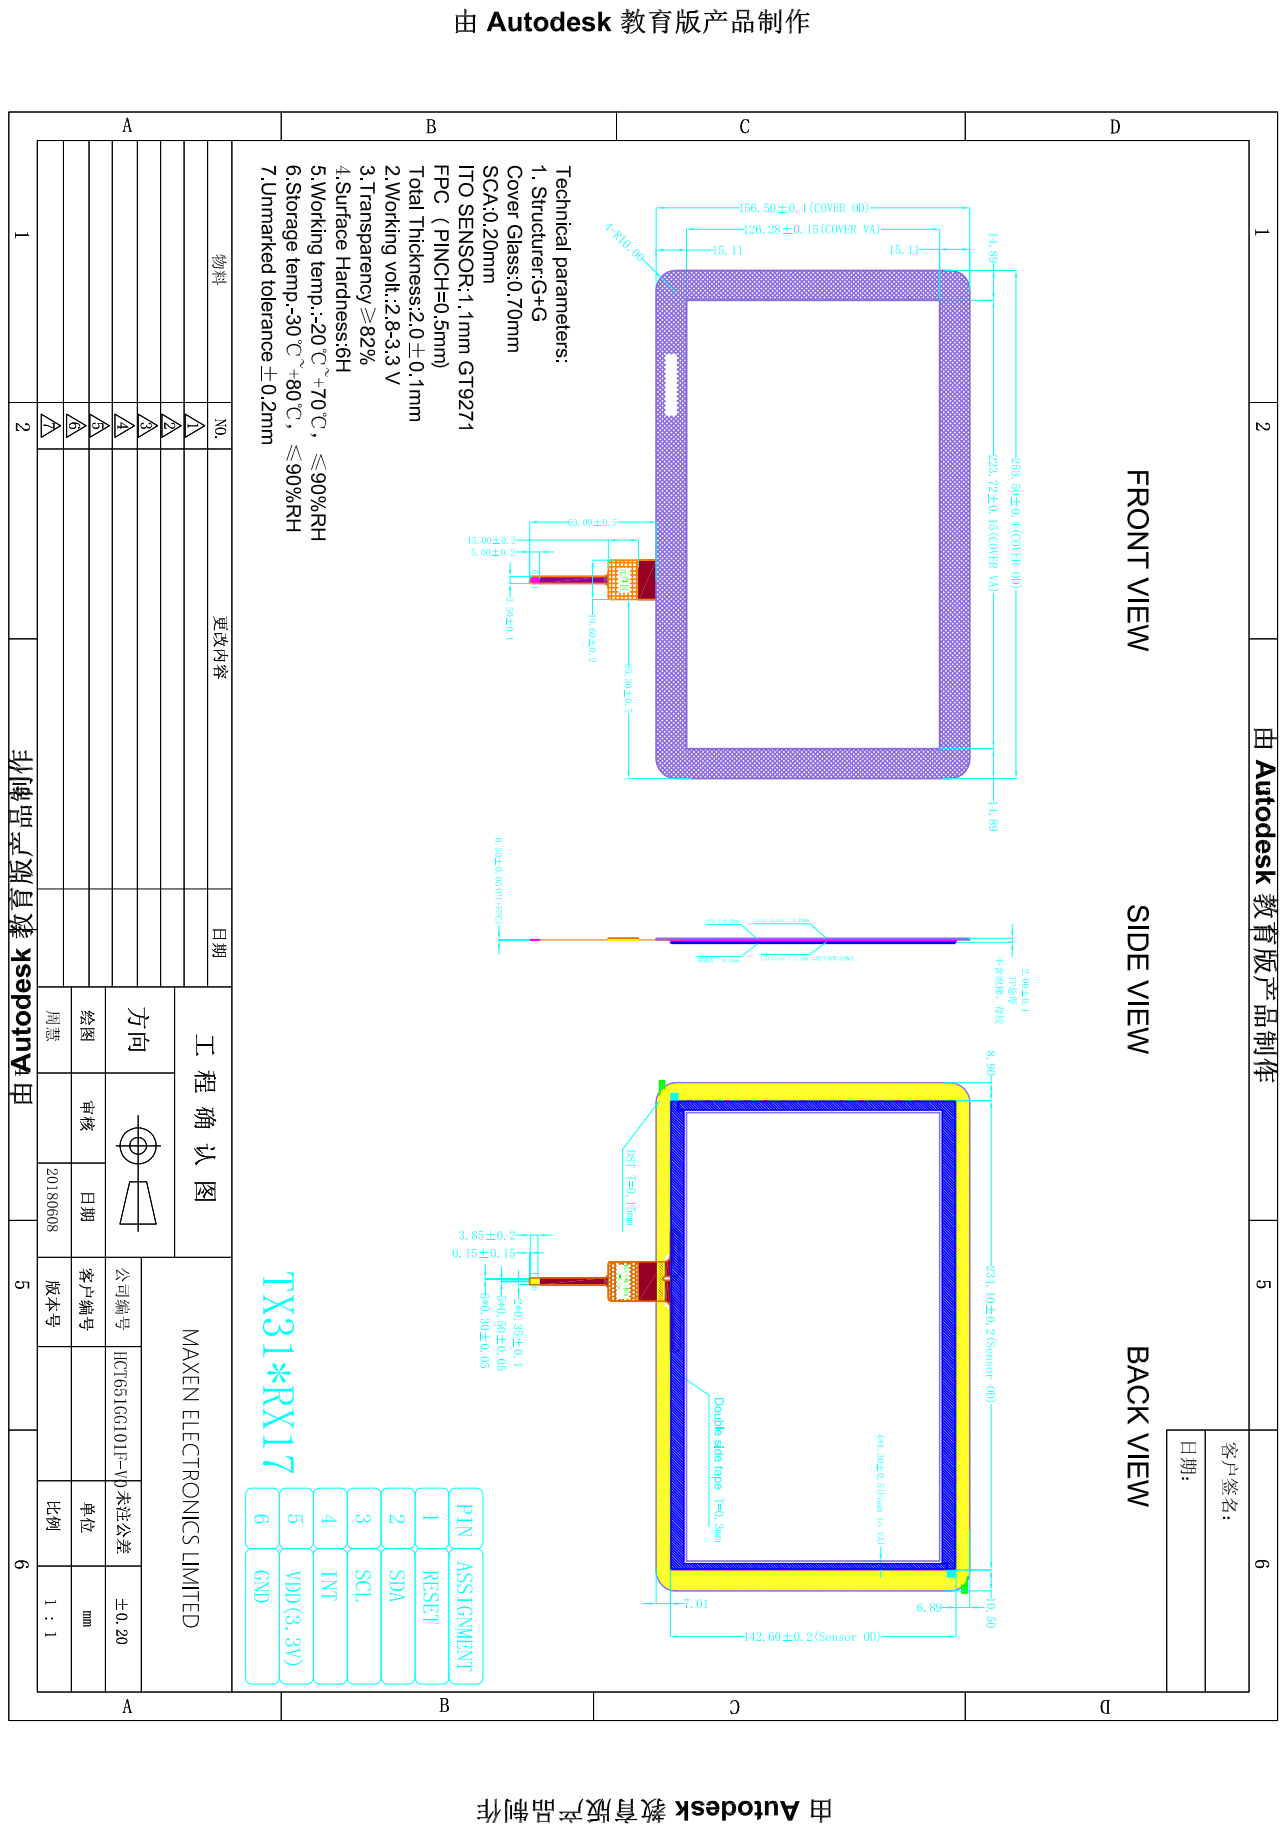
[picture p59: page 1]
