Anastien/AWG1000/hardware/01-ECAD/02-Documentation/dac/DAC348XEVM-LYR_H.pdf

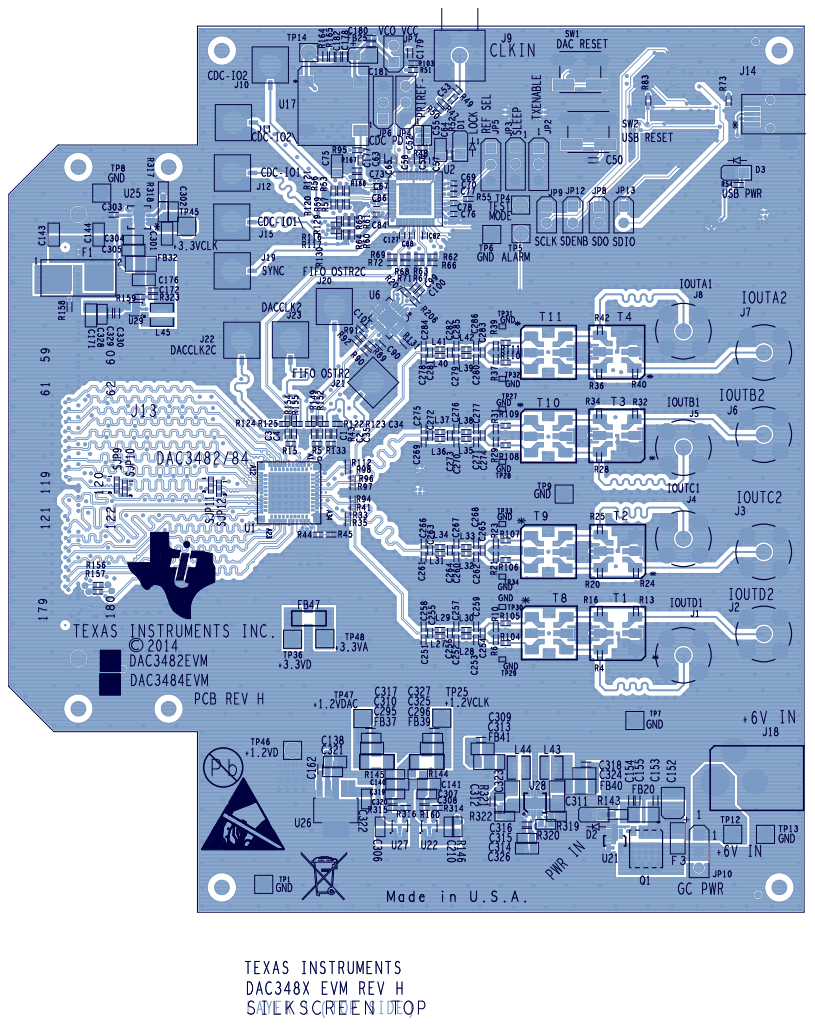
[picture p60: page 1]

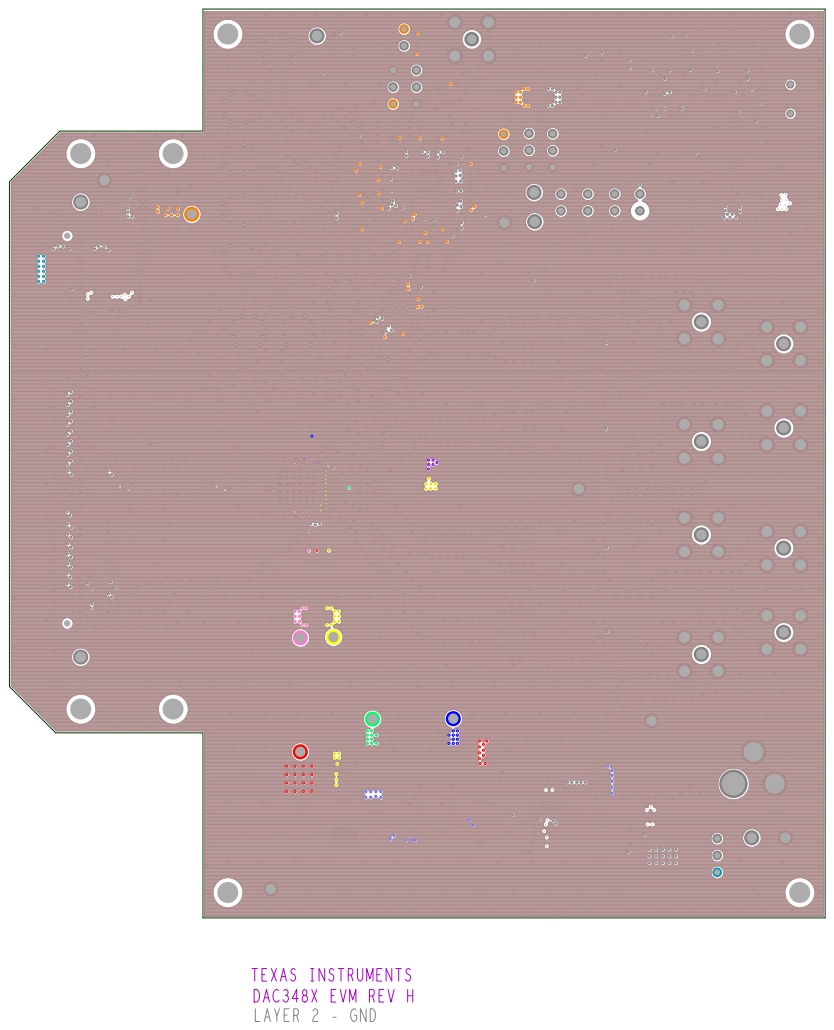
[picture p61: page 2]

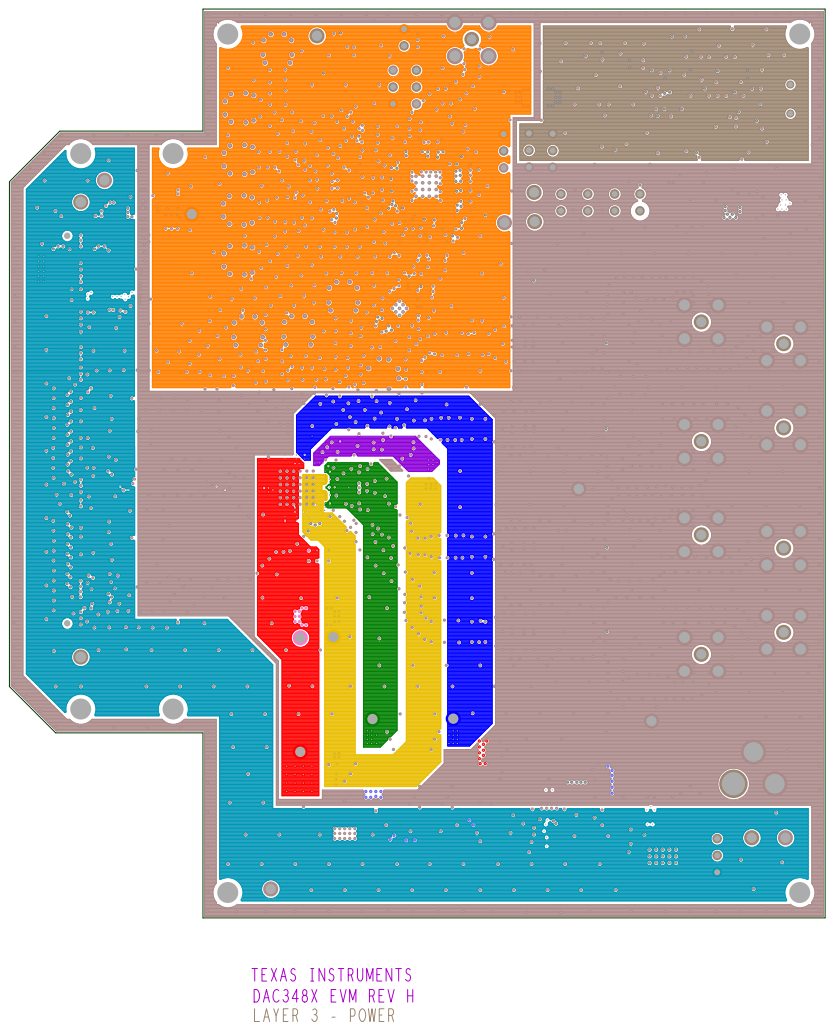
[picture p62: page 3]

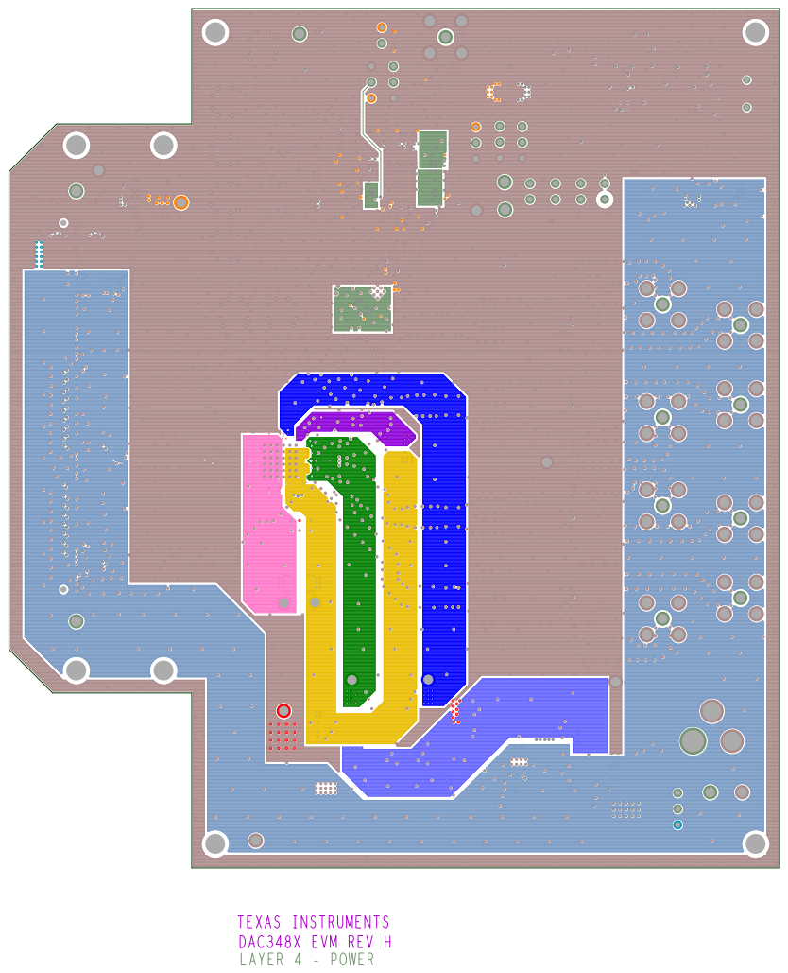
[picture p63: page 4]

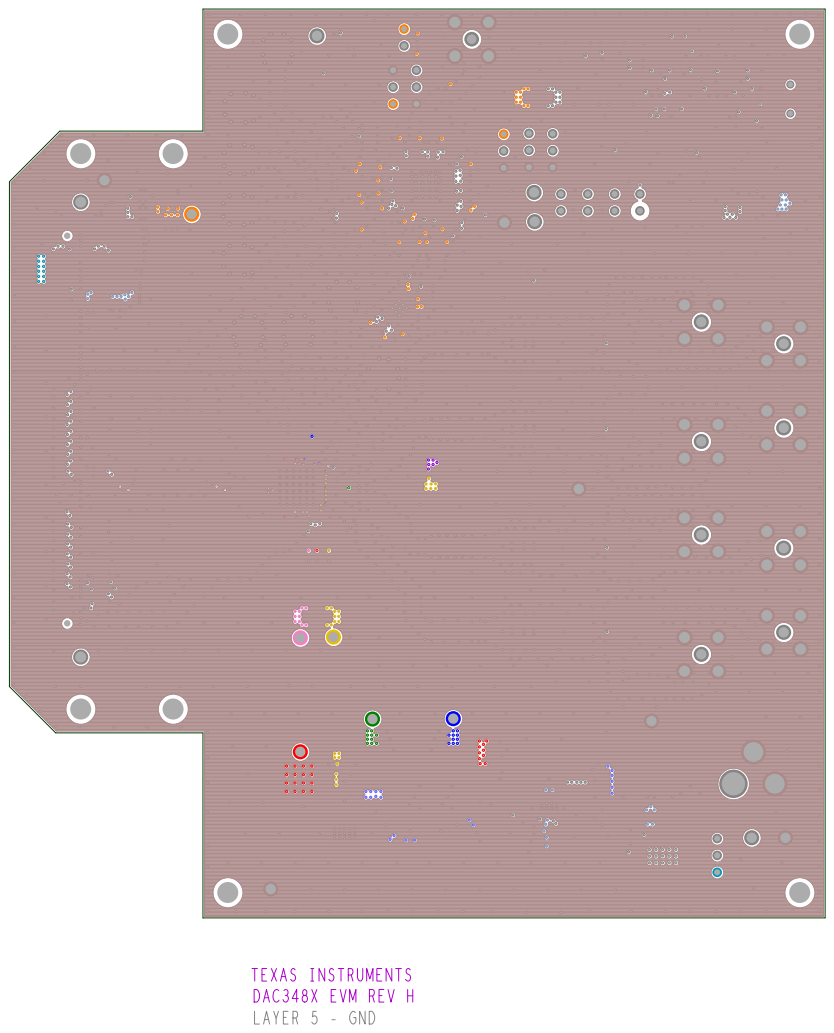
[picture p64: page 5]

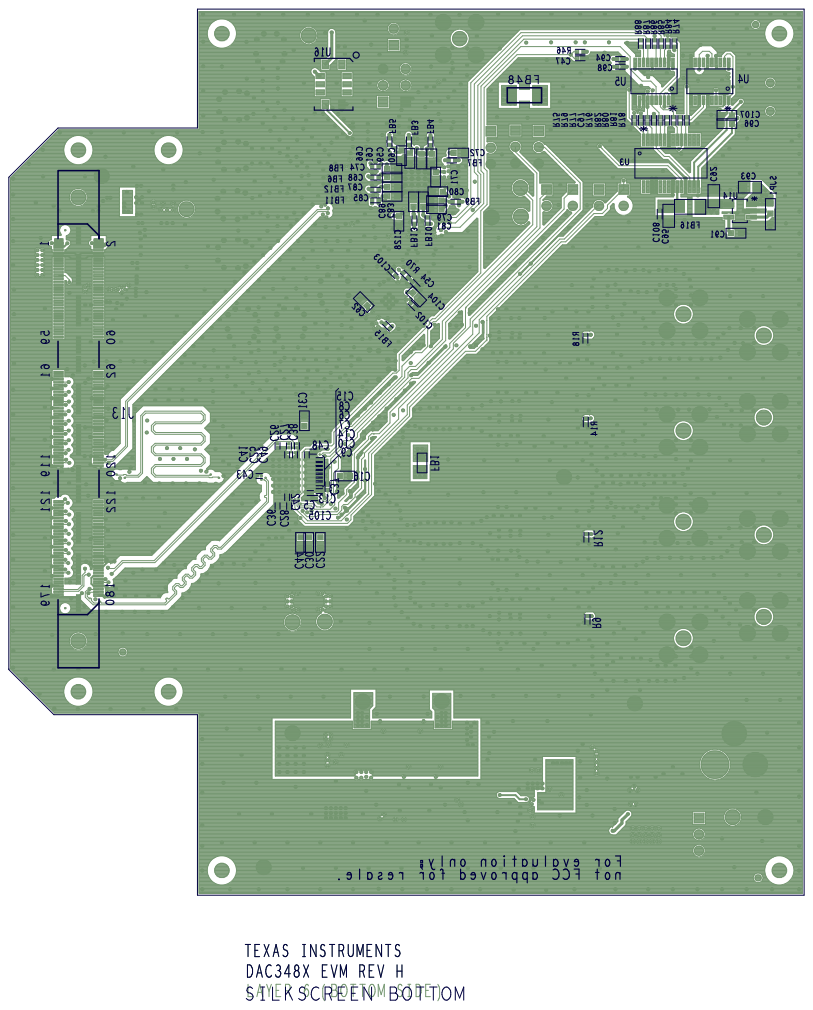
[picture p65: page 6]

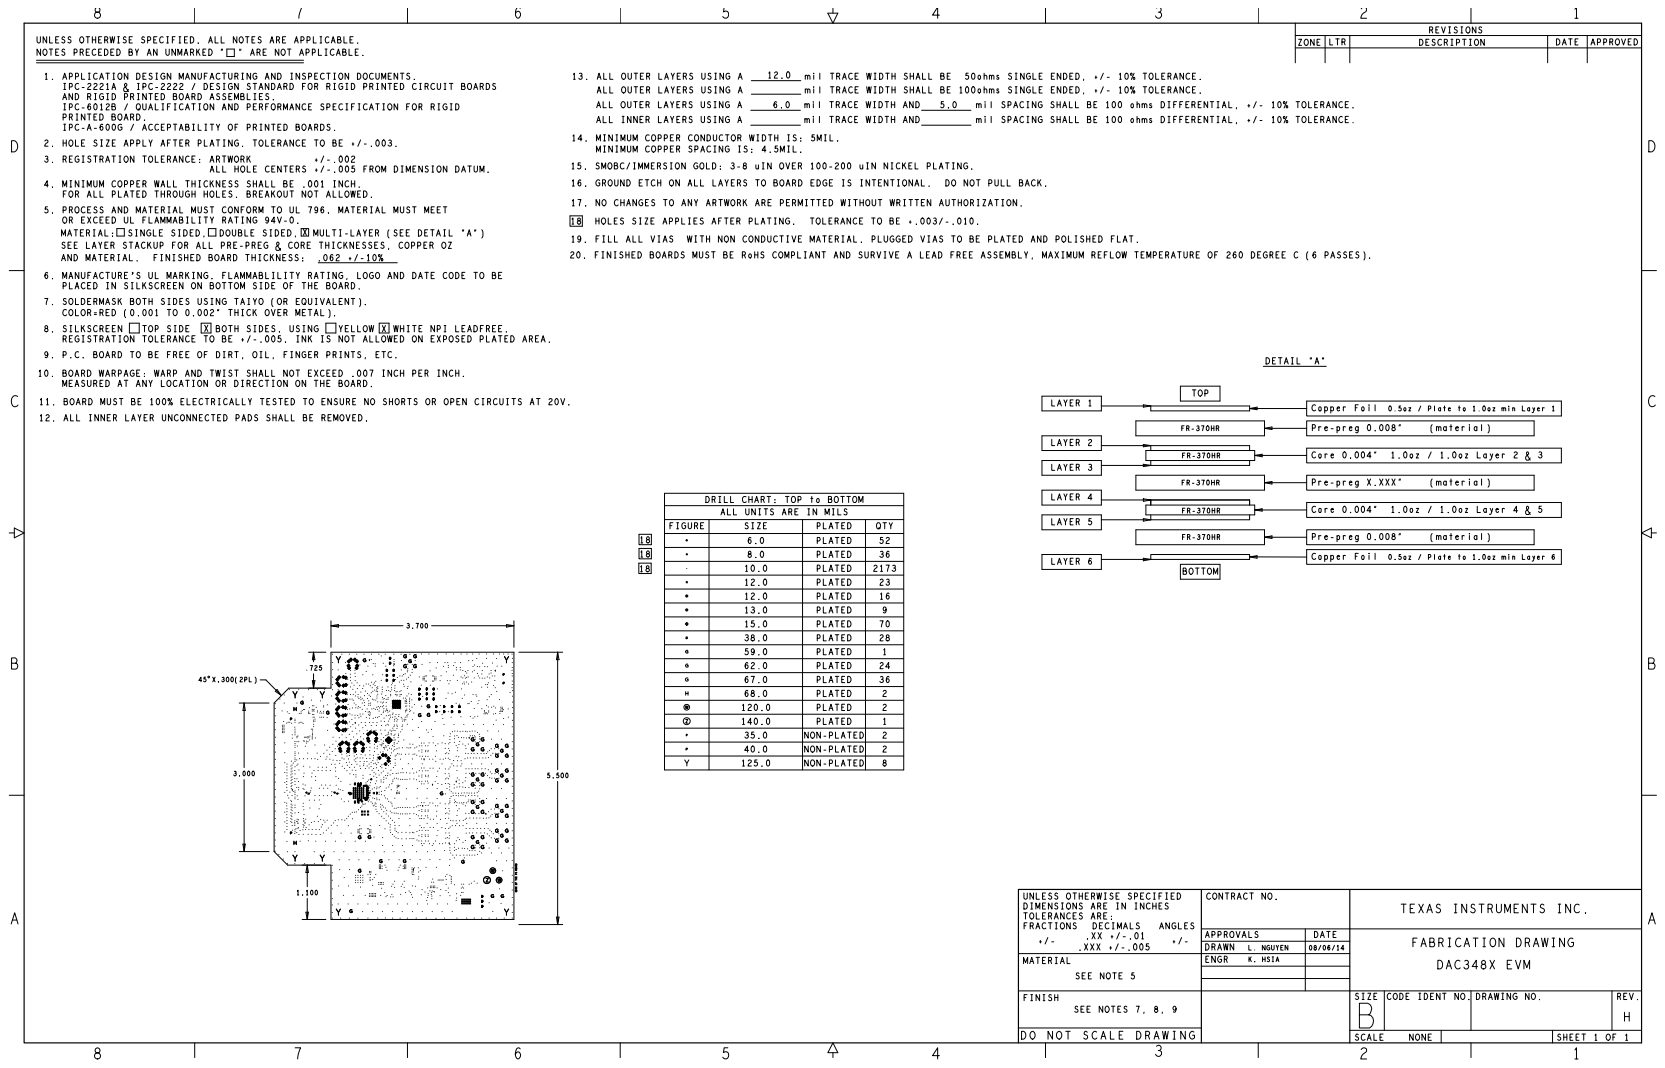
[picture p66: page 7]
