Anastien/AWG1000/hardware/01-ECAD/02-Documentation/data gen/TSW1406_B_LYR.pdf

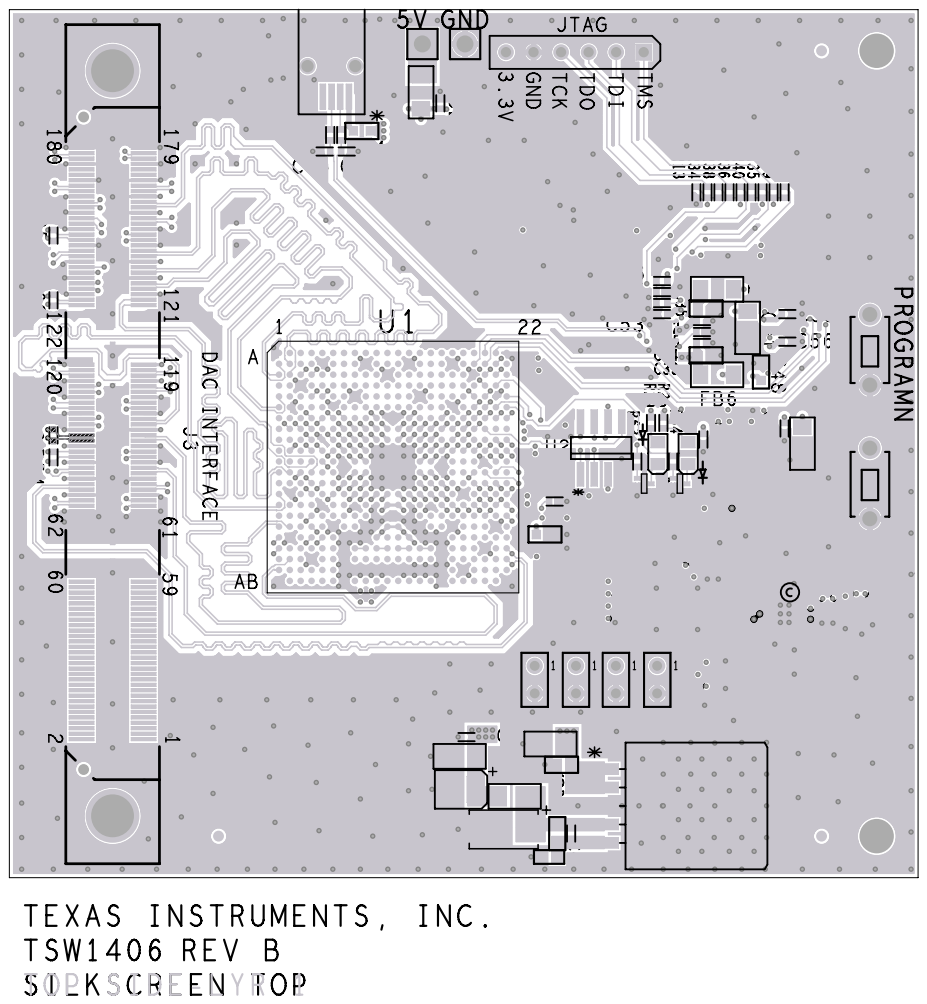
[picture p67: page 1]

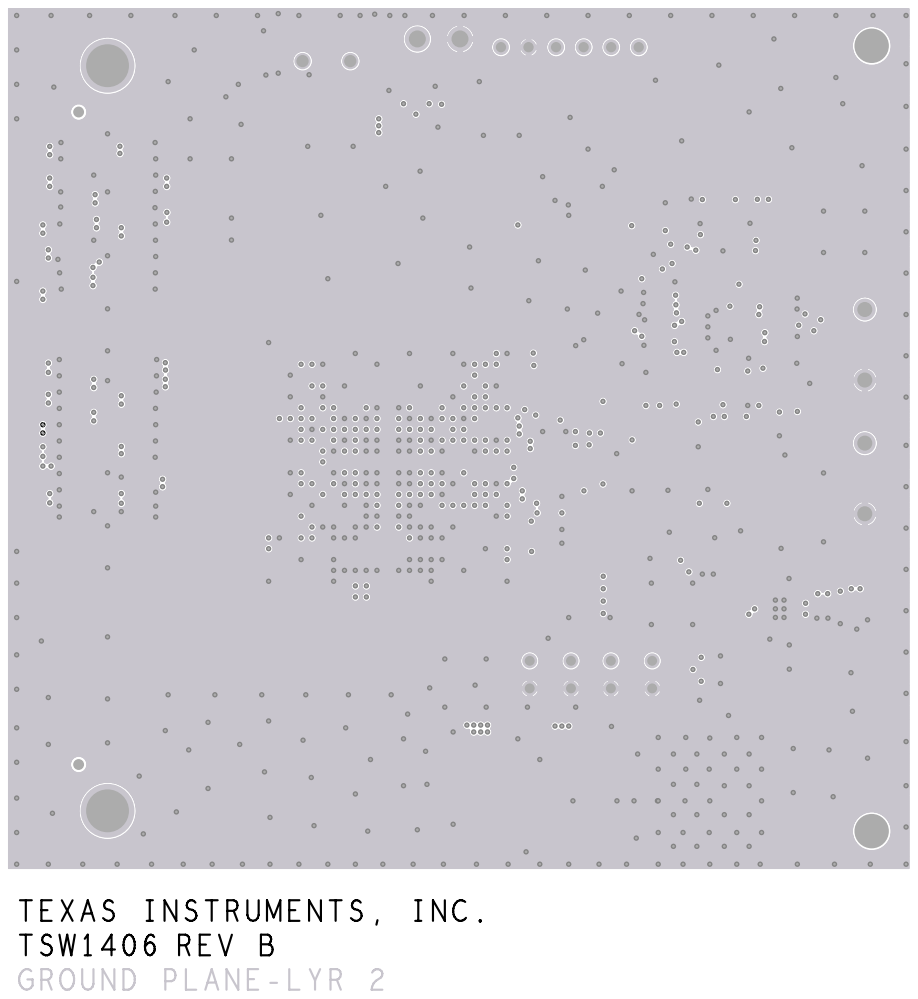
[picture p68: page 2]

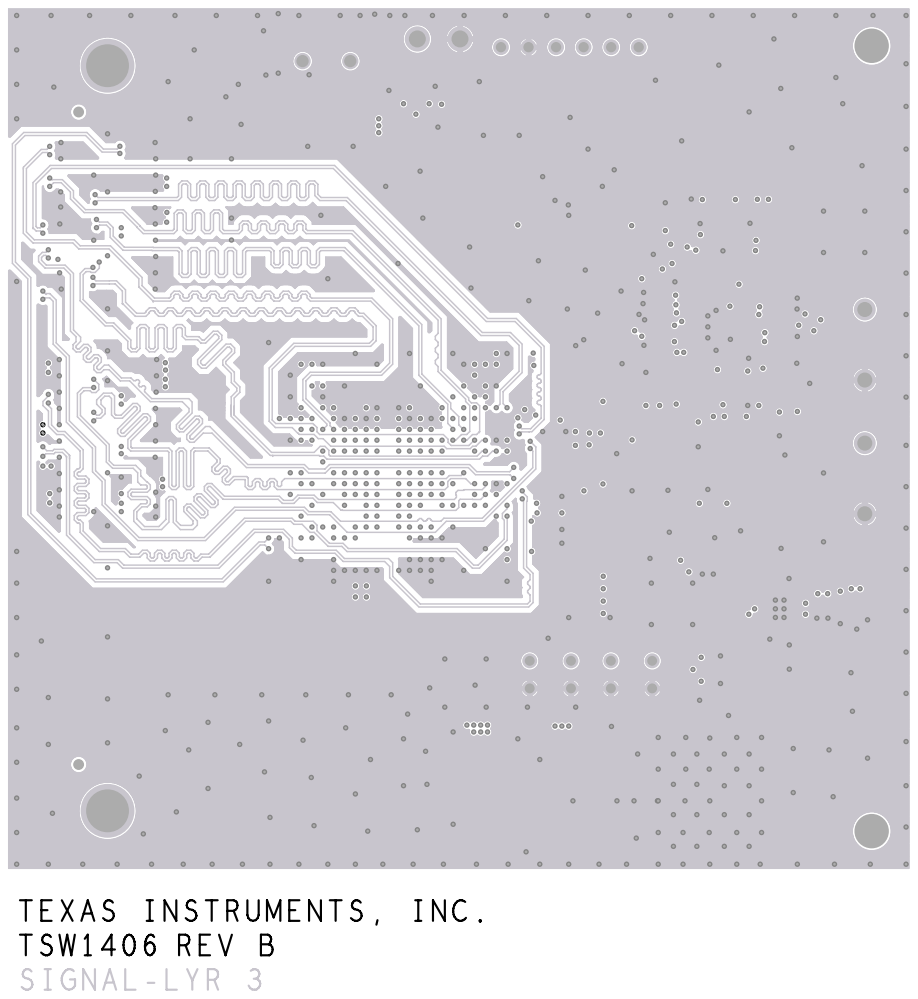
[picture p69: page 3]

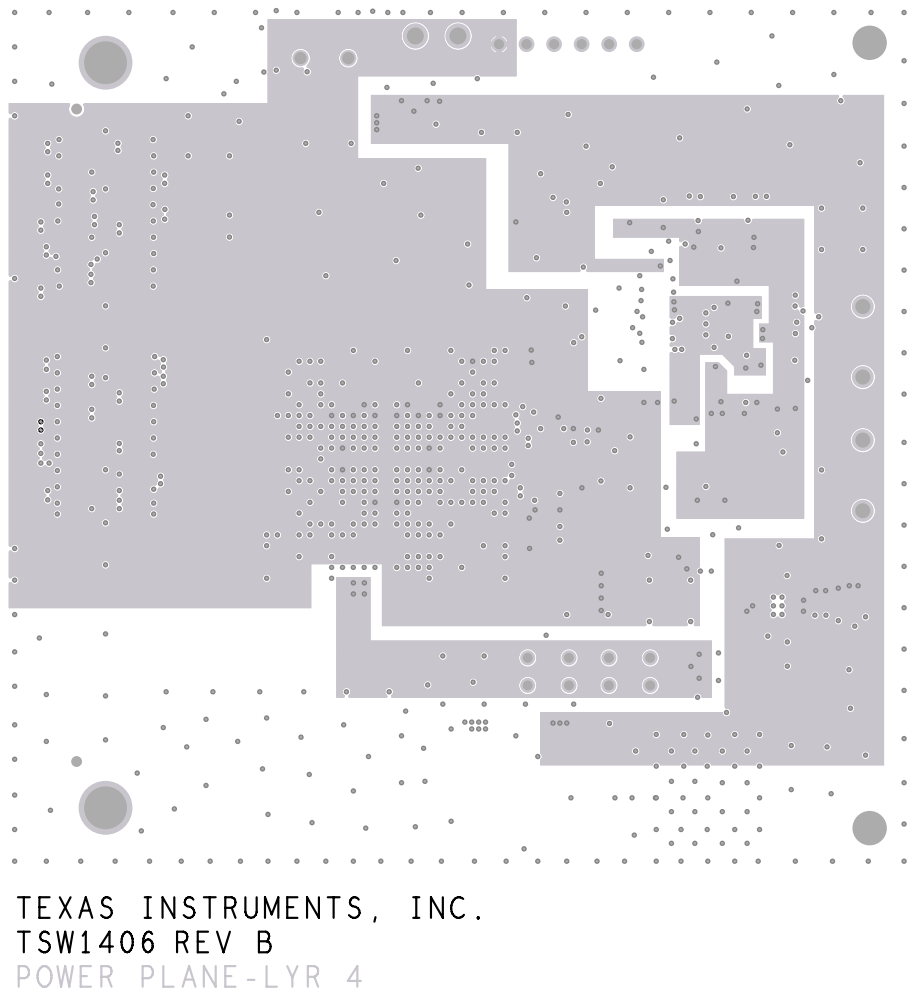
[picture p70: page 4]

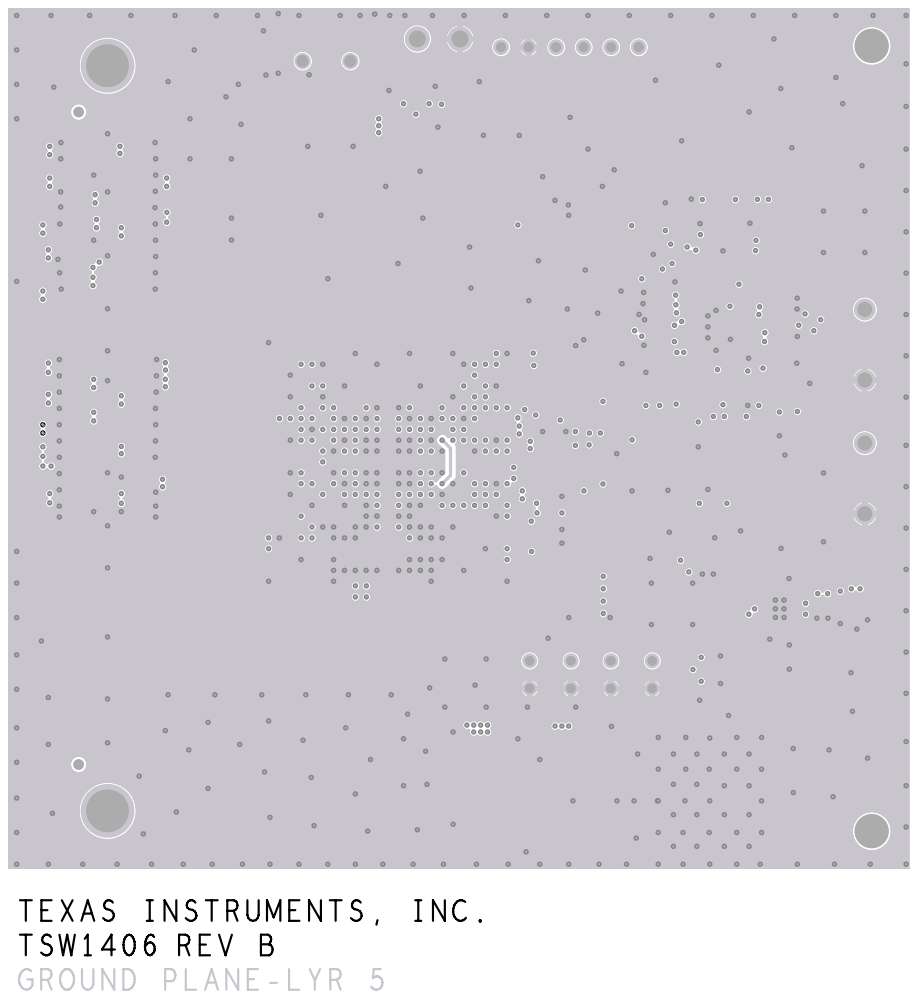
[picture p71: page 5]

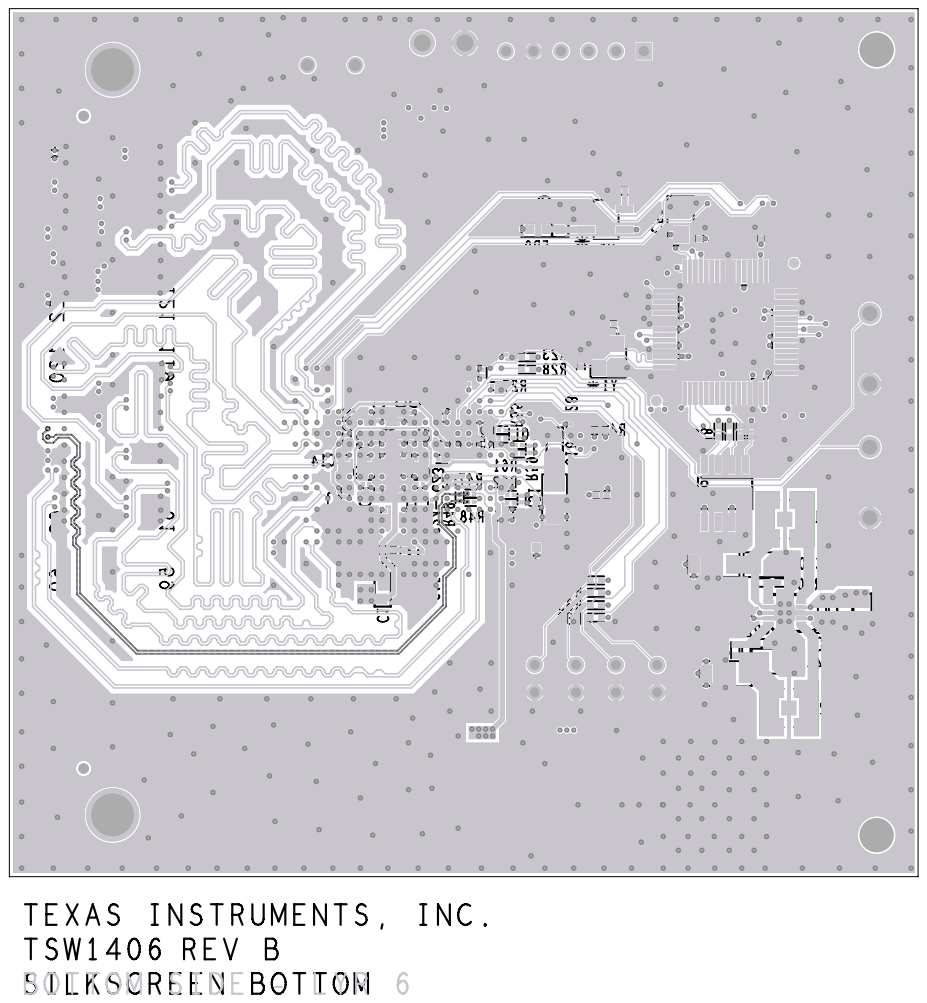
[picture p72: page 6]
