Anastien/AWG1000/hardware/01-ECAD/02-Documentation/TSW14J56EVM-DesignPkg_E/TSW14J56-ASY_E.pdf

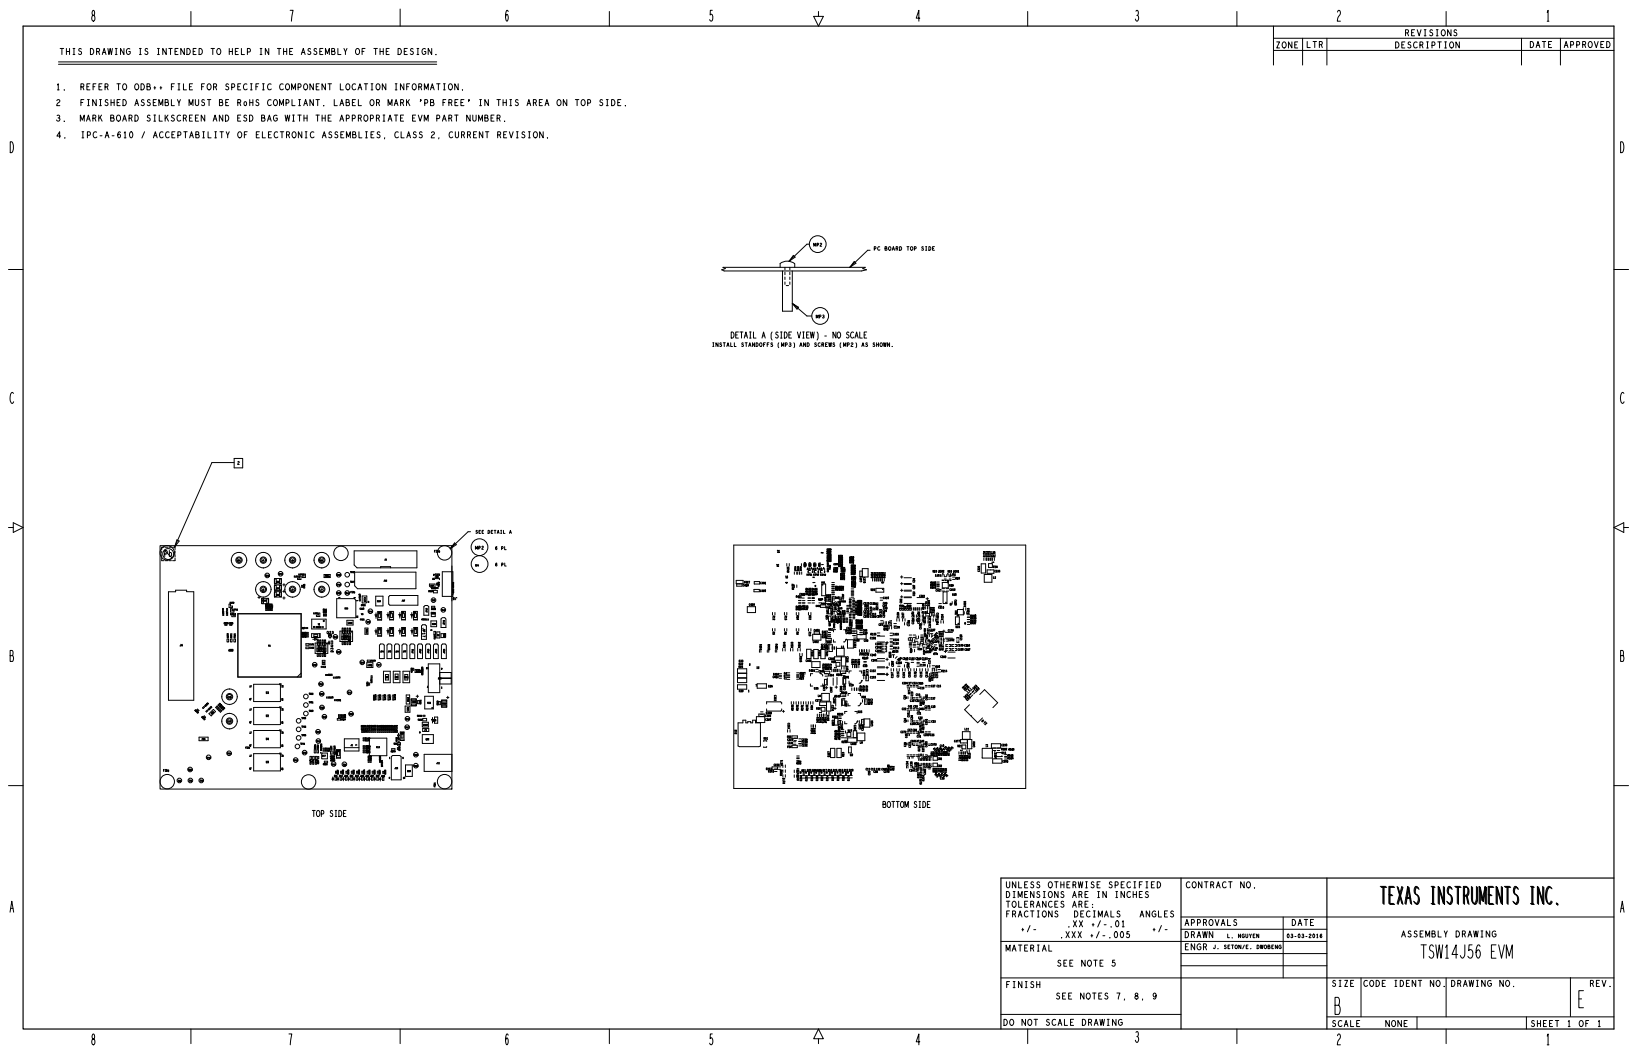
[picture p73: page 1]
