Anastien/AWG1000/hardware/01-ECAD/02-Documentation/SABRE-AI_DualLite_CPUcard/27142_GRB_ODB_REF_v2/REF-27142_revC.pdf

+

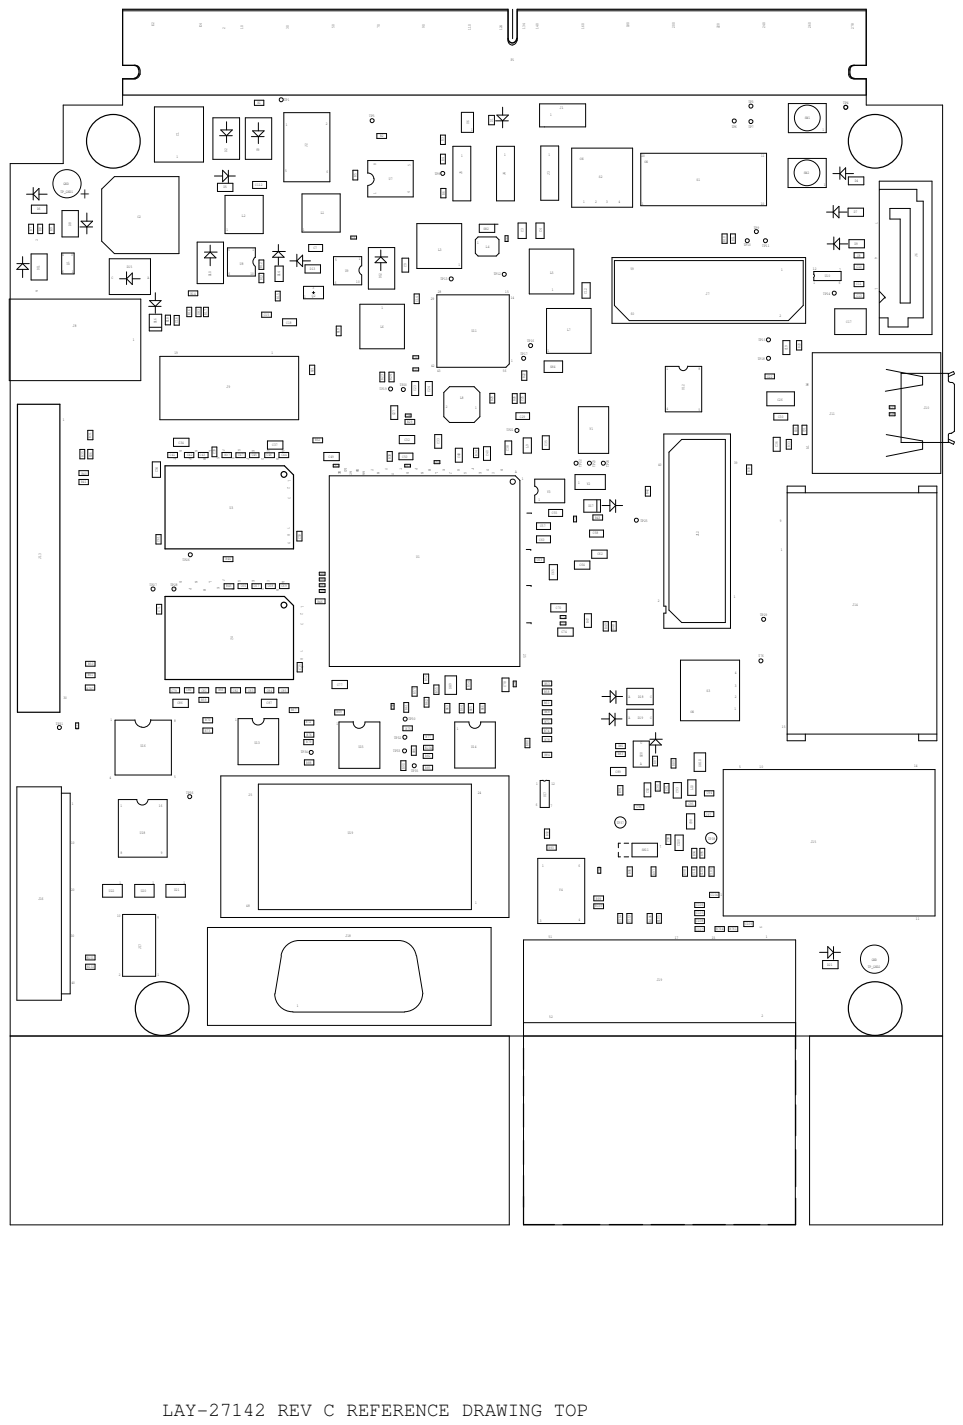
[picture p74: page 1]

LAY-27142 REV C REFERENCE DRAWING TOP

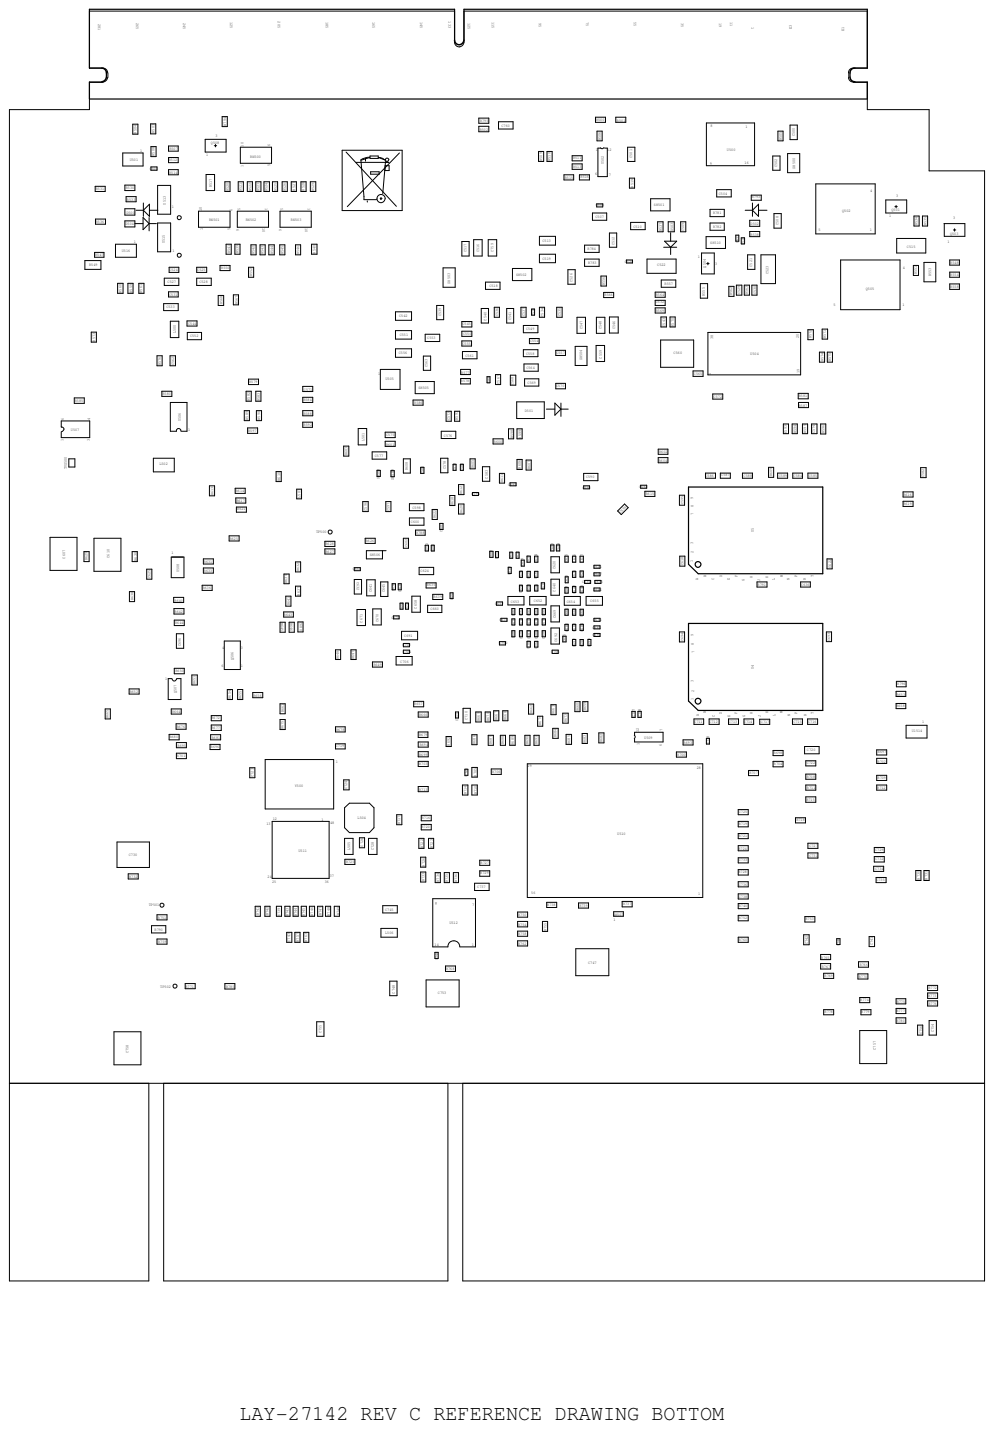
[picture p75: page 2]

LAY-27142 REV C REFERENCE DRAWING BOTTOM
