Anastien/AWG1000/hardware/01-ECAD/02-Documentation/TSW3080EVM-BRD_E2/FAB_DATA/TSW3080EVM-FAB_E2.pdf

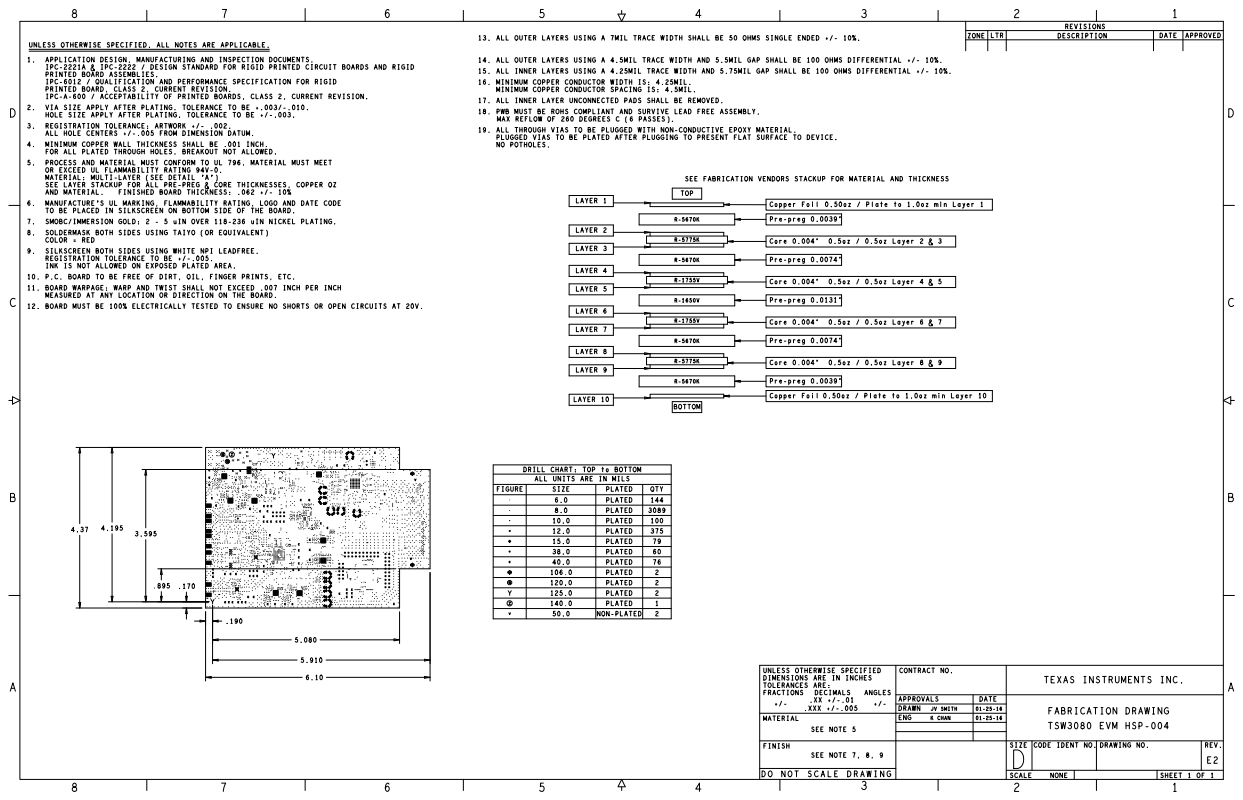
[picture p76: page 1]
