Anastien/AWG1000/hardware/01-ECAD/02-Documentation/Simulation/200MLPF/200MLPF.asc

C1: cap; 9.1p
C2: cap; 27p
L1: ind; 56n
R1: res; 49.9
R2: res; 150
V1: voltage; 0; AC 5
Named nets: 0, VOUT
.ac oct 200 10 500MEG
200 MHz 3rd Order Butterworth LPF
