Anastien/AWG1000/(list of files, drawings)

Other design files:
hardware/01-ECAD/02-Documentation/iMX6SLEVK_DESIGNFILES/Schematics/SCH-27452_B.DSN
hardware/01-ECAD/02-Documentation/iMX6SLEVK_DESIGNFILES/Schematics/SCH-27452_B.opj
hardware/01-ECAD/02-Documentation/Original Boards/iMX6 Rex Development Baseboard/V1I1/[01] - COVER PAGE.SchDoc
hardware/01-ECAD/02-Documentation/Original Boards/iMX6 Rex Development Baseboard/V1I1/[02] - BLOCK DIAGRAM.SchDoc
hardware/01-ECAD/02-Documentation/Original Boards/iMX6 Rex Development Baseboard/V1I1/[03] - CONNECTORS.SchDoc
hardware/01-ECAD/02-Documentation/Original Boards/iMX6 Rex Development Baseboard/V1I1/[04] - PCIE MINI 1, PCIE.SchDoc
hardware/01-ECAD/02-Documentation/Original Boards/iMX6 Rex Development Baseboard/V1I1/[05] - PCIE MINI 2, AUDIO2.SchDoc
hardware/01-ECAD/02-Documentation/Original Boards/iMX6 Rex Development Baseboard/V1I1/[06] - SATA, CFAST.SchDoc
hardware/01-ECAD/02-Documentation/Original Boards/iMX6 Rex Development Baseboard/V1I1/[07] - HDMI.SchDoc
hardware/01-ECAD/02-Documentation/Original Boards/iMX6 Rex Development Baseboard/V1I1/[08] - LVDS.SchDoc
hardware/01-ECAD/02-Documentation/Original Boards/iMX6 Rex Development Baseboard/V1I1/[09] - USB.SchDoc
hardware/01-ECAD/02-Documentation/Original Boards/iMX6 Rex Development Baseboard/V1I1/[10] - ETHERNET.SchDoc
hardware/01-ECAD/02-Documentation/Original Boards/iMX6 Rex Development Baseboard/V1I1/[11] - AUDIO1.SchDoc
hardware/01-ECAD/02-Documentation/Original Boards/iMX6 Rex Development Baseboard/V1I1/[12] - SD.SchDoc
hardware/01-ECAD/02-Documentation/Original Boards/iMX6 Rex Development Baseboard/V1I1/[13] - UARTS.SchDoc
hardware/01-ECAD/02-Documentation/Original Boards/iMX6 Rex Development Baseboard/V1I1/[14] - RTC, EEPROM, GPIO, TOUCH SCREEN.SchDoc
hardware/01-ECAD/02-Documentation/Original Boards/iMX6 Rex Development Baseboard/V1I1/[15] - MISC, JTAG, HEADERS.SchDoc
hardware/01-ECAD/02-Documentation/Original Boards/iMX6 Rex Development Baseboard/V1I1/[16] - POWERS 5V, 3V3.SchDoc
hardware/01-ECAD/02-Documentation/Original Boards/iMX6 Rex Development Baseboard/V1I1/[17] - PWR IN, LEDS, BUTTONS, MECH.SchDoc
hardware/01-ECAD/02-Documentation/Original Boards/iMX6 Rex Development Baseboard/V1I1/[18] - DOC, POWER SEQUENCING.SchDoc
hardware/01-ECAD/02-Documentation/Original Boards/iMX6 Rex Development Baseboard/V1I1/[19] - REVISION HISTORY.SchDoc
hardware/01-ECAD/02-Documentation/Original Boards/iMX6 Rex Development Baseboard/V1I1/iMX6 Rex Development Baseboard V1I1.PrjPcb
hardware/01-ECAD/02-Documentation/Original Boards/iMX6 Rex Module/V1I1/[01] - COVER PAGE.SchDoc
hardware/01-ECAD/02-Documentation/Original Boards/iMX6 Rex Module/V1I1/[02] - BLOCK DIAGRAM.SchDoc
hardware/01-ECAD/02-Documentation/Original Boards/iMX6 Rex Module/V1I1/[03] - CONNECTORS.SchDoc
hardware/01-ECAD/02-Documentation/Original Boards/iMX6 Rex Module/V1I1/[04] - CPU - DDR3, DDR3 MEM.SchDoc
hardware/01-ECAD/02-Documentation/Original Boards/iMX6 Rex Module/V1I1/[05] - CPU - PCIE, SATA.SchDoc
hardware/01-ECAD/02-Documentation/Original Boards/iMX6 Rex Module/V1I1/[06] - CPU - HDMI, LVDS.SchDoc
hardware/01-ECAD/02-Documentation/Original Boards/iMX6 Rex Module/V1I1/[07] - CPU - USB, ETHERNET.SchDoc
hardware/01-ECAD/02-Documentation/Original Boards/iMX6 Rex Module/V1I1/[08] - CPU - SPI, I2C, SD, MMC.SchDoc
hardware/01-ECAD/02-Documentation/Original Boards/iMX6 Rex Module/V1I1/[09] - CPU - UART, AUDIO.SchDoc
hardware/01-ECAD/02-Documentation/Original Boards/iMX6 Rex Module/V1I1/[10] - CPU - JTAG, CONTROL.SchDoc
hardware/01-ECAD/02-Documentation/Original Boards/iMX6 Rex Module/V1I1/[11] - CPU - POWER.SchDoc
hardware/01-ECAD/02-Documentation/Original Boards/iMX6 Rex Module/V1I1/[12] - CPU - UNUSED.SchDoc
hardware/01-ECAD/02-Documentation/Original Boards/iMX6 Rex Module/V1I1/[13] - ETHERNET PHY.SchDoc
hardware/01-ECAD/02-Documentation/Original Boards/iMX6 Rex Module/V1I1/[14] - SPI FLASH, LEDS.SchDoc
hardware/01-ECAD/02-Documentation/Original Boards/iMX6 Rex Module/V1I1/[15] - PWR 3V3, 1V375.SchDoc
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
