Anastien/AWG1000/(commit log)

2021-04-30 WIP : Update.
    [750-28637_B.xls, AWG1000.kicad_pcb, AWG1000.kicad_sch, DAC.kicad_sch, INTERFACE.kicad_sch, MEMORY.kicad_sch, MPU.kicad_sch, PM.kicad_sch]
2021-04-30 WIP: update
    [31-6233.stp, AWG1000.kicad_pcb, AWG1000.kicad_sch, EEE-FK1H221GP.stp, INTERFACE.kicad_sch, MPU.kicad_sch, PM.kicad_sch]
