Anastien/AWG1000/(notices)

Notices in the files:
hardware/02-MCAD/01-3d library/USB1040-15-L-B.stp:
FILE_NAME( 'p:/temp/worker_96/temp/exporttempdir_4300_991_u05kZ/format_0/USB1040-15-L-B.stp', '2021-05-01T19:32:06', ( 'License CC BY-ND 4.0' ), ( 'CADENAS' ), ' ', 'PARTsolutions', ' ' );
